caltechcaos/Lunar-Dust-Challenge/Current/README.txt

Electrical - Ask Kemal lmfao

Export_Files - Drawings, STEP files, animations, etc.

Mechanical - v1 (parts, assemblies, etc.), v2, etc.

Simulations - Simulation data

Feel free to add other folders, but please update README.txt!
