caltechcaos/Lunar-Dust-Challenge/Current/Mechanical/README.txt

All parts and assemblies should be put into "Parts" and "Other_Assemblies" respectively EXCEPT the final assembly and constants.

Current panel assembly: GME

Current endcaps: N/A

-Hey nathan love the organization
