caltechcaos/Lunar-Dust-Challenge/E100/Week 2 Progress Report/E100 Progress Report (Luis and Nathan).pptx

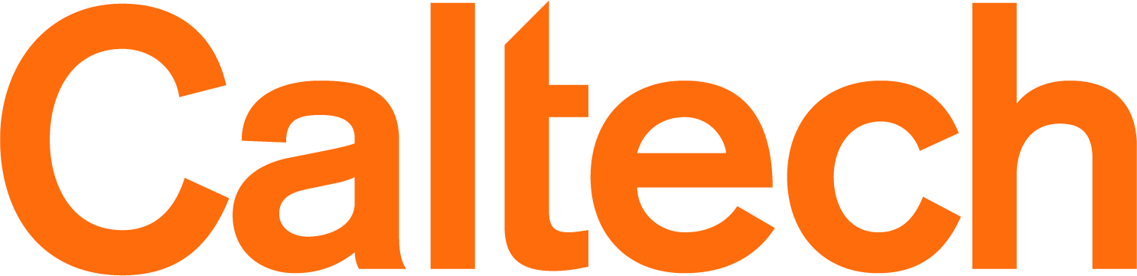
[picture p4: figure]
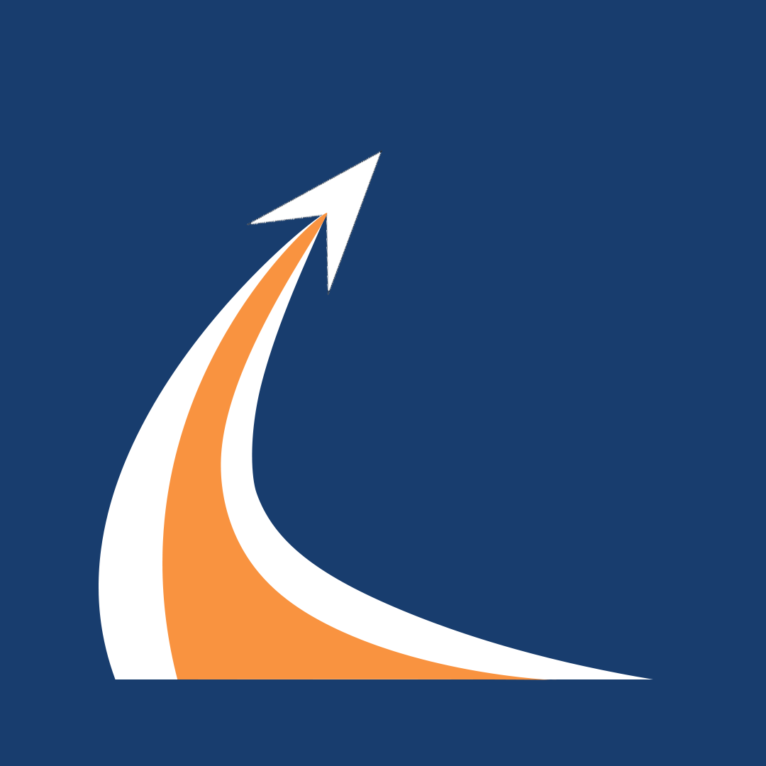
[picture p5: figure]
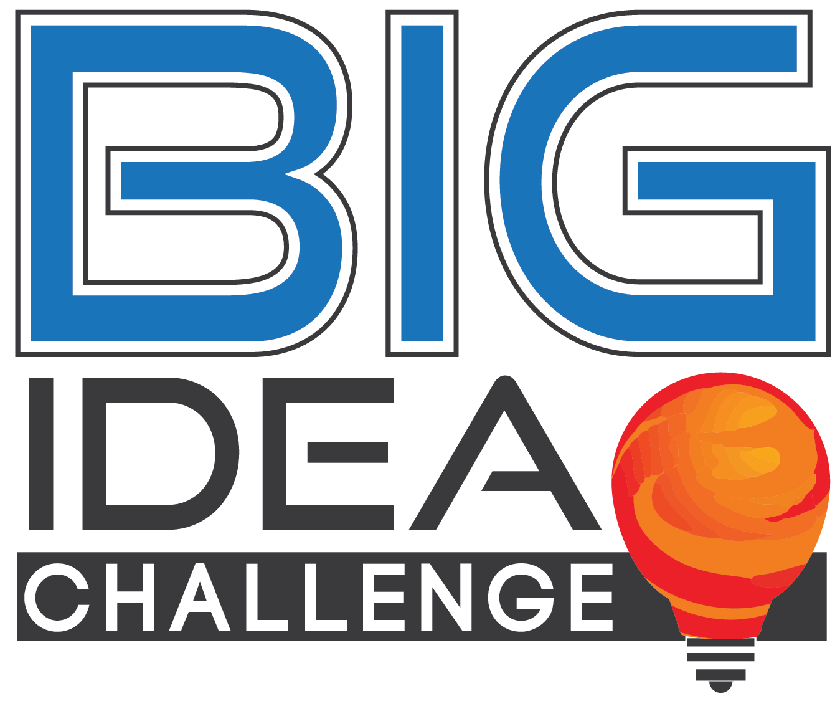
[picture p6: figure]
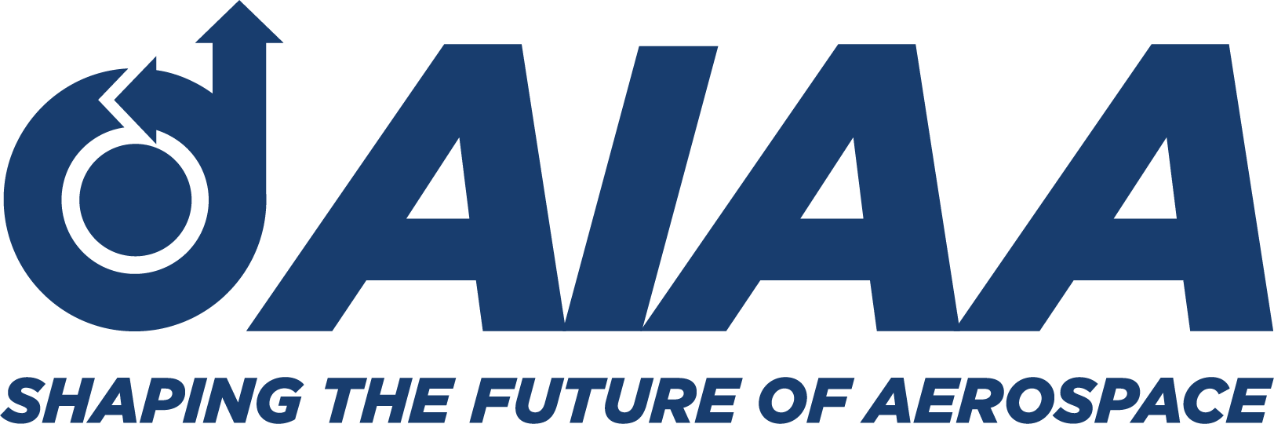
[picture p7: figure]

Validation
Schedule (Structural)

4/9/21
Nathan, Luis

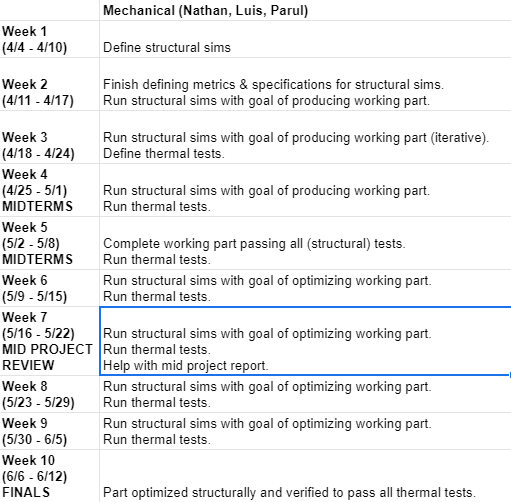
[picture p8: figure]

Budget = $0
Need – confirmation of which materials (and thicknesses) will be possible to manufacture (Mechanical Team)
Need – maximum thicknesses for the top plate, possibility of adding metal plate under bottom panel (Electrical Team)

## Slide 2

Validation
Structural Tests/Sims

4/9/21
Luis, Nathan

Planned structural tests
- Whole Panel Tests
  - Three-point bend
  - Cantilever
- Multiple Panel Tests
  - Dual Panel Three-point bend
  - Dual Panel Cantilever
- Finger Joint Tests (sanity check)
Link (https://docs.google.com/spreadsheets/d/1EzRzmbQOUqOviGvNJL2uNWe0L3cBfECJI9uSIhsKcGc/edit)
Loads (shown in red) are 486 N total
Fixed points shown in green

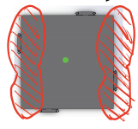
[picture p9: figure]
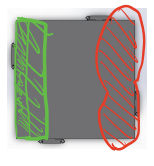
[picture p10: figure]
