caltechcaos/Lunar-Dust-Challenge/E100/Week 2 Progress Report/E100 Progress Report_Leah.pptx

MECHANICAL
Bottom Plate Manufacturing and Drawings

4/9/21
Leah Soldner

Technical Progress:
  - Reached out and got quotes for the bottom plate design
  - Scheduled meetings with several Macor manufacturers
  - Main issue with design is the 1mm thickness of the bottom lip on the plate
    - Have to increase the thickness to at least 3mm
    - The weight of the panel will increase by ~350 grams
    - Will not affect the price of manufacturing
  - Top sheet issue:
    - 1mm too thin, will warp or crack during shipping
    - Tape casting as possible solution
      - Mateus makes 4.5x4.5 in plates of desired thickness
  - Action Items:
    - Set up meeting with Ceramic Products
    - Communicate with Mateus to see if we can increase the tape casting size
    - Update drawings with correct bottom plate thickness
    - Choose manufacturer and start ordering!!!

## Slide 2

MECHANICAL
Bottom Plate Manufacturing and Drawings

4/9/21
Leah Soldner

Budget/Timeline:
  - Precision Ceramics: Mateus Truon, meeting Thursday (4/8)
    - 1 plate: $1756.20
    - 8 plates: $ 1080.50
    - Delivery time: 5-7 weeks
  - Morgan Advanced Materials: Nikhil Jani, meeting Wednesday (4/7)
    - 1 plate: $2220.22
    - 8 plates: $1843.03
    - Delivery time: 8 weeks
  - Ceramic Products: Mark Vidaic, meeting next week TBD
    - 1 plate: $1450
    - 8 plates: $1100
    - Delivery Time: 4-5 weeks
  - If we go with cheapest, estimated budget/timeline: $9,500/5 weeks
  - If we go with most expensive, estimated budget/timeline: $15,000/8 weeks
