caltechcaos/Lunar-Dust-Challenge/E100/Week 3 Progress Report/Calle Week 3 E100 Slides.pptx

Verification
Glove Box

Calle
4/16/21

Progress
- Finalized design and parts list
  - Primarily making use of extrusion and panel gaskets
- CAD model of design
- Ordered parts

Next Steps:
- Get in contact with person to order nitrogen
- Begin assembly once parts arrive

Big Idea | NASA's Breakthrough, Innovative, and Game-changing (BIG) Idea Challenge
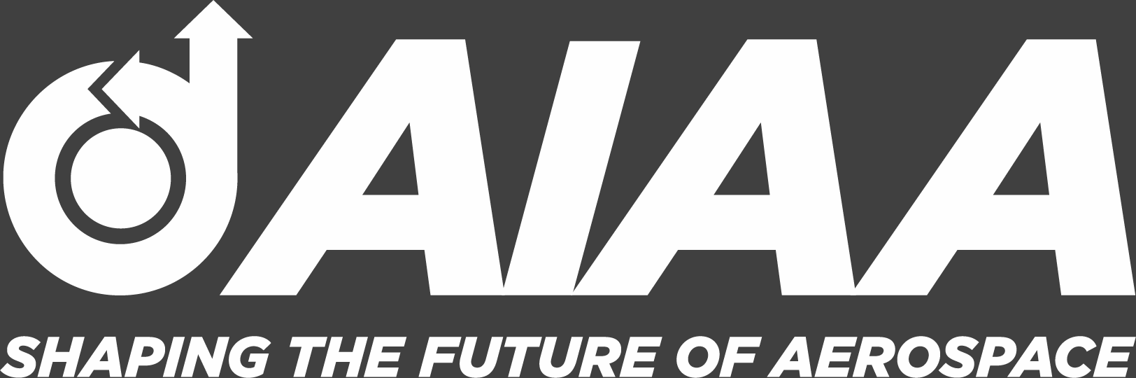
[picture p23: figure]
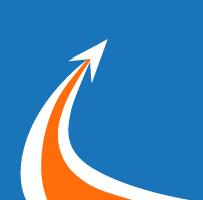
[picture p24: figure]
