caltechcaos/Lunar-Dust-Challenge/E100/Week 3 Progress Report/chelakkat_4-16-21.pptx

MECHANICAL
Electronic Box Cable Design

Kristine Chelakkat
04/16/21

- Meeting with Rich:
  - Parasitic capacitance from cable, ~10 pF/ft
  - Kapton great for high voltage
  - Cable needs to be shielded
  - Reccommends Accuglass
    - R6 Cabling with SHV connector
- Meeting with Keith Novak:
  - Flex cabling
    - Can look back at Cicoil and Gore options
- To Do: Meeting up with Electrical Team to discuss further steps
  - Should get started on testing as soon as possible

Big Idea | NASA's Breakthrough, Innovative, and Game-changing (BIG) Idea Challenge
