caltechcaos/Lunar-Dust-Challenge/E100/Week 3 Progress Report/Kemal E100 Week 3.pptx

Technical Updates
- Relays for the first prototype, due to difficulty in designing solid-state switching circuit
- Ordered components


Electrical
Power Supply and Switching

04/09/21
Kemal Pulungan

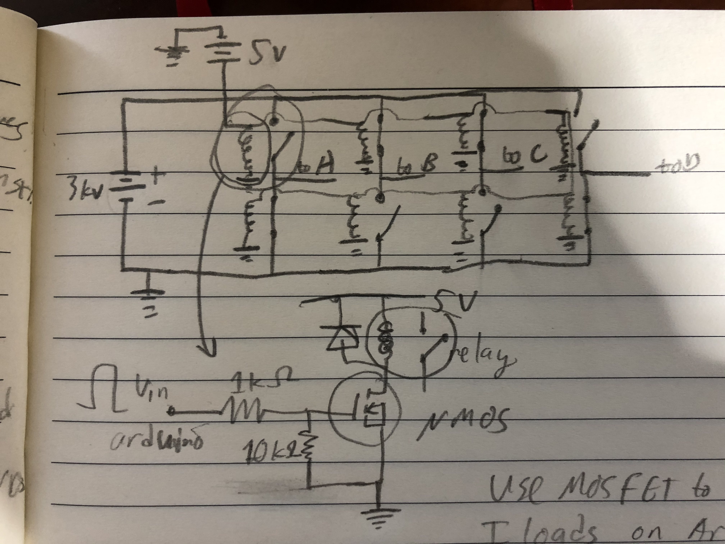
[picture p25: figure]

## Slide 2

Next Steps
- 4-16 to 4-23: Design PCB and protections against the risks of high voltage
- 4-23 to 4-30: Overseeing construction of the first board (will not be in-person)
- Afterwards up to mid-May: Testing of electronics

Electrical
Power Supply and Switching

04/09/21
Kemal Pulungan
