caltechcaos/Lunar-Dust-Challenge/E100/Week 3 Progress Report/Luis_Nathan_Simulation.pptx

Validation
Structural Simulation

Ran Full Assembly Compression Simulation
Fixed bottom (flat surface)
486 N Centered Circular Load
Dimensions: 15 x 15 cm
Top Plate: Zirconia
Bottom Plate: Macor
Elements ~ 13655
Nodes ~ 26673
Missing Constants on Data Sheets

Luis, Nathan
4/16/21

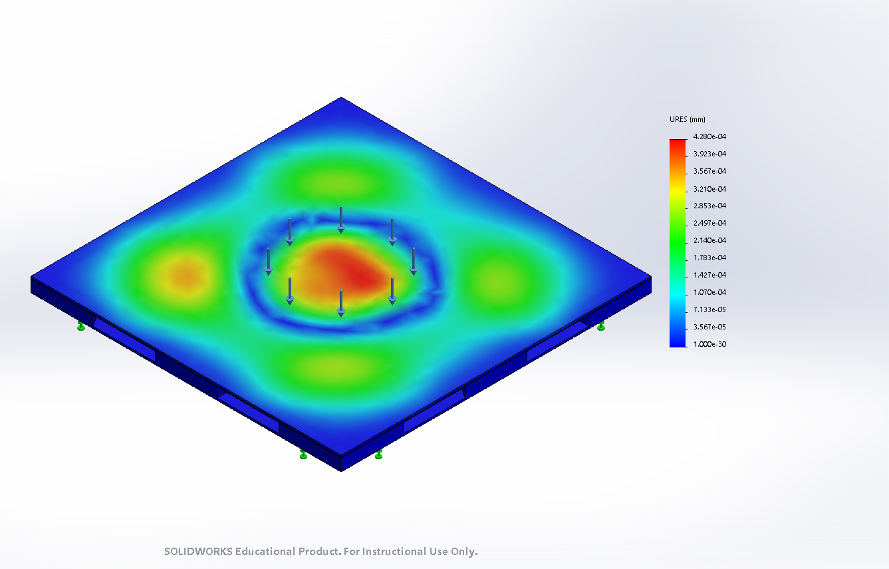
[picture p26: figure]

Displacement
Max – 4e-4 mm

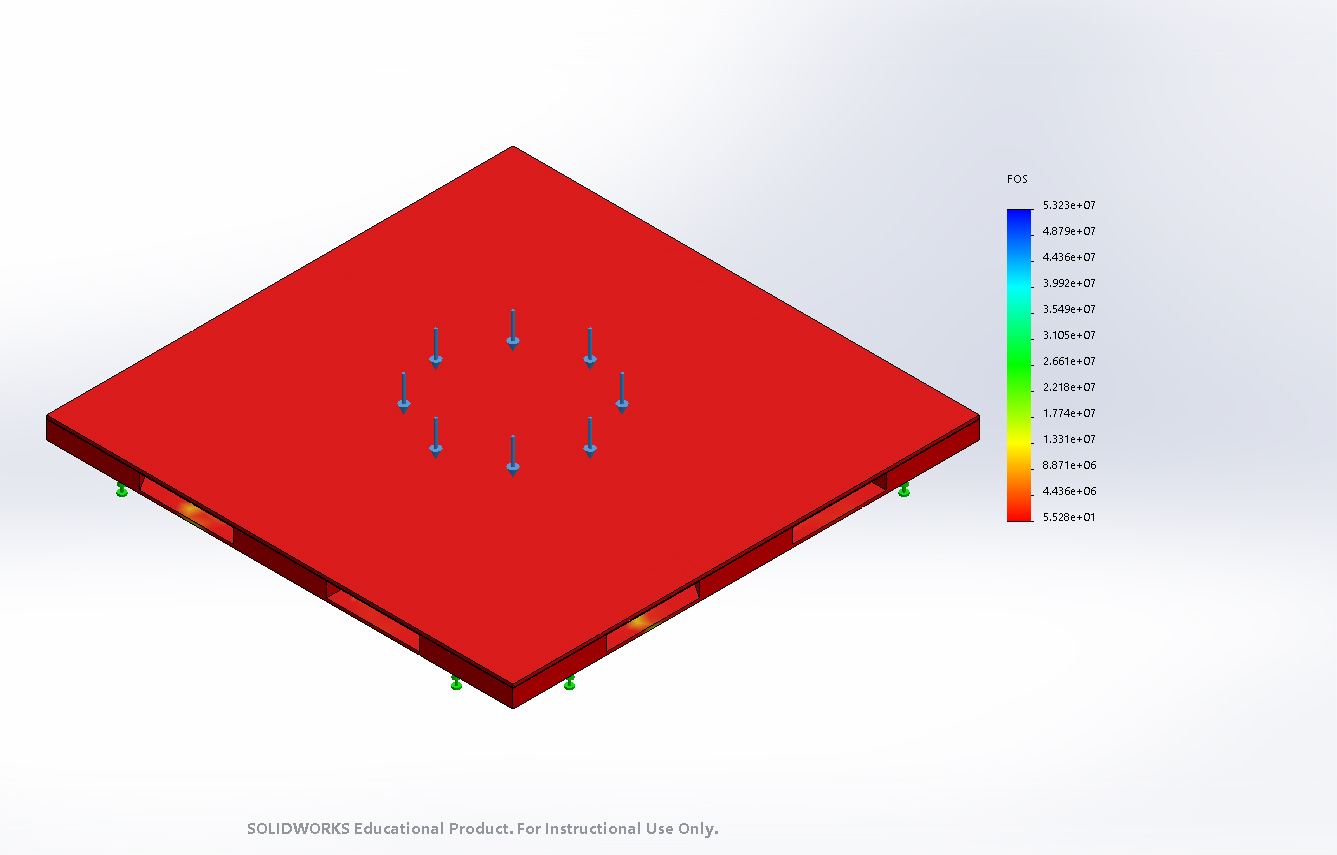
[picture p27: figure]

Factor of Safety
Min - 55

Big Idea | NASA's Breakthrough, Innovative, and Game-changing (BIG) Idea Challenge

## Slide 2

Validation
Structural Simulation

Ran Full Assembly “3-point bend” Simulation
Fixed 10% of panel on opposite sides (flat surface)
486 N Centered Circular Load
Dimensions: 15 x 15 cm
Top Plate: Zirconia
Bottom Plate: Macor
Elements ~ 43100
Nodes ~ 83089
Missing Constants on Data Sheets

Luis, Nathan
4/16/21

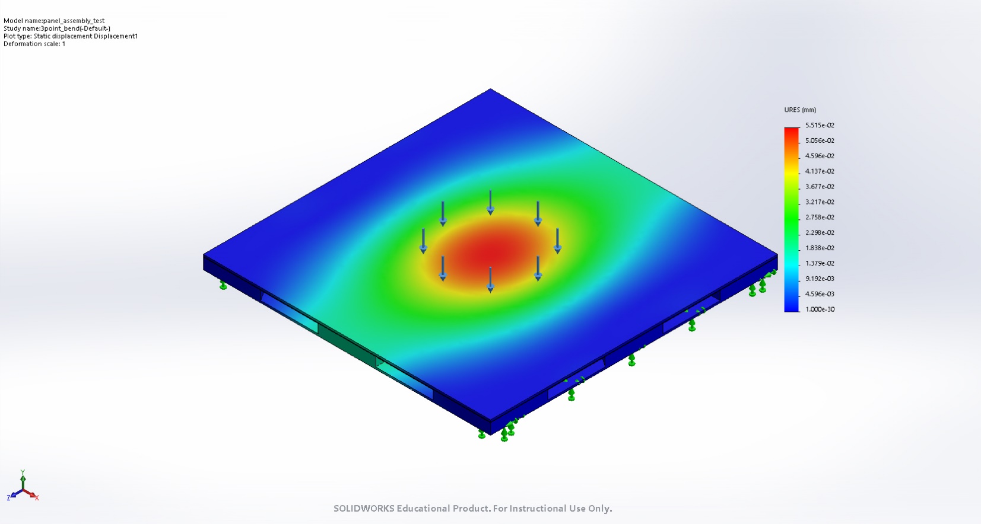
[picture p28: figure]

Displacement
Max – 5.52e-2 mm

Factor of Safety
Min – 2.79
