caltechcaos/Lunar-Dust-Challenge/E100/Week 3 Progress Report/Rithvik E 100 Week 3 Progress.pptx

VERIFICATION
EFFECTIVENESS TESTING

Rithvik
04/16/21

This Week
- Decided not to use an extrusion frame to mount camera and lights
- Finalized which camera and lighting to use
- Emailed an extrusion manufacturer about discounts for student teams

Next Week
- Will start writing code to analyze data and test it with basic videos of monochrome gradients

Big Idea | NASA's Breakthrough, Innovative, and Game-changing (BIG) Idea Challenge
