caltechcaos/Lunar-Dust-Challenge/E100/Week 3 Progress Report/Tanmay wk3.pptx

[Design/Manufacturing]
[Panel Segmentation Designs]

[Tanmay Gupta]
04/16/21

Alternative to Smaller Panels: Segmentation
- Best of both worlds from Leah’s slides
- make use of available materials while increasing integrity and minimizing changes
- Solution: split current panels into segments with their own PCB and top plate
- shared bottom plate and power supply architecture (extra depth helps)
- Panels remain rotationally symmetric and of similar size
- inter-segment gap smaller than inter-panel gap
Potential Designs
Total side dimensions can be approx. 25 x 25 cm to 30 x 30 cm

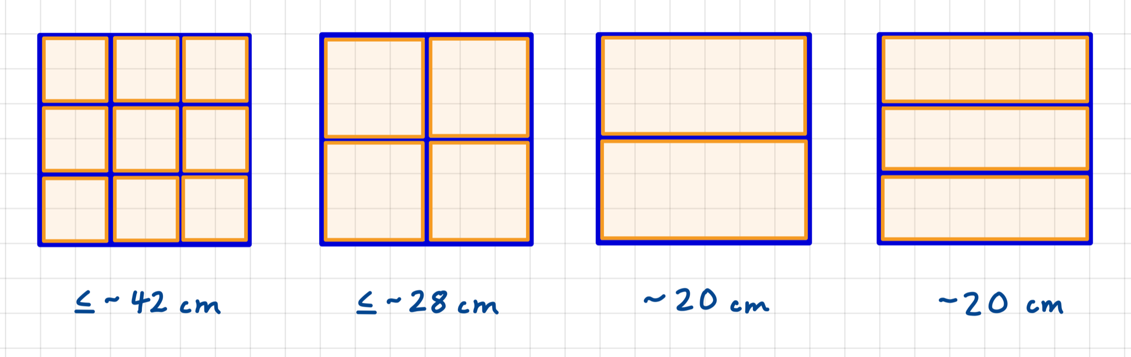
[picture p38: figure]

Big Idea | NASA's Breakthrough, Innovative, and Game-changing (BIG) Idea Challenge
