caltechcaos/Lunar-Dust-Challenge/PDR/PDR Presentation/PDR-ME-OVERVIEW-UPDATE.pptx

## Slide 2


PANEL COMPOSITION
MECHANICAL

AIAA Caltech Student Branch – 18/11/20
Preliminary Design Review – E.A.S.E

Alumina Ceramic Sheet

0.3175 cm

Kapton film

Electrodes

0.005 cm

0.65 cm

Alumina Ceramic Sheet

Kapton film

0.005 cm

0.3175 cm

0.77 cm

iPhone X

0.65 cm

EDS Panel

Mass estimate: 1.4 kg

## Slide 3

MATERIAL SELECTION
MECHANICAL

AIAA Caltech Student Branch – 18/11/20
Preliminary Design Review – E.A.S.E

Alumina | Kapton
Electrical insulator | Stability across wide temperature range
Low dielectric constant | Durability
Low thermal conductivity | Good dielectric qualities
Hardness | Used in spacecraft applications (Apollo launcher, Curiosity rover)
Strength
Sufficient temperature range
Abrasion resistant
Used in many spacecraft applications

## Slide 4

Top Plate:
- 3-axis CNC milling
Bottom Plate:
- 3-axis CNC milling
Electronics Box:
- Tungsten inert gas welding
- 3-axis CNC milling
- Design considerations: 0.5 mm tolerance, large external and internal fillets

MANUFACTURING
MECHANICAL

AIAA Caltech Student Branch – 18/11/20
Preliminary Design Review – H.O.M.E.S.

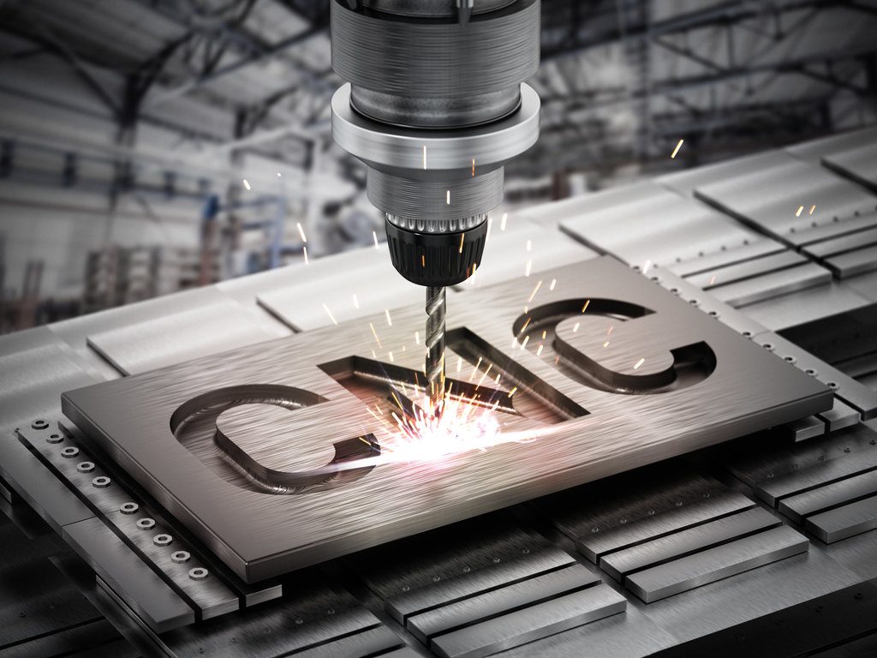
[picture p46: figure]
What Is CNC Machining? And Is It Right for You?
