caltechcaos/Lunar-Dust-Challenge/Current/Mechanical/v3_tiz/FEA/FEA_finger_joint_v3.2-Static 1-1.docx

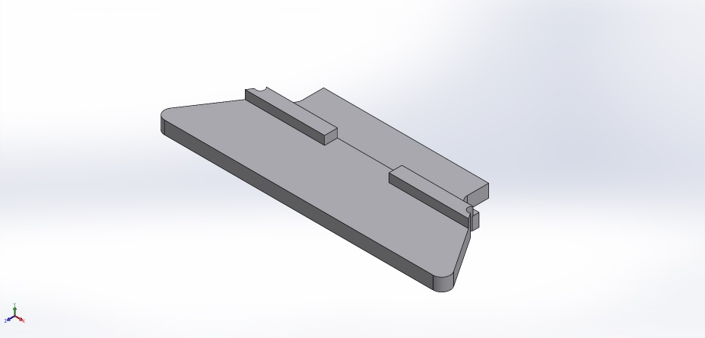
[picture p47: figure]

Simulation of FEA_finger_joint_v3.2

Date: Thursday, April 1, 2021
Designer: Solidworks

Study name: Static 1

Analysis type: Static
Description No Data

# Assumptions

# Model Information

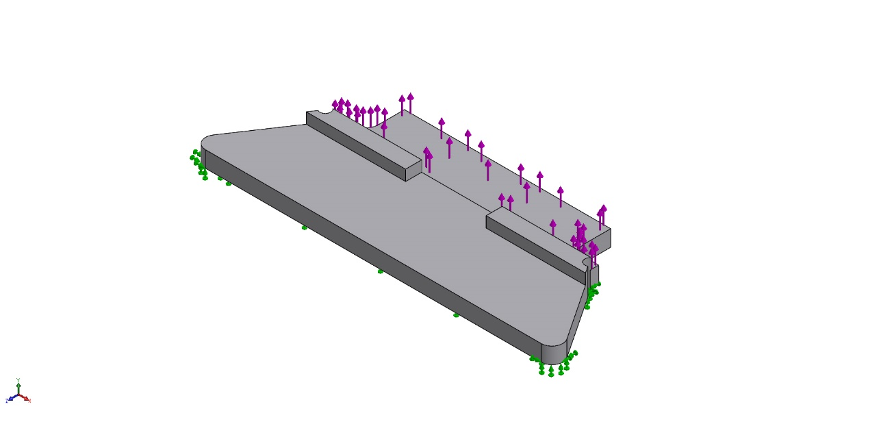
[picture p48: figure]

Model name: FEA_finger_joint_v3.2

Current Configuration: Default

Solid Bodies
Document Name and Reference | Treated As | Volumetric Properties | Document Path/Date Modified

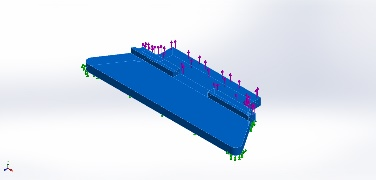
[picture p49: figure]

Split Line2 | Solid Body | Mass:0.0085645 kg Volume:4.12549e-06 m^3 Density:2,075.99 kg/m^3 Weight:0.0839321 N | C:\Users\luisa\Documents\GrabCAD\Lunar Dust Challenge\Current\Mechanical\v3_tiz\FEA\FEA_finger_joint_v3.2.SLDPRT Apr 1 22:46:40 2021

# Study Properties

Study name | Static 1
Analysis type | Static
Mesh type | Solid Mesh
Thermal Effect: | On
Thermal option | Include temperature loads
Zero strain temperature | 298 Kelvin
Include fluid pressure effects from SOLIDWORKS Flow Simulation | Off
Solver type | FFEPlus
Inplane Effect: | Off
Soft Spring: | Off
Inertial Relief: | Off
Incompatible bonding options | Automatic
Large displacement | Off
Compute free body forces | On
Friction | Off
Use Adaptive Method: | Off
Result folder | SOLIDWORKS document (C:\Users\luisa\Documents\GrabCAD\Lunar Dust Challenge\Current\Mechanical\v3_tiz\FEA)

# Units

Unit system: | SI (MKS)
Length/Displacement | mm
Temperature | Kelvin
Angular velocity | Rad/sec
Pressure/Stress | N/m^2

# Material Properties

Model Reference | Properties | Components

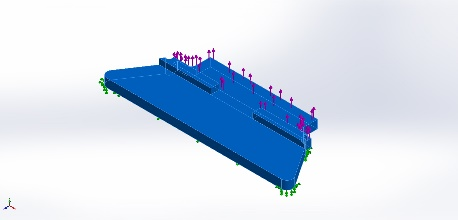
[picture p50: figure]

| Name: 99.5% Aluminum Oxide Model type: Linear Elastic Isotropic Default failure criterion: Mohr-Coulomb Stress Yield strength: 2.17185e+07 N/m^2 Tensile strength: 2.17185e+07 N/m^2 Compressive strength: 2.99922e+07 N/m^2 Elastic modulus: 3e+11 N/m^2 Poisson's ratio: 0.22 Mass density: 2,075.99 kg/m^3 Thermal expansion coefficient: 8e-06 /Kelvin | SolidBody 1(Split Line2)(FEA_finger_joint_v3.2)

Curve Data:N/A

# Loads and Fixtures

Fixture name | Fixture Image | Fixture Details

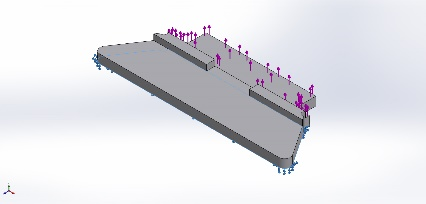
[picture p51: figure]

Fixed-1 | | Entities: 1 face(s) Type: Fixed Geometry

Resultant Forces

Components | X | Y | Z | Resultant
Reaction force(N) | -0.000433497 | -119.998 | -0.0014181 | 119.998
Reaction Moment(N.m) | 0 | 0 | 0 | 0

Load name | Load Image | Load Details

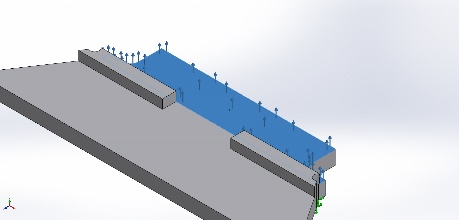
[picture p52: figure]

Force-1 | | Entities: 1 face(s) Type: Apply normal force Value: -120 N

# Connector Definitions

No Data

# Contact Information

No Data

# Mesh information

Mesh type | Solid Mesh
Mesher Used: | Standard mesh
Automatic Transition: | Off
Include Mesh Auto Loops: | Off
Jacobian points | 4 Points
Element Size | 0.802247 mm
Tolerance | 0.0401124 mm
Mesh Quality Plot | High

## Mesh information - Details

Total Nodes | 83132
Total Elements | 54412
Maximum Aspect Ratio | 13.498
% of elements with Aspect Ratio < 3 | 99.8
% of elements with Aspect Ratio > 10 | 0.00919
% of distorted elements(Jacobian) | 0
Time to complete mesh(hh;mm;ss): | 00:00:03
Computer name:

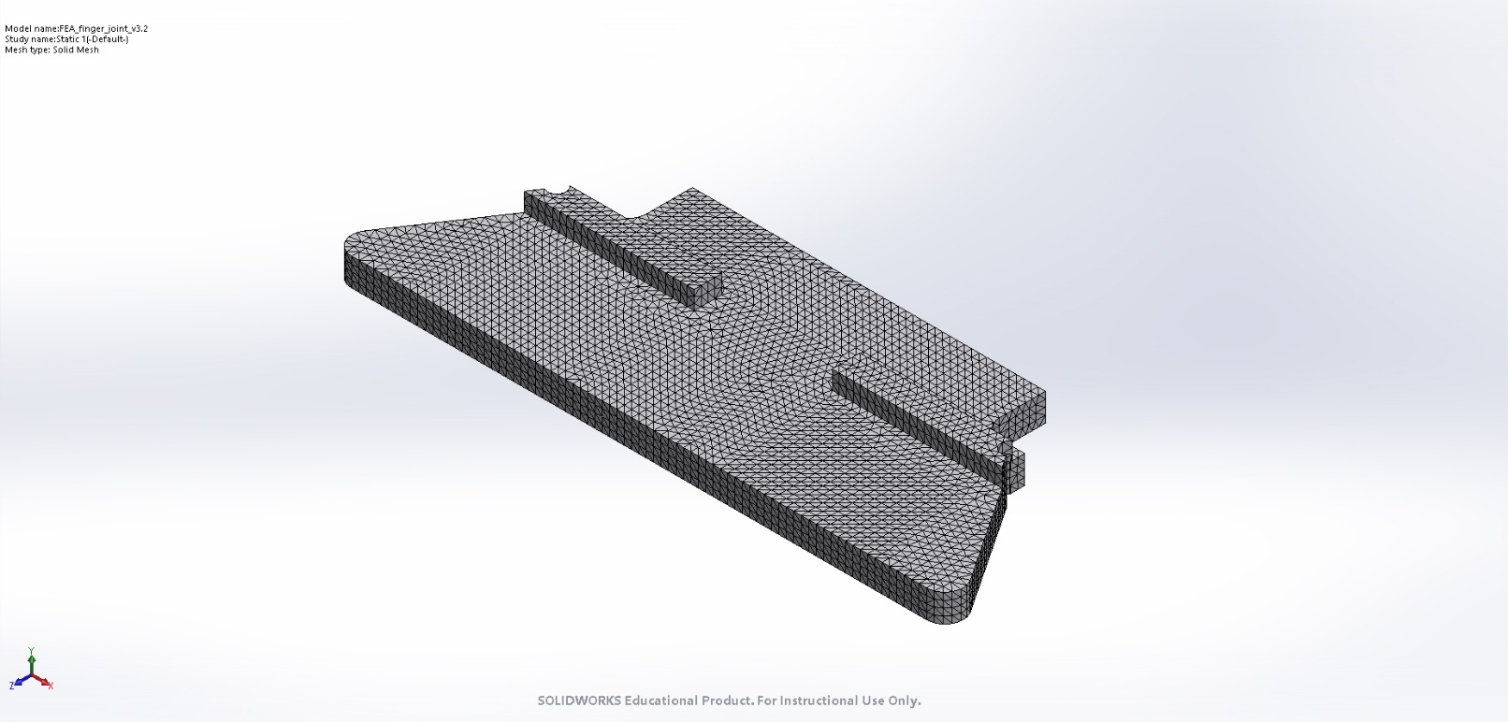
[picture p53: figure]

# Sensor Details

No Data

# Resultant Forces

## Reaction forces

Selection set | Units | Sum X | Sum Y | Sum Z | Resultant
Entire Model | N | -0.000433497 | -119.998 | -0.0014181 | 119.998

## Reaction Moments

Selection set | Units | Sum X | Sum Y | Sum Z | Resultant
Entire Model | N.m | 0 | 0 | 0 | 0

# Beams

No Data

# Study Results

Name | Type | Min | Max
Stress1 | VON: von Mises Stress | 8.040e+01 N/m^2 Node: 70215 | 1.301e+07 N/m^2 Node: 81540

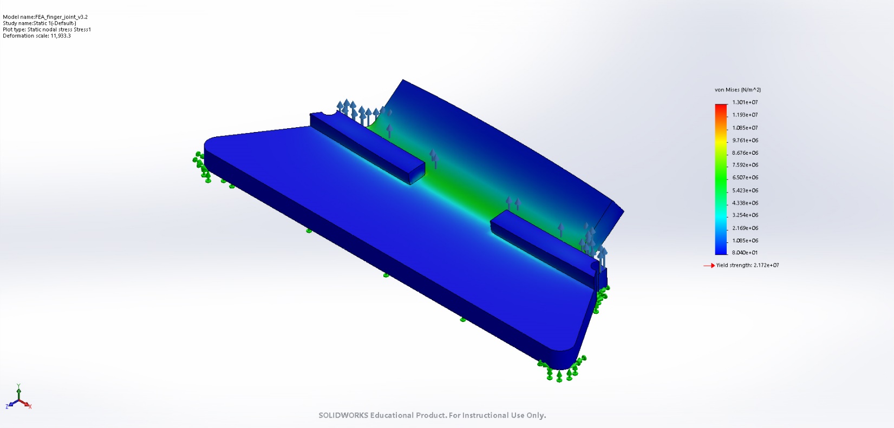
[picture p54: figure]

FEA_finger_joint_v3.2-Static 1-Stress-Stress1

Name | Type | Min | Max
Displacement1 | URES: Resultant Displacement | 0.000e+00 mm Node: 1 | 5.728e-04 mm Node: 3165

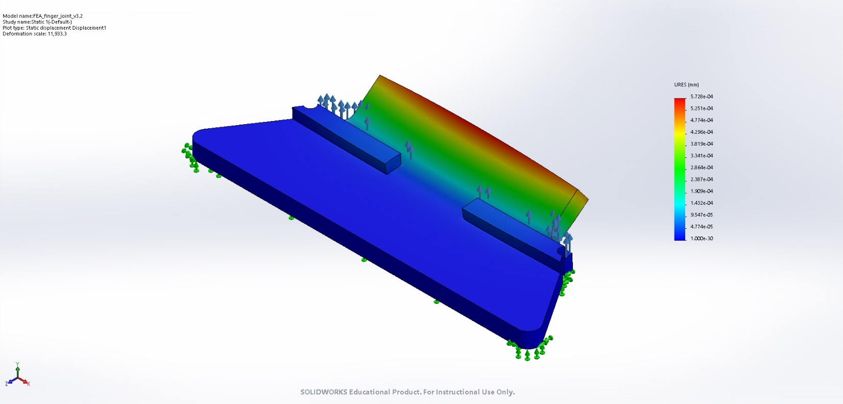
[picture p55: figure]

FEA_finger_joint_v3.2-Static 1-Displacement-Displacement1

Name | Type | Min | Max
Strain1 | ESTRN: Equivalent Strain | 8.533e-11 Element: 7062 | 3.040e-05 Element: 32892

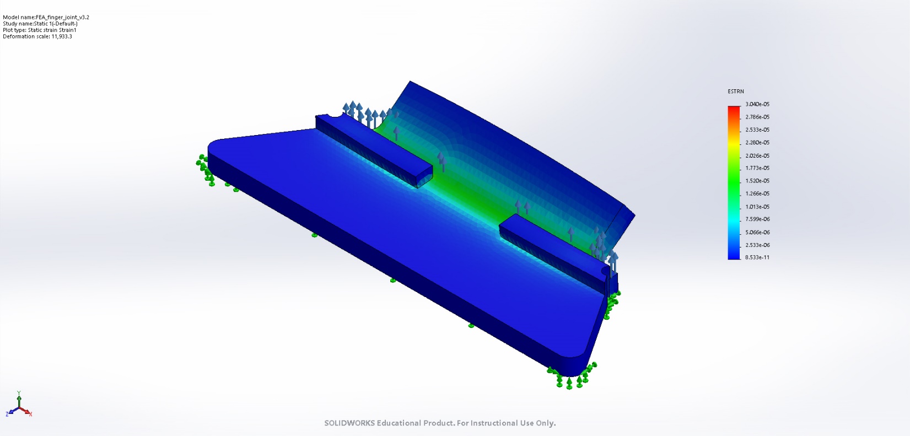
[picture p56: figure]

FEA_finger_joint_v3.2-Static 1-Strain-Strain1

Name | Type
Displacement1{1} | Deformed shape

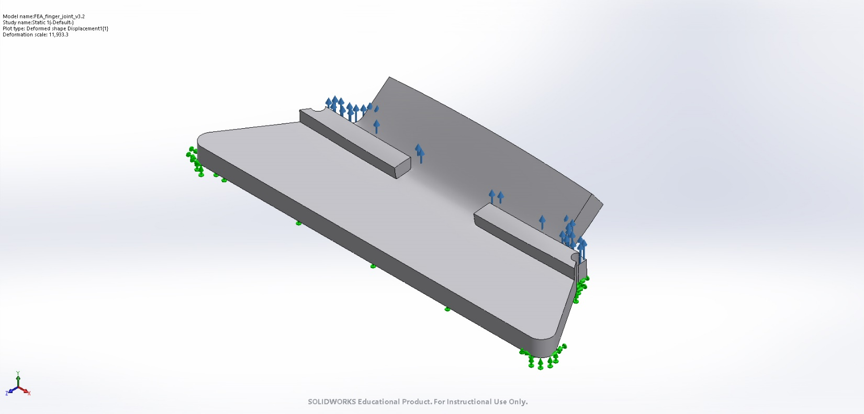
[picture p57: figure]

FEA_finger_joint_v3.2-Static 1-Displacement-Displacement1{1}

Name | Type | Min | Max
Factor of Safety1 | Mohr-Coulomb Stress | 1.259e+00 Node: 81540 | 2.330e+05 Node: 70206

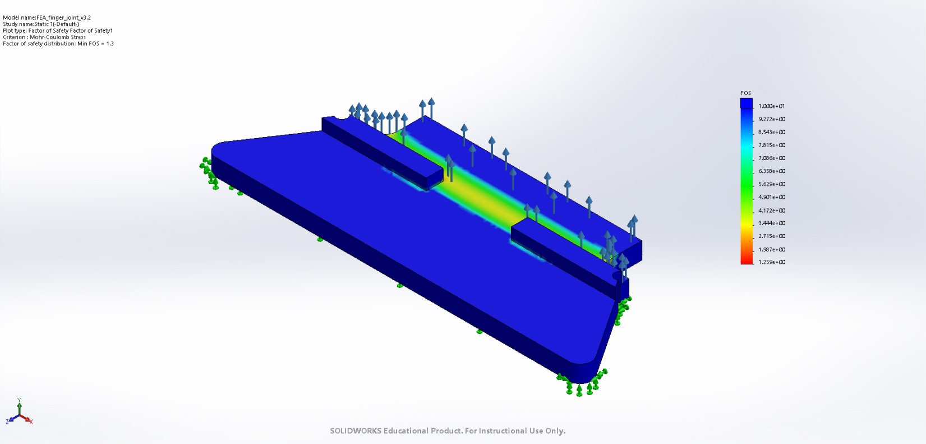
[picture p58: figure]

FEA_finger_joint_v3.2-Static 1-Factor of Safety-Factor of Safety1

Name | Type
Design Insight1 | Design Insight

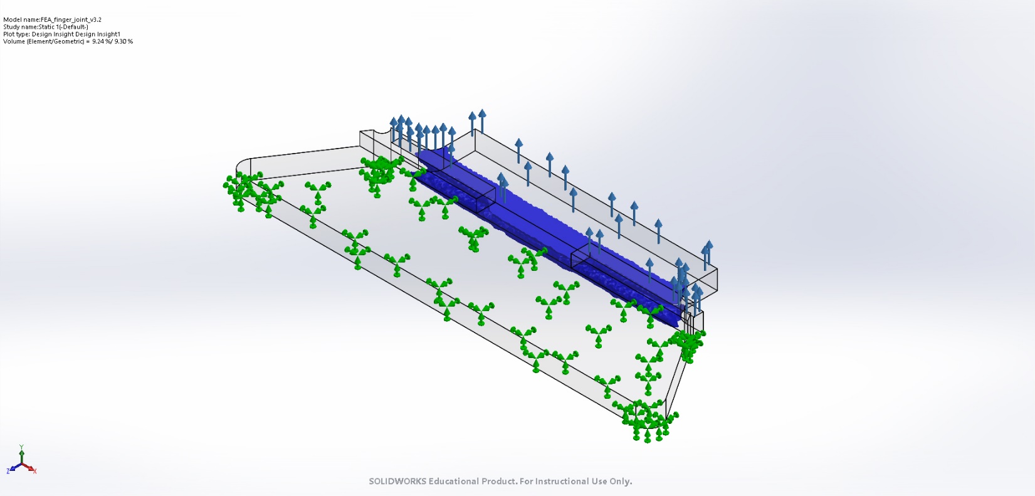
[picture p59: figure]

FEA_finger_joint_v3.2-Static 1-Design Insight-Design Insight1

# Conclusion

Analyzed with SOLIDWORKS Simulation Simulation of FEA_finger_joint_v3.2 7

Analyzed with SOLIDWORKS Simulation Simulation of FEA_finger_joint_v3.2 1
