caltechcaos/Lunar-Dust-Challenge/PDR/PDR Presentation/controlsmodesnew.pptx

MECHATRONICS
CONTROLS & MODES

AIAA Caltech Student Branch – 11/18/20
Preliminary Design Review – E.A.S.E.

Standby Mode

Strain Gauge

Feasible by prior implementations

Strain Gauge

Large decrease in pressure

Timer
(120 secs)

Maintenance Mode

Astronaut Mode

Operational Modes
Standby Mode: awaiting use, sensors are active
Astronaut Mode: capacitors are charged, suit is cleaned
Maintenance Mode: dust is removed from mat itself

If large increase in pressure
