caltechcaos/Lunar-Dust-Challenge/PDR/PDR Presentation/controlsopmodes.pptx

MECHATRONICS
Controls and Operational Modes

AIAA Caltech Student Branch – 18/11/20
Preliminary Design Review – H.O.M.E.S.

Dormant Mode

Piezoelectric Sensor

Piezoelectric Sensor

If large + ΔP

Timer
(120 secs)

Cleaning Mode

Large -ΔP

Operational Modes
Dormant Mode: awaiting use, sensors are active
Cleaning Mode: capacitors are charged, suit is cleaned, dust removed from mat
