caltechcaos/Lunar-Dust-Challenge/PDR/PDR Presentation/EASE PDR FINAL V3.pdf

# EASE

# Electrodynamic Dust Shielding Activated Surface Emitter

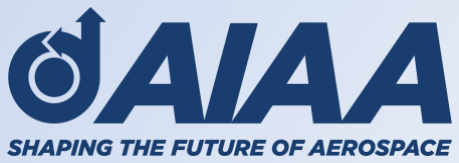
[picture p69: figure]

AIAA Caltech Student Branch – 11/18/20 Advisor: Dr. Soon-Jo Chung

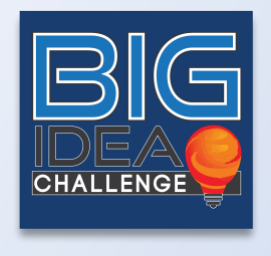
[picture p70: figure]

# Preliminary Design Review

# INTRODUCTION

# ROADMAP

EASE Preliminary Design Review

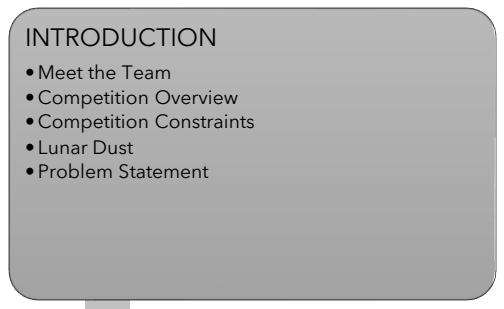
[picture p71: figure]
INTRODUCTION; • Meet the Team • Competition Overview • Competition Constraints • Lunar Dust • Problem Statement
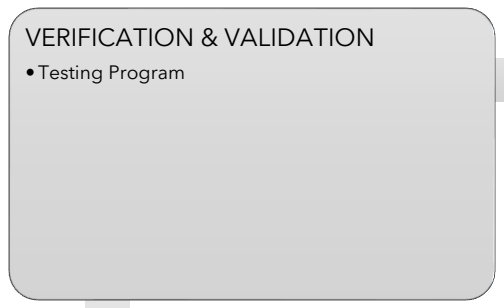
[picture p72: figure]
VERIFICATION & VALIDATION; • Testing Program
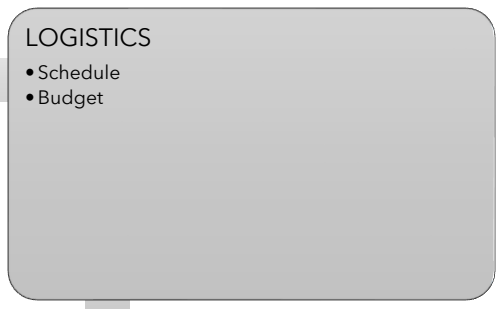
[picture p73: figure]
LOGISTICS; • Schedule •Budget
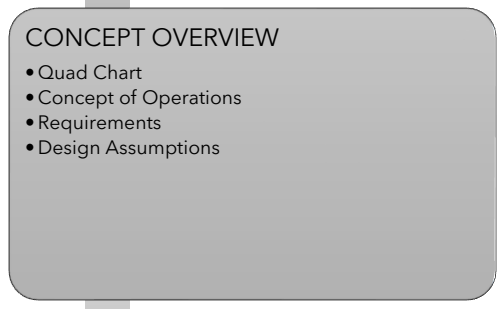
[picture p74: figure]
CONCEPT OVERVIEW; • Quad Chart • Concept of Operations • Requirements • Design Assumptions
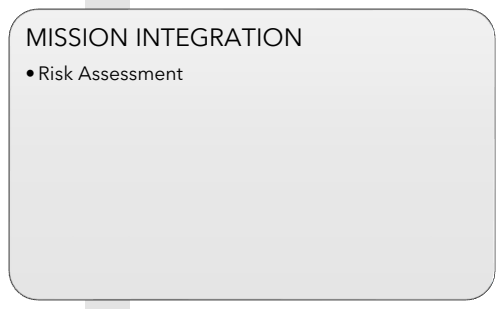
[picture p75: figure]
MISSION INTEGRATION; • Risk Assessment
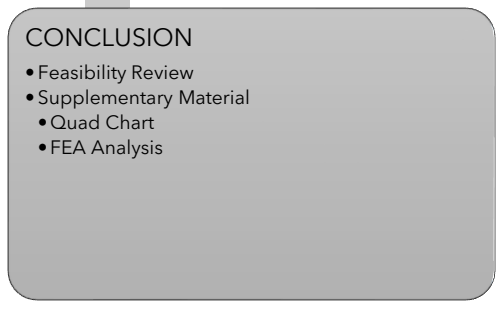
[picture p76: figure]
CONCLUSION; • Feasibility Review • Supplementary Material •Quad Chart •FEA Analysis
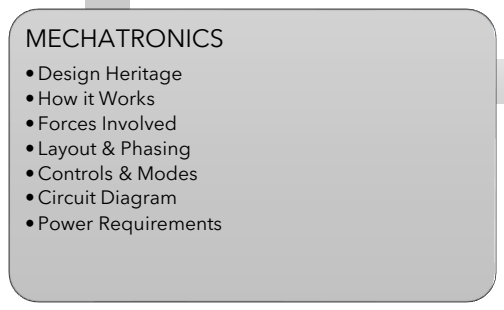
[picture p77: figure]
MECHATRONICS; • Design Heritage • How it Works • Forces Involved • Layout & Phasing • Controls & Modes • Circuit Diagram • Power Requirements
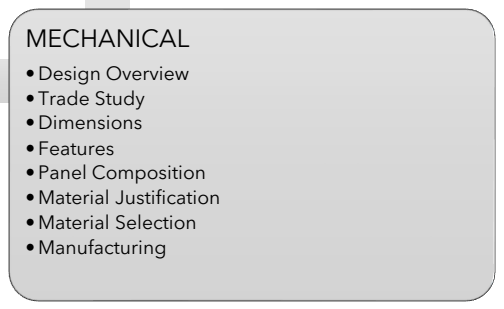
[picture p78: figure]
MECHANICAL; • Design Overview • Trade Study • Dimensions • Features • Panel Composition • Material Justification • Material Selection • Manufacturing

# INTRODUCTION

# MEET THE TEAM

# Leadership

# Branch Lead

### Luis Pabon

MCE & Aero, ’22
Houston, TX

# Project Lead

### Malcolm Tisdale

MCE & CDS, ‘22
Los Angeles, CA

# Ops. Lead

### Isabella Dula

MCE, ‘22
Los Angeles, CA

# Mechanical

# Mechatronics

# Mission Integration

Lead
Polina
Verkhovodova
MCE & Pl, ’22
Pasadena, CA

Lead
Leah Soldner
MCE & Aero ,
’24
S Pasadena, CA

Tanmay
Gupta
MCE , ’24
Ph / Astro
Kuala Lumpur,
Malaysia

Nathan Ng
MCE , ’24
Santa Clara,
CA

Lead
Calle Junker
MCE, ’23
Aztec, NM

Athena Kolli
MCE & Aero,
’24
Buffalo Grove,
IL

Kaila
Coimbra
MCE & Aero ,
’23
San Diego,
CA

Rithvik
Musuku
MCE , ’24
Gilbert, AZ

Parul Singh
MCE , ’24
Tallahasee, FL

Kemal
Pulungan
MCE , ’24
Troy, NY

Jules Penot
MCE & Aero , ’24
Valbonne, France

# Advisor

### Dr. Soon-Jo Chung

Lead
Isabella
Dula

EASE Preliminary Design Review

# INTRODUCTION

# COMPETITION OVERVIEW

# Artemis Missions – Feet on the moon by 2024 &

# sustainable missions by 2028. NASA BIG Idea Challenge Finalists implemented 2026

- University teams of 5 – 25 students
- Teams submit proposals (Dec 13th 2020) for funding to develop concepts for technical paper and BIG Idea Forum (Nov 15th 2021)
- Awards from $50,000 - $180,00

## Landing Dust Prevention &

Mitigation - to preclude

or protect from plume/surface interactions which may result in damaged landers and
nearby surface assets

## Spacesuit Dust Tolerance & Mitigation – to limit

dust adherence to spacesuits and other damaging effects to its subsystems

## Exterior Dust

Prevention,

## Tolerance, & Mitigation – to protect

lunar surface systems or
preclude dust from entering habitats and landers

## Cabin Dust Tolerance & Mitigation - to clean

habitable volumes and their interior surfaces, which helps prevent dust from making it back to Gateway and Orion
when the lander returns to lunar orbit from the surface

EASE Preliminary Design Review

# INTRODUCTION

# COMPETITION CONSTRAINTS

# Constraints

- Able to manage or mitigate lunar dust (~0.5-100 μm)
- Minimal barrier to NASA adoption
- Cost, power, mass, size …
- Minimum Technological Readiness Level 4 (->5)
- Lifespan of 15 - 30 years
- Removes dust “in minutes”
- Lunar environmental conditions
- South pole temperatures between -232C and -49C
- Permanently shadowed craters as low as -243C

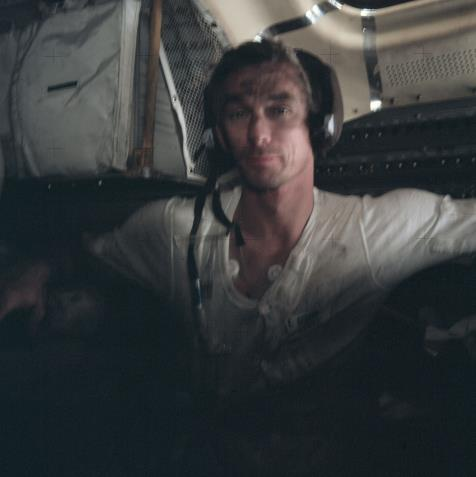
[picture p79: figure]

# Considerations

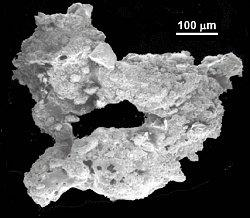
[picture p80: figure]

- Aiming for 2026 deployment in lunar missions
- Simplicity of operation and maintenance
- Deployment method from NASA or commercial surface lander
- Effective packaging for launch and Moon landing
- Credible fabrication and material selection

Lunar Dust
Particle

Gene Cernan
covered in lunar
dust

EASE Preliminary Design Review

# INTRODUCTION

# LUNAR DUST

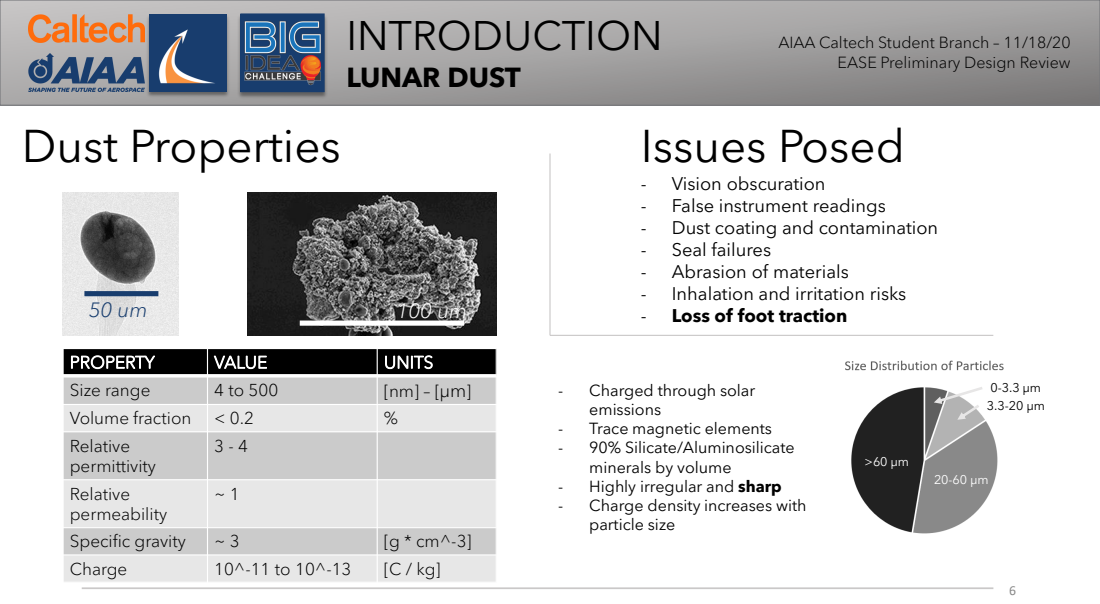
[picture p81: page 6]
Issues Posed; Dust Properties

EASE Preliminary Design Review

- Vision obscuration
- False instrument readings
- Dust coating and contamination
- Seal failures
- Abrasion of materials
- Inhalation and irritation risks
- Loss of foot traction

PROPERTY | VALUE | UNITS
Size range | 4 to 500 | [nm] – [μm]
Volume fraction | < 0.2 | %
Relative permittivity | 3 - 4

- Charged through solar
emissions
- Trace magnetic elements
- 90% Silicate/Aluminosilicate
minerals by volume
- Highly irregular and sharp
- Charge density increases with
particle size

Relative permeability | ~ 1

Specific gravity | ~ 3 | [g * cm^-3]
Charge | 10^-11 to 10^-13 | [C / kg]

# INTRODUCTION

# PROBLEM STATEMENT

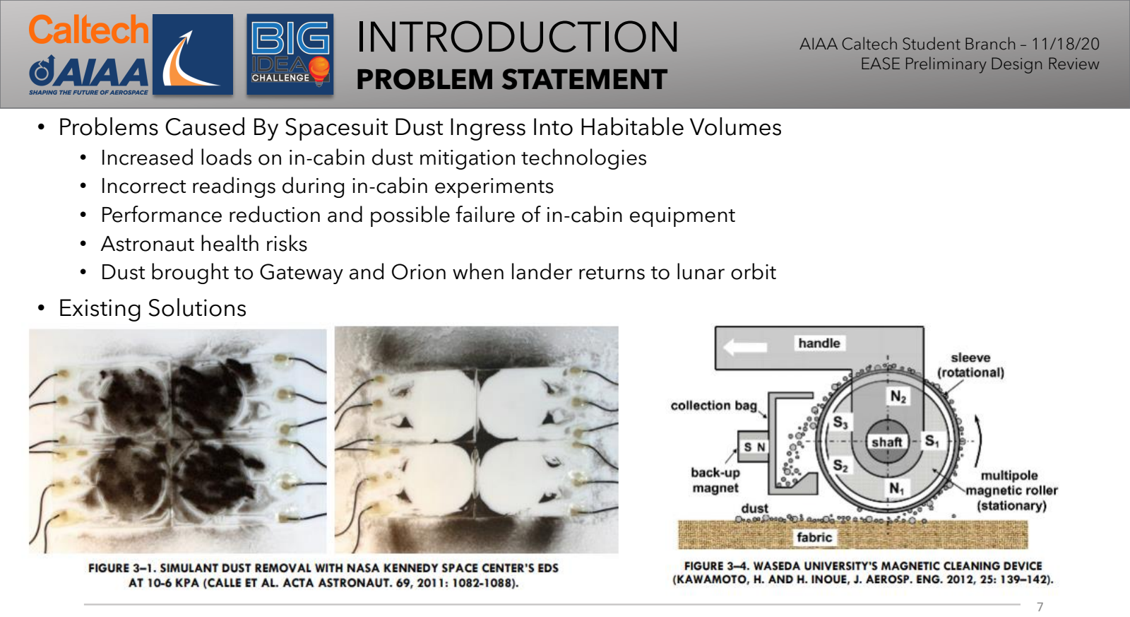
[picture p82: page 7]

EASE Preliminary Design Review

## - Problems Caused By Spacesuit Dust Ingress Into Habitable Volumes

### - Increased loads on in-cabin dust mitigation technologies - Incorrect readings during in-cabin experiments - Performance reduction and possible failure of in-cabin equipment - Astronaut health risks - Dust brought to Gateway and Orion when lander returns to lunar orbit

## - Existing Solutions

# CONCEPT OVERVIEW

# QUAD CHART

Leverages 50-year-old dust mitigation technology currently being tested on ISS
- 3-Phase traveling square wave pushes dust particles off astronaut boots and EASE
- Touch-free operation using strain gauges in the mat
- Extensive validation and verification program though

# Objective:

Approach: | Key Milestones:
- Minimize dust ingress into lunar habitat module on astronaut boots
- Increases traction of astronaut boots
- EASE is portable, durable, low SWaPs device
- Clears lunar dust from astronaut boots in < 30 sec and self cleaning
- Increases the state-of-the-art:
- Largest, most compact, and durable implementation of electrodynamic shielding technology
- Develop and validate to TRL 5

### Render of EASE

Mass Estimate: < 4 kg | Power Estimate: 50 W max
Description | TRL | Deadline
Preliminary Design Review | 2 | 11/18/20
Proposal | 2 | 12/13/20
Functional Prototype | 3 | 4/1/21
Midpoint Report | 4 | 5/20/21
Technical Paper & Verification Demonstration | 5 | 10/27/21

EASE Preliminary Design Review

### Astronaut boot placement

# CONCEPT OVERVIEW

# CONCEPT OF OPERATIONS

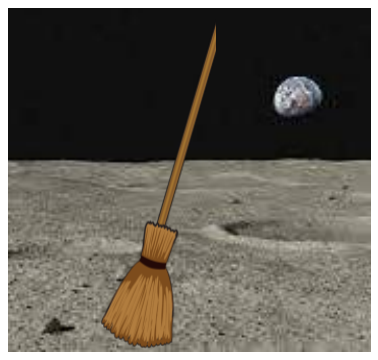
[picture p83: figure]

### Astronaut should ensure the surface is relatively flat and cleared

### Astronaut lays out E.A.S.E in front of the lunar habitat and connects it to power source

### Astronaut leaves. E.A.S.E waits for another astronaut for two minutes, after which it self-cleans for several minutes, removing the dust from its surface by pushing it off its right edge, before entering standby mode until the

pressure sensor is activated again.

1

2

3

4

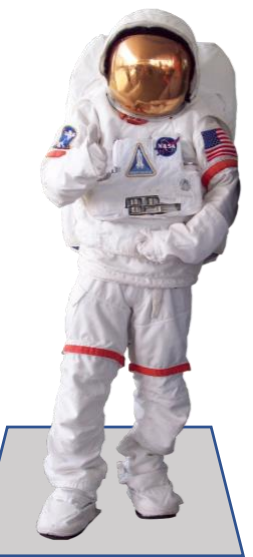
[picture p84: figure]

After moonwalk and sample collection, astronaut returns to stand on E.A.S.E, which senses the weight and begins attracting dust off the astronauts’ boots and moving it to the center and the left and right edges

EASE Preliminary Design Review

DA 1.0

### DA 5.0, FR 1.0

DA 2.0

FR 2.0, 4.0, 5.0

# CONCEPT OVERVIEW

# REQUIREMENTS

EASE Preliminary Design Review

Functional Requirements | Description
FR 1.0 | Remove at least 50% of dust from astronaut boots within 30 seconds
FR 2.0 | Self-cleaning after astronaut departure
FR 3.0 | Minimum 15-year lifetime on lunar surface
FR 4.0 | Capable of enduring forces involved in launch and landing
FR 5.0 | Capable of withstanding 400N load applied to surface
FR 6.0 | Capable of enduring repeated impacts without loss in performance

# CONCEPT OVERVIEW

# DESIGN ASSUMPTIONS

Design Assumption | Description
DA 1.0 | EASE placed on 1 m x 1 m cleared and leveled area
DA 2.0 | 28 V DC power supplied by lunar habitats and landers
DA 3.0 | Lunar regolith compresses under load of mat and astronaut
DA 4.0 | Disregard off nominal solar activity
DA 5.0 | No more than one astronaut at a time maximum load

EASE Preliminary Design Review

# EDS OVERVIEW

# DESIGN HERITAGE

- Parent technology developed in 1970s - Lifts and transports charged and uncharged particles using electrostatic and dielectrophoretic forces - Works best for particle size regimes of 5-300 µm (encompasses size regime for lunar dust particles) - Technology currently being used in: - Solar panel maintenance (dust removal efficiency

of 90%)

## - Tested in mock lunar environments - In-Situ Experiments on ISS on thermal radiators and solar panels - Ongoing; showed that EDS works in vacuum - Solar panel effectiveness 22.5%→98.4% after EDS implementation with lunar simulant

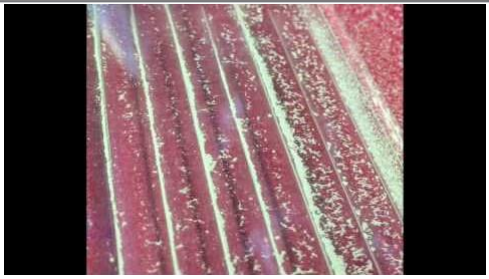
[picture p85: figure]

Demonstration of EDS on a glass plate; particle size < 20 µm; time to clear ~30s (Guo, 2018)

# Electrodynamic Dust Shielding

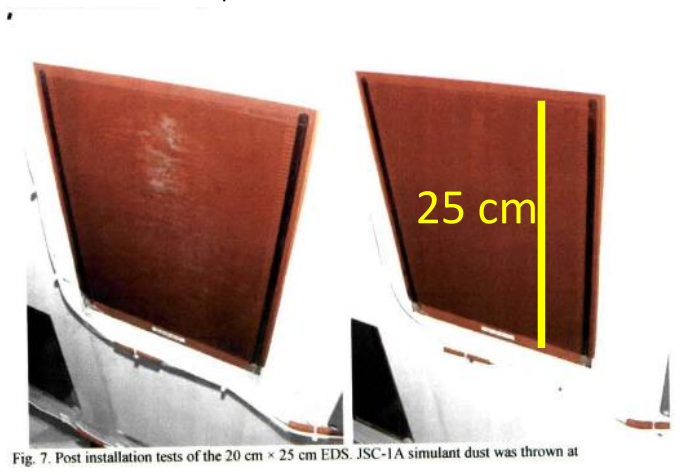
[picture p86: figure]

EDS
System
mounted
on sim.
Lunar
habitat
FR 1.0

EASE Preliminary Design Review

# EDS OVERVIEW

# HOW IT WORKS

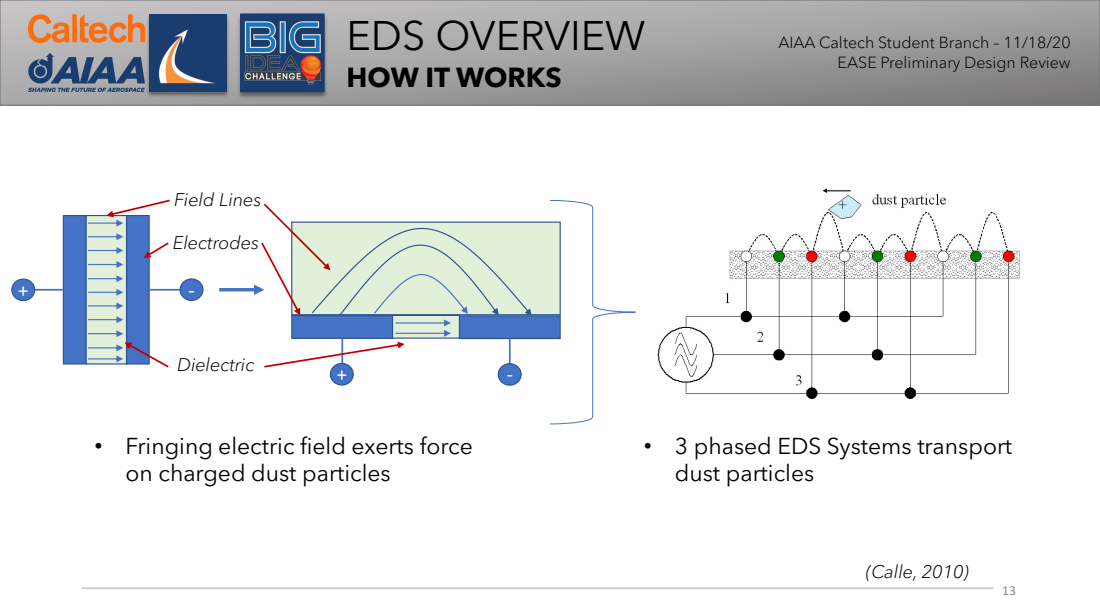
[picture p87: page 13]
Electrodes; Dielectric; Field Lines; (Calle, 2010)

EASE Preliminary Design Review

• Fringing electric field exerts force
on charged dust particles

• 3 phased EDS Systems transport
dust particles

# MECHATRONICS

# FORCES INVOLVED

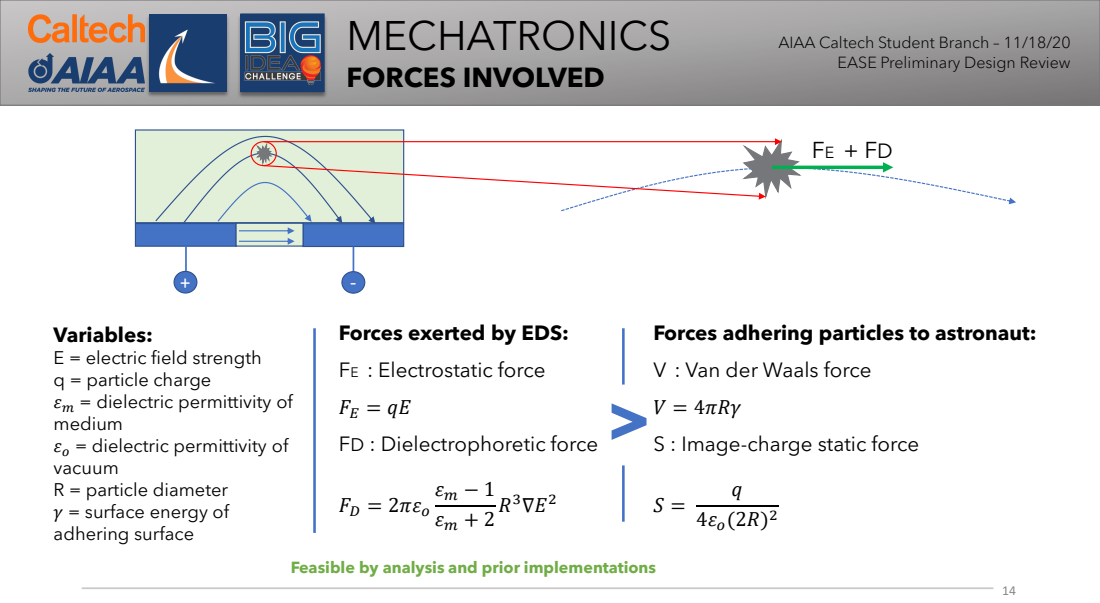
[picture p88: page 14]
FD = 2πεo

EASE Preliminary Design Review

Forces exerted by EDS:
FE : Electrostatic force
FD : Dielectrophoretic force

Forces adhering particles to astronaut:
V : Van der Waals force
V = 4πRγ
S : Image-charge static force

Variables:
E = electric field strength
q = particle charge
εm = dielectric permittivity of
medium
εo = dielectric permittivity of
vacuum
R = particle diameter
γ = surface energy of
adhering surface

Feasible by analysis and prior implementations

# MECHATRONICS

# LAYOUT & PHASING

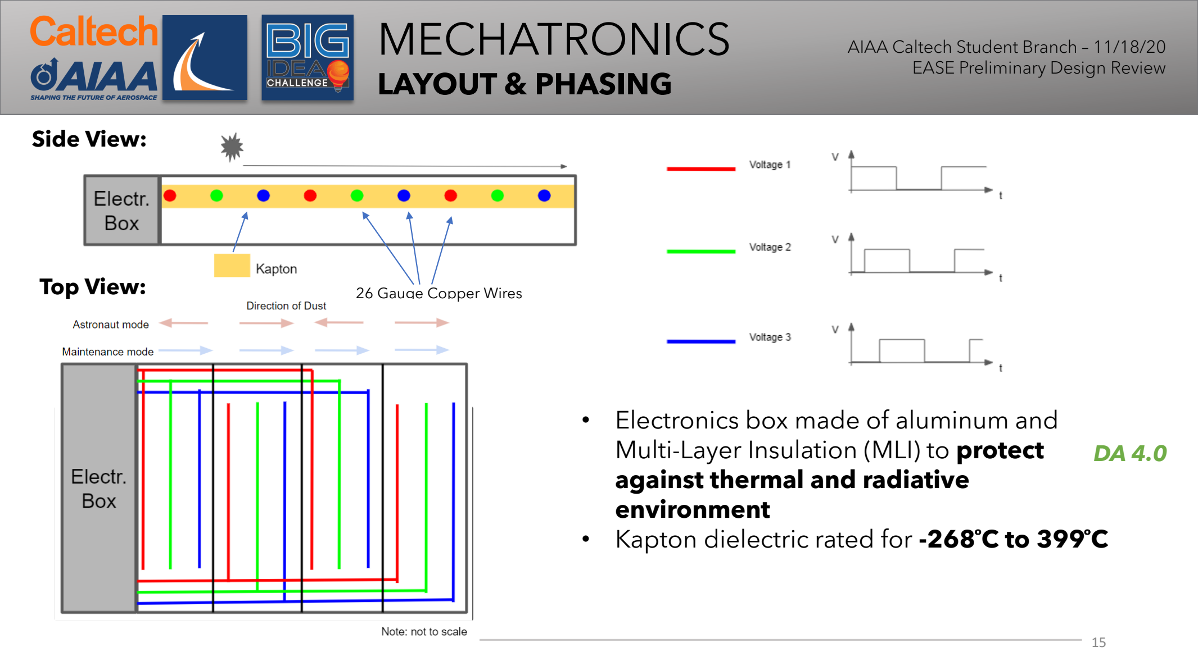
[picture p89: page 15]

### Side View:

Top View: | 26 Gauge Copper Wires

## - Electronics box made of aluminum and Multi-Layer Insulation (MLI) to protect against thermal and radiative environment - Kapton dielectric rated for -268 ̊C to 399 ̊C

DA 4.0

EASE Preliminary Design Review

# MECHATRONICS

# CONTROLS & MODES

EASE Preliminary Design Review

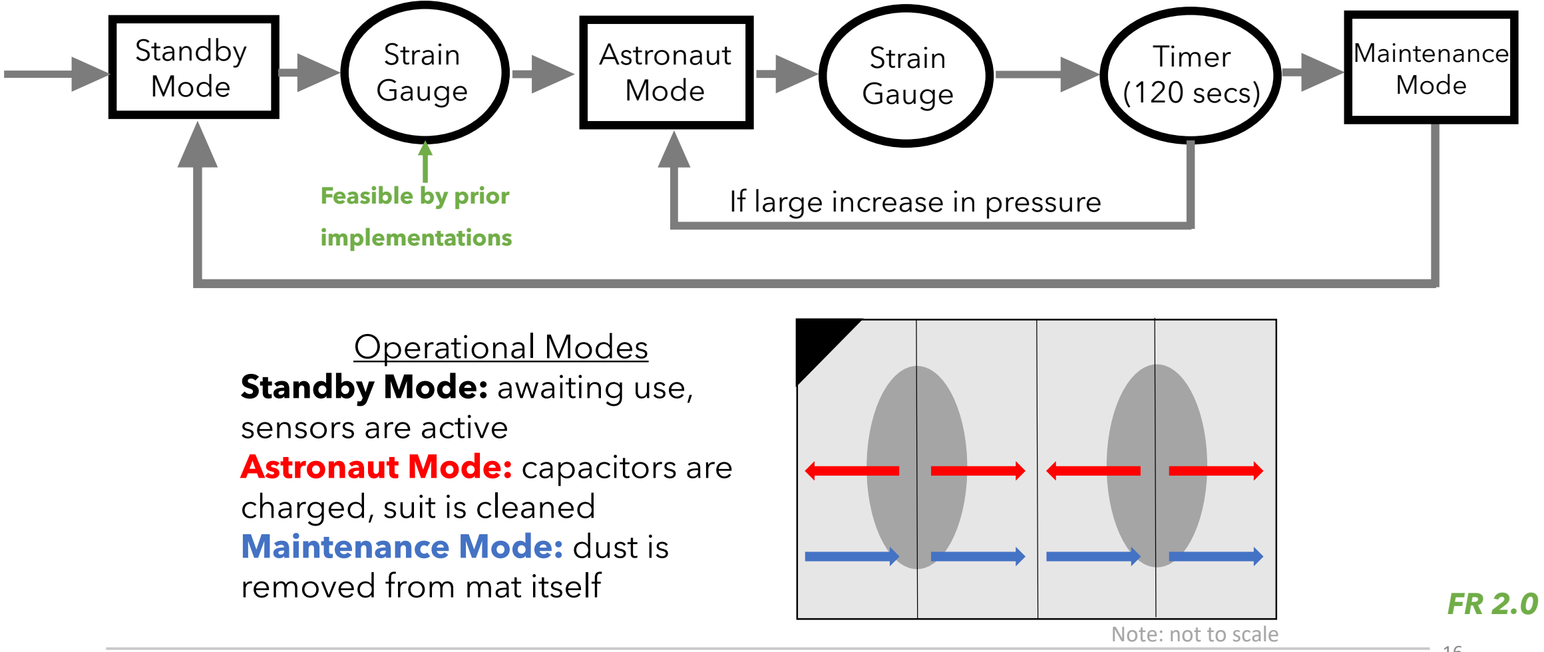
[picture p90: figure]
Operational Modes Standby Mode: awaiting use, sensors are active Astronaut Mode: capacitors are charged, suit is cleaned Maintenance Mode: dust is removed from mat itself; Standby Mode; Strain Gauge; Astronaut Mode; Timer (120 secs); If large increase in pressure; Feasible by prior; implementations; Maintenance Mode; Note: not to scale

# MECHATRONICS

# CIRCUIT DIAGRAM

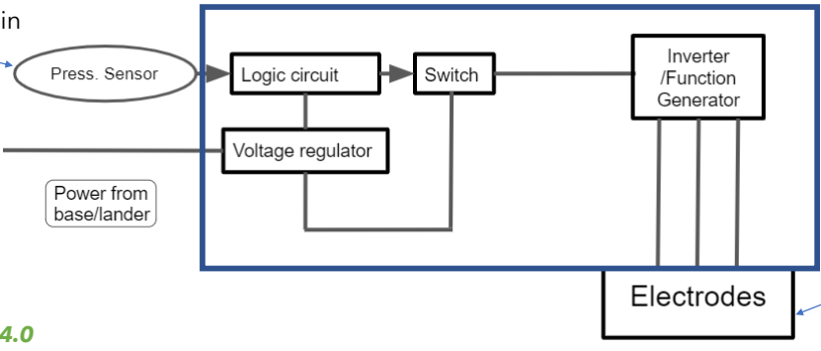
[picture p91: figure]

Sensors and components to be selected/designed from existing NASA satellite and spacecraft payloads.

## Components contained in electronics box

## Embedded in mat

## Embedded in mat

DA 2.0, 4.0

EASE Preliminary Design Review

# Estimates based on finite difference electrostatic simulation

- Obtained mesh grid of electric field strength given electrode lay-out and voltage supply

### - Determined electromagnetic field strength necessary to overcome adhesive and coulombic forces for particle sized 50 μm

# MECHATRONICS

# POWER & PERFORMANCE

Operational Mode | Time Estimate | Input Voltage (DC) | Power Requirements (W)
ASTRONAUT | <30 s / astronaut* | 28 V | 50 W
MAINTENANCE | 120 s | 28 V | 25 W
STANDBY | VARIABLE | 28 V | <100 mW

Feasible by analysis

and prior

implementations

FR 1.0, 2.0

EASE Preliminary Design Review

- Current estimates predict EASE will have low power requirements

* Time estimate based on time efficacy of current EDS systems, will be verified during prototyping.

Electric Field Performance | Height
Maximum Effective range | 0.5 m
“Deep Clean” Coverage | < 3 cm

# MECHANICAL

# DESIGN OVERVIEW

EASE Preliminary Design Review

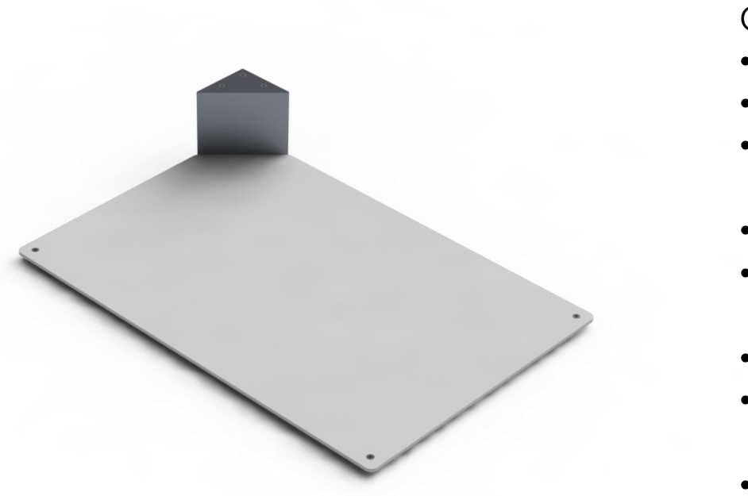
[picture p92: figure]

FR 3.0 - 5.0

## Objectives: - Strong enough to sustain weight - Easy to transport and use - Large enough size to comfortably use - Optimized for weight and volume - Electronics are secured and protected - Cost-effective solution - Protected from the harsh lunar environment

- Use for 15-30 years.

# MECHANICAL

# TRADE STUDY

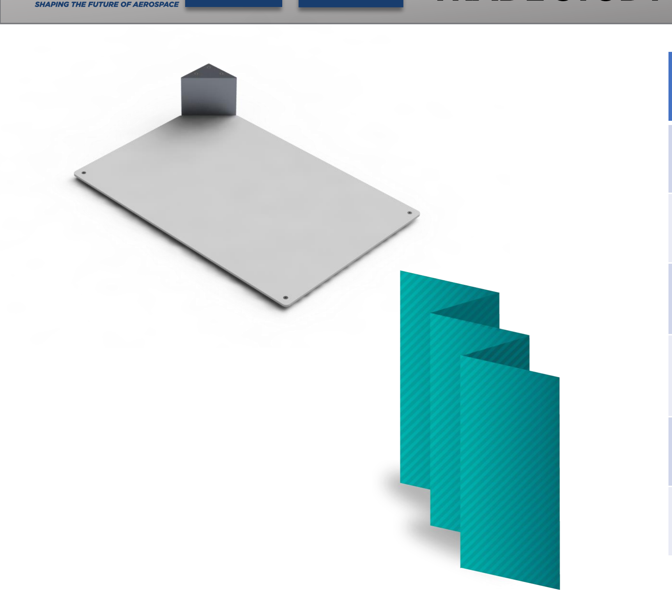
[picture p93: figure]

Metric | Weight | Single Panel | Single Fold Accordion
Use with EDS | 10 | 9 | 5
Robustness | 30 | 25 | 20
Weight and Volume | 20 | 20 | 12
Storage, transportation, deployment | 20 | 20 | 12
Life Cycle | 20 | 20 | 16
Total | 100 | 94 | 65

EASE Preliminary Design Review

# MECHANICAL

# DIMENSIONS

EASE Preliminary Design Review

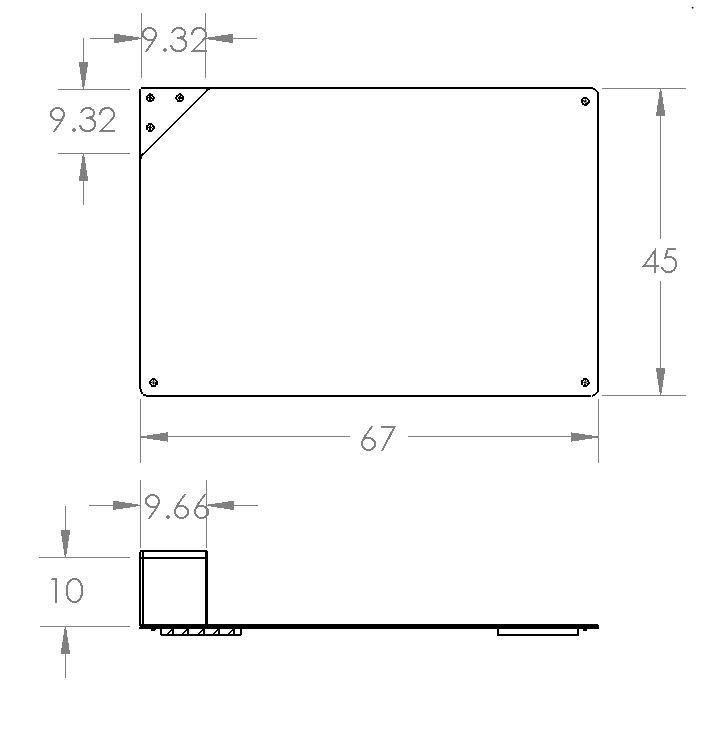
[picture p94: figure]

### Note: Dimensions in centimeters

# MECHANICAL

# DIMENSIONS

EASE Preliminary Design Review

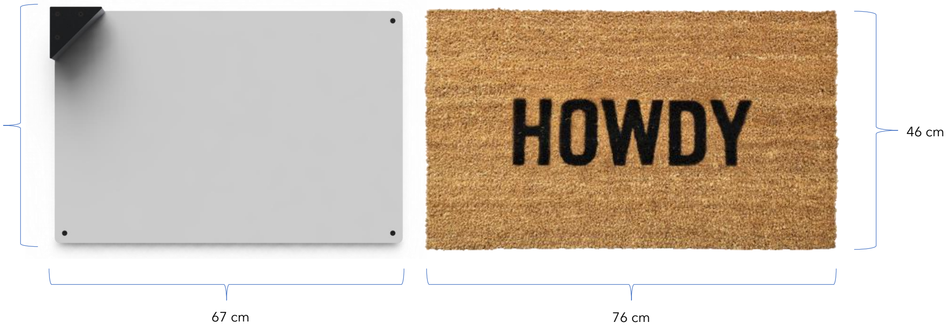
[picture p95: figure]

45 cm

# MECHANICAL

# FEATURES

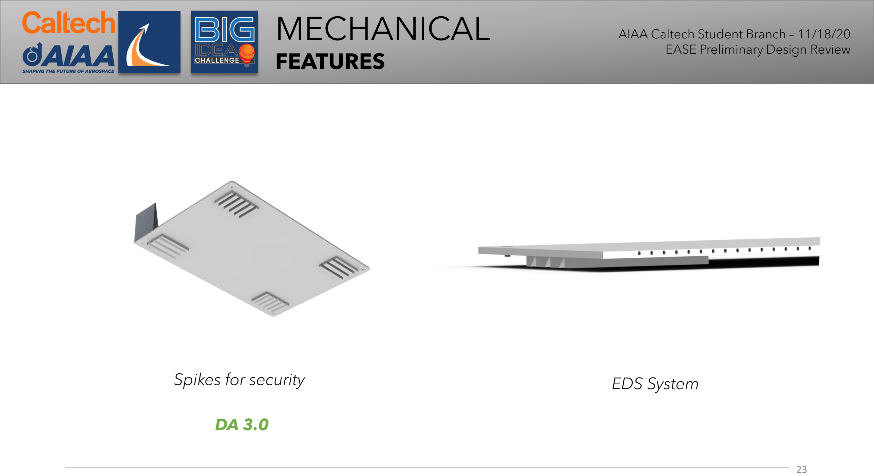
[picture p96: page 23]

EASE Preliminary Design Review

DA 3.0

Spikes for security | EDS System

# MECHANICAL

# ELECTRONICS BOX

EASE Preliminary Design Review

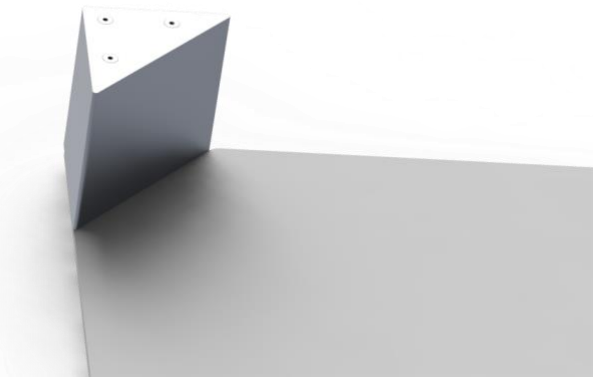
[picture p97: figure]

## Electronics Box: - Aluminum 2219 for housing - Multilayered insulation

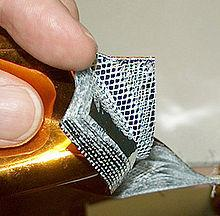
[picture p98: figure]

## These materials are commonly used

in space applications.

Properties | Aluminum 2219
Density | 2.84 g/cm^3
Tensile Strength | 290 MPa
Temperature Range | -250 to 315 (ºC)
Coefficient of Thermal Expansion | 22.3 to 24.1 (10⁻⁶ /ºC)

# MECHANICAL

# PANEL COMPOSITION

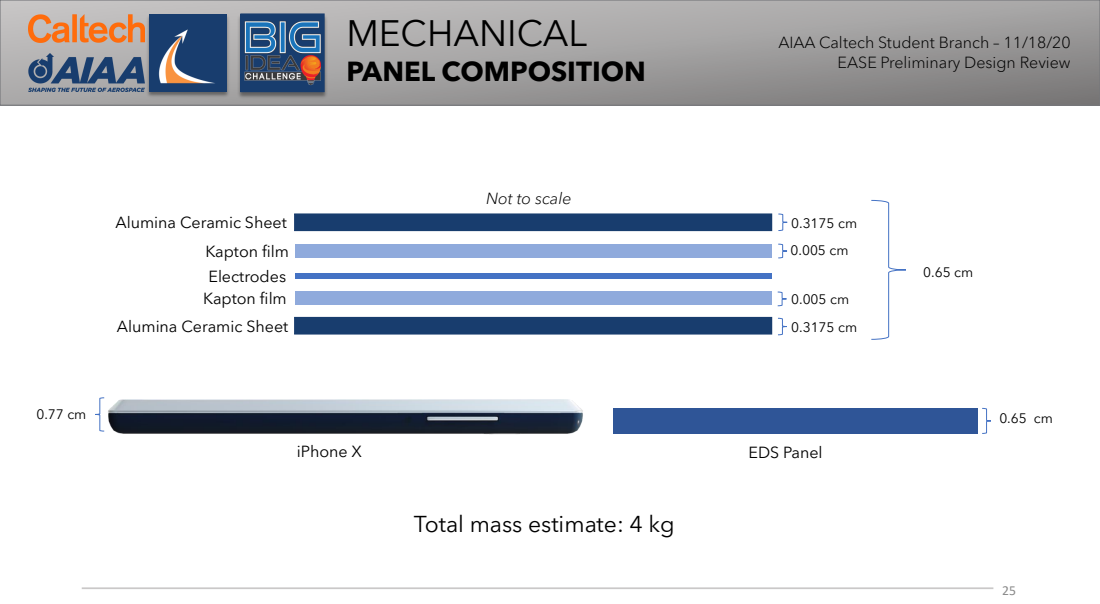
[picture p99: page 25]
Kapton film; Electrodes; iPhone X; EDS Panel

EASE Preliminary Design Review

Not to scale

Alumina Ceramic Sheet

Total mass estimate: 4 kg

# MECHANICAL

# MATERIAL SELECTION

Note: we will use Cicoil wires

| Alumina Ceramic (structure) | 316 Stainless Steel (Bolt) | Kapton (dielectric)
Density | 3.9 (g/cm³ ) | 8.0 (g/cm³ ) | 1.41 (g/cm³ )
Tensile Strength | 260 (MPa) | 482 (MPa) | 230 (MPa)
Flexural Strength | 379 (MPa) | 290 (MPa) | 120 (MPa)
Compressive Strength | 2,600 (MPa) | 170 (MPa) | 172 (MPa)
Coefficient of Thermal Expansion | 8.6 (10⁻⁶ /ºC) | 10.3 (10⁻⁶ /ºC) | 8.1 (10⁻⁵ /ºC)
Dielectric Constant | 9.1 (at 1 MHz) | - | 5.42 (at MHz)
Dielectric Strength | 16.7 (kV/mm) | - | 217 (kV/mm)
Temperature Range | -273.15ºC to 1,750ºC | -252ºC to 871ºC | -267ºC to 398ºC

EASE Preliminary Design Review

# MECHANICAL

# MATERIAL SELECTION

Note: we will use Cicoil wires

| Alumina Ceramic (structure) | 316 Stainless Steel (Bolt) | Kapton (dielectric)
Density | 3.9 (g/cm³ ) | 8.0 (g/cm³ ) | 1.41 (g/cm³ )
Tensile Strength | 260 (MPa) | 482 (MPa) | 230 (MPa)
Flexural Strength | 379 (MPa) | 290 (MPa) | 120 (MPa)
Compressive Strength | 2,600 (MPa) | 170 (MPa) | 172 (MPa)
Coefficient of Thermal Expansion | 8.6 (10⁻⁶ /ºC) | 10.3 (10⁻⁶ /ºC) | 8.1 (10⁻⁵ /ºC)
Dielectric Constant | 9.1 (at 1 MHz) | - | 5.42 (at MHz)
Dielectric Strength | 16.7 (kV/mm) | - | 217 (kV/mm)
Temperature Range | -273.15ºC to 1,750ºC | -252ºC to 871ºC | -267ºC to 398ºC

EASE Preliminary Design Review

# MECHANICAL

# MATERIAL SELECTION

Note: we will use Cicoil wires

| Alumina Ceramic (structure) | 316 Stainless Steel (Bolt) | Kapton (dielectric)
Density | 3.9 (g/cm³ ) | 8.0 (g/cm³ ) | 1.41 (g/cm³ )
Tensile Strength | 260 (MPa) | 482 (MPa) | 230 (MPa)
Flexural Strength | 379 (MPa) | 290 (MPa) | 120 (MPa)
Compressive Strength | 2,600 (MPa) | 170 (MPa) | 172 (MPa)
Coefficient of Thermal Expansion | 8.6 (10⁻⁶ /ºC) | 10.3 (10⁻⁶ /ºC) | 8.1 (10⁻⁵ /ºC)
Dielectric Constant | 9.1 (at 1 MHz) | - | 5.42 (at MHz)
Dielectric Strength | 16.7 (kV/mm) | - | 217 (kV/mm)
Temperature Range | -273.15ºC to 1,750ºC | -252ºC to 871ºC | -267ºC to 398ºC

EASE Preliminary Design Review

# MECHANICAL

# MATERIAL SELECTION

Note: we will use Cicoil wires

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

EASE Preliminary Design Review

DA 5.0
FR 3.0 - 5.0

# MECHANICAL

# MATERIAL JUSTIFICATION

EASE Preliminary Design Review

Alumina | Kapton
Electrical insulator | Stability across wide temperature range
Low dielectric constant | Durability
Low thermal conductivity | Good dielectric qualities
Hardness | Used in spacecraft applications (Apollo launcher, Curiosity rover)

### Strength

### Sufficient temperature range

### Abrasion resistant

### Used in many spacecraft applications

FR 3.0 - 5.0

# MECHANICAL

# MANUFACTURING

EASE Preliminary Design Review

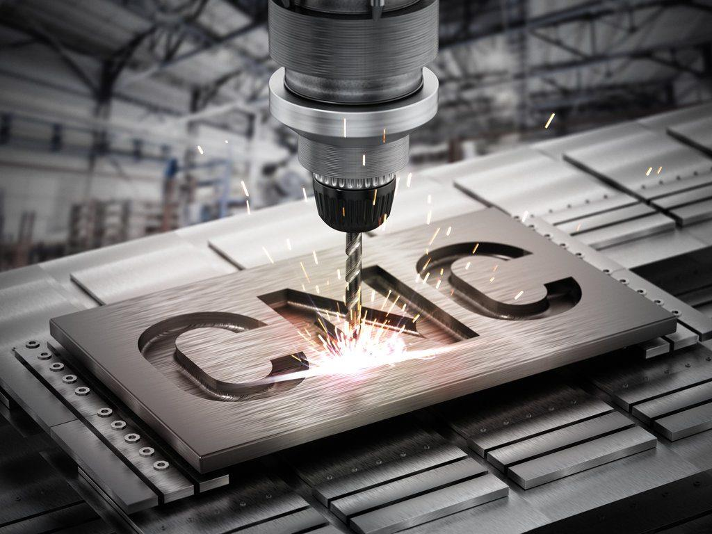
[picture p100: figure]

### Top Plate: - 3-axis CNC milling Bottom Plate: - 3-axis CNC milling Electronics Box: - 3-axis CNC milling

### - Design considerations: 0.5 mm tolerance, large external and internal fillets

# MISSION INTEGRATION

# RISK ASSESSMENT

EASE Preliminary Design Review

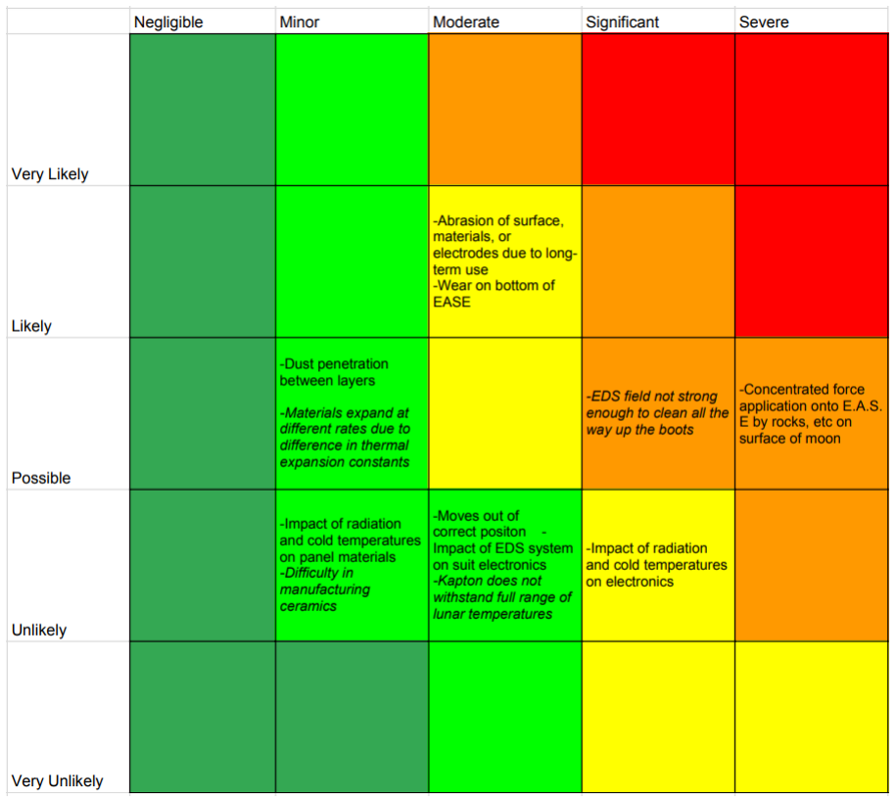
[picture p101: figure]

- Impact of radiation and cold temp on electronics:
- The likelihood of single particle upsets is very low
- MLI (multi-layered insulation) should protect the electronics from cold temperatures
- EDS field not strong enough to clean all the way up the boots
- EDS geometry and electronics are easily altered to increase the field strength
- Abrasion of surface, materials or electrodes due to long-term use
- Ceramic has high abrasion resistance

### RISK MITIGATION STRATEGIES:

# MISSION INTEGRATION

# RISK ASSESSMENT

EASE Preliminary Design Review


- Dust penetration between layers
- Kapton is being compressed between two ceramic panels and acts as a gasket
- Concentrated force application onto EASE by rocks on the surface of the moon
- Not a problem if astronauts clear the area
- Wear on bottom of EASE, as well as moving out of position:
- The spikes on the bottom of EASE secure it to the surface, limiting slipping and abrasion by loose particles underneath it

### RISK MITIGATION STRATEGIES CONT’D:

# VERIFICATION

# TEST PROGRAM

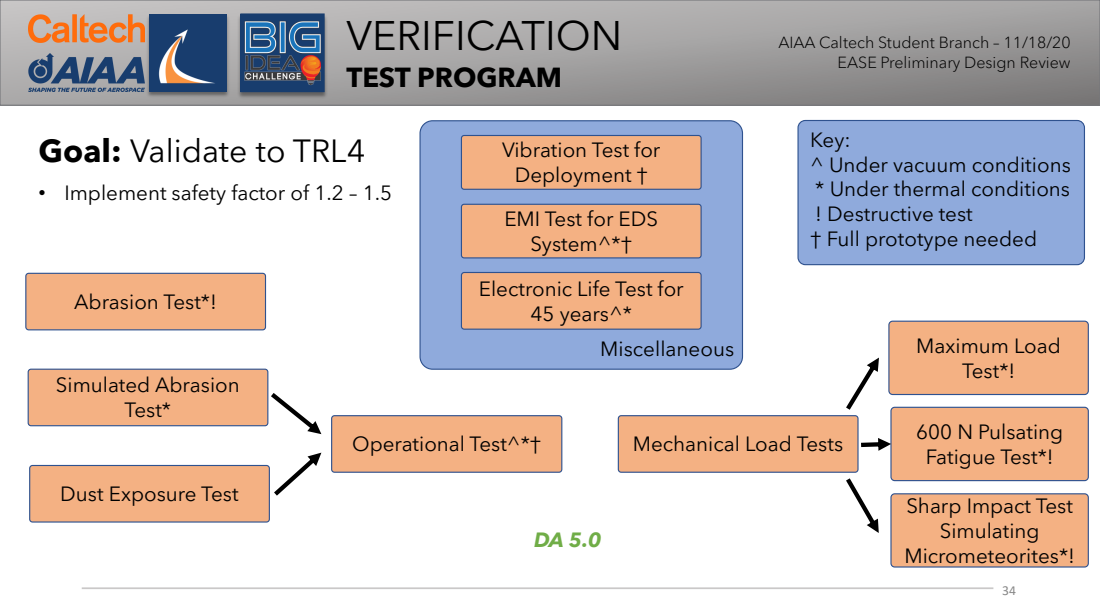
[picture p102: page 34]
Operational Test^*†; Mechanical Load Tests; 600 N Pulsating; Fatigue Test*!; Maximum Load Test*!; Simulated Abrasion Test*; Miscellaneous; Abrasion Test*!; Electronic Life Test for; 45 years^*

EASE Preliminary Design Review

Key:
^ Under vacuum conditions
* Under thermal conditions
! Destructive test
† Full prototype needed

Goal: Validate to TRL4

Vibration Test for
Deployment †

• Implement safety factor of 1.2 – 1.5

EMI Test for EDS
System^*†

Dust Exposure Test

Sharp Impact Test
Simulating
Micrometeorites*!

# VERIFICATION

# TEST PROGRAM

EASE Preliminary Design Review

# Equipment and Testing Conditions

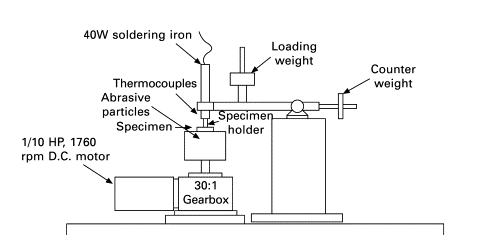
[picture p103: figure]

### (Roy, 2008)

### Three-Body Abrasive Wear Test Rig

## - We will use NTS for thermal vacuum chamber testing - Lunar Simulant JSC-1A will be used for EDS-related testing - Lunar Simulants OB-1 and Chenobi are the most recommended simulants for abrasion and dust exposure testing - We will test from -260˚C to 140˚C to simulate lunar thermal conditions

# LOGISTICS

# SCHEDULE

EASE Preliminary Design Review

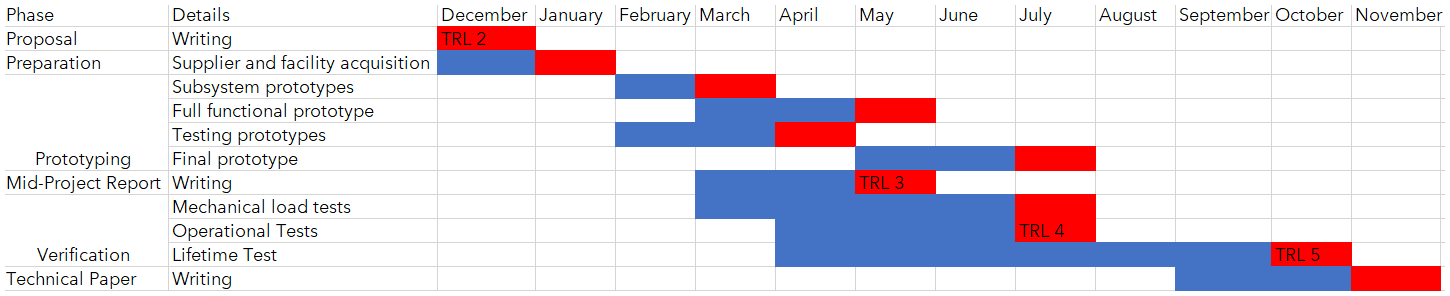
[picture p104: figure]

# LOGISTICS

# BUDGETING

Raw Material Costs Est.

## - 4 prototypes without EDS System - 1 complete prototype - Costs will increase if a need for iteration arises

EASE Preliminary Design Review

Category | Constituents | Subtotal
Prototyping | Materials (for multiple prototypes) | $5,000.00
| Electronics ("") | $5,000.00
| Final device | $5,000.00
Manufacturing Services | | $4,000.00
Testing | Dust simulant | $1,000.00
| Vacuum & cryo chamber rental | $10,000.00
| Abrasion Testing | $1,500.00
Labour | Graduate Students | $20,000.00
Total | | $51,500.00

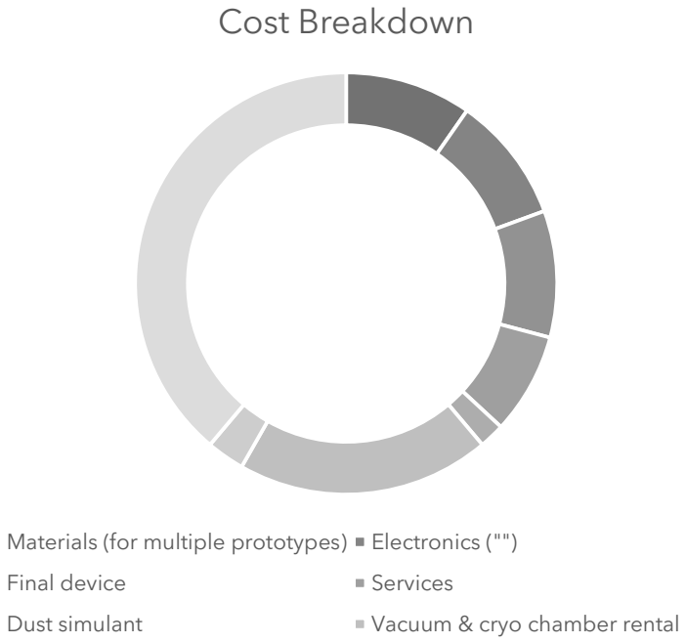
[picture p105: figure]
Cost Breakdown; Materials (for multiple prototypes); Electronics (""); Final device; Services; Dust simulant; Vacuum & cryo chamber rental

Abrasion Testing | Graduate Students

# CONCLUSION

# FEASIBILITY REVIEW

EASE Preliminary Design Review

Function / Characteristic | Solution | Feasible?
Transport dust | EDS | YES
Touch-free operation | Strain Gauge | YES
Rugged housing | Ceramic | YES

# CONCLUSION

# THANK YOU

EASE Preliminary Design Review

# Branch Lead

### Luis Pabon

lpabonma@caltech.edu

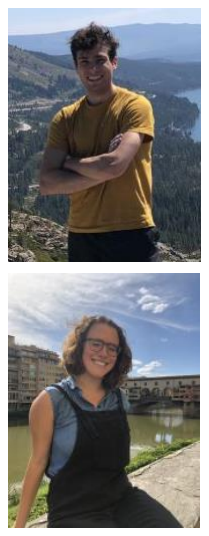
[picture p106: figure]

# Project Lead

### Malcolm Tisdale

mtisdale@caltech.edu

# Ops. Lead

### Isabella Dula

imdula@caltech.edu

# Advisor

### Dr. Soon-Jo Chung

sjchung@caltech.edu

# Points of Contact:

# Thank you for listening!

# We appreciate any feedback through: - Email - Feedback form

- Q & A

# CONCEPT OVERVIEW

# QUAD CHART

Leverages 50-year-old dust mitigation technology currently being tested on ISS
- 3-Phase traveling square wave pushes dust particles off astronaut boots and EASE
- Touch-free operation using strain gauges in mat
- Extensive validation and verification program though

# Objective:

Approach: | Key Milestones:
- Minimize dust ingress into lunar habitat module on astronaut boots
- Increases traction of astronaut boots
- EASE is portable, durable, low SWaPs device
- Clears lunar dust from astronaut boots in < 30 sec and self cleaning
- Increases the state-of-the-art:
- Largest, most compact, and durable implementation of electrodynamic shielding technology
- Develop and validate to TRL 5

### Render of EASE

Mass Estimate: < 4 kg | Power Estimate: 50 W max
Description | TRL | Deadline
Preliminary Design Review | 2 | 11/18/20
Proposal | 3 | 12/13/20
Functional Prototype | 3 | 4/1/21
Midpoint Report | 4 | 5/20/21
Technical Paper & Verification Demonstration | 5 | 10/27/21

EASE Preliminary Design Review

### Astronaut boot placement

# LOAD VALIDATION

# FEA ANALYSIS

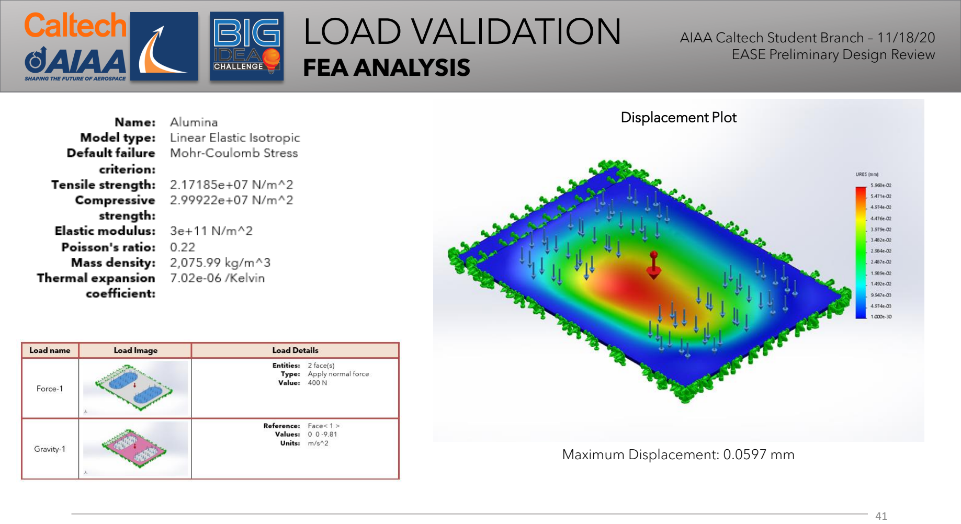
[picture p107: page 41]

Displacement Plot

Maximum Displacement: 0.0597 mm

EASE Preliminary Design Review

# LOAD VALIDATION

# FEA ANALYSIS

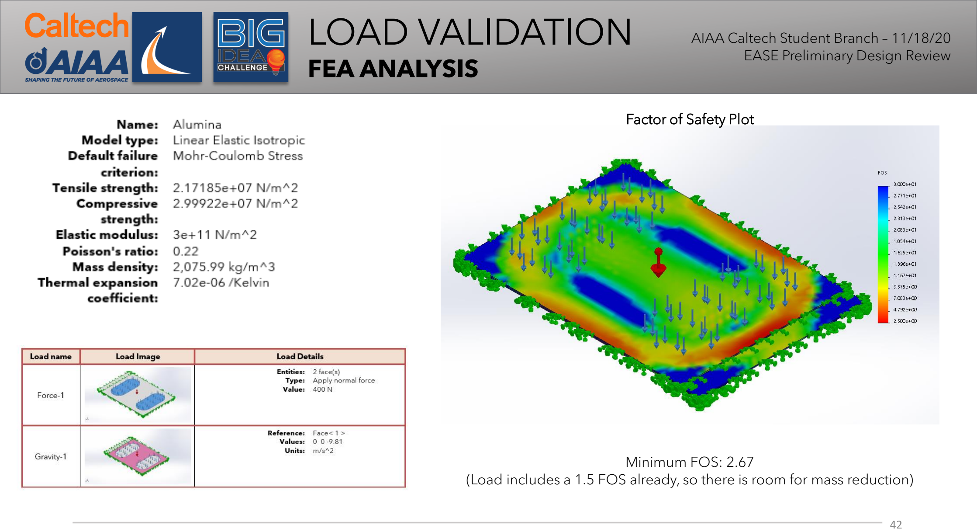
[picture p108: page 42]

Factor of Safety Plot

Minimum FOS: 2.67
(Load includes a 1.5 FOS already, so there is room for mass reduction)

EASE Preliminary Design Review
