caltechcaos/Lunar-Dust-Challenge/PDR/PDR Presentation/EASE PDR FINAL.pdf

# EASE

# Electrodynamic Dust Shielding Activated Surface Emitter


AIAA Caltech Student Branch – 18/11/20 Advisor: Dr. Soon-Jo Chung


# Preliminary Design Review

# INTRODUCTION

# ROADMAP

AIAA Caltech Student Branch – 11/18/20 Preliminary Design Review – E.A.S.E.

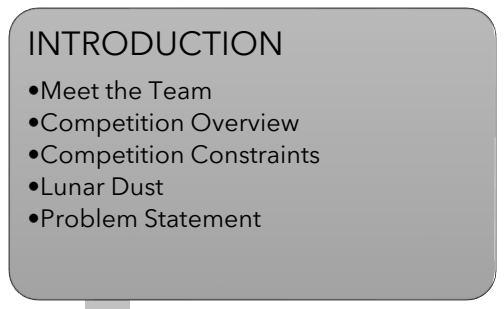
[picture p109: figure]
INTRODUCTION; •Meet the Team •Competition Overview •Competition Constraints •Lunar Dust •Problem Statement
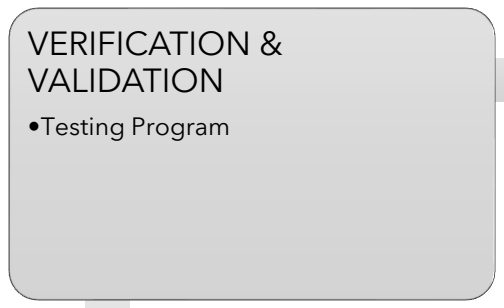
[picture p110: figure]
VERIFICATION & VALIDATION; •Testing Program
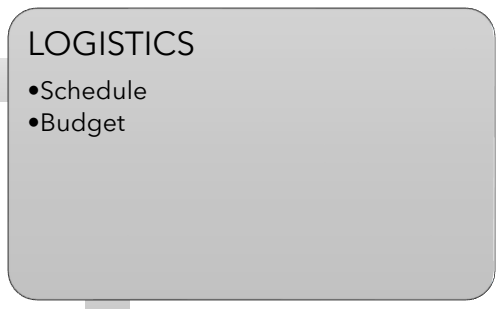
[picture p111: figure]
LOGISTICS; •Schedule •Budget
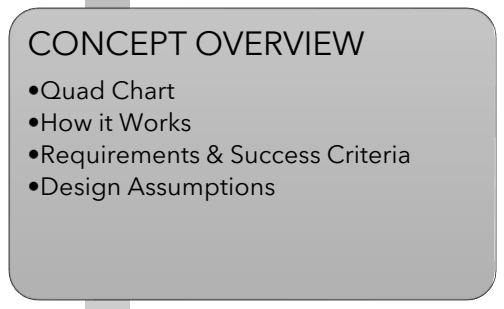
[picture p112: figure]
CONCEPT OVERVIEW; •Quad Chart •How it Works •Requirements & Success Criteria •Design Assumptions
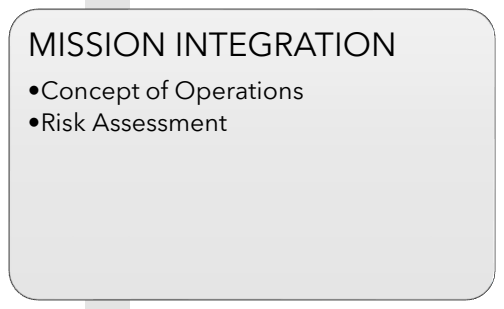
[picture p113: figure]
MISSION INTEGRATION; •Concept of Operations •Risk Assessment
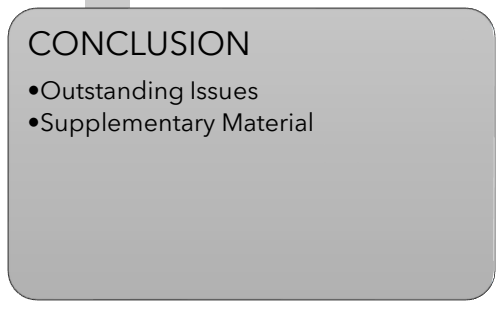
[picture p114: figure]
CONCLUSION; •Outstanding Issues •Supplementary Material
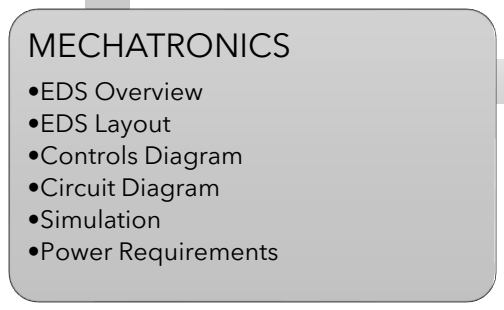
[picture p115: figure]
MECHATRONICS; •EDS Overview •EDS Layout •Controls Diagram •Circuit Diagram •Simulation •Power Requirements
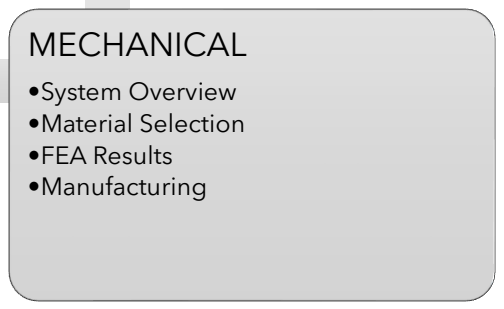
[picture p116: figure]
MECHANICAL; •System Overview •Material Selection •FEA Results •Manufacturing

# INTRODUCTION

# MEET THE TEAM

Preliminary Design Review – E.A.S.E.

# Leadership

# CEO

### Luis Pabon

MCE & Aero, ’22
Houston, TX

# CTO

### Malcolm Tisdale

MCE & CDS, ‘22

# COO

### Isabella Dula

MCE & , ‘22

# Mechanical

# Mechatronics

# Mission Integration

Lead
Polina
Verkhovodova
MCE & Pl, ’22
Pasadena, CA

Lead
Leah Soldner
MCE , ’24
S Pasadena,
CA

Tanmay
Gupta
MCE , ’24
Ph / Astro
Kuala Lumpur,
Malaysia

Nathan Ng
MCE , ’24
Santa Clara,
CA

Lead
Calle Junker
MCE, ’23
Aztec, NM

Athena Kolli
MCE , ’24
Buffalo Grove,
IL

Kaila
Coimbra
MCE , ’23
San Diego,
CA

Rithvik
Musuku
MCE , ’24
Gilbert, AZ

Parul Singh
MCE , ’24
Tallahasee, FL

Kemal
Pulungan
MCE , ’24
Troy, NY

Jules Penot
MCE & Aero , ’24
Valbonne, France

# Advisor

### Dr. Soon-Jo Chung

Lead
Isabella
Dula

# INTRODUCTION

# COMPETITION OVERVIEW

# Artemis Missions – Feet on the moon by 2024 &

# sustainable missions by 2028. NASA BIG Idea Challenge Finalists implemented 2026

Preliminary Design Review – E.A.S.E.

- University teams of 5 – 25 students
- Teams submit proposals (Dec 13th 2020) for funding to develop concepts for technical paper and BIG Idea Forum (Nov 15th 2021)
- Awards from $50,000 - $180,00

## Landing Dust Prevention &

Mitigation - to preclude

or protect from plume/surface interactions which may result in damaged landers and
nearby surface assets

## Spacesuit Dust Tolerance & Mitigation – to limit

dust adherence to spacesuits and other damaging effects to its subsystems

## Exterior Dust

Prevention,

## Tolerance, & Mitigation – to protect

lunar surface systems or
preclude dust from entering habitats and landers

## Cabin Dust Tolerance & Mitigation - to clean

habitable volumes and their interior surfaces, which helps prevent dust from making it back to Gateway and Orion
when the lander returns to lunar orbit from the surface

# INTRODUCTION

# COMPETITION CONSTRAINTS

# Constraints

- Able to manage or mitigate lunar dust (~0.5-100 um)
- Minimal barrier to NASA adoption
- Cost, power, mass, size …
- Minimum Technological Readiness Level 4 (->5)
- Lifespan of 15 - 30 years
- Removes dust “in minutes”
- Lunar environmental conditions
- South pole temperatures between -232C and -49C
- Permanently shadowed craters as low as -243C

Preliminary Design Review – E.A.S.E.


# Considerations

- Aiming for 2026 deployment in lunar missions
- Simplicity of operation and maintenance
- Deployment method from NASA or commercial surface lander
- Effective packaging for launch and Moon landing
- Credible fabrication and material selection

Lunar Dust
Particle

Gene Cernan
covered in lunar
dust

# INTRODUCTION

# LUNAR DUST

# Issues Posed

- Vision obscuration
- False instrument readings
- Dust coating and contamination
- Seal failures
- Abrasion of materials
- Inhalation and irritation risks
- Loss of foot traction

Preliminary Design Review – E.A.S.E.

# Dust Properties

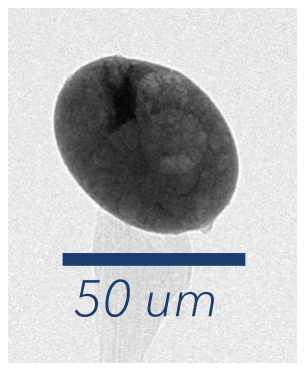
[picture p117: figure]
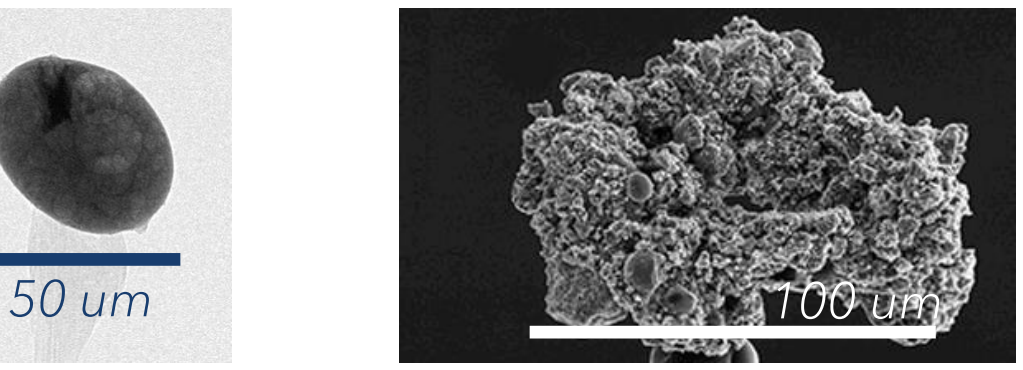
[picture p118: figure]

PROPERTY | VALUE | UNITS
Size range | 4 – 500 | [nm] – [um]
Volume fraction | < 0.2 | %
Relative permittivity | 3 - 4
Relative permeability | ~ 1
Specific gravity | ~ 3 | [g * cm^-3]
Charge | 10^11 – 10^13 | [C / kg]
- Charged through solar
emissions
- Trace magnetic elements
- 90% Silicate/Aluminosilicate minerals by volume
- Highly irregular and sharp
- Charge density increases with particle size

# INTRODUCTION

# PROBLEM STATEMENT

# Problems Caused By Spacesuit

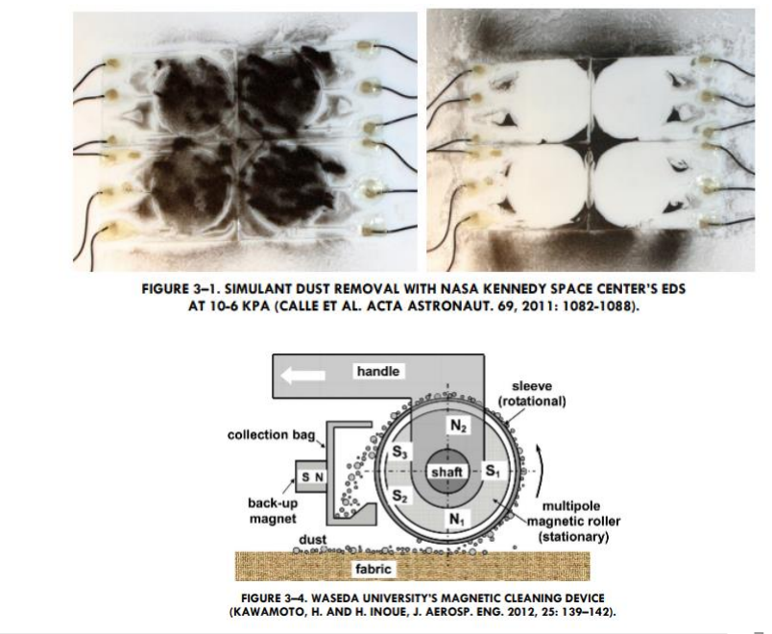
[picture p119: figure]

# Dust Ingress Into Habitable Volumes

## - Increased loads on in-cabin dust mitigation technologies - Incorrect readings during in-cabin experiments - Performance reduction and possible failure of in-cabin equipment - Astronaut health risks - Dust brought to Gateway and Orion when lander returns to lunar orbit

# Existing Solutions

AIAA Caltech Student Branch – 18/11/20 Preliminary Design Review – H.O.M.E.S.

# CONCEPT OVERVIEW

# QUAD CHART

Leverages 50-year-old dust mitigation technology currently being tested on ISS
- 3-Phase traveling square wave pushes dust particles off astronaut boots and EASE
- Touch-free operation using piezoelectric pressure sensors in mat
- Extensive validation and verification program though

Preliminary Design Review – E.A.S.E.

# Objective:

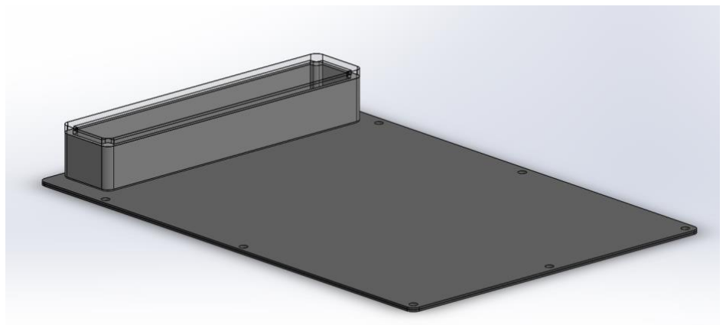
[picture p120: figure]

Approach: | Key Milestones:
- Minimize dust ingress into lunar habitat module on astronaut boots
- Increases traction of astronaut boots
- EASE is portable, durable, low SWaPs device
- Clears lunar dust from astronaut boots in < 2 mins and self cleaning
- Increases the state-of-the-art:
- Largest, most compact, and durable implementation of electrodynamic shielding technology
- Develop and validate to TRL 5

### Render of EASE

Mass Estimate: 1.2 kg | Power Estimate: 10 W max
Description | TRL | Deadline
Preliminary Design Review | 2 | 11/18/20
Proposal | 3 | 12/13/20
Functional Prototype | 3 | 4/1/21
Midpoint Report | 4 | 5/20/21
Technical Paper & Verification Demonstration | 5 | 10/27/21

# CONCEPT OVERVIEW

# REQUIREMENTS

AIAA Caltech Student Branch – 18/11/20 Preliminary Design Review – H.O.M.E.S.

Functional Requirements | Description
FR 1.0 | Remove 50% of dust from astronaut boots during cleaning period
FR 2.0 | Self-cleaning after astronaut departure
FR 3.0 | Minimum 15-year lifetime on lunar surface
FR 4.0 | Capable of enduring forces involved in launch and landing
FR 5.0 | Capable of enduring repeated impacts without loss in performance

# CONCEPT OVERVIEW

# DESIGN ASSUMPTIONS

Preliminary Design Review – E.A.S.E.

Design Assumption | Description
DA 1.0 | EASE placed on 1 m x 1 m cleared and leveled area of regolith
DA 2.0 | 28 V DC power supplied by lunar habitats and landers
DA 3.0 | Lunar regolith compresses under load of mat and astronaut
DA 4.0 | Disregard off nominal solar activity
DA 5.0 | No more than one astronaut at a time maximum load

# EDS OVERVIEW

# DESIGN HERITAGE

- Parent technology developed in 1970s - Lifts and transports charged and uncharged particles using electrostatic and dielectrophoretic forces - Works best for particle size regimes of 5-300 µm (encompasses size regime for lunar dust particles) - Technology currently being used in: - Solar panel maintenance (dust removal efficiency

of 90%)

## - Tested in mock lunar environments - In-Situ Experiments on ISS on thermal radiators and solar panels - Ongoing; showed that EDS works in vacuum - Solar panel effectiveness 22.5%→98.4% after EDS implementation with lunar simulant

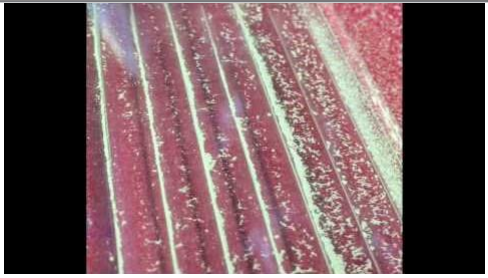
[picture p121: figure]

Demonstration of EDS on a glass plate; particle size < 20 µm (Guo, 2018)

# Electrodynamic Dust Shielding


EDS
System
mounted
on sim.
Lunar
habitat

Preliminary Design Review – E.A.S.E.

# EDS OVERVIEW

# INTERDIGATED CAPACITOR

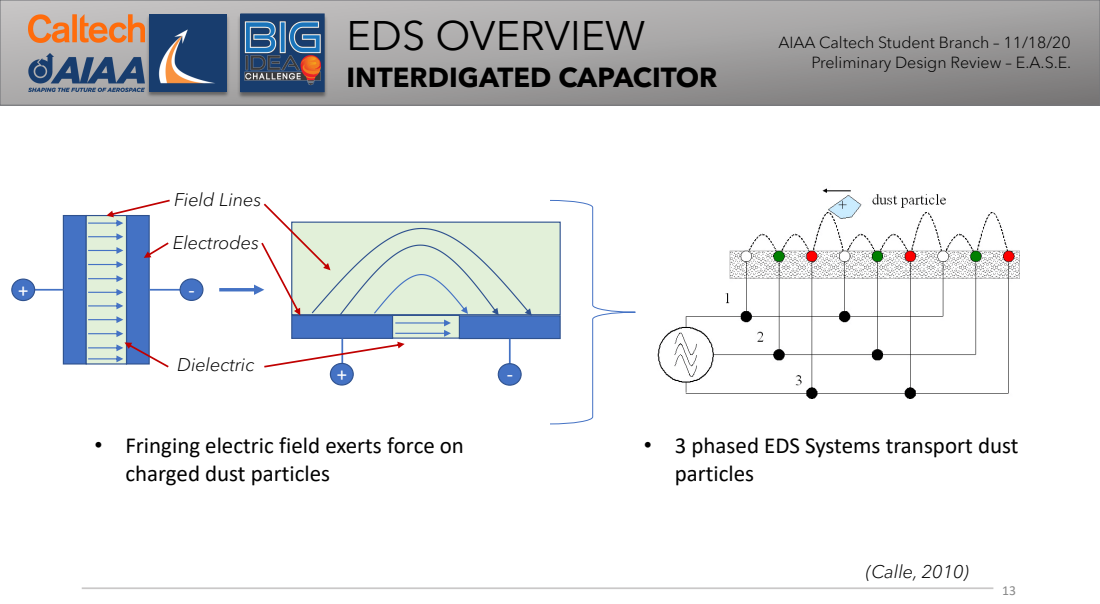
[picture p122: page 12]
Electrodes; Dielectric; Field Lines; (Calle, 2010)

Preliminary Design Review – E.A.S.E.

• Fringing electric field exerts force on
charged dust particles

• 3 phased EDS Systems transport dust
particles

# EDS OVERVIEW

# FORCES INVOLVED

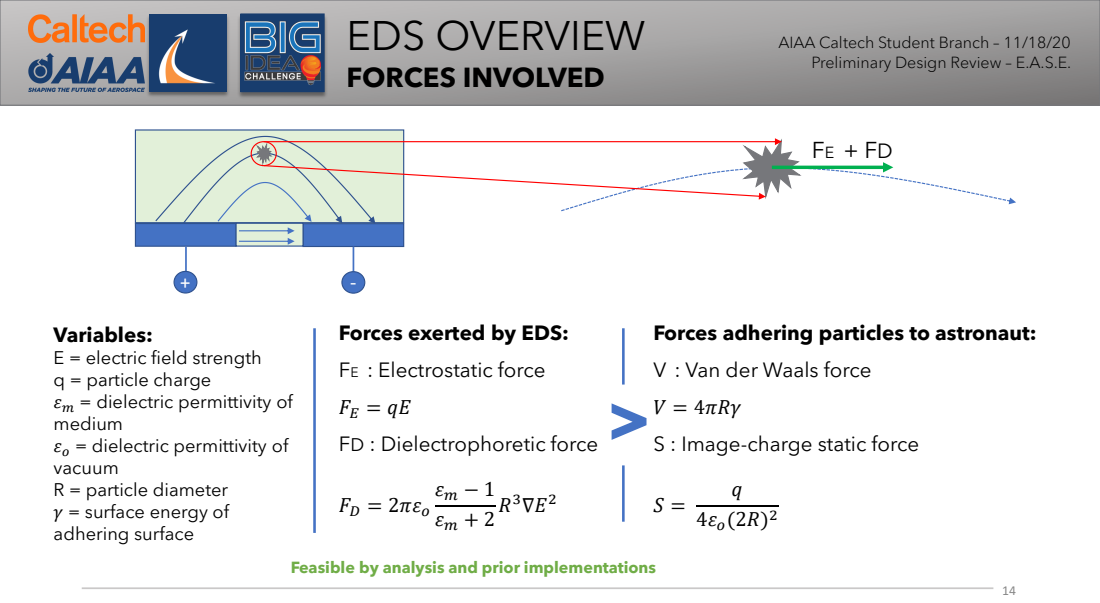
[picture p123: page 13]
FD = 2πεo

Preliminary Design Review – E.A.S.E.

Forces exerted by EDS:
FE : Electrostatic force
FD : Dielectrophoretic force

Forces adhering particles to astronaut:
V : Van der Waals force
V = 4πRγ
S : Image-charge static force

Variables:
E = electric field strength
q = particle charge
εm = dielectric permittivity of
medium
εo = dielectric permittivity of
vacuum
R = particle diameter
γ = surface energy of
adhering surface

Feasible by analysis and prior implementations

# MECHATRONICS

# LAYOUT AND PHASING

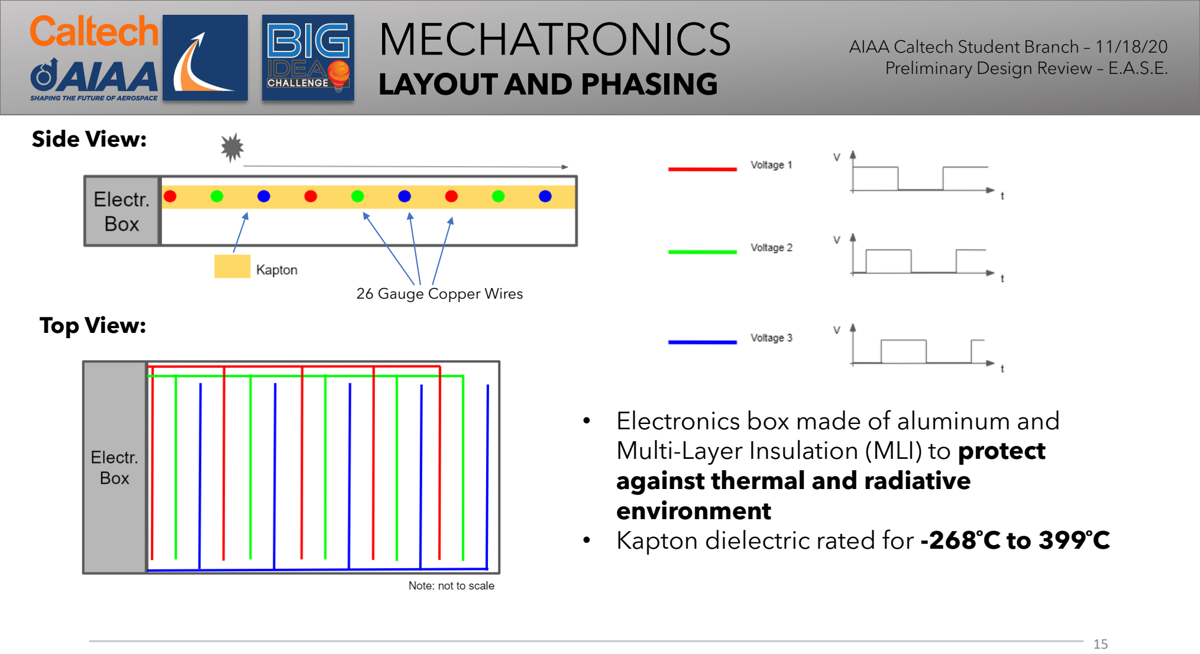
[picture p124: page 14]

### Side View:

### Top View:

26 Gauge Copper Wires

## - Electronics box made of aluminum and Multi-Layer Insulation (MLI) to protect against thermal and radiative environment - Kapton dielectric rated for -268 ̊C to 399 ̊C

Preliminary Design Review – E.A.S.E.

# MECHATRONICS

# CONTROLS & MODES

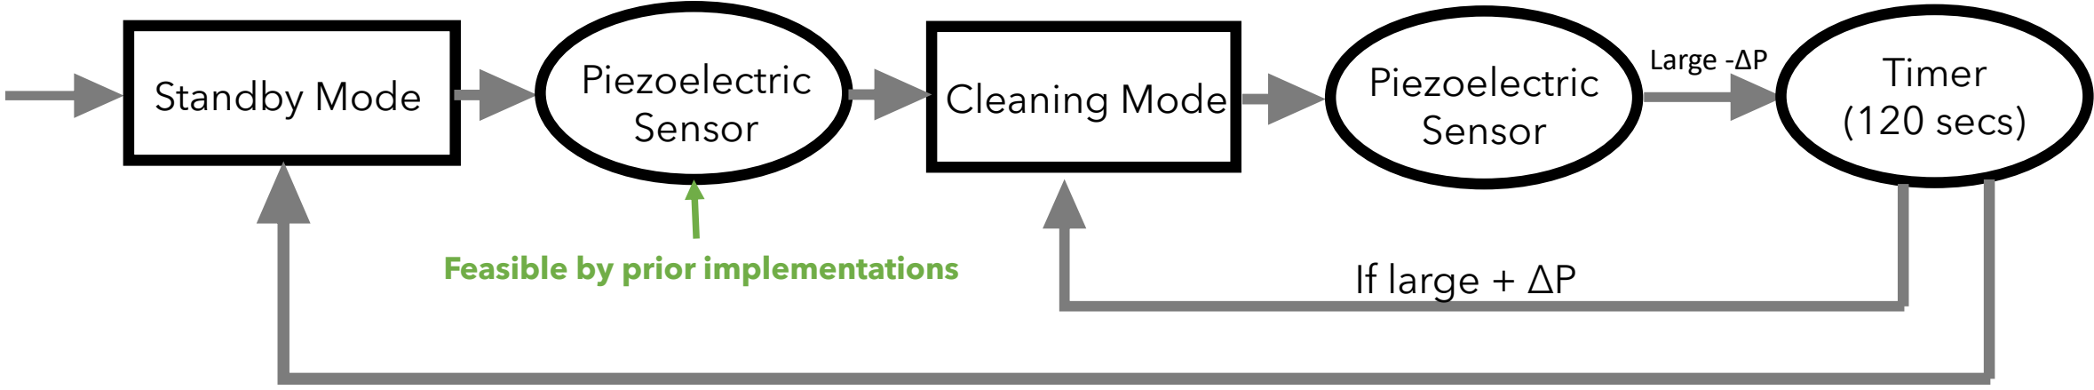
[picture p125: figure]
Standby Mode; Piezoelectric; Sensor; Cleaning Mode; Timer; (120 secs); Large -ΔP; If large + ΔP; Piezoelectric Sensor; Feasible by prior implementations

# Operational Modes Standby Mode: awaiting use, sensors are active

Cleaning Mode: capacitors are charged, suit is cleaned,

# dust removed from mat

Preliminary Design Review – E.A.S.E.

# MECHATRONICS

# CIRCUIT DIAGRAM

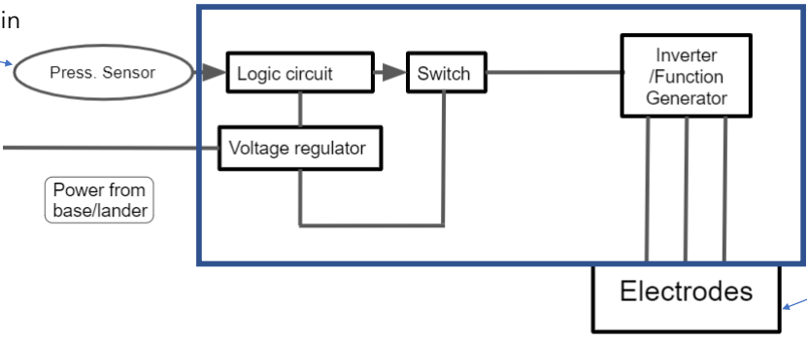
[picture p126: figure]

Sensors and components to be selected/designed from existing NASA satellite and spacecraft payloads.

## Components contained in electronics box

## Embedded in mat

## Embedded in mat

Preliminary Design Review – E.A.S.E.

# - Estimates based on finite difference time domain electrostatic simulation

- Obtained mesh grid of electric field strength given electrode lay-out and voltage supply

### - Determined electromagnetic field strength necessary to overcome adhesive forces

### - Current estimates predict EASE will have low power requirements

# MECHATRONICS

# POWER REQUIREMENTS

Operational Mode | Time Estimate | Voltage (DC) | Power Requirements (W)
ASTRONAUT | 3 min/astronaut | 28 V | 10 W
STANDBY | VARIABLE | 28 V | <100 mW

Preliminary Design Review – E.A.S.E.

Feasible by analysis and prior implementations

# DESIGN OVERVIEW

# MECHANICAL

## Objectives: - Strong enough to sustain weight - Easy to transport and use - Large enough size to comfortably use - Optimized for weight and volume - Electronics are secured and protected - Cost-effective solution - Protected from the harsh lunar environment

- Use for 15-30 years.

AIAA Caltech Student Branch – 18/11/20 Preliminary Design Review – E.A.S.E

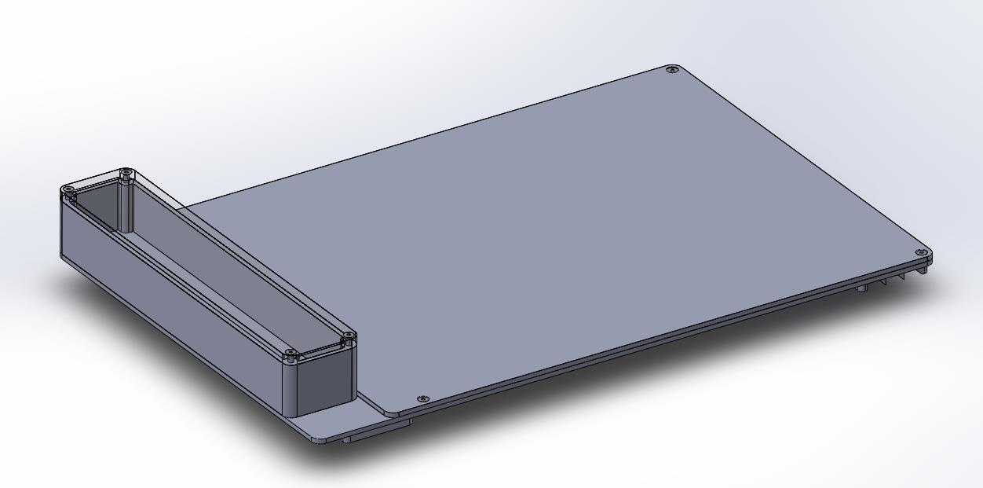
[picture p127: figure]

# DESIGN OVERVIEW

# MECHANICAL

AIAA Caltech Student Branch – 18/11/20 Preliminary Design Review – H.O.M.E.S.

Metric | Weight | Single Panel | Single Fold Accordion
Use with EDS | 10 | 9 | 5
Robustness | 30 | 25 | 20
Weight and Volume | 20 | 20 | 12
Storage, transportation, deployment | 20 | 20 | 12
Life Cycle | 20 | 20 | 16
Total | 100 | 94 | 65

# DESIGN OVERVIEW

# MECHANICAL

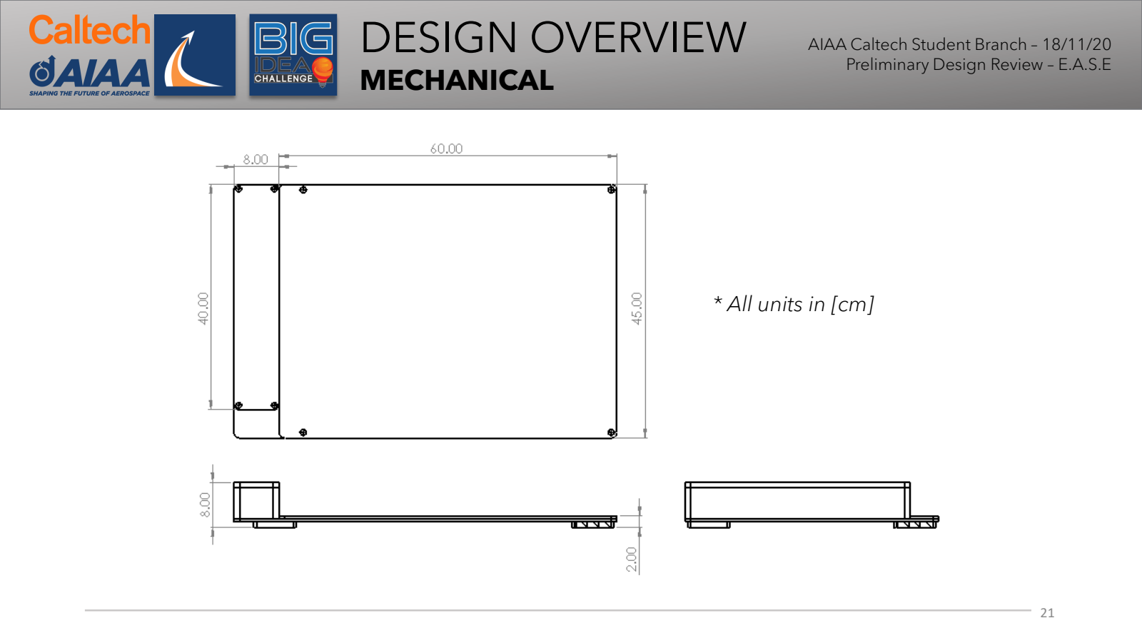
[picture p128: page 20]

AIAA Caltech Student Branch – 18/11/20 Preliminary Design Review – E.A.S.E

### * All units in [cm]

# DESIGN OVERVIEW

# MECHANICAL

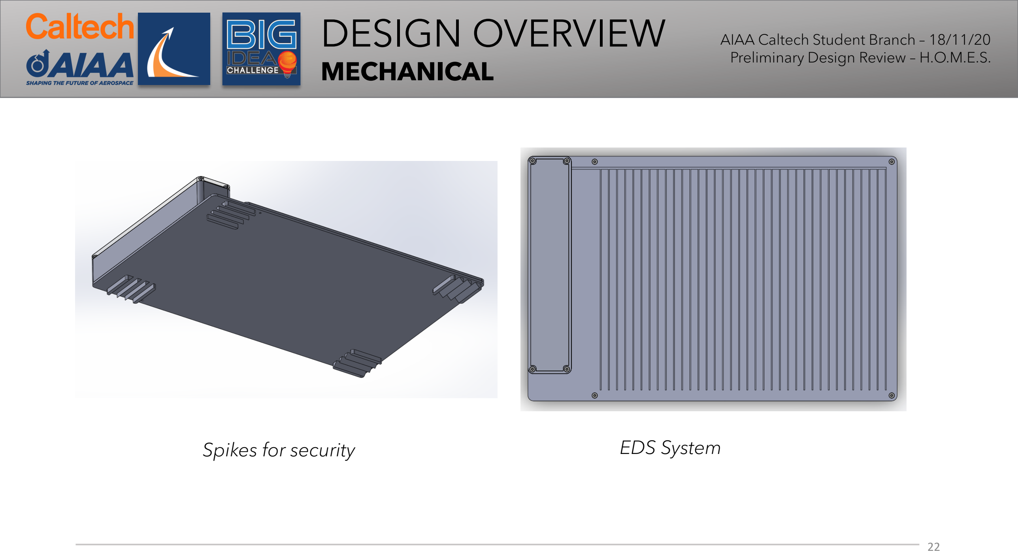
[picture p129: page 21]

AIAA Caltech Student Branch – 18/11/20 Preliminary Design Review – H.O.M.E.S.

Spikes for security | EDS System

# PANEL COMPOSITION

# MECHANICAL

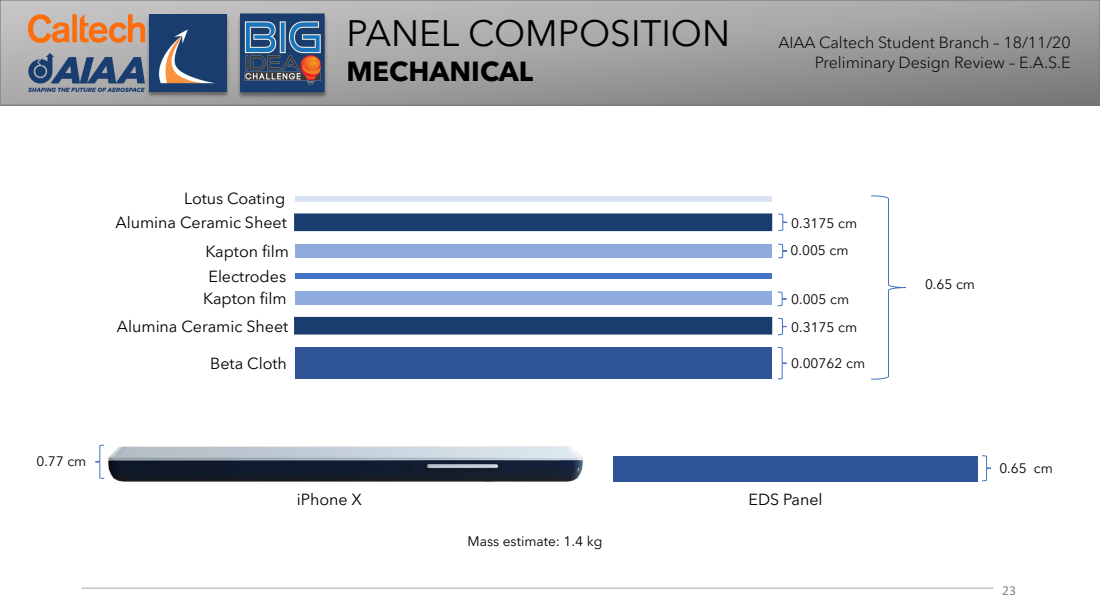
[picture p130: page 22]
Beta Cloth; Kapton film; Lotus Coating; Electrodes; iPhone X; EDS Panel

AIAA Caltech Student Branch – 18/11/20
Preliminary Design Review – E.A.S.E

Alumina Ceramic Sheet

Mass estimate: 1.4 kg

# MECHANICAL

# MATERIAL SELECTION

Preliminary Design Review – E.A.S.E.

| Alumina Ceramic | Bolt | Beta-cloth | Kapton
Density | 3.9 (g/cm³ ) | 8.0 (g/cm³ ) | 2.71 (10⁻³ g/cm² ) | 1.41 (g/cm³ )
Tensile Strength | 260 (MPa) | 482 (MPa) | 3,450 (MPa) | 230 (MPa)
Flexural Strength | 379 (MPa) | 290 (MPa) | 13.4 (MPa) | 120 (MPa)
Compressive Strength | 2,600 (MPa) | 170 (MPa) | 758 (MPa) | 172 (MPa)
Coefficient of Thermal Expansion | 8.6 (10⁻⁶ /ºC) | 10.3 (10⁻⁶ /ºC) | 9.3 (10⁻⁵ /ºC) | 8.1 (10⁻⁵ /ºC)
Dielectric Constant | 9.1 (at 1 MHz) | - | - | 5.42 (at MHz)
Dielectric Strength | 16.7 (kV/mm) | - | - | 217 (kV/mm)
Temperature Range | -273.15 – 1,750 (ºC) | -252 – 871 (ºC) | -73 – 260 (ºC) | -267 – 398 (ºC)

Note: we will also put LOTUS coating on the top layer of the alumina sheet and use Cicoil wires

Feasible by

analysis

and prior

implement

ations

# MECHANICAL

# MATERIAL SELECTION

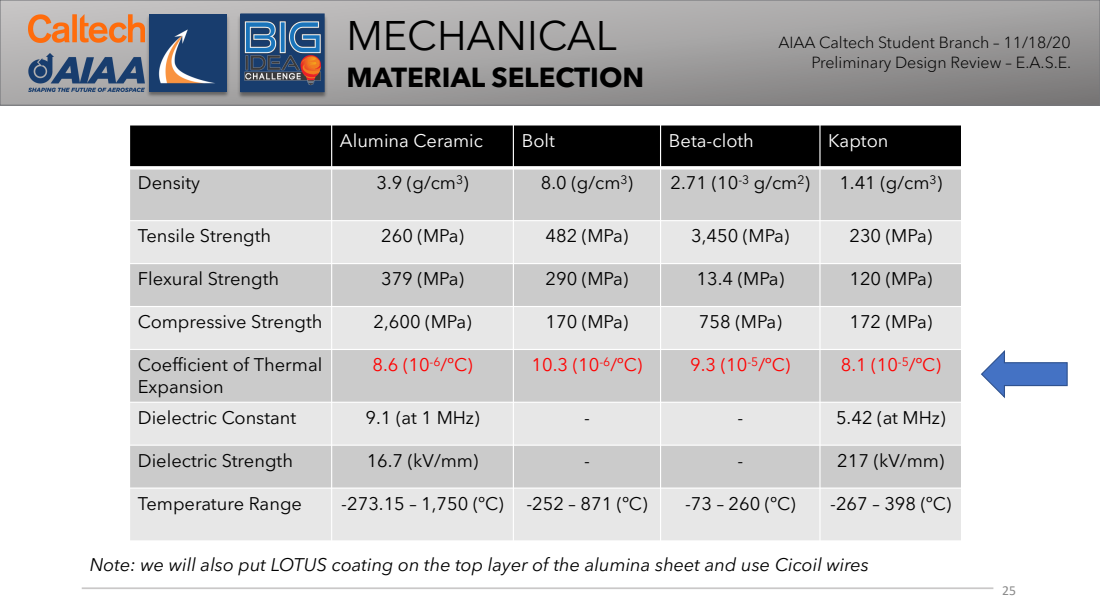
[picture p131: page 24]

Preliminary Design Review – E.A.S.E.

Alumina Ceramic | Bolt | Beta-cloth | Kapton

Density | 3.9 (g/cm³ ) | 8.0 (g/cm³ ) | 2.71 (10⁻³ g/cm² ) | 1.41 (g/cm³ )

Tensile Strength | 260 (MPa) | 482 (MPa) | 3,450 (MPa) | 230 (MPa)

Flexural Strength | 379 (MPa) | 290 (MPa) | 13.4 (MPa) | 120 (MPa)

Compressive Strength | 2,600 (MPa) | 170 (MPa) | 758 (MPa) | 172 (MPa)

Coefficient of Thermal Expansion | 8.6 (10⁻⁶ /ºC) | 10.3 (10⁻⁶ /ºC) | 9.3 (10⁻⁵ /ºC) | 8.1 (10⁻⁵ /ºC)

Dielectric Constant | 9.1 (at 1 MHz) | - | - | 5.42 (at MHz)

Dielectric Strength | 16.7 (kV/mm) | - | - | 217 (kV/mm)

Temperature Range | -273.15 – 1,750 (ºC) | -252 – 871 (ºC) | -73 – 260 (ºC) | -267 – 398 (ºC)

Note: we will also put LOTUS coating on the top layer of the alumina sheet and use Cicoil wires

# MECHANICAL

# MATERIAL SELECTION

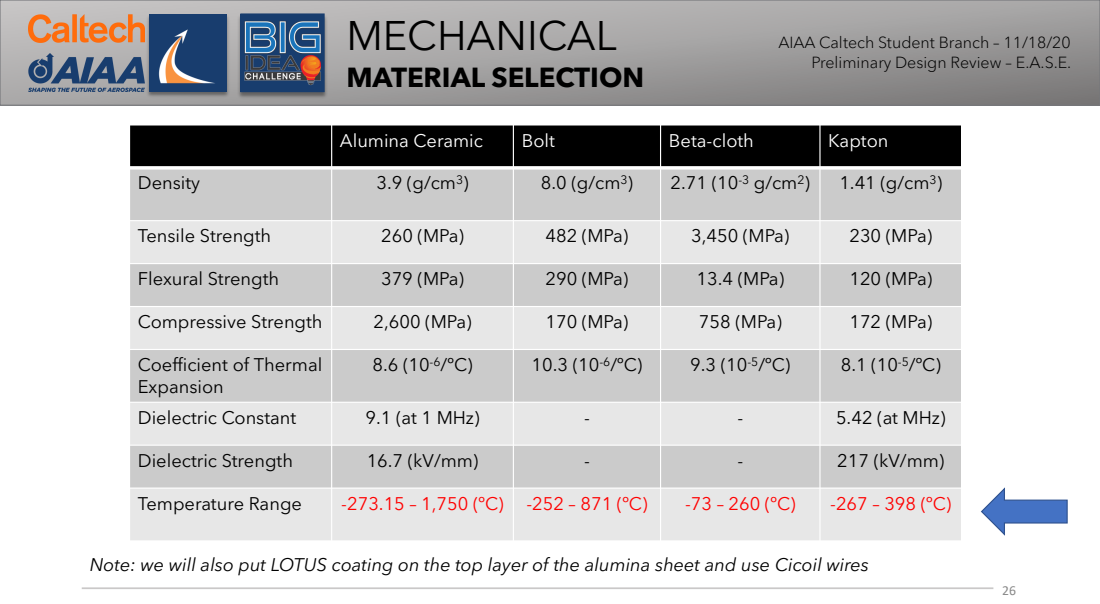
[picture p132: page 25]

Preliminary Design Review – E.A.S.E.

Alumina Ceramic | Bolt | Beta-cloth | Kapton

Density | 3.9 (g/cm³ ) | 8.0 (g/cm³ ) | 2.71 (10⁻³ g/cm² ) | 1.41 (g/cm³ )

Tensile Strength | 260 (MPa) | 482 (MPa) | 3,450 (MPa) | 230 (MPa)

Flexural Strength | 379 (MPa) | 290 (MPa) | 13.4 (MPa) | 120 (MPa)

Compressive Strength | 2,600 (MPa) | 170 (MPa) | 758 (MPa) | 172 (MPa)

Coefficient of Thermal Expansion | 8.6 (10⁻⁶ /ºC) | 10.3 (10⁻⁶ /ºC) | 9.3 (10⁻⁵ /ºC) | 8.1 (10⁻⁵ /ºC)

Dielectric Constant | 9.1 (at 1 MHz) | - | - | 5.42 (at MHz)

Dielectric Strength | 16.7 (kV/mm) | - | - | 217 (kV/mm)

Temperature Range | -273.15 – 1,750 (ºC) | -252 – 871 (ºC) | -73 – 260 (ºC) | -267 – 398 (ºC)

Note: we will also put LOTUS coating on the top layer of the alumina sheet and use Cicoil wires

# MECHANICAL

# MATERIAL SELECTION

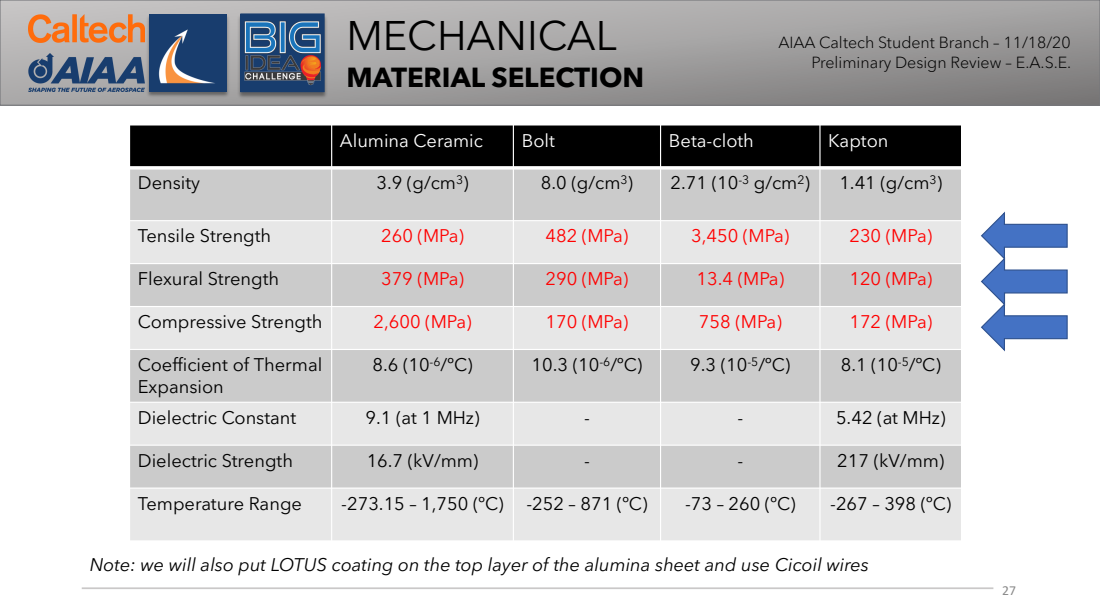
[picture p133: page 26]

Preliminary Design Review – E.A.S.E.

Alumina Ceramic | Bolt | Beta-cloth | Kapton

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

Tensile Strength | 260 (MPa) | 482 (MPa) | 3,450 (MPa) | 230 (MPa)

Flexural Strength | 379 (MPa) | 290 (MPa) | 13.4 (MPa) | 120 (MPa)

Compressive Strength | 2,600 (MPa) | 170 (MPa) | 758 (MPa) | 172 (MPa)

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

Dielectric Constant | 9.1 (at 1 MHz) | - | - | 5.42 (at MHz)

Dielectric Strength | 16.7 (kV/mm) | - | - | 217 (kV/mm)

Temperature Range | -273.15 – 1,750 (ºC) | -252 – 871 (ºC) | -73 – 260 (ºC) | -267 – 398 (ºC)

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

# MECHANICAL

# MANUFACTURING

AIAA Caltech Student Branch – 18/11/20 Preliminary Design Review – H.O.M.E.S.

### Top Plate: - 3-axis CNC milling - Outsource

- Order: grooves for EDS, screw holes, outer edge,

### countersink screw holes - Design considerations: 0.5 mm tolerance, space for Kapton, large external fillets Bottom Plate: - 3-axis CNC milling - Order: grooves for EDS, screw holes, tapping screw holes, outer edge - Design considerations: 0.5 mm tolerance, space for Kapton, large external fillets

AIAA Caltech Student Branch – 18/11/20 Preliminary Design Review – H.O.M.E.S.

### Electronics Box: - Tungsten inert gas welding: - Weld the sidewalls of the electronics box together - 3-axis CNC milling:

- Order: drill holes for mounting electronics on box,

### drill holes for mounting lid to box - Manually tap holds - Design considerations: 0.5 mm tolerance, large external and internal fillets

# MECHANICAL

# MANUFACTURING

# MISSION INTEGRATION

# CONCEPT OF OPERATIONS

Preliminary Design Review – E.A.S.E.


### Astronaut should ensure the surface is relatively flat and cleared

### Astronaut lays out E.A.S.E in front of the lunar habitat and connects it to power source

### Astronaut leaves and E.A.S.E enters rest mode until the pressure sensor is activated by the

weight of the astronaut again.

1

2

3

4


After moonwalk and sample collection,

### astronaut returns to stand on E.A.S.E, which senses the weight and begins attracting dust off the astronauts’ boots and repelling it off itself, cleaning the astronaut and itself

# MISSION INTEGRATION

# RISK ASSESEMENT

Preliminary Design Review – E.A.S.E.


# VERIFICATION

# TEST PROGRAM

# Goal: Validate to TLR4

### -All tests under thermal and vacuum conditions

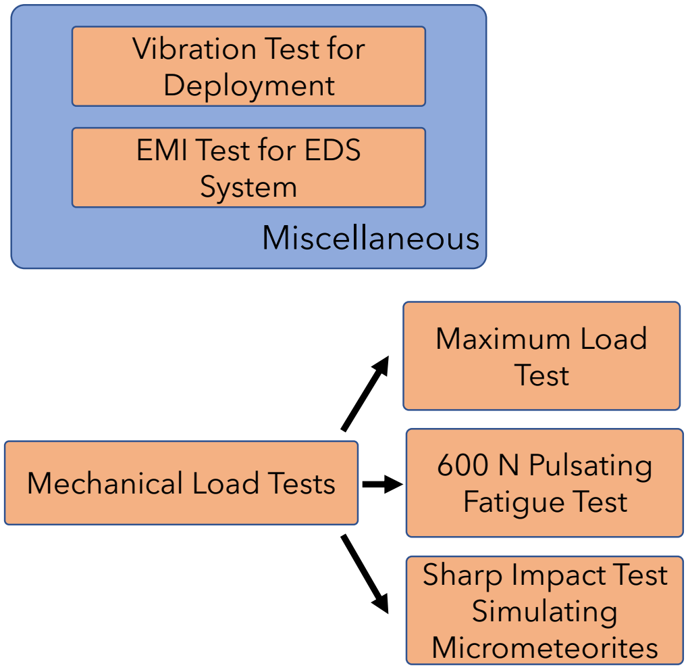
[picture p134: figure]
Vibration Test for Deployment; Mechanical Load Tests; 600 N Pulsating; Fatigue Test; Maximum Load Test; Sharp Impact Test Simulating Micrometeorites; EMI Test for EDS System

-Implement safety factor of 1.2 – 1.5 | Miscellaneous

Preliminary Design Review – E.A.S.E.

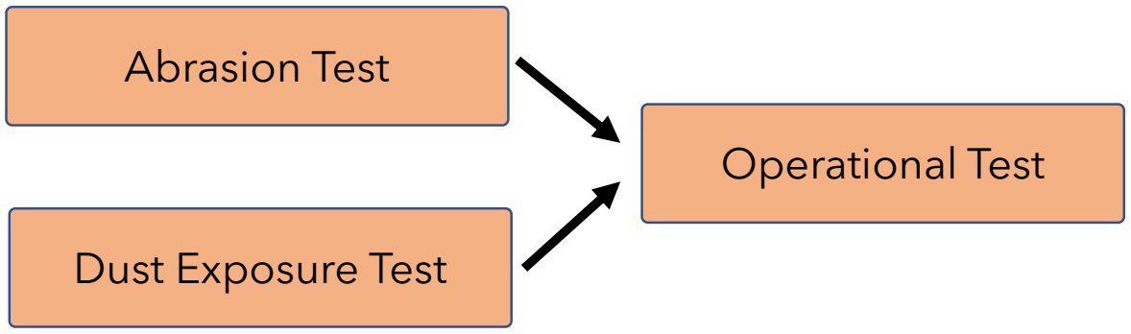
[picture p135: figure]
Operational Test; Abrasion Test; Dust Exposure Test

# VERIFICATION

# EQUIPMENT


### (Roy, 2008)

### Three-Body Abrasive Wear Test Rig

## - We will construct a vacuum chamber for our verification tests - Looking for resources for cryochamber - Lunar Simulant JSC-1A will be used for all verification tests - Similar compositional and mineralogical features to actual lunar regolith

Preliminary Design Review – E.A.S.E.

# [Logistics]

# [Budgeting and Limitations]

AIAA Caltech Student Branch – 18/11/20 Preliminary Design Review – H.O.M.E.S.

Raw Material Costs Est.

## - 4 prototypes without EDS System - 1 complete prototype - Costs will increase if a need for iteration arises

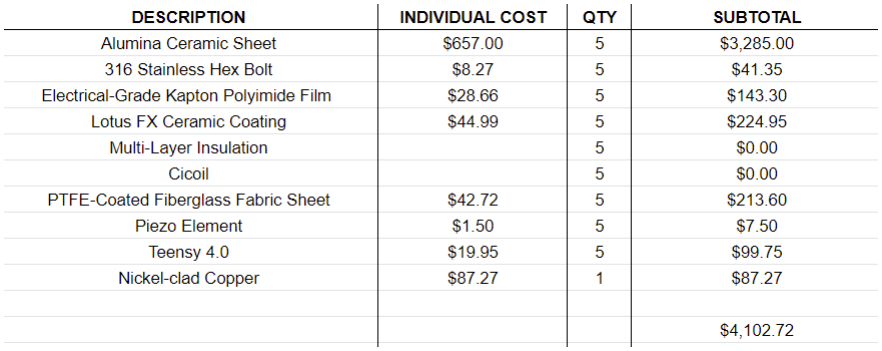
[picture p136: figure]

Note: Does not include machining or circuit component costs

# CONCLUSION

# FEASABILITY REVIEW

Preliminary Design Review – E.A.S.E.

Function / Characteristic | Solution | Feasible?
Transport dust | EDS | YES
Touch-free operation | Piezoelectric transducer | YES
Rugged housing | Ceramic & Beta-cloth | YES
