caltechcaos/Lunar-Dust-Challenge/E100/Week 3 Progress Report/Kaila_Week3.pptx

VERIFICATION
Long Term Effectiveness Rig

- UPDATE: Realized last week that there needs to be some extreme modifications to original LTE design
- PROGRESS: Came up with design for bringing dust up
- ISSUES: Still need to finalize entire design (with sieving machine) and determine parts - sets completion of rig back a few weeks

Kaila
4/16/21

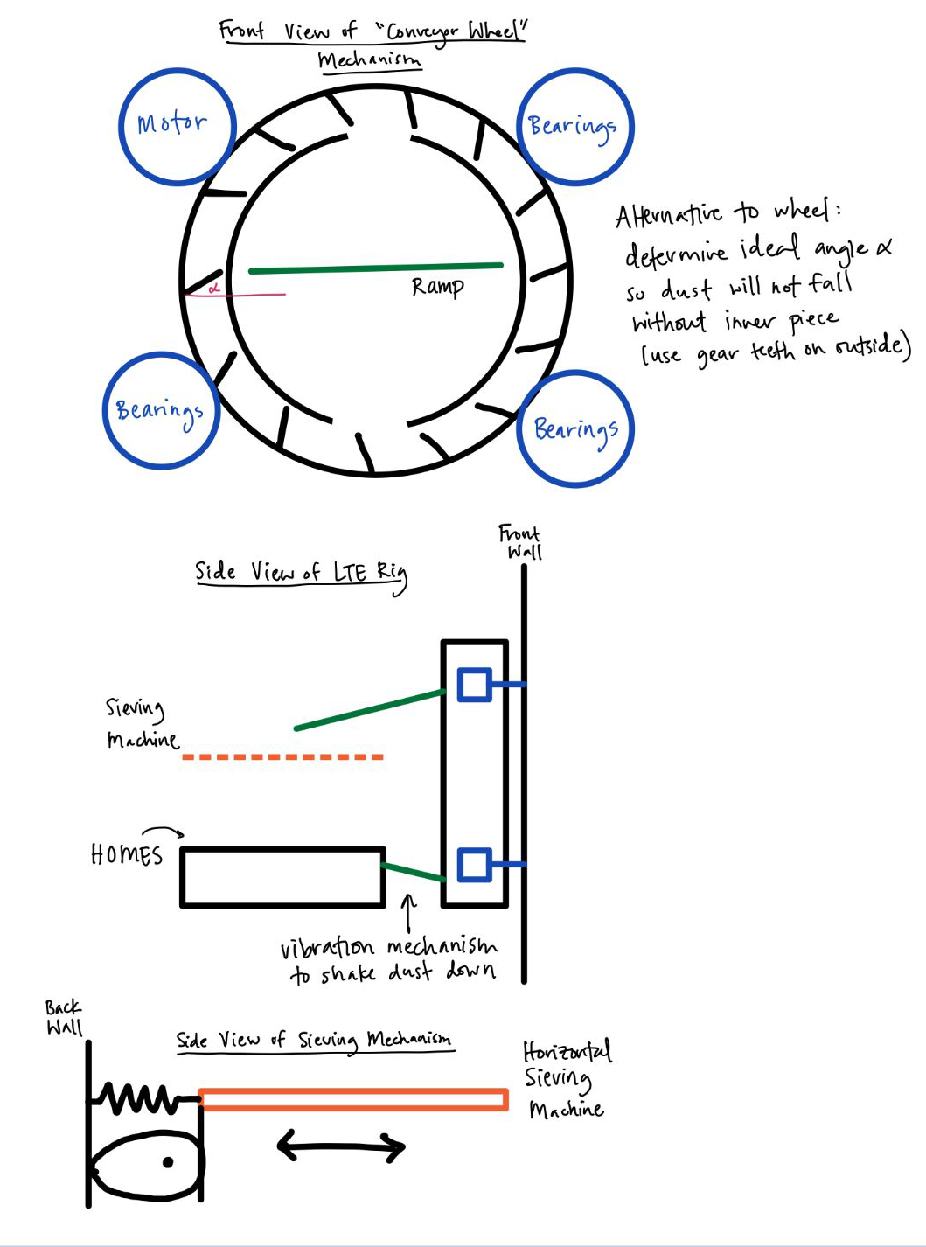
[picture p137: figure]
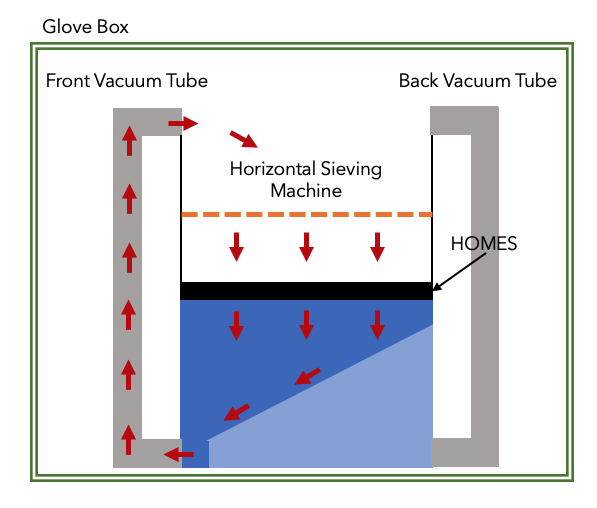
[picture p138: figure]

Original Plan:


New Plan:

Big Idea | NASA's Breakthrough, Innovative, and Game-changing (BIG) Idea Challenge

## Color palette RGB values

Main color palette:
Blue: R=26 G=116 B=186
Dark grey: R=58 G=58 B=60
Orange: R=255 G=108 B=12
Secondary color palette:
Light grey: R=153 G=153 B=153
Yellow: R=255 G=198 B=11
