caltechcaos/Lunar-Dust-Challenge/E100/Week 3 Progress Report/Kolli_4-16-21.pptx

Catalyst:
- Looked into four different potential catalysts for our adhesive (STYCAST 2850FT) and compared specs of each
- Chose STYCAST 23LV based off of electrical and thermal properties
- Found a website to order catalyst through

MECHANICAL
Panel Materials

04/16/21
Athena Kolli

Silicone:
- Found a set of Silicones that are NASA low outgassing approved
- Looked through TDSs for all of the silicones and chose two front runners based off of electrical and physical properties
  - MS 921-LO
  - MS 922-LO
Next Steps:
- Decide if/where we will use Silicone in our design (in panel or e-box)
- If yes, decide between the two front runners and order
