caltechcaos/Lunar-Dust-Challenge/E100/Week 3 Progress Report/New design - slide template.pptx

[SUB TEAM]
[TASK]

[Team members on task]
##/##/21

Header 1
Header 2
Header 3
Body
Note

Big Idea | NASA's Breakthrough, Innovative, and Game-changing (BIG) Idea Challenge

## Color palette RGB values

Main color palette:
Blue: R=26 G=116 B=186
Dark grey: R=58 G=58 B=60
Orange: R=255 G=108 B=12
Secondary color palette:
Light grey: R=153 G=153 B=153
Yellow: R=255 G=198 B=11
