caltechcaos/Lunar-Dust-Challenge/E100/Week 3 Progress Report/Richardson_4-16-21.pptx

Verification
2.23- Long Life Thermal Test

Sydney
04/16/21

Quotes
- NTS- $40500
- Oneida- bumped
- Grays- bumped

Test Outline
Testing one panel, -170℃ to +130℃, air-to-air or liquid-to-liquid, 30 exposures then start-up and shut-down electronics 15 times, 5-10 minute dwell time, 189 cycles total

Big Idea | NASA's Breakthrough, Innovative, and Game-changing (BIG) Idea Challenge
