caltechcaos/Lunar-Dust-Challenge/E100/Week 3 Progress Report/soldner_4-16-21.pptx

MECHANICAL
Overview and General Action Items

Leah Soldner
04/16/21

- This week:
  - Meeting with Keith Novak on Tuesday for electronics box
  - “Meeting” with Mark Vidaic from Ceramic Products on Thursday
  - Discussion and decision to consider shrinking panel size
- Action Items:
  - Safety procedures sheet
  - Complete design for electronics box and start prototyping
  - Make decision about panel size
  - Order top and bottom plate!!!

Big Idea | NASA's Breakthrough, Innovative, and Game-changing (BIG) Idea Challenge

## Slide 2

MECHANICAL
Design Revision: Shrinking Panel Size

Leah Soldner
04/16/21

- Pros:
  - Less likely to crack or bend under load
  - Easier to machine
  - Makes EDS system easier
  - Makes modularity more accessible
  - For proof-of-concept, we don’t need panels this big
  - Overall: simplifies our job on all fronts (electrical and manufacturing)
- Cons:
  - Wrote in our proposal that we would make panels 25 cm^2
  - Our astronaut boot use case won’t be “one foot per panel” anymore
  - Maybe there is a solution that is feasible, and we could keep original panel size? (see Tanmay’s slides)
  - Increases stress points and connections where things can go wrong
  - Putting more together is finicky
