caltechcaos/Lunar-Dust-Challenge/Current/Mechanical/v4_Eggdee/5.15_3pt_Bend/sim_report.docx

DISPLACEMENT:

Min: 4.989e-01

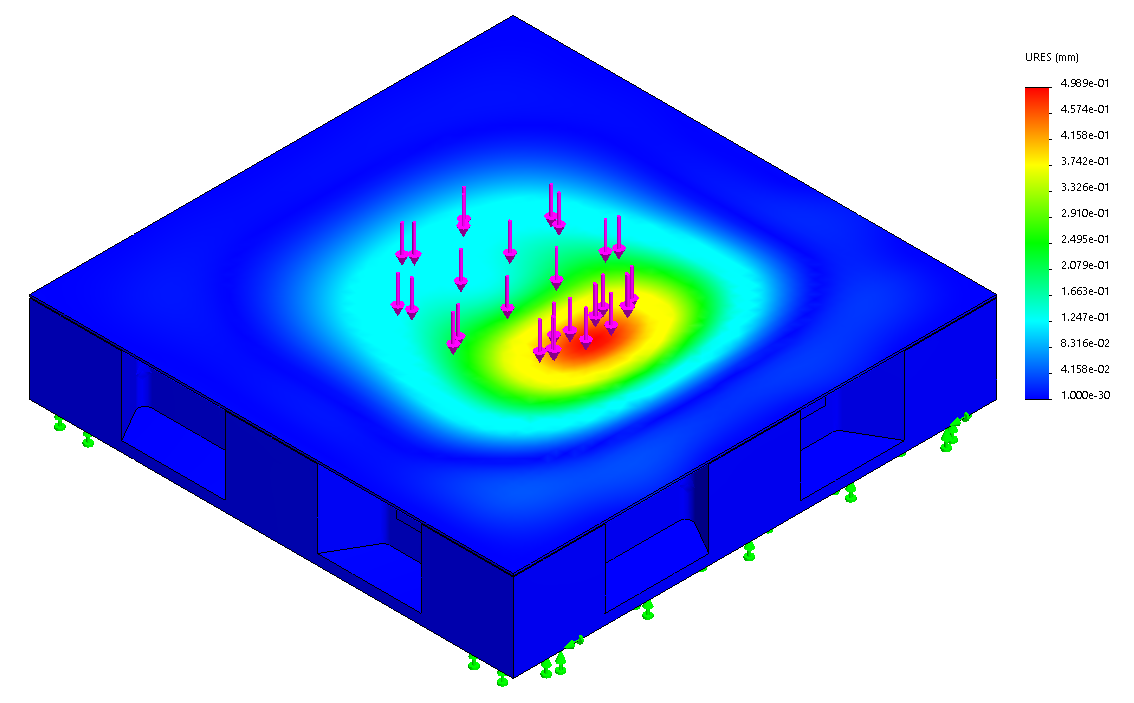
[picture p139: figure]
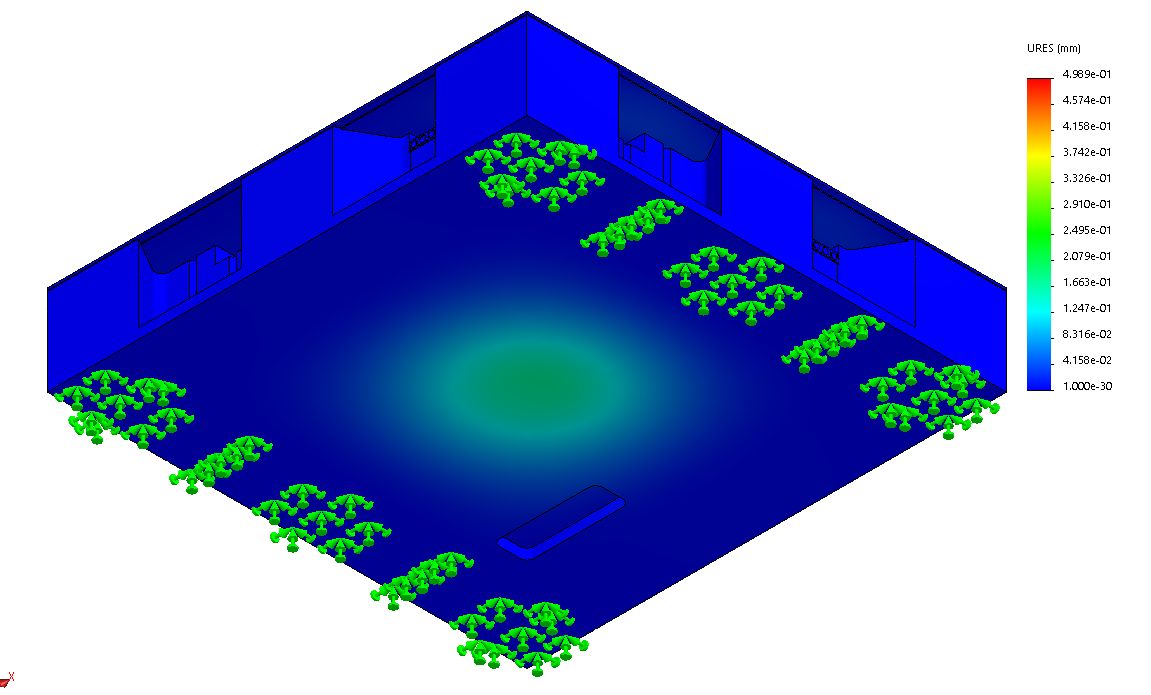
[picture p140: figure]
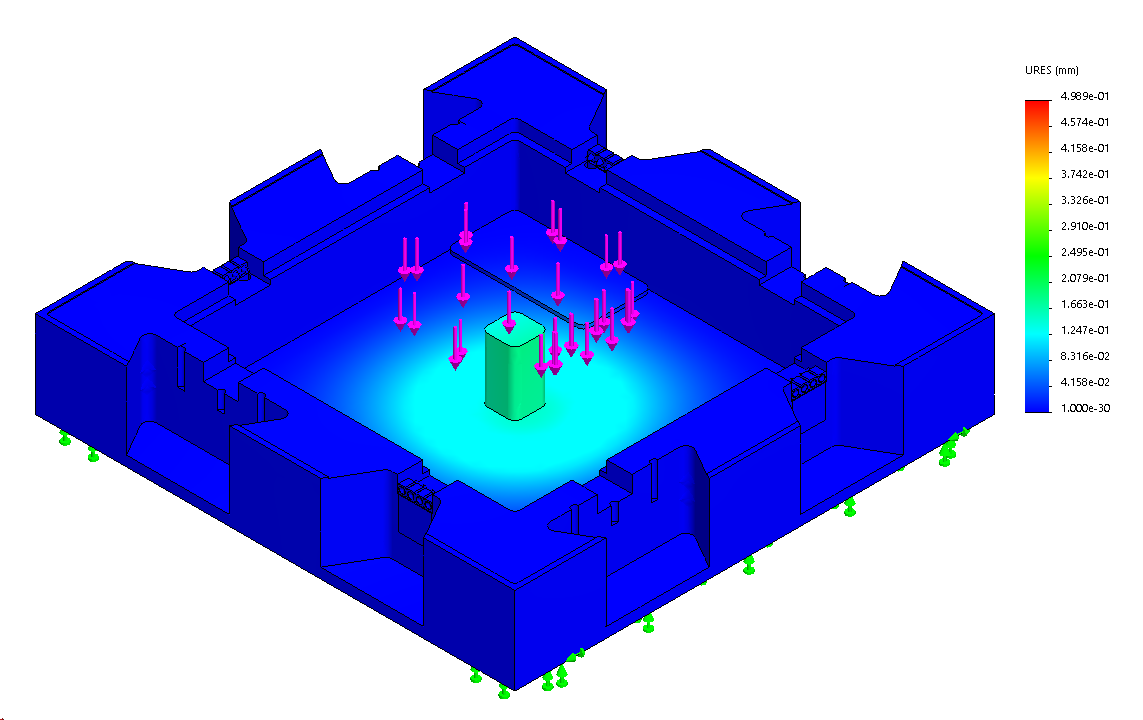
[picture p141: figure]

FACTOR OF SAFETY:

Min: 3.918e-01

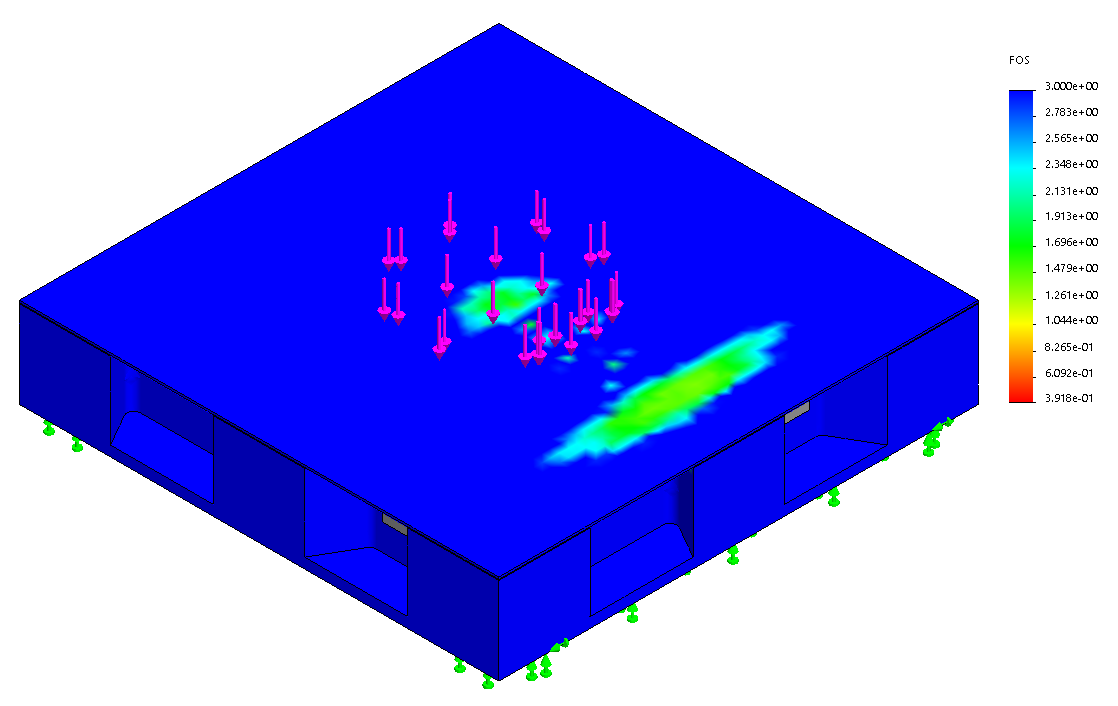
[picture p142: figure]
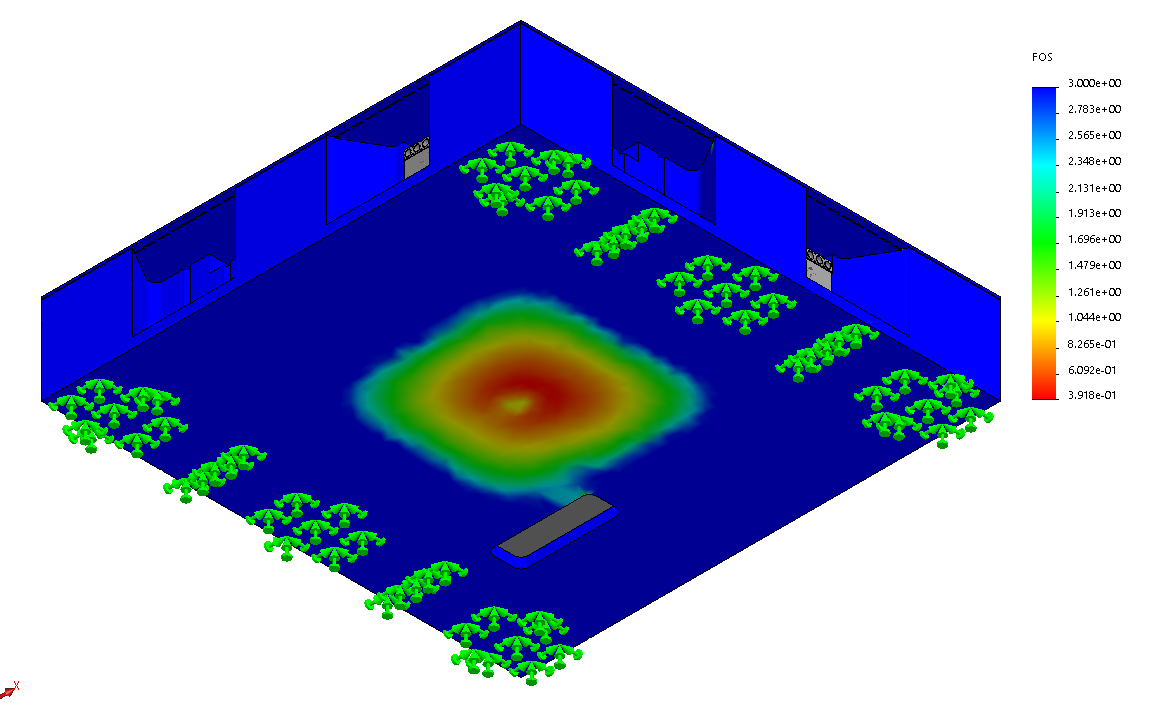
[picture p143: figure]
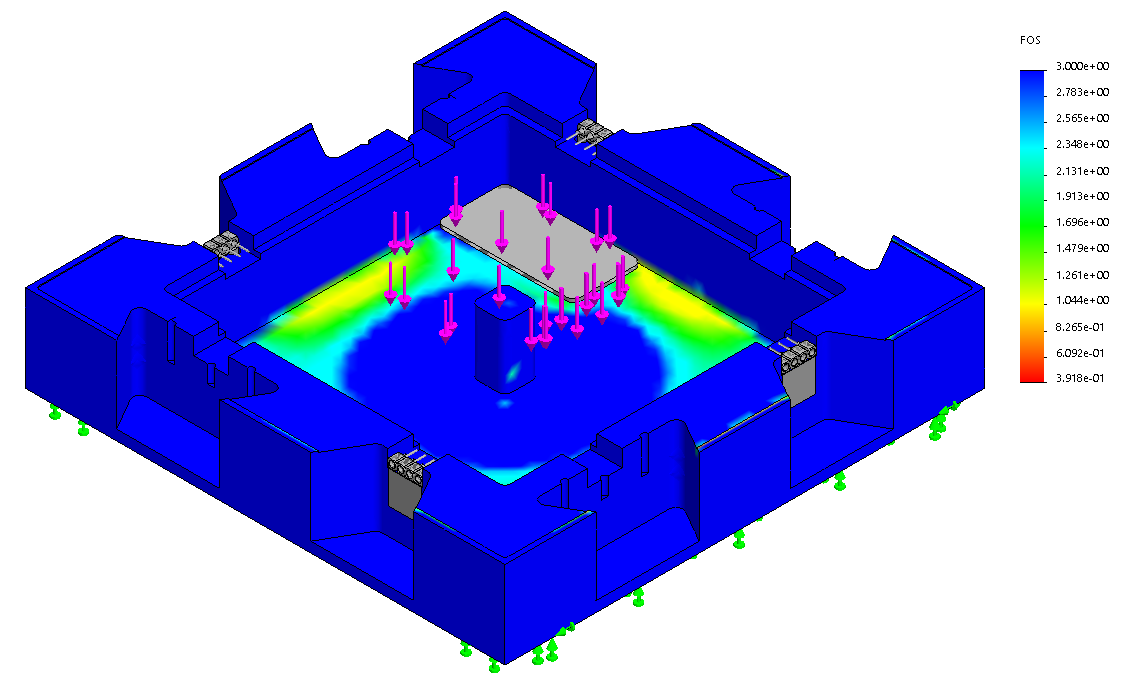
[picture p144: figure]
