caltechcaos/Lunar-Dust-Challenge/PDR/PDR Presentation/FEA_slides.pptx

LOAD VALIDATION
FEA ANALYSIS

AIAA Caltech Student Branch – 11/181/20
Preliminary Design Review – EASE

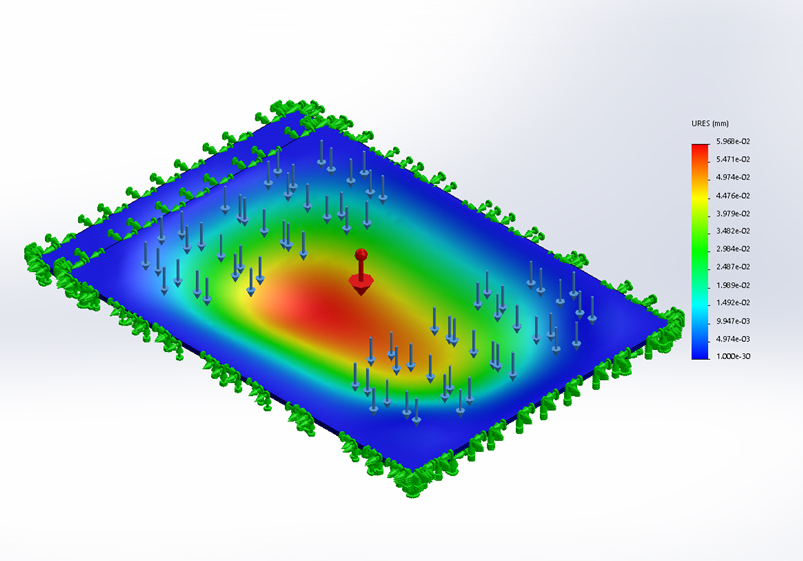
[picture p145: figure]

Displacement Plot

Maximum Displacement: 0.0597 mm

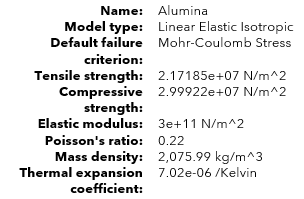
[picture p146: figure]

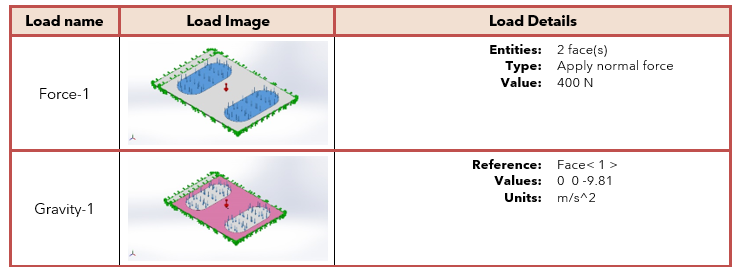
[picture p147: figure]

## Slide 2

LOAD VALIDATION
FEA ANALYSIS

AIAA Caltech Student Branch – 11/181/20
Preliminary Design Review – EASE

Factor of Safety Plot

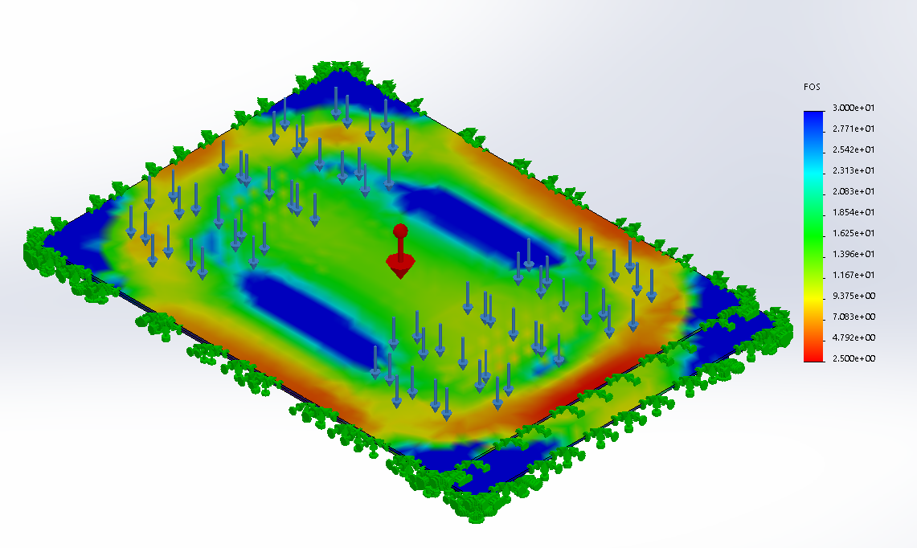
[picture p148: figure]

Minimum FOS: 2.67
(Load includes a 1.5 FOS already, so there is room for mass reduction)
