caltechcaos/Lunar-Dust-Challenge/PDR/PDR Presentation/PDR Info Slide Template.pptx

[SUB TEAM]
[TASK]

##/##/21

[Team members on task]

Header 1
Header 2
Header 3
Body
Note
