caltechcaos/Lunar-Dust-Challenge/Archived/PDR/PDR Presentation/EASE PDR FINAL V2.pdf

# EASE

# Electrodynamic Dust Shielding Activated Surface Emitter


AIAA Caltech Student Branch – 18/11/20 Advisor: Dr. Soon-Jo Chung


# Preliminary Design Review

# INTRODUCTION

# ROADMAP

AIAA Caltech Student Branch – 11/18/20 EASE Preliminary Design Review

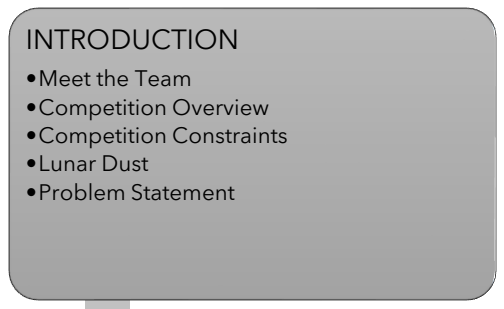
[picture p149: figure]
INTRODUCTION; •Meet the Team •Competition Overview •Competition Constraints •Lunar Dust •Problem Statement
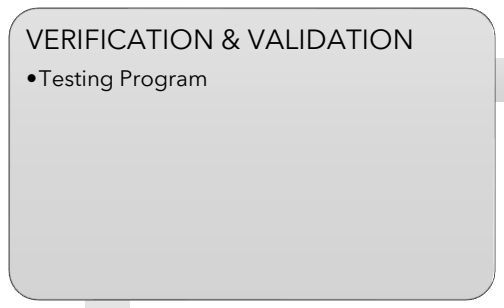
[picture p150: figure]
VERIFICATION & VALIDATION; •Testing Program
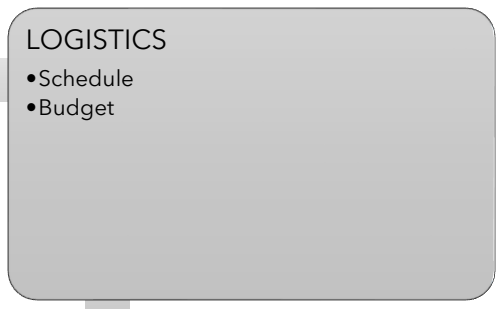
[picture p151: figure]
LOGISTICS; •Schedule •Budget
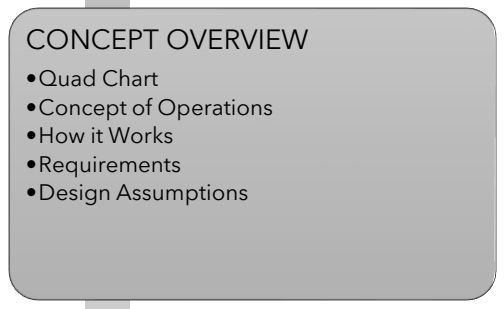
[picture p152: figure]
CONCEPT OVERVIEW; •Quad Chart •Concept of Operations •How it Works •Requirements •Design Assumptions
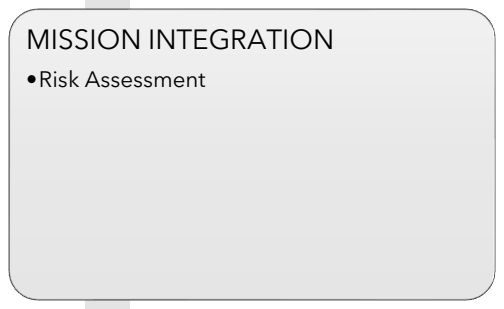
[picture p153: figure]
MISSION INTEGRATION; •Risk Assessment
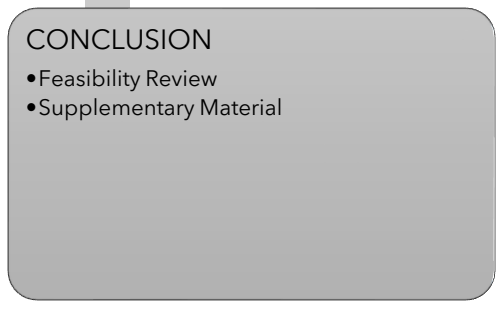
[picture p154: figure]
CONCLUSION; •Feasibility Review •Supplementary Material
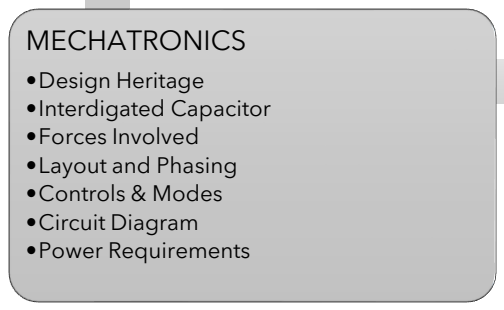
[picture p155: figure]
MECHATRONICS; •Design Heritage •Interdigated Capacitor •Forces Involved •Layout and Phasing •Controls & Modes •Circuit Diagram •Power Requirements
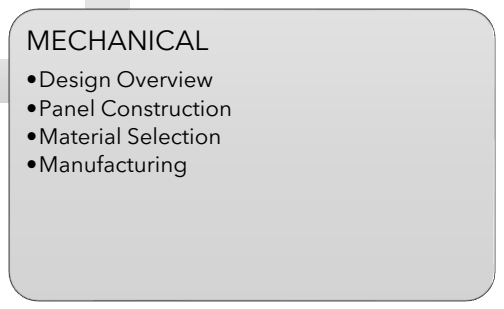
[picture p156: figure]
MECHANICAL; •Design Overview •Panel Construction •Material Selection •Manufacturing

# INTRODUCTION

# MEET THE TEAM

# Leadership

# Branch Lead

### Luis Pabon

MCE & Aero, ’22
Houston, TX

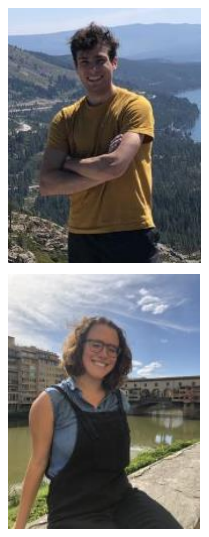
[picture p157: figure]

# Project Lead

### Malcolm Tisdale

MCE & CDS, ‘22

# Ops. Lead

### Isabella Dula

MCE & , ‘22

# Mechanical

# Mechatronics

# Mission Integration

Lead
Polina
Verkhovodova
MCE & Pl, ’22
Pasadena, CA

Lead
Leah Soldner
MCE , ’24
S Pasadena,
CA

Tanmay
Gupta
MCE , ’24
Ph / Astro
Kuala Lumpur,
Malaysia

Nathan Ng
MCE , ’24
Santa Clara,
CA

Lead
Calle Junker
MCE, ’23
Aztec, NM

Athena Kolli
MCE , ’24
Buffalo Grove,
IL

Kaila
Coimbra
MCE , ’23
San Diego,
CA

Rithvik
Musuku
MCE , ’24
Gilbert, AZ

Parul Singh
MCE , ’24
Tallahasee, FL

Kemal
Pulungan
MCE , ’24
Troy, NY

Jules Penot
MCE & Aero , ’24
Valbonne, France

# Advisor

### Dr. Soon-Jo Chung

Lead
Isabella
Dula

EASE Preliminary Design Review

# INTRODUCTION

# COMPETITION OVERVIEW

# Artemis Missions – Feet on the moon by 2024 &

# sustainable missions by 2028. NASA BIG Idea Challenge Finalists implemented 2026

- University teams of 5 – 25 students
- Teams submit proposals (Dec 13th 2020) for funding to develop concepts for technical paper and BIG Idea Forum (Nov 15th 2021)
- Awards from $50,000 - $180,00

## Landing Dust Prevention &

Mitigation - to preclude

or protect from plume/surface interactions which may result in damaged landers and
nearby surface assets

## Spacesuit Dust Tolerance & Mitigation – to limit

dust adherence to spacesuits and other damaging effects to its subsystems

## Exterior Dust

Prevention,

## Tolerance, & Mitigation – to protect

lunar surface systems or
preclude dust from entering habitats and landers

## Cabin Dust Tolerance & Mitigation - to clean

habitable volumes and their interior surfaces, which helps prevent dust from making it back to Gateway and Orion
when the lander returns to lunar orbit from the surface

EASE Preliminary Design Review

# INTRODUCTION

# COMPETITION CONSTRAINTS

# Constraints

- Able to manage or mitigate lunar dust (~0.5-100 um)
- Minimal barrier to NASA adoption
- Cost, power, mass, size …
- Minimum Technological Readiness Level 4 (->5)
- Lifespan of 15 - 30 years
- Removes dust “in minutes”
- Lunar environmental conditions
- South pole temperatures between -232C and -49C
- Permanently shadowed craters as low as -243C


# Considerations


- Aiming for 2026 deployment in lunar missions
- Simplicity of operation and maintenance
- Deployment method from NASA or commercial surface lander
- Effective packaging for launch and Moon landing
- Credible fabrication and material selection

Lunar Dust
Particle

Gene Cernan
covered in lunar
dust

EASE Preliminary Design Review

# INTRODUCTION

# LUNAR DUST

# Issues Posed

- Vision obscuration
- False instrument readings
- Dust coating and contamination
- Seal failures
- Abrasion of materials
- Inhalation and irritation risks
- Loss of foot traction

# Dust Properties


PROPERTY | VALUE | UNITS
Size range | 4 to 500 | [nm] – [um]
Volume fraction | < 0.2 | %
Relative permittivity | 3 - 4
Relative permeability | ~ 1
Specific gravity | ~ 3 | [g * cm^-3]
Charge | 10^-11 to 10^-13 | [C / kg]
- Charged through solar
emissions
- Trace magnetic elements
- 90% Silicate/Aluminosilicate minerals by volume
- Highly irregular and sharp
- Charge density increases with particle size

EASE Preliminary Design Review

# INTRODUCTION

# PROBLEM STATEMENT

# Problems Caused By Spacesuit

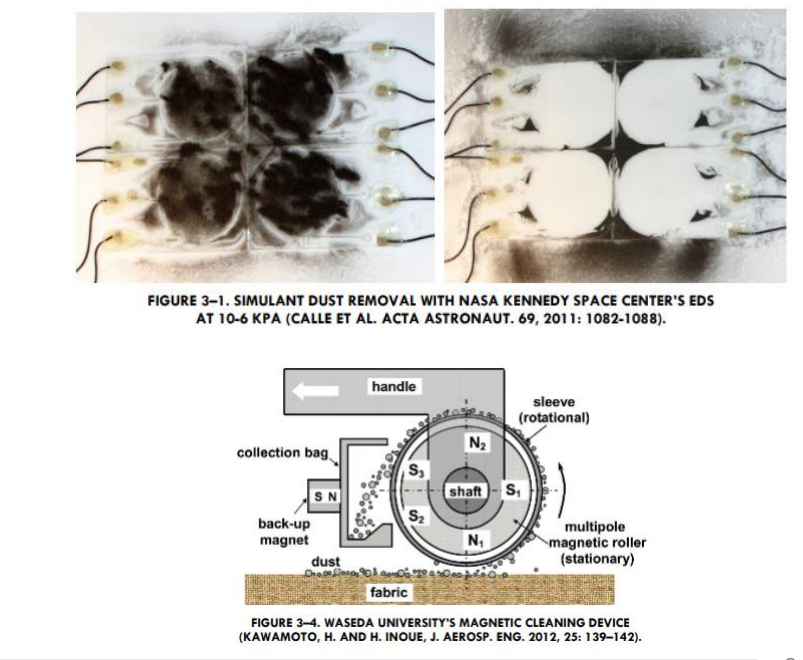
[picture p158: figure]

# Dust Ingress Into Habitable Volumes

## - Increased loads on in-cabin dust mitigation technologies - Incorrect readings during in-cabin experiments - Performance reduction and possible failure of in-cabin equipment - Astronaut health risks - Dust brought to Gateway and Orion when lander returns to lunar orbit

# Existing Solutions

EASE Preliminary Design Review

# CONCEPT OVERVIEW

# QUAD CHART

Leverages 50-year-old dust mitigation technology currently being tested on ISS
- 3-Phase traveling square wave pushes dust particles off astronaut boots and EASE
- Touch-free operation using piezoelectric pressure sensors in mat
- Extensive validation and verification program though

# Objective:


Approach: | Key Milestones:
- Minimize dust ingress into lunar habitat module on astronaut boots
- Increases traction of astronaut boots
- EASE is portable, durable, low SWaPs device
- Clears lunar dust from astronaut boots in < 2 mins and self cleaning
- Increases the state-of-the-art:
- Largest, most compact, and durable implementation of electrodynamic shielding technology
- Develop and validate to TRL 5

### Render of EASE

Mass Estimate: 1.4 kg | Power Estimate: 10 W max
Description | TRL | Deadline
Preliminary Design Review | 2 | 11/18/20
Proposal | 3 | 12/13/20
Functional Prototype | 3 | 4/1/21
Midpoint Report | 4 | 5/20/21
Technical Paper & Verification Demonstration | 5 | 10/27/21

EASE Preliminary Design Review

# CONCEPT OVERVIEW

# CONCEPT OF OPERATIONS


### Astronaut should ensure the surface is relatively flat and cleared

### Astronaut lays out E.A.S.E in front of the lunar habitat and connects it to power source

### Astronaut leaves and E.A.S.E enters standby mode until the pressure sensor is activated by

the weight of the astronaut again.

1

2

3

4


After moonwalk and sample collection,

### astronaut returns to stand on E.A.S.E, which senses the weight and begins attracting dust off the astronauts’ boots and repelling it off itself, cleaning the astronaut and itself

EASE Preliminary Design Review

# CONCEPT OVERVIEW

# REQUIREMENTS

Functional Requirements | Description
FR 1.0 | Remove 90% of dust from astronaut boots during cleaning period
FR 2.0 | Self-cleaning after astronaut departure
FR 3.0 | Minimum 15-year lifetime on lunar surface
FR 4.0 | Capable of enduring forces involved in launch and landing
FR 5.0 | Capable of enduring repeated impacts without loss in performance

EASE Preliminary Design Review

# CONCEPT OVERVIEW

# DESIGN ASSUMPTIONS

Design Assumption | Description
DA 1.0 | EASE placed on 1 m x 1 m cleared and leveled area of regolith
DA 2.0 | 28 V DC power supplied by lunar habitats and landers
DA 3.0 | Lunar regolith compresses under load of mat and astronaut
DA 4.0 | Disregard off nominal solar activity
DA 5.0 | No more than one astronaut at a time maximum load

EASE Preliminary Design Review

# EDS OVERVIEW

# DESIGN HERITAGE

- Parent technology developed in 1970s - Lifts and transports charged and uncharged particles using electrostatic and dielectrophoretic forces - Works best for particle size regimes of 5-300 µm (encompasses size regime for lunar dust particles) - Technology currently being used in: - Solar panel maintenance (dust removal efficiency

of 90%)

## - Tested in mock lunar environments - In-Situ Experiments on ISS on thermal radiators and solar panels - Ongoing; showed that EDS works in vacuum - Solar panel effectiveness 22.5%→98.4% after EDS implementation with lunar simulant


Demonstration of EDS on a glass plate; particle size < 20 µm (Guo, 2018)

# Electrodynamic Dust Shielding


EDS
System
mounted
on sim.
Lunar
habitat

EASE Preliminary Design Review

# EDS OVERVIEW

# INTERDIGATED CAPACITOR

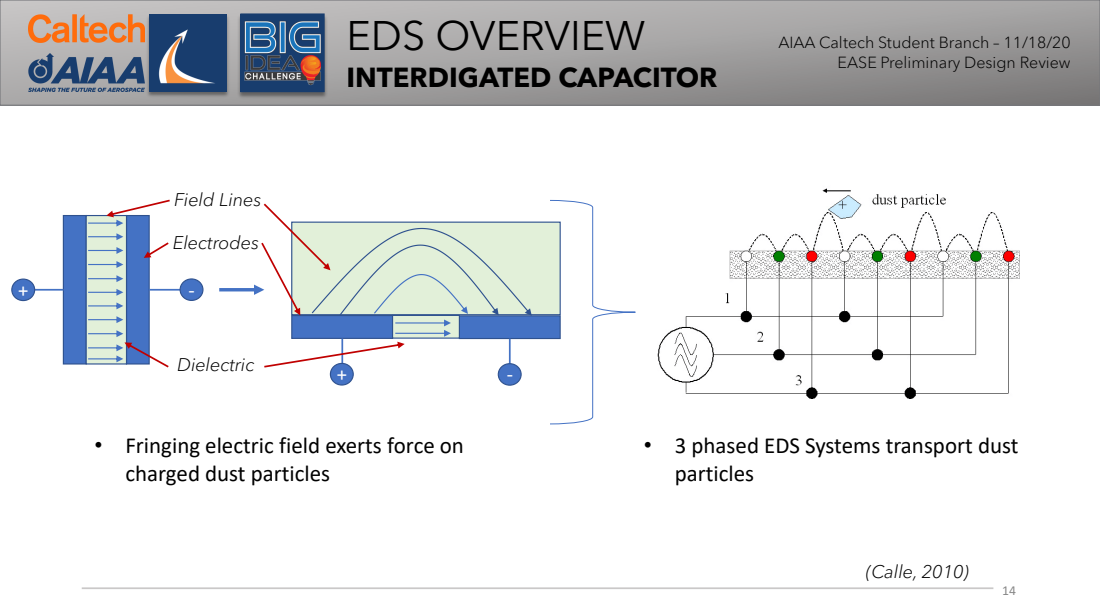
[picture p159: page 13]
Electrodes; Dielectric; Field Lines; (Calle, 2010)

EASE Preliminary Design Review

• Fringing electric field exerts force on
charged dust particles

• 3 phased EDS Systems transport dust
particles

# EDS OVERVIEW

# FORCES INVOLVED

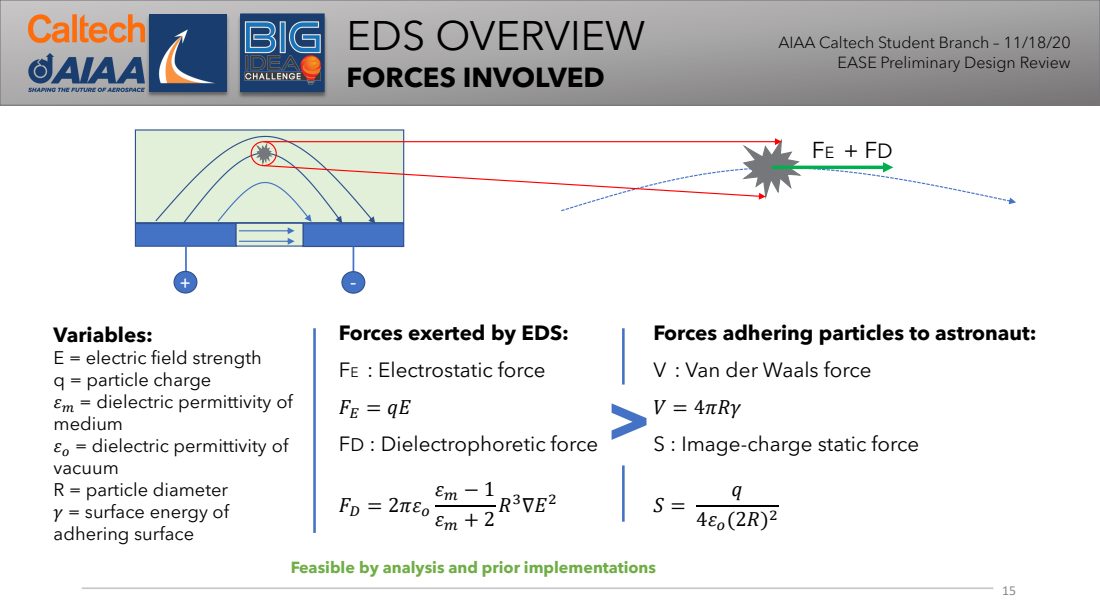
[picture p160: page 14]
FD = 2πεo

EASE Preliminary Design Review

Forces exerted by EDS:
FE : Electrostatic force
FD : Dielectrophoretic force

Forces adhering particles to astronaut:
V : Van der Waals force
V = 4πRγ
S : Image-charge static force

Variables:
E = electric field strength
q = particle charge
εm = dielectric permittivity of
medium
εo = dielectric permittivity of
vacuum
R = particle diameter
γ = surface energy of
adhering surface

Feasible by analysis and prior implementations

# MECHATRONICS

# LAYOUT AND PHASING

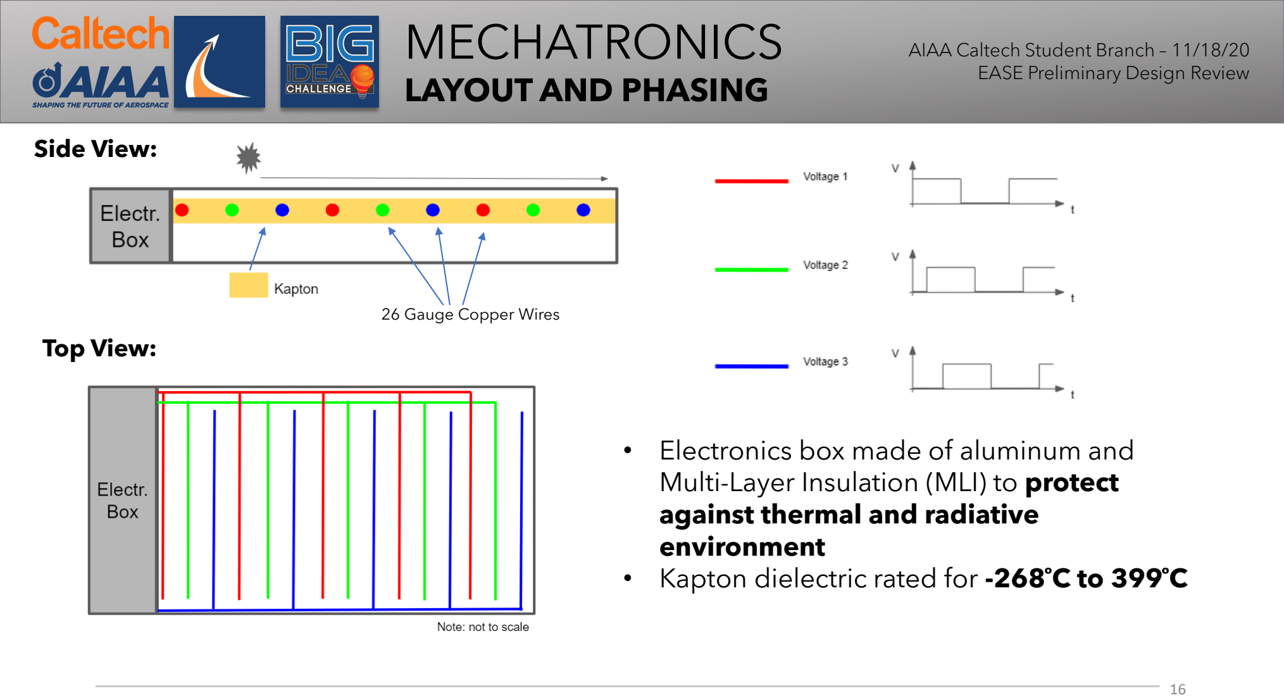
[picture p161: page 15]

### Side View:

### Top View:

26 Gauge Copper Wires

## - Electronics box made of aluminum and Multi-Layer Insulation (MLI) to protect against thermal and radiative environment - Kapton dielectric rated for -268 ̊C to 399 ̊C

EASE Preliminary Design Review

# MECHATRONICS

# CONTROLS & MODES

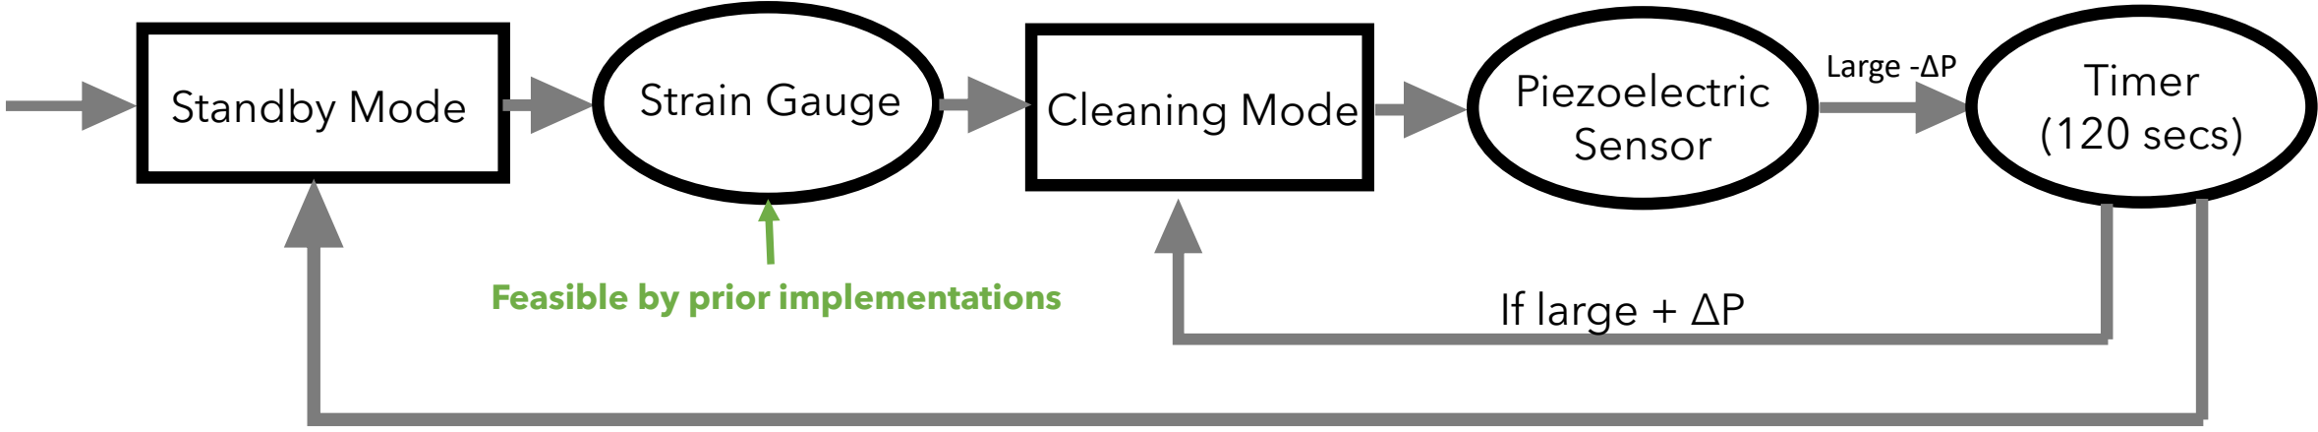
[picture p162: figure]
(120 secs); Large -ΔP; If large + ΔP; Piezoelectric Sensor; Feasible by prior implementations

# Operational Modes Standby Mode: awaiting use, sensors are active

Cleaning Mode: capacitors are charged, suit is cleaned,

# dust removed from mat

Standby Mode | Strain Gauge | Cleaning Mode | Timer EASE Preliminary Design Review

# MECHATRONICS

# CIRCUIT DIAGRAM

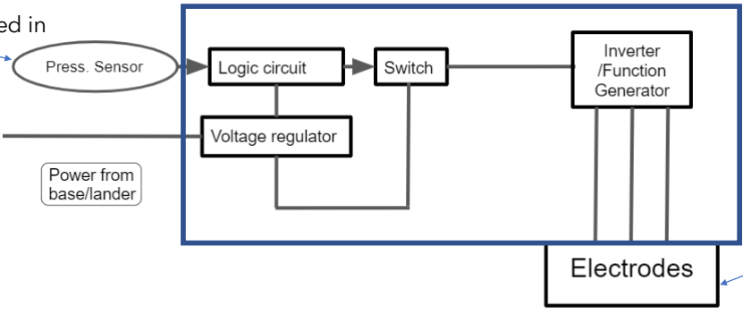
[picture p163: figure]

Sensors and components to be selected/designed from existing NASA satellite and spacecraft payloads.

## Components contained in electronics box

## Embedded in mat

## Embedded in mat

EASE Preliminary Design Review

# - Estimates based on finite difference time domain electrostatic simulation

- Obtained mesh grid of electric field strength given electrode lay-out and voltage supply

### - Determined electromagnetic field strength necessary to overcome adhesive forces

### - Current estimates predict EASE will have low power requirements

# MECHATRONICS

# POWER REQUIREMENTS

Operational Mode | Time Estimate | Voltage (DC) | Power Requirements (W)
CLEANING | 3 min/astronaut | 28 V | 10 W
STANDBY | VARIABLE | 28 V | <100 mW

Feasible by analysis and prior implementations

EASE Preliminary Design Review

# DESIGN OVERVIEW

# MECHANICAL

## Objectives: - Strong enough to sustain weight - Easy to transport and use - Large enough size to comfortably use - Optimized for weight and volume - Electronics are secured and protected - Cost-effective solution - Protected from the harsh lunar environment

- Use for 15-30 years.

EASE Preliminary Design Review


# DESIGN OVERVIEW

# MECHANICAL

Metric | Weight | Single Panel | Single Fold Accordion
Use with EDS | 10 | 9 | 5
Robustness | 30 | 25 | 20
Weight and Volume | 20 | 20 | 12
Storage, transportation, deployment | 20 | 20 | 12
Life Cycle | 20 | 20 | 16
Total | 100 | 94 | 65

EASE Preliminary Design Review

# Trade Study:

# DESIGN OVERVIEW

# MECHANICAL

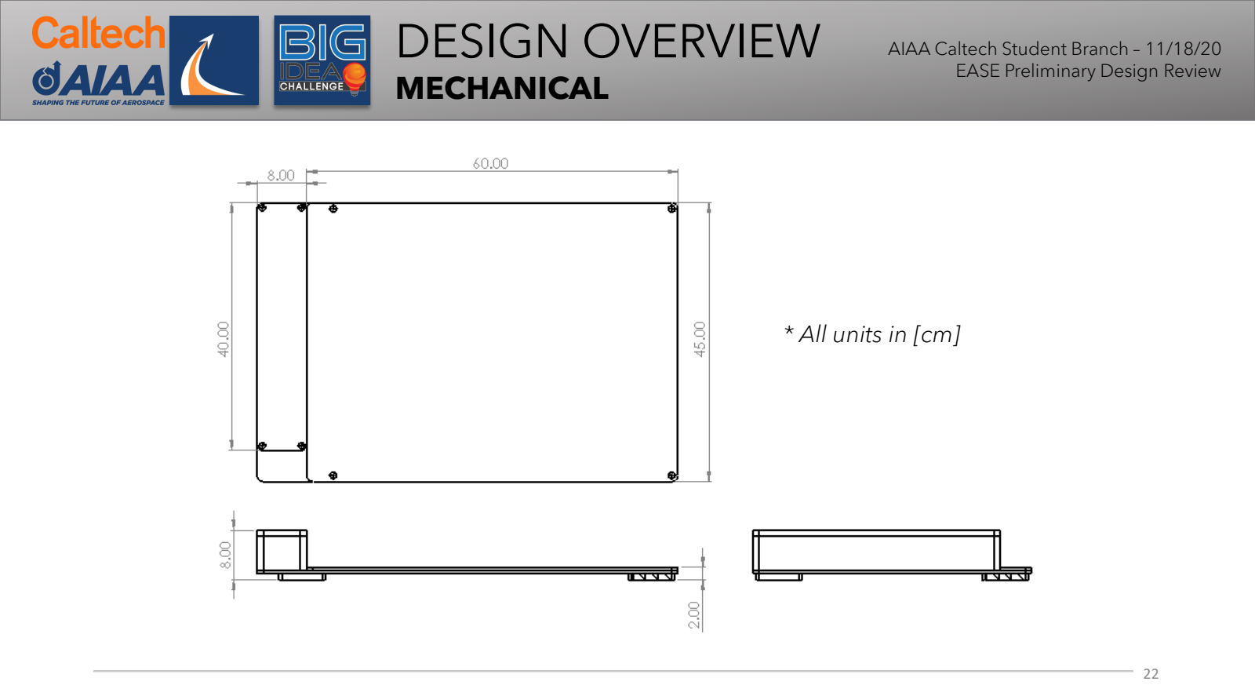
[picture p164: page 21]

### * All units in [cm]

EASE Preliminary Design Review

# DESIGN OVERVIEW

# MECHANICAL

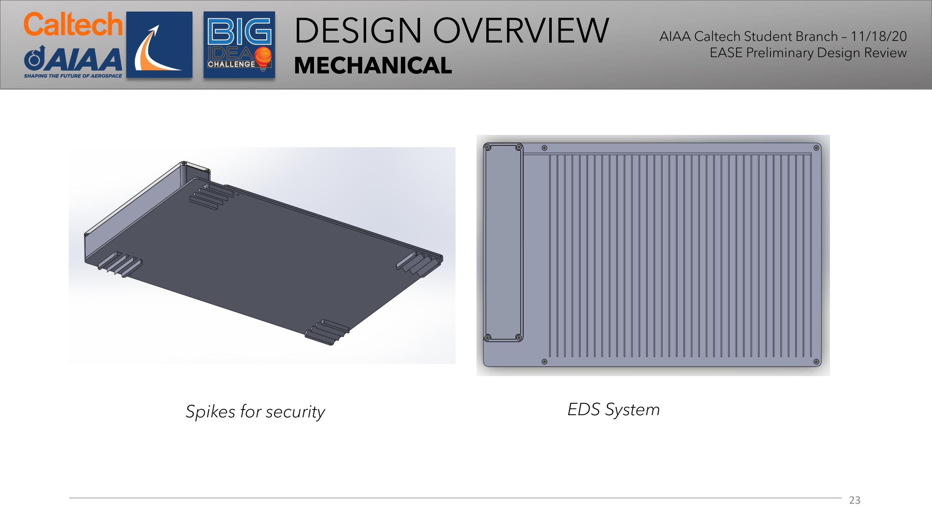
[picture p165: page 22]

Spikes for security | EDS System

EASE Preliminary Design Review

# PANEL COMPOSITION

# MECHANICAL

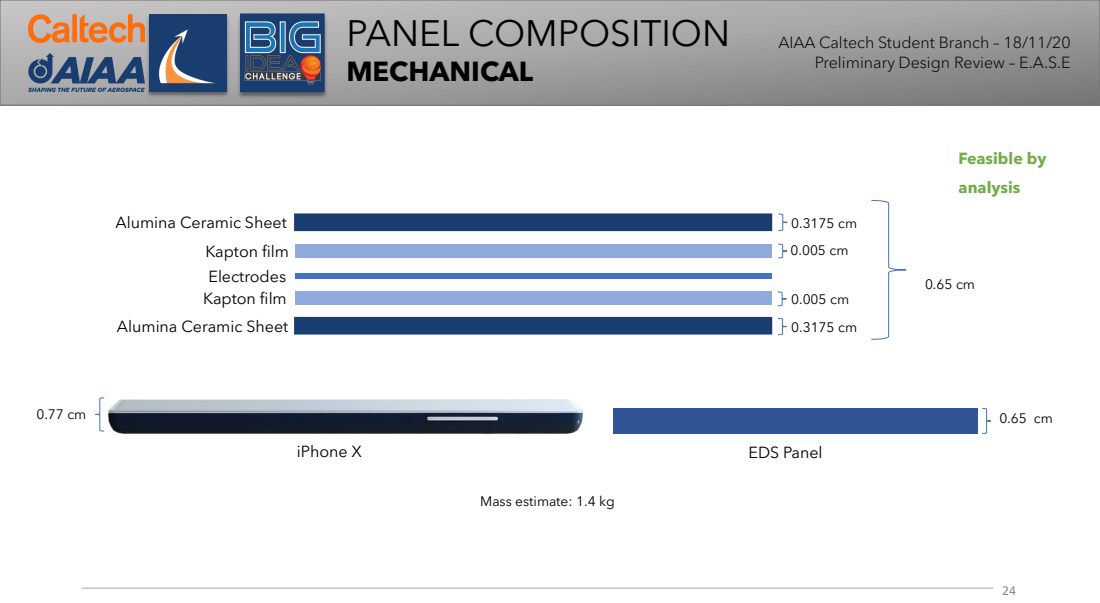
[picture p166: page 23]
Kapton film; Electrodes; iPhone X; EDS Panel; Feasible by; analysis

AIAA Caltech Student Branch – 18/11/20
Preliminary Design Review – E.A.S.E

Alumina Ceramic Sheet

Mass estimate: 1.4 kg

# MECHANICAL

# MATERIAL SELECTION

Note: we will use Cicoil wires

| Alumina Ceramic (structure) | 316 Stainless Steel (Bolt) | Kapton (dielectric)
Density | 3.9 (g/cm³ ) | 8.0 (g/cm³ ) | 1.41 (g/cm³ )
Tensile Strength | 260 (MPa) | 482 (MPa) | 230 (MPa)
Flexural Strength | 379 (MPa) | 290 (MPa) | 120 (MPa)
Compressive Strength | 2,600 (MPa) | 170 (MPa) | 172 (MPa)
Coefficient of Thermal Expansion | 8.6 (10⁻⁶ /ºC) | 10.3 (10⁻⁶ /ºC) | 8.1 (10⁻⁵ /ºC)
Dielectric Constant | 9.1 (at 1 MHz) | - | 5.42 (at MHz)
Dielectric Strength | 16.7 (kV/mm) | - | 217 (kV/mm)
Temperature Range | -273.15ºC to 1,750ºC | -252ºC to 871ºC | -267ºC to 398ºC

EASE Preliminary Design Review

# MECHANICAL

# MATERIAL SELECTION

Note: we will use Cicoil wires

| Alumina Ceramic (structure) | 316 Stainless Steel (Bolt) | Kapton (dielectric)
Density | 3.9 (g/cm³ ) | 8.0 (g/cm³ ) | 1.41 (g/cm³ )
Tensile Strength | 260 (MPa) | 482 (MPa) | 230 (MPa)
Flexural Strength | 379 (MPa) | 290 (MPa) | 120 (MPa)
Compressive Strength | 2,600 (MPa) | 170 (MPa) | 172 (MPa)
Coefficient of Thermal Expansion | 8.6 (10⁻⁶ /ºC) | 10.3 (10⁻⁶ /ºC) | 8.1 (10⁻⁵ /ºC)
Dielectric Constant | 9.1 (at 1 MHz) | - | 5.42 (at MHz)
Dielectric Strength | 16.7 (kV/mm) | - | 217 (kV/mm)
Temperature Range | -273.15ºC to 1,750ºC | -252ºC to 871ºC | -267ºC to 398ºC

EASE Preliminary Design Review

# MECHANICAL

# MATERIAL SELECTION

Note: we will use Cicoil wires

| Alumina Ceramic (structure) | 316 Stainless Steel (Bolt) | Kapton (dielectric)
Density | 3.9 (g/cm³ ) | 8.0 (g/cm³ ) | 1.41 (g/cm³ )
Tensile Strength | 260 (MPa) | 482 (MPa) | 230 (MPa)
Flexural Strength | 379 (MPa) | 290 (MPa) | 120 (MPa)
Compressive Strength | 2,600 (MPa) | 170 (MPa) | 172 (MPa)
Coefficient of Thermal Expansion | 8.6 (10⁻⁶ /ºC) | 10.3 (10⁻⁶ /ºC) | 8.1 (10⁻⁵ /ºC)
Dielectric Constant | 9.1 (at 1 MHz) | - | 5.42 (at MHz)
Dielectric Strength | 16.7 (kV/mm) | - | 217 (kV/mm)
Temperature Range | -273.15ºC to 1,750ºC | -252ºC to 871ºC | -267ºC to 398ºC

EASE Preliminary Design Review

# MECHANICAL

# MATERIAL SELECTION

Note: we will use Cicoil wires

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

EASE Preliminary Design Review

# MATERIAL SELECTION

# MECHANICAL

AIAA Caltech Student Branch – 18/11/20 Preliminary Design Review – E.A.S.E

Alumina | Kapton
Electrical insulator | Stability across wide temperature range
Low dielectric constant | Durability
Low thermal conductivity | Good dielectric qualities
Hardness | Used in spacecraft applications (Apollo launcher, Curiosity rover)

### Strength

### Sufficient temperature range

### Abrasion resistant

### Used in many spacecraft applications

# MANUFACTURING

# MECHANICAL

AIAA Caltech Student Branch – 18/11/20 Preliminary Design Review – H.O.M.E.S.


### Top Plate: - 3-axis CNC milling Bottom Plate: - 3-axis CNC milling Electronics Box: - Tungsten inert gas welding - 3-axis CNC milling

### - Design considerations: 0.5 mm tolerance, large external and internal fillets

# MISSION INTEGRATION

# RISK ASSESEMENT

EASE Preliminary Design Review


# VERIFICATION

# TEST PROGRAM

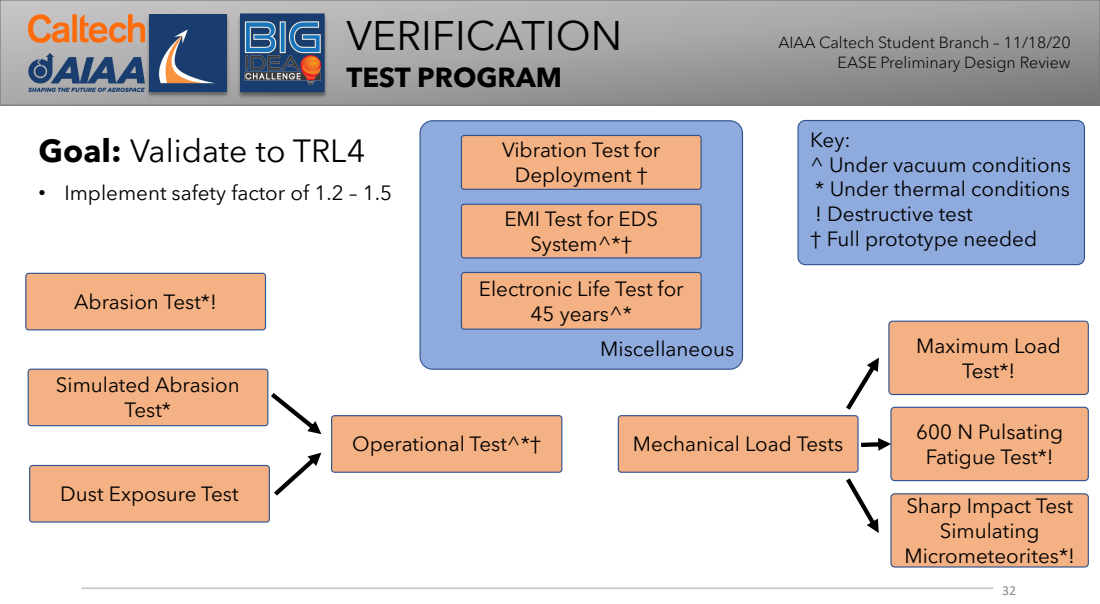
[picture p167: page 31]
Operational Test^*†; Mechanical Load Tests; 600 N Pulsating; Fatigue Test*!; Maximum Load Test*!; Simulated Abrasion Test*; Miscellaneous; Abrasion Test*!; Electronic Life Test for; 45 years^*

EASE Preliminary Design Review

Key:
^ Under vacuum conditions
* Under thermal conditions
! Destructive test
† Full prototype needed

Goal: Validate to TRL4

Vibration Test for
Deployment †

• Implement safety factor of 1.2 – 1.5

EMI Test for EDS
System^*†

Dust Exposure Test

Sharp Impact Test
Simulating
Micrometeorites*!

# VERIFICATION

# TEST PROGRAM

# Equipment and Testing Conditions


### (Roy, 2008)

### Three-Body Abrasive Wear Test Rig

- Currently looking for resources for vacuum and cryochamber - Lunar Simulant JSC-1A will be used for EDS-related testing - Lunar Simulants OB-1 and Chenobi are the most recommended simulants for abrasion and dust exposure testing - We will test from -260˚C to 140˚C to simulate lunar thermal conditions

EASE Preliminary Design Review

# LOGISTICS

# BUDGETING

Raw Material Costs Est.

## - 4 prototypes without EDS System - 1 complete prototype - Costs will increase if a need for iteration arises


Note: Does not include machining or circuit component costs

EASE Preliminary Design Review

# CONCLUSION

# FEASIBILITY REVIEW

EASE Preliminary Design Review

Function / Characteristic | Solution | Feasible?
Transport dust | EDS | YES
Touch-free operation | Piezoelectric transducer | YES
Rugged housing | Ceramic & Beta-cloth | YES
