caltechcaos/Lunar-Dust-Challenge/Current/Mechanical/Finger Thickness Analysis/Version 2/untitled.png

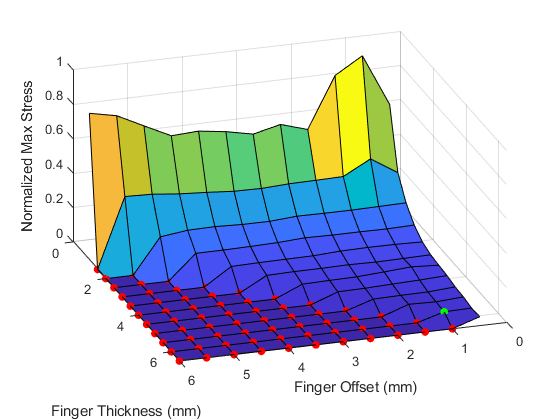
Current/Mechanical/Finger Thickness Analysis/Version 2/untitled.png
