caltechcaos/Lunar-Dust-Challenge/Current/Mechanical/v3_tiz/Drawings/end_cap_v3.2.PNG

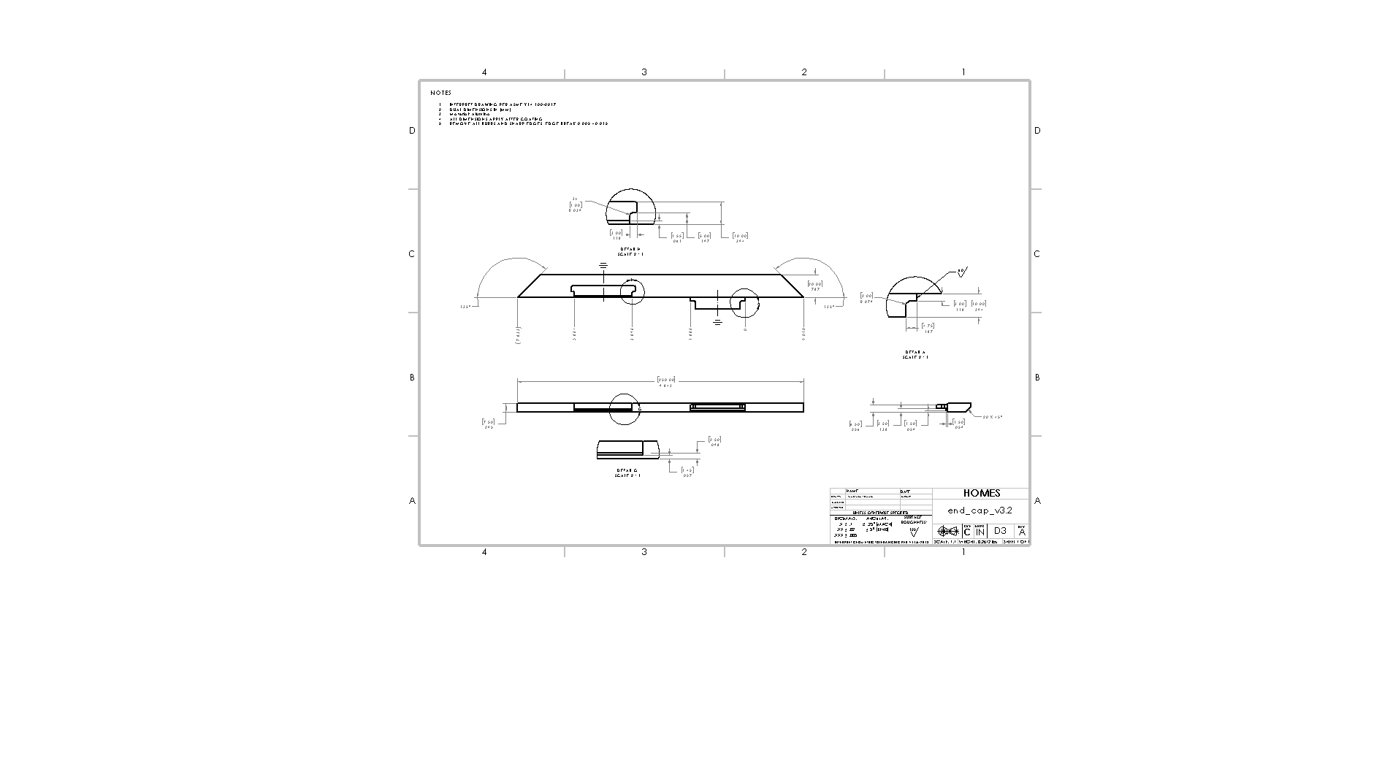
Current/Mechanical/v3_tiz/Drawings/end_cap_v3.2.PNG
