caltechcaos/Lunar-Dust-Challenge/Current/Mechanical/v3_tiz/Renders/bottompanel.png

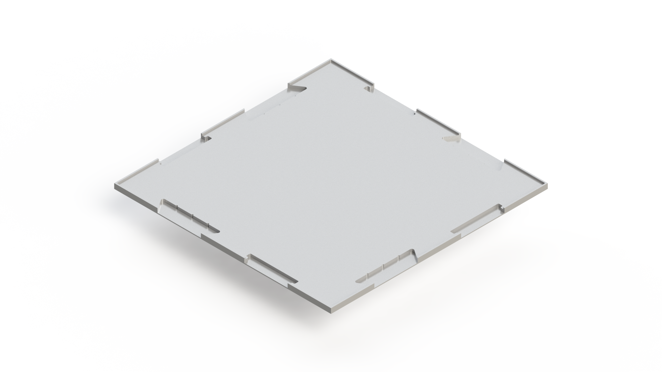
Current/Mechanical/v3_tiz/Renders/bottompanel.png
