caltechcaos/Lunar-Dust-Challenge/Current/Mechanical/v3_tiz/Renders/endcap bottom.png

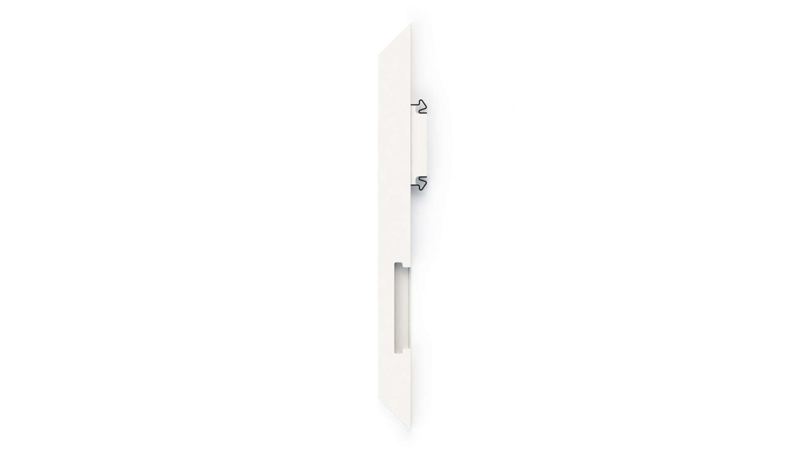
Current/Mechanical/v3_tiz/Renders/endcap bottom.png
