caltechcaos/Lunar-Dust-Challenge/Current/Mechanical/v3_tiz/Renders/endcap iso back.png

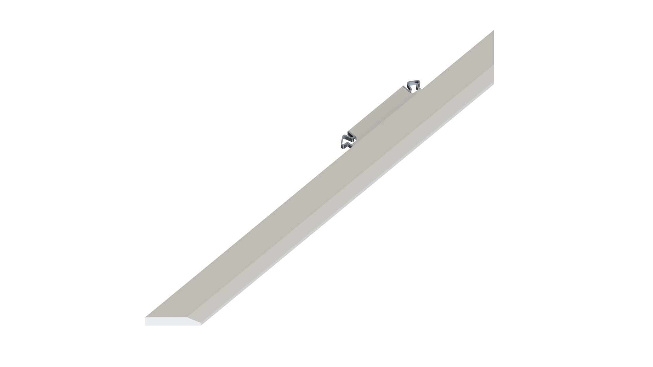
Current/Mechanical/v3_tiz/Renders/endcap iso back.png
