caltechcaos/Lunar-Dust-Challenge/Current/Mechanical/v3_tiz/Renders/endcap iso front.png

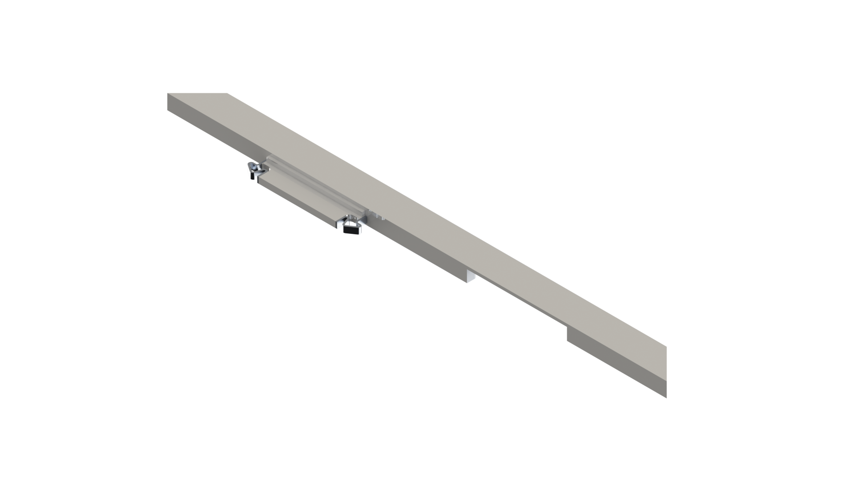
Current/Mechanical/v3_tiz/Renders/endcap iso front.png
