caltechcaos/Lunar-Dust-Challenge/Current/Mechanical/v3_tiz/Renders/endcap_v3.1.png

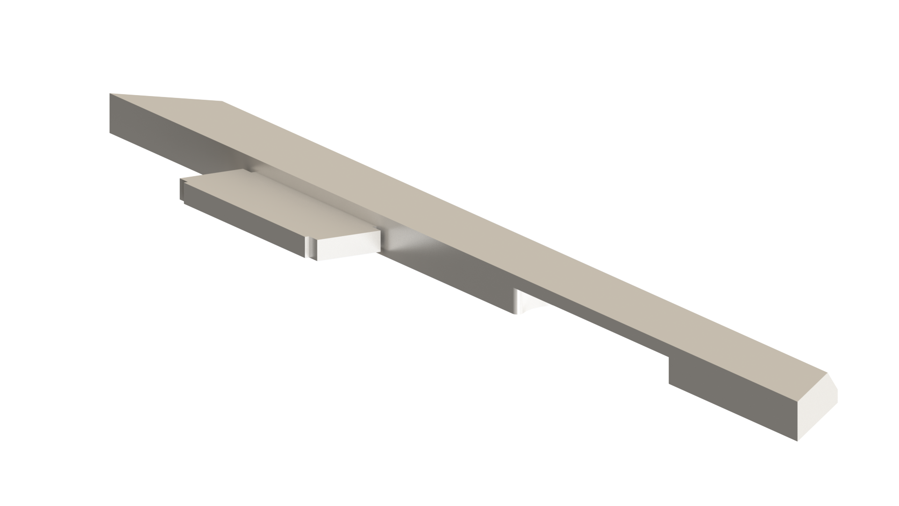
Current/Mechanical/v3_tiz/Renders/endcap_v3.1.png
