caltechcaos/Lunar-Dust-Challenge/Current/Mechanical/v3_tiz/Renders/exploded view.png

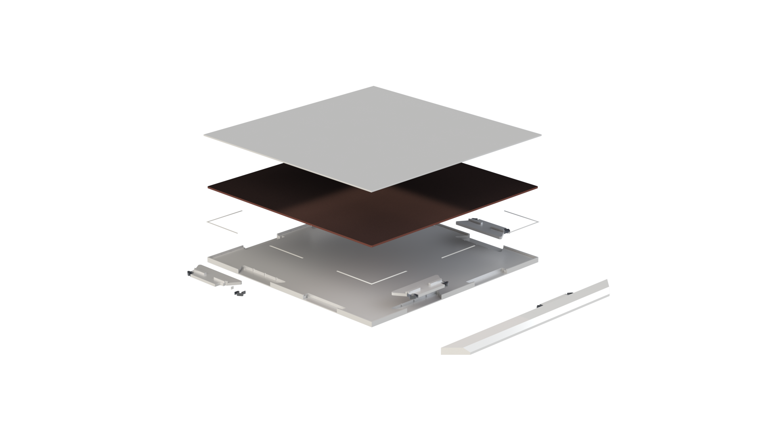
Current/Mechanical/v3_tiz/Renders/exploded view.png
