caltechcaos/Lunar-Dust-Challenge/Current/Mechanical/v3_tiz/Renders/single panel.png

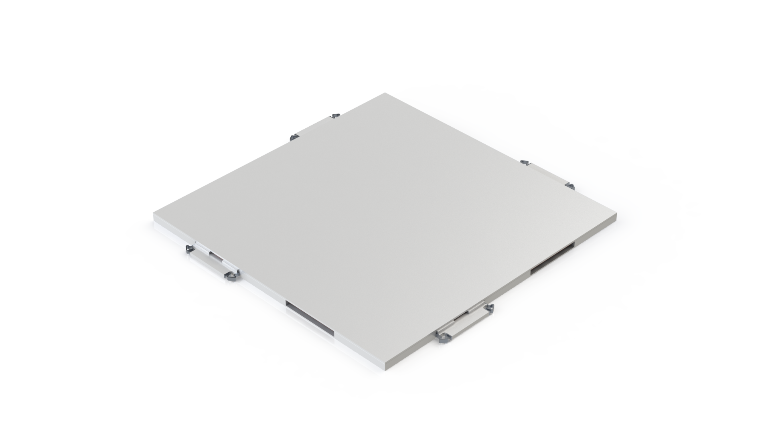
Current/Mechanical/v3_tiz/Renders/single panel.png
