caltechcaos/Lunar-Dust-Challenge/Current/Mechanical/v4_Eggdee/RENDERS/5-19 Renders/4panel2.png

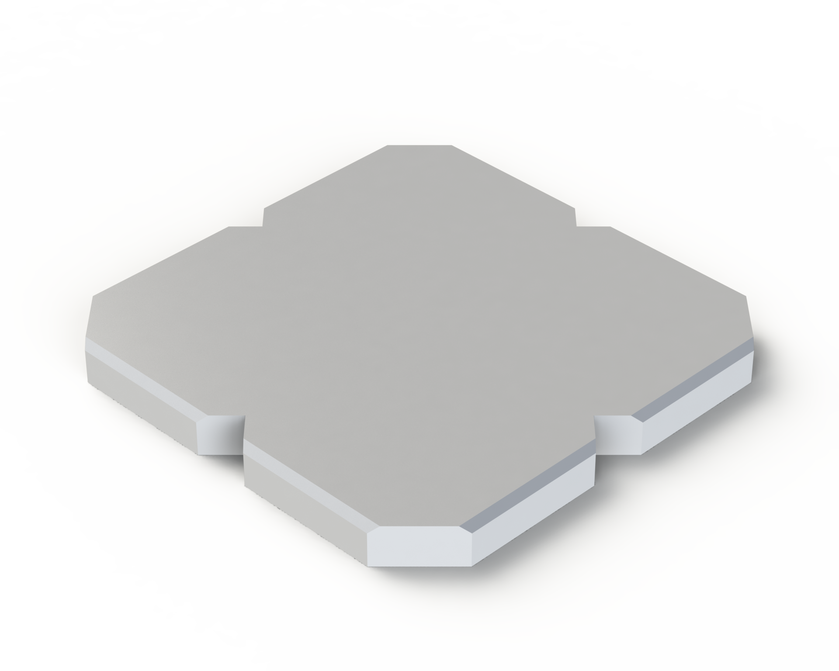
Current/Mechanical/v4_Eggdee/RENDERS/5-19 Renders/4panel2.png
