caltechcaos/Lunar-Dust-Challenge/Current/Mechanical/v4_Eggdee/RENDERS/5-19 Renders/4panel_noice.png

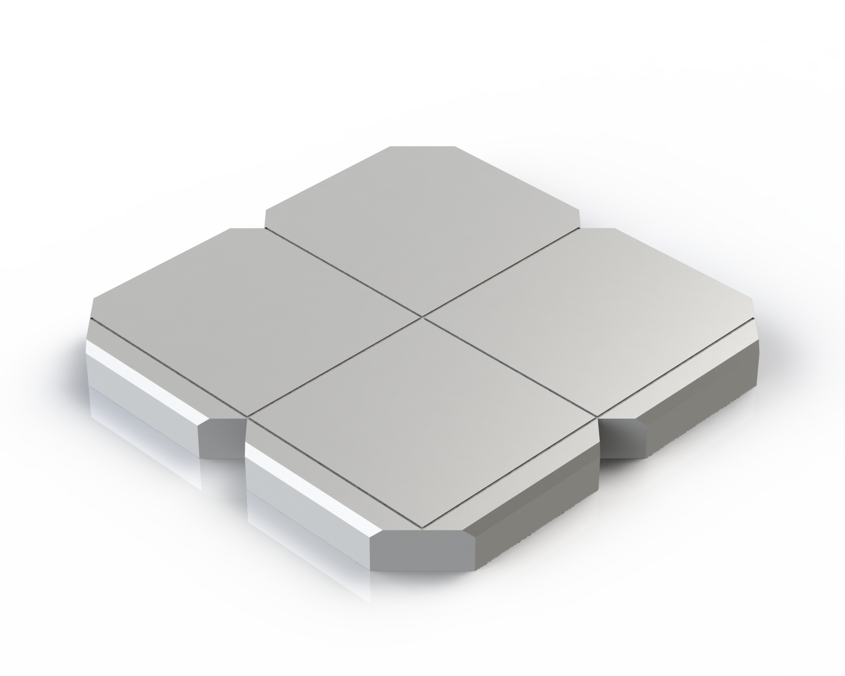
Current/Mechanical/v4_Eggdee/RENDERS/5-19 Renders/4panel_noice.png
