caltechcaos/Lunar-Dust-Challenge/Current/Mechanical/v4_Eggdee/RENDERS/5-19 Renders/exploded.png

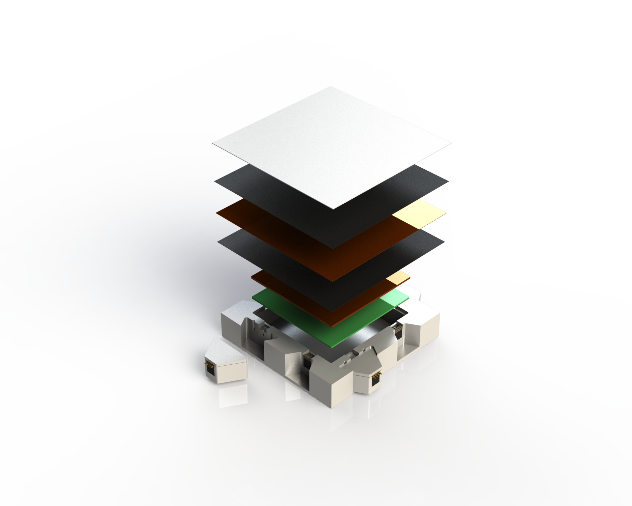
Current/Mechanical/v4_Eggdee/RENDERS/5-19 Renders/exploded.png
