caltechcaos/Lunar-Dust-Challenge/Current/Mechanical/v4_Eggdee/RENDERS/Exploded_View.png

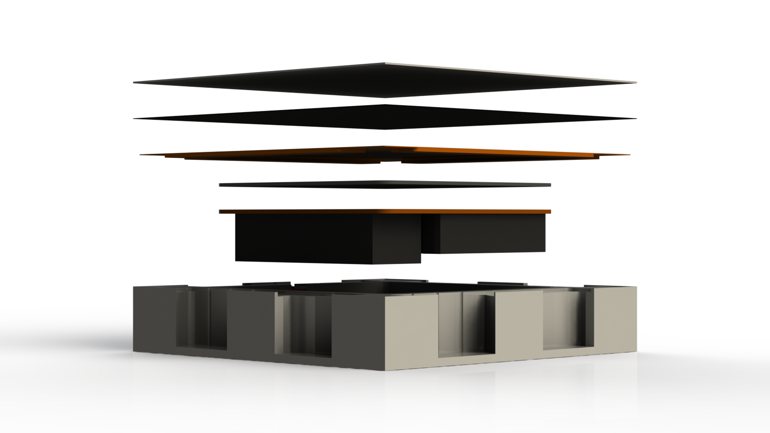
Current/Mechanical/v4_Eggdee/RENDERS/Exploded_View.png
