caltechcaos/Lunar-Dust-Challenge/Current/Mechanical/v4_Eggdee/RENDERS/ISO_BPLATE.png

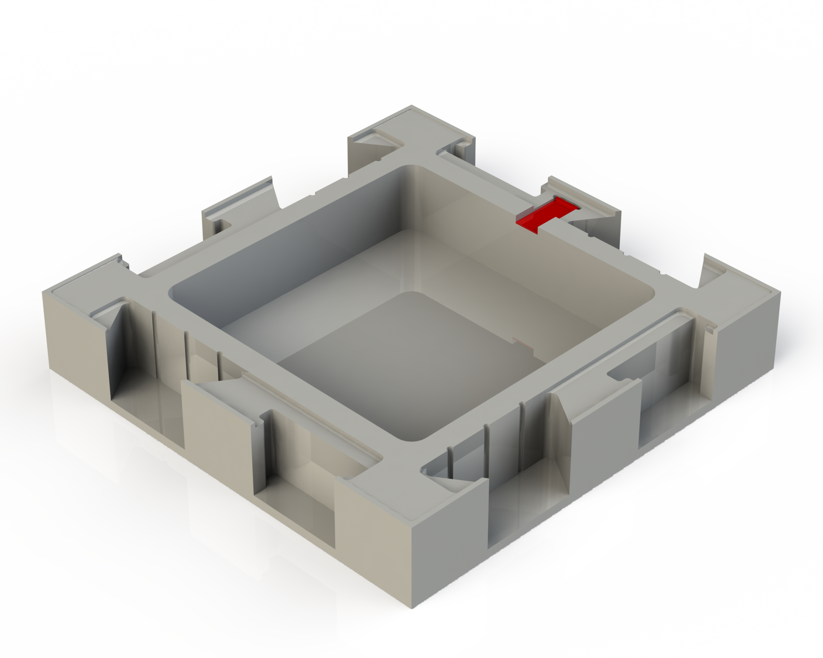
Current/Mechanical/v4_Eggdee/RENDERS/ISO_BPLATE.png
