caltechcaos/Lunar-Dust-Challenge/Current/Mechanical/v4_Eggdee/RENDERS/ISO_PANEL.png

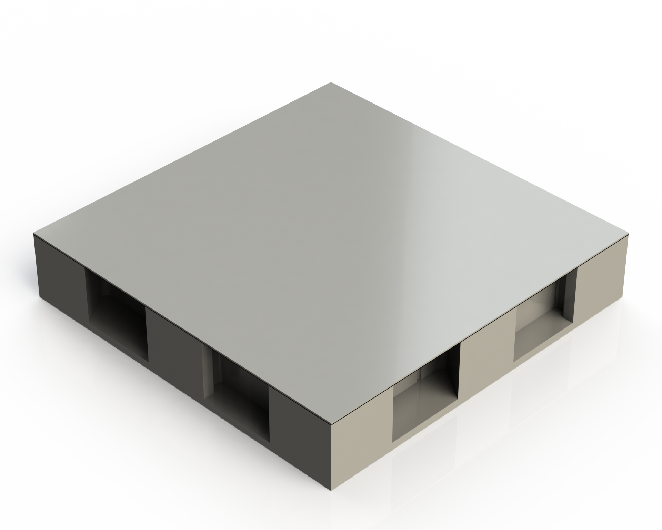
Current/Mechanical/v4_Eggdee/RENDERS/ISO_PANEL.png
