caltechcaos/Lunar-Dust-Challenge/Current/Mechanical/v4_Eggdee/RENDERS/PCB_View.png

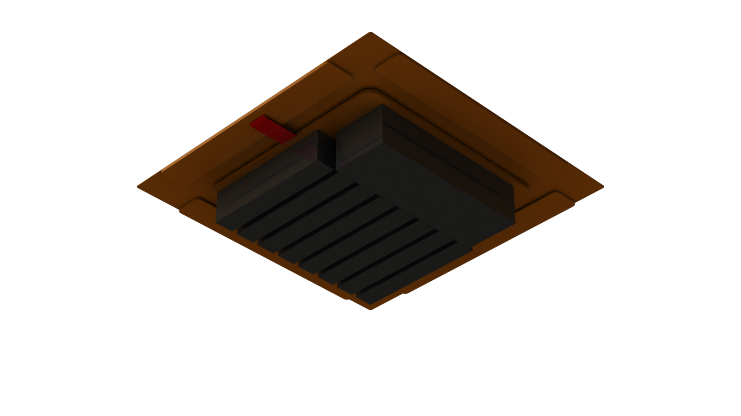
Current/Mechanical/v4_Eggdee/RENDERS/PCB_View.png
