caltechcaos/Lunar-Dust-Challenge/Current/Mechanical/v4_Eggdee/Simplified_Parts/5.16_3pt_Bend_Simplified_Borderless/borderless_simplified_panel-3pt_Bend_Borderless-3.docx

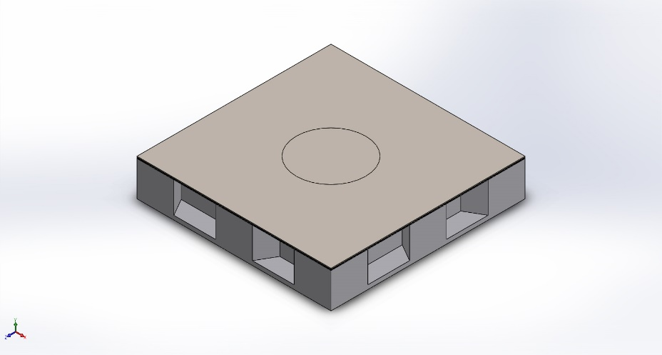
[picture p240: figure]

Simulation of borderless_simplified_panel

Date: Monday, May 17, 2021
Designer: Solidworks

Study name: 3pt_Bend_Borderless

Analysis type: Static
Description No Data

# Assumptions

# Model Information

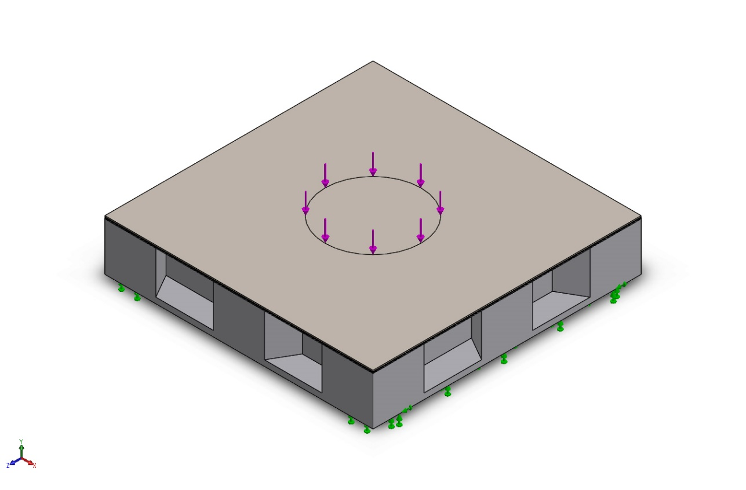
[picture p241: figure]

Model name: borderless_simplified_panel

Current Configuration: Default

Solid Bodies
Document Name and Reference | Treated As | Volumetric Properties | Document Path/Date Modified

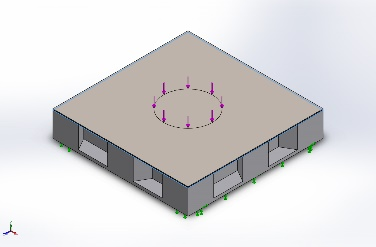
[picture p242: figure]

Boss-Extrude1 | Solid Body | Mass:0.0106851 kg Volume:4.87902e-06 m^3 Density:2,190 kg/m^3 Weight:0.104714 N | C:\Users\Natha\Desktop\Caltech 2020-2024\NASA_Big_Idea_Challenge\GrabCAD\Current\Mechanical\v4_Eggdee\Parts\adhesive_v4.1.SLDPRT May 16 13:19:20 2021

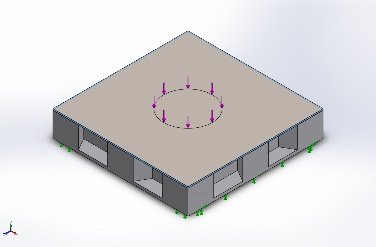
[picture p243: figure]

Boss-Extrude1 | Solid Body | Mass:0.0106851 kg Volume:4.87902e-06 m^3 Density:2,190 kg/m^3 Weight:0.104714 N | C:\Users\Natha\Desktop\Caltech 2020-2024\NASA_Big_Idea_Challenge\GrabCAD\Current\Mechanical\v4_Eggdee\Parts\adhesive_v4.1.SLDPRT May 16 13:19:20 2021

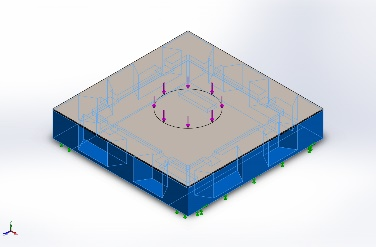
[picture p244: figure]

CirPattern2 | Solid Body | Mass:0.534853 kg Volume:0.000212243 m^3 Density:2,520 kg/m^3 Weight:5.24155 N | C:\Users\Natha\Desktop\Caltech 2020-2024\NASA_Big_Idea_Challenge\GrabCAD\Current\Mechanical\v4_Eggdee\Simplified_Parts\bplate_simplified_borderless.SLDPRT May 16 16:23:03 2021

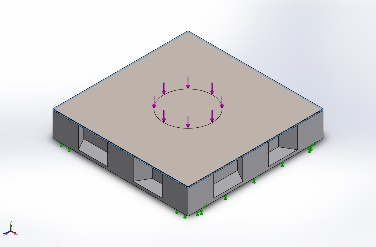
[picture p245: figure]

Boss-Extrude1 | Solid Body | Mass:0.00831385 kg Volume:5.85483e-06 m^3 Density:1,420 kg/m^3 Weight:0.0814758 N | C:\Users\Natha\Desktop\Caltech 2020-2024\NASA_Big_Idea_Challenge\GrabCAD\Current\Mechanical\v4_Eggdee\Simplified_Parts\pcb_simplified_nofillet.SLDPRT May 16 16:25:29 2021

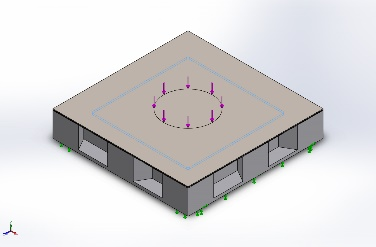
[picture p246: figure]

Fillet1 | Solid Body | Mass:0.0319938 kg Volume:1.59969e-05 m^3 Density:2,000 kg/m^3 Weight:0.313539 N | C:\Users\Natha\Desktop\Caltech 2020-2024\NASA_Big_Idea_Challenge\GrabCAD\Current\Mechanical\v4_Eggdee\Parts\power_supply_pcb_mockup_v4.2.SLDPRT May 15 11:00:41 2021

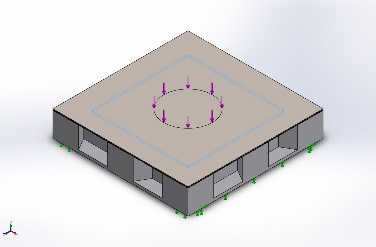
[picture p247: figure]

Fillet1 | Solid Body | Mass:0.0269748 kg Volume:1.89963e-05 m^3 Density:1,420 kg/m^3 Weight:0.264353 N | C:\Users\Natha\Desktop\Caltech 2020-2024\NASA_Big_Idea_Challenge\GrabCAD\Current\Mechanical\v4_Eggdee\Simplified_Parts\separation_layer_simplified.SLDPRT May 16 13:10:37 2021

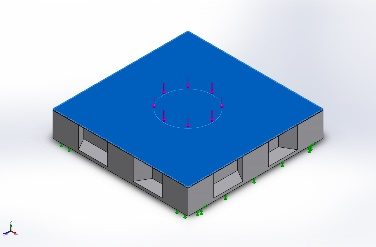
[picture p248: figure]

Split Line1 | Solid Body | Mass:0.0494616 kg Volume:1.24903e-05 m^3 Density:3,960 kg/m^3 Weight:0.484723 N | C:\Users\Natha\Desktop\Caltech 2020-2024\NASA_Big_Idea_Challenge\GrabCAD\Current\Mechanical\v4_Eggdee\Simplified_Parts\tplate_simplified.SLDPRT May 16 22:41:33 2021

# Study Properties

Study name | 3pt_Bend_Borderless
Analysis type | Static
Mesh type | Solid Mesh
Thermal Effect: | On
Thermal option | Include temperature loads
Zero strain temperature | 298 Kelvin
Include fluid pressure effects from SOLIDWORKS Flow Simulation | Off
Solver type | FFEPlus
Inplane Effect: | Off
Soft Spring: | Off
Inertial Relief: | Off
Incompatible bonding options | Automatic
Large displacement | Off
Compute free body forces | On
Friction | Off
Use Adaptive Method: | Off
Result folder | SOLIDWORKS document (C:\Users\Natha\Desktop\Caltech 2020-2024\NASA_Big_Idea_Challenge\GrabCAD\Current\Mechanical\v4_Eggdee\Simplified_Parts\5.16_3pt_Bend_Simplified_Borderless)

# Units

Unit system: | SI (MKS)
Length/Displacement | mm
Temperature | Kelvin
Angular velocity | Rad/sec
Pressure/Stress | N/m^2

# Material Properties

Model Reference | Properties | Components

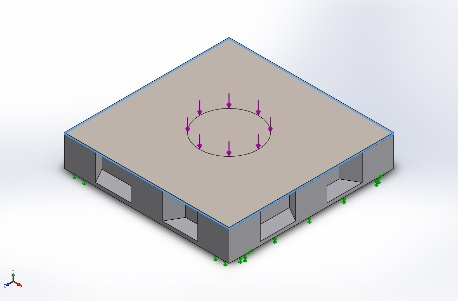
[picture p249: figure]

| Name: STYCAST 2850FT/Catalyst 23LV Model type: Linear Elastic Isotropic Default failure criterion: Unknown Tensile strength: 1.0549e+08 N/m^2 Compressive strength: 1.19969e+08 N/m^2 Elastic modulus: 6.413e+09 N/m^2 Mass density: 2,190 kg/m^3 | SolidBody 1(Boss-Extrude1)(adhesive_v4.1-1), SolidBody 1(Boss-Extrude1)(adhesive_v4.1-2)

Curve Data:N/A

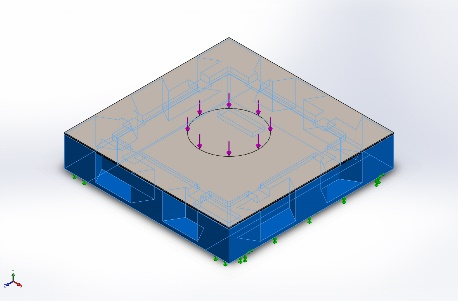
[picture p250: figure]

| Name: Macor Model type: Linear Elastic Isotropic Default failure criterion: Unknown Yield strength: 3.3e+07 N/m^2 Tensile strength: 3.3e+07 N/m^2 Compressive strength: 3.45e+08 N/m^2 Elastic modulus: 6.69e+10 N/m^2 Poisson's ratio: 0.29 Mass density: 2,520 kg/m^3 Shear modulus: 2.55e+10 N/m^2 Thermal expansion coefficient: 8e-06 /Kelvin | SolidBody 1(CirPattern2)(bplate_simplified_borderless-1)

Curve Data:N/A

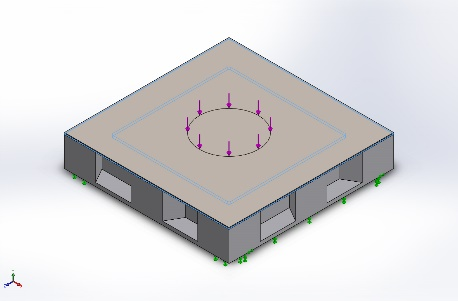
[picture p251: figure]

| Name: Kapton HN Model type: Linear Elastic Isotropic Default failure criterion: Unknown Yield strength: 6.9e+07 N/m^2 Tensile strength: 2.31e+08 N/m^2 Compressive strength: 2.31e+08 N/m^2 Elastic modulus: 2.76e+09 N/m^2 Poisson's ratio: 0.34 Mass density: 1,420 kg/m^3 Thermal expansion coefficient: 20 /Kelvin | SolidBody 1(Boss-Extrude1)(pcb_simplified_nofillet-1), SolidBody 1(Fillet1)(separation_layer_simplified-1)

Curve Data:N/A

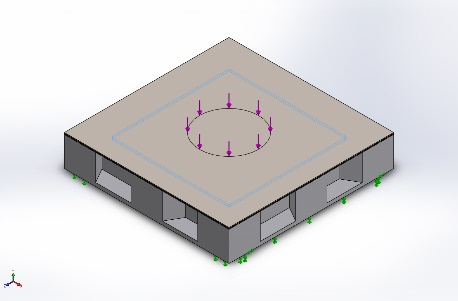
[picture p252: figure]

| Name: FR4 Model type: Linear Elastic Isotropic Default failure criterion: Unknown Yield strength: 3.45e+08 N/m^2 Tensile strength: 3.45e+08 N/m^2 Compressive strength: 3.5e+08 N/m^2 Elastic modulus: 2.156e+10 N/m^2 Poisson's ratio: 0.136 Mass density: 2,000 kg/m^3 | SolidBody 1(Fillet1)(power_supply_pcb_mockup_v4.2-1)

Curve Data:N/A

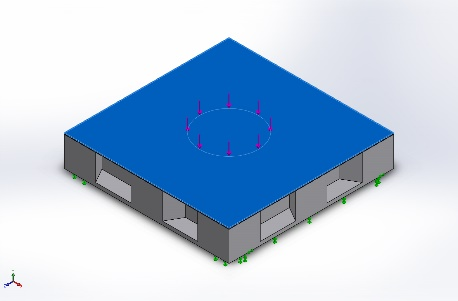
[picture p253: figure]

| Name: Alumina Model type: Linear Elastic Isotropic Default failure criterion: Unknown Tensile strength: 3e+08 N/m^2 Compressive strength: 3e+09 N/m^2 Elastic modulus: 3.7e+11 N/m^2 Poisson's ratio: 0.22 Mass density: 3,960 kg/m^3 Shear modulus: 1.5e+11 N/m^2 Thermal expansion coefficient: 7e-06 /Kelvin | SolidBody 1(Split Line1)(tplate_simplified-1)

Curve Data:N/A

# Loads and Fixtures

Fixture name | Fixture Image | Fixture Details

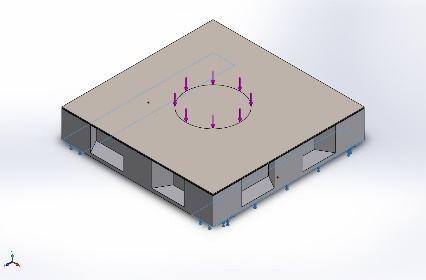
[picture p254: figure]

Fixed-1 | | Entities: 2 face(s) Type: Fixed Geometry

Resultant Forces

Components | X | Y | Z | Resultant
Reaction force(N) | -7.39098e-05 | 486 | -2.6226e-06 | 486
Reaction Moment(N.m) | 0 | 0 | 0 | 0

Load name | Load Image | Load Details

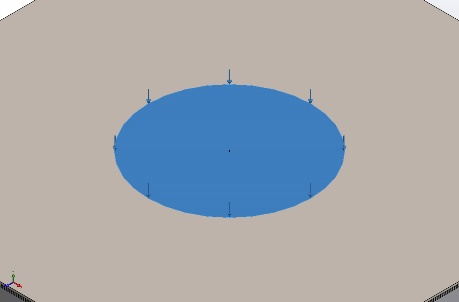
[picture p255: figure]

Force-1 | | Entities: 1 face(s) Type: Apply normal force Value: 486 N

# Connector Definitions

No Data

# Contact Information

Contact | Contact Image | Contact Properties

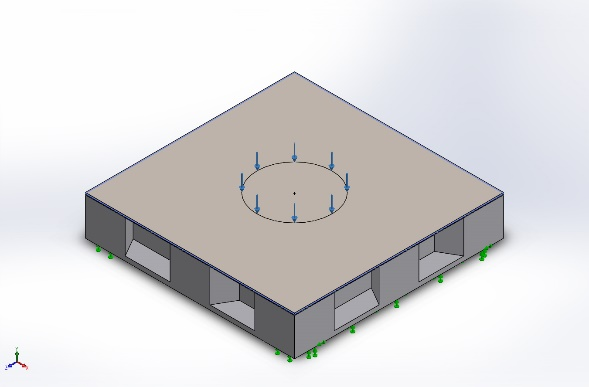
[picture p256: figure]

Contact Set-1 | | Type: Bonded contact pair Entities: 2 face(s)

Contact/Friction force

Components | X | Y | Z | Resultant
Contact Force(N) | 0 | 16.19 | 0 | 16.19

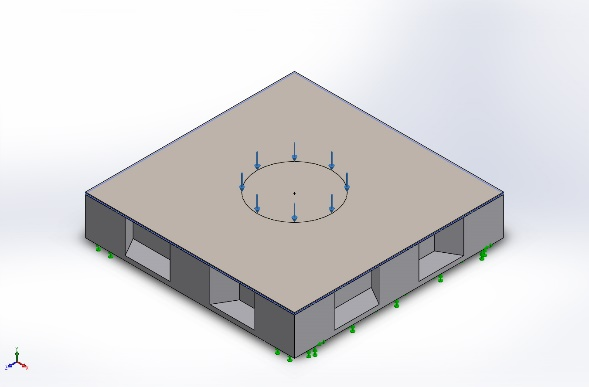
[picture p257: figure]

Contact Set-2 | | Type: Bonded contact pair Entities: 2 face(s)

Contact/Friction force

Components | X | Y | Z | Resultant
Contact Force(N) | 0 | 66.023 | 0 | 66.023

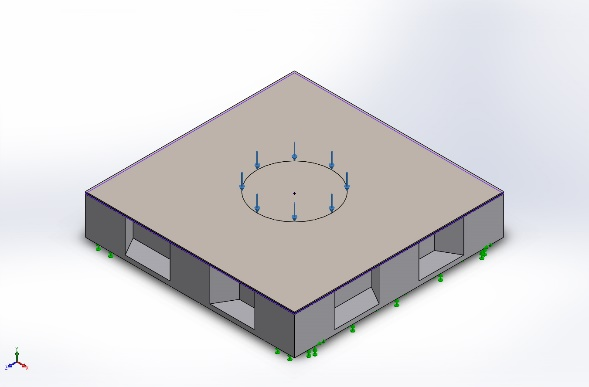
[picture p258: figure]

Contact Set-3 | | Type: Bonded contact pair Entities: 2 face(s)

Contact/Friction force

Components | X | Y | Z | Resultant
Contact Force(N) | -5.3517E-15 | -17.971 | -4.6557E-07 | 17.971

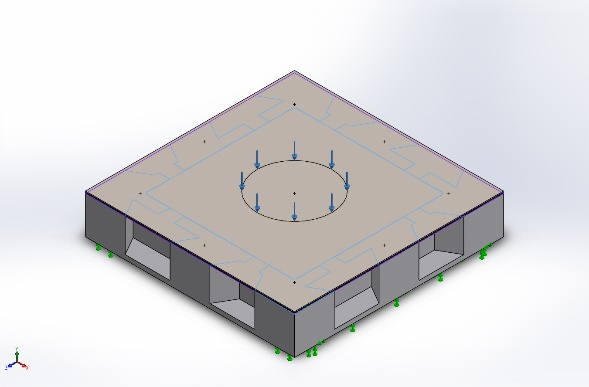
[picture p259: figure]

Contact Set-4 | | Type: Bonded contact pair Entities: 10 face(s)

Contact/Friction force

Components | X | Y | Z | Resultant
Contact Force(N) | -1.5648 | 56.888 | -2.2944 | 56.956

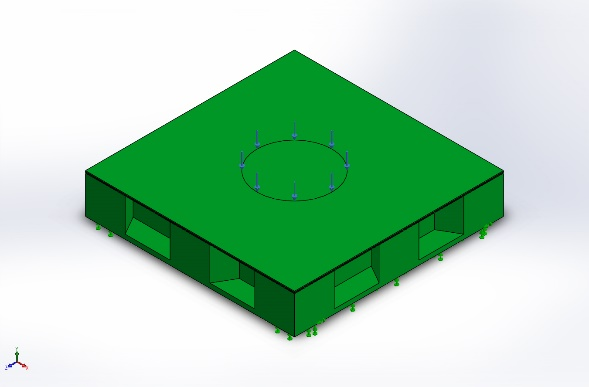
[picture p260: figure]

Component Contact-1 | | Type: No penetration (Surface to surface) Components: 7 component(s)

# Mesh information

Mesh type | Solid Mesh
Mesher Used: | Standard mesh
Automatic Transition: | Off
Include Mesh Auto Loops: | Off
Jacobian points | 4 Points
Element Size | 0.2 in
Tolerance | 0.01 in
Mesh Quality Plot | High
Remesh failed parts with incompatible mesh | Off

## Mesh information - Details

Total Nodes | 85972
Total Elements | 47124
Maximum Aspect Ratio | 182.12
% of elements with Aspect Ratio < 3 | 31.5
% of elements with Aspect Ratio > 10 | 49.5
% of distorted elements(Jacobian) | 0
Time to complete mesh(hh;mm;ss): | 00:00:13
Computer name: | THICCO


## Mesh Control Information:

Mesh Control Name | Mesh Control Image | Mesh Control Details

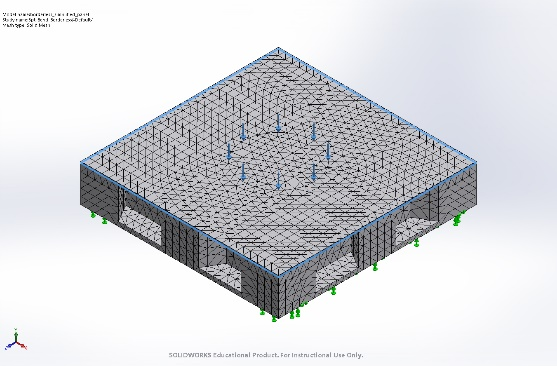
[picture p261: figure]

Control-1 | | Entities: 2 Solid Body (s) Units: in Size: 0.195 Ratio: 0.195

# Sensor Details

No Data

# Resultant Forces

## Reaction forces

Selection set | Units | Sum X | Sum Y | Sum Z | Resultant
Entire Model | N | -7.39098e-05 | 486 | -2.6226e-06 | 486

## Reaction Moments

Selection set | Units | Sum X | Sum Y | Sum Z | Resultant
Entire Model | N.m | 0 | 0 | 0 | 0

# Beams

No Data

# Study Results

Name | Type | Min | Max
Stress1 | VON: von Mises Stress | 2.166e+03 N/m^2 Node: 62655 | 1.082e+08 N/m^2 Node: 73408


borderless_simplified_panel-3pt_Bend_Borderless-Stress-Stress1

Name | Type | Min | Max
Displacement1 | URES: Resultant Displacement | 0.000e+00 mm Node: 27749 | 2.715e-01 mm Node: 862


borderless_simplified_panel-3pt_Bend_Borderless-Displacement-Displacement1

Name | Type | Min | Max
Strain1 | ESTRN: Equivalent Strain | 5.959e-09 Element: 43541 | 1.442e-03 Element: 37878


borderless_simplified_panel-3pt_Bend_Borderless-Strain-Strain1

Name | Type | Min | Max
Factor of Safety1 | Mohr-Coulomb Stress | 2.986e+00 Node: 78510 | 3.000e+00 Node: 1


borderless_simplified_panel-3pt_Bend_Borderless-Factor of Safety-Factor of Safety1

# Conclusion

Analyzed with SOLIDWORKS Simulation Simulation of borderless_simplified_panel 7

Analyzed with SOLIDWORKS Simulation Simulation of borderless_simplified_panel 1
