caltechcaos/Lunar-Dust-Challenge/Current/Mechanical/v4_Eggdee/Simplified_Parts/5.16_Cantilever_Simplified_Borderless/borderless_simplified_panel_cantilever-cantilever-1.docx

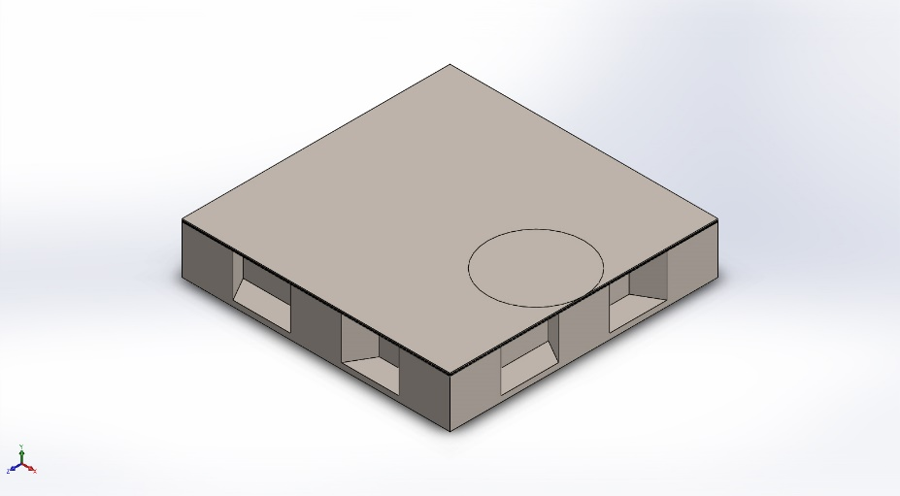
[picture p262: figure]

Simulation of borderless_simplified_panel_cantilever

Date: Monday, May 17, 2021
Designer: Solidworks

Study name: cantilever

Analysis type: Static
Description No Data

# Assumptions

# Model Information

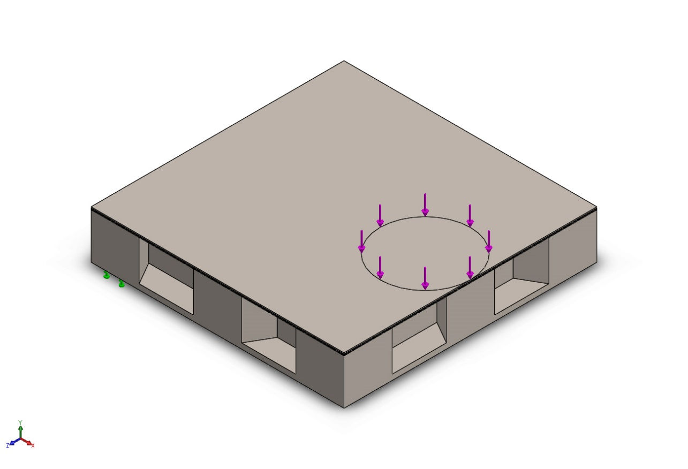
[picture p263: figure]

Model name: borderless_simplified_panel_cantilever

Current Configuration: Default

Solid Bodies
Document Name and Reference | Treated As | Volumetric Properties | Document Path/Date Modified

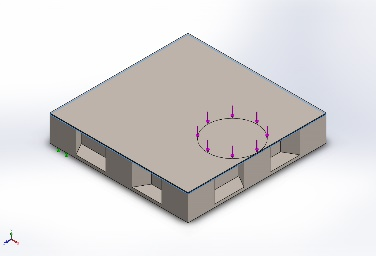
[picture p264: figure]

Boss-Extrude1 | Solid Body | Mass:0.0106851 kg Volume:4.87902e-06 m^3 Density:2,190 kg/m^3 Weight:0.104714 N | C:\Users\Natha\Desktop\Caltech 2020-2024\NASA_Big_Idea_Challenge\GrabCAD\Current\Mechanical\v4_Eggdee\Parts\adhesive_v4.1.SLDPRT May 16 13:19:20 2021

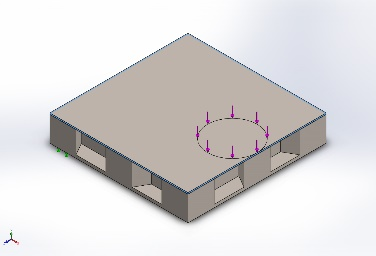
[picture p265: figure]

Boss-Extrude1 | Solid Body | Mass:0.0106851 kg Volume:4.87902e-06 m^3 Density:2,190 kg/m^3 Weight:0.104714 N | C:\Users\Natha\Desktop\Caltech 2020-2024\NASA_Big_Idea_Challenge\GrabCAD\Current\Mechanical\v4_Eggdee\Parts\adhesive_v4.1.SLDPRT May 16 13:19:20 2021

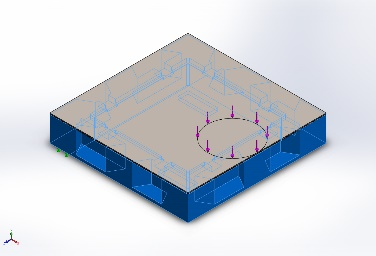
[picture p266: figure]

CirPattern2 | Solid Body | Mass:0.534853 kg Volume:0.000212243 m^3 Density:2,520 kg/m^3 Weight:5.24155 N | C:\Users\Natha\Desktop\Caltech 2020-2024\NASA_Big_Idea_Challenge\GrabCAD\Current\Mechanical\v4_Eggdee\Simplified_Parts\bplate_simplified_borderless_cantilever.SLDPRT May 16 22:55:42 2021

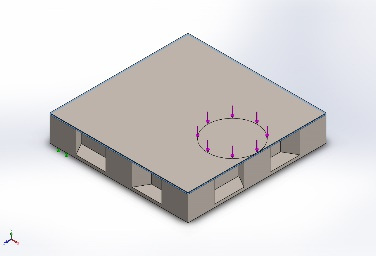
[picture p267: figure]

Boss-Extrude1 | Solid Body | Mass:0.00831385 kg Volume:5.85483e-06 m^3 Density:1,420 kg/m^3 Weight:0.0814758 N | C:\Users\Natha\Desktop\Caltech 2020-2024\NASA_Big_Idea_Challenge\GrabCAD\Current\Mechanical\v4_Eggdee\Simplified_Parts\pcb_simplified_nofillet.SLDPRT May 16 16:25:29 2021

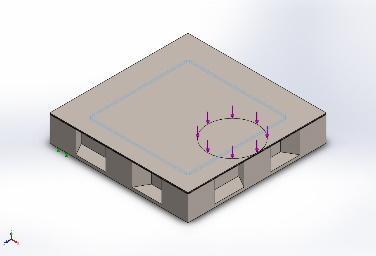
[picture p268: figure]

Fillet1 | Solid Body | Mass:0.0319938 kg Volume:1.59969e-05 m^3 Density:2,000 kg/m^3 Weight:0.313539 N | C:\Users\Natha\Desktop\Caltech 2020-2024\NASA_Big_Idea_Challenge\GrabCAD\Current\Mechanical\v4_Eggdee\Parts\power_supply_pcb_mockup_v4.2.SLDPRT May 15 11:00:41 2021

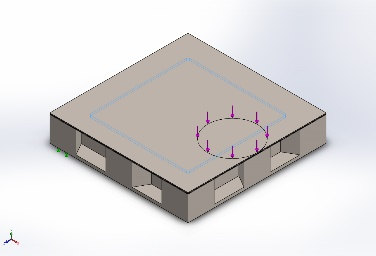
[picture p269: figure]

Fillet1 | Solid Body | Mass:0.0269748 kg Volume:1.89963e-05 m^3 Density:1,420 kg/m^3 Weight:0.264353 N | C:\Users\Natha\Desktop\Caltech 2020-2024\NASA_Big_Idea_Challenge\GrabCAD\Current\Mechanical\v4_Eggdee\Simplified_Parts\separation_layer_simplified.SLDPRT May 16 13:10:37 2021

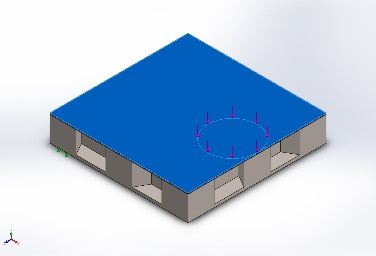
[picture p270: figure]

Split Line1 | Solid Body | Mass:0.0494616 kg Volume:1.24903e-05 m^3 Density:3,960 kg/m^3 Weight:0.484723 N | C:\Users\Natha\Desktop\Caltech 2020-2024\NASA_Big_Idea_Challenge\GrabCAD\Current\Mechanical\v4_Eggdee\Simplified_Parts\tplate_simplified_cantilever.SLDPRT May 16 22:53:55 2021

# Study Properties

Study name | cantilever
Analysis type | Static
Mesh type | Solid Mesh
Thermal Effect: | On
Thermal option | Include temperature loads
Zero strain temperature | 298 Kelvin
Include fluid pressure effects from SOLIDWORKS Flow Simulation | Off
Solver type | FFEPlus
Inplane Effect: | Off
Soft Spring: | Off
Inertial Relief: | Off
Incompatible bonding options | Automatic
Large displacement | Off
Compute free body forces | On
Friction | Off
Use Adaptive Method: | Off
Result folder | SOLIDWORKS document (C:\Users\Natha\Desktop\Caltech 2020-2024\NASA_Big_Idea_Challenge\GrabCAD\Current\Mechanical\v4_Eggdee\Simplified_Parts\5.16_Cantilever_Simplified_Borderless)

# Units

Unit system: | SI (MKS)
Length/Displacement | mm
Temperature | Kelvin
Angular velocity | Rad/sec
Pressure/Stress | N/m^2

# Material Properties

Model Reference | Properties | Components

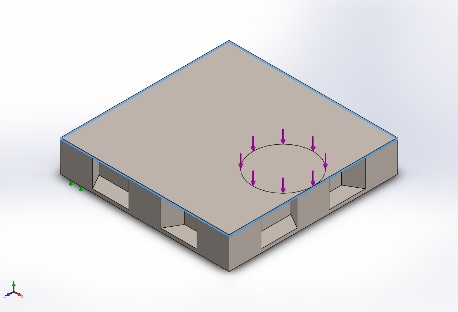
[picture p271: figure]

| Name: STYCAST 2850FT/Catalyst 23LV Model type: Linear Elastic Isotropic Default failure criterion: Unknown Tensile strength: 1.0549e+08 N/m^2 Compressive strength: 1.19969e+08 N/m^2 Elastic modulus: 6.413e+09 N/m^2 Mass density: 2,190 kg/m^3 | SolidBody 1(Boss-Extrude1)(adhesive_v4.1-1), SolidBody 1(Boss-Extrude1)(adhesive_v4.1-2)

Curve Data:N/A

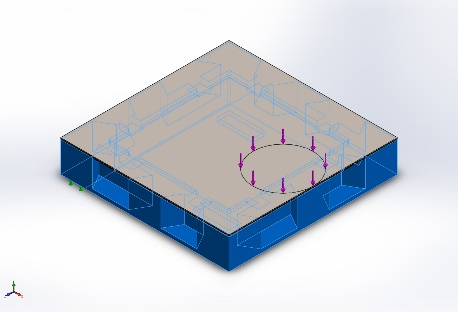
[picture p272: figure]

| Name: Macor Model type: Linear Elastic Isotropic Default failure criterion: Mohr-Coulomb Stress Yield strength: 3.3e+07 N/m^2 Tensile strength: 3.3e+07 N/m^2 Compressive strength: 3.45e+08 N/m^2 Elastic modulus: 6.69e+10 N/m^2 Poisson's ratio: 0.29 Mass density: 2,520 kg/m^3 Shear modulus: 2.55e+10 N/m^2 Thermal expansion coefficient: 8.1e-06 /Kelvin | SolidBody 1(CirPattern2)(bplate_simplified_borderless_cantilever-1)

Curve Data:N/A

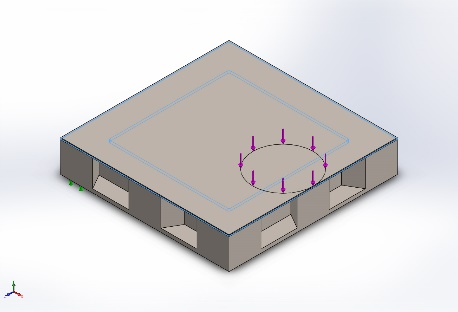
[picture p273: figure]

| Name: Kapton HN Model type: Linear Elastic Isotropic Default failure criterion: Unknown Yield strength: 6.9e+07 N/m^2 Tensile strength: 2.31e+08 N/m^2 Compressive strength: 2.31e+08 N/m^2 Elastic modulus: 2.76e+09 N/m^2 Poisson's ratio: 0.34 Mass density: 1,420 kg/m^3 Thermal expansion coefficient: 20 /Kelvin | SolidBody 1(Boss-Extrude1)(pcb_simplified_nofillet-1), SolidBody 1(Fillet1)(separation_layer_simplified-1)

Curve Data:N/A

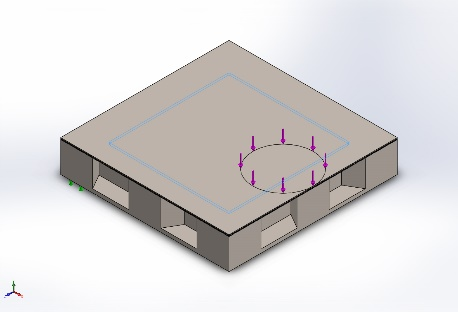
[picture p274: figure]

| Name: FR4 Model type: Linear Elastic Isotropic Default failure criterion: Unknown Yield strength: 3.45e+08 N/m^2 Tensile strength: 3.45e+08 N/m^2 Compressive strength: 3.5e+08 N/m^2 Elastic modulus: 2.156e+10 N/m^2 Poisson's ratio: 0.136 Mass density: 2,000 kg/m^3 | SolidBody 1(Fillet1)(power_supply_pcb_mockup_v4.2-1)

Curve Data:N/A

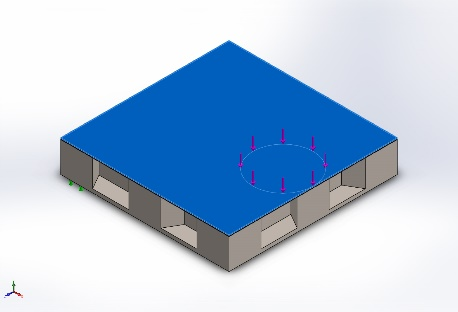
[picture p275: figure]

| Name: Alumina Model type: Linear Elastic Isotropic Default failure criterion: Unknown Tensile strength: 3e+08 N/m^2 Compressive strength: 3e+09 N/m^2 Elastic modulus: 3.7e+11 N/m^2 Poisson's ratio: 0.22 Mass density: 3,960 kg/m^3 Shear modulus: 1.5e+11 N/m^2 Thermal expansion coefficient: 7e-06 /Kelvin | SolidBody 1(Split Line1)(tplate_simplified_cantilever-1)

Curve Data:N/A

# Loads and Fixtures

Fixture name | Fixture Image | Fixture Details

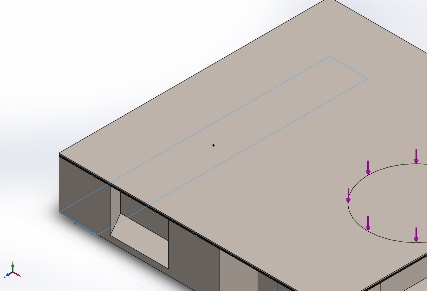
[picture p276: figure]

Fixed-1 | | Entities: 1 face(s) Type: Fixed Geometry

Resultant Forces

Components | X | Y | Z | Resultant
Reaction force(N) | -6.10352e-05 | 486 | 1.90735e-06 | 486
Reaction Moment(N.m) | 0 | 0 | 0 | 0

Load name | Load Image | Load Details

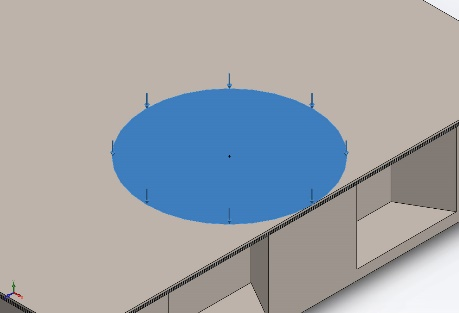
[picture p277: figure]

Force-1 | | Entities: 1 face(s) Type: Apply normal force Value: 486 N

# Connector Definitions

No Data

# Contact Information

Contact | Contact Image | Contact Properties

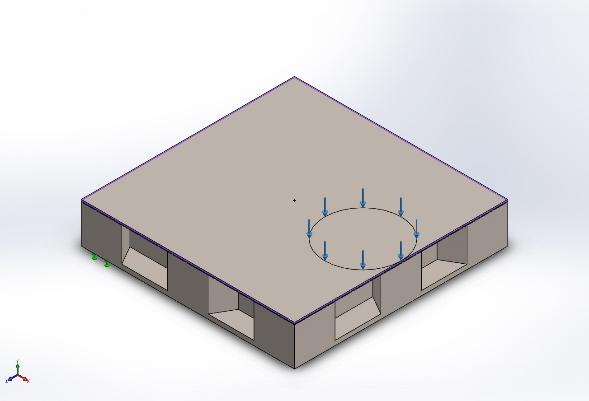
[picture p278: figure]

Contact Set-1 | | Type: Bonded contact pair Entities: 2 face(s)

Contact/Friction force

Components | X | Y | Z | Resultant
Contact Force(N) | 0 | 1.7099 | 0 | 1.7099

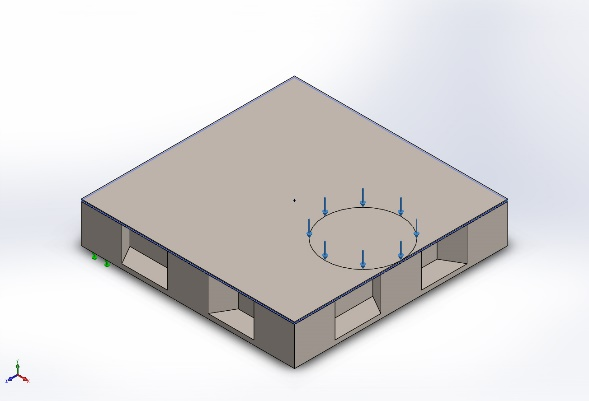
[picture p279: figure]

Contact Set-2 | | Type: Bonded contact pair Entities: 2 face(s)

Contact/Friction force

Components | X | Y | Z | Resultant
Contact Force(N) | 0 | 56.174 | 0 | 56.174

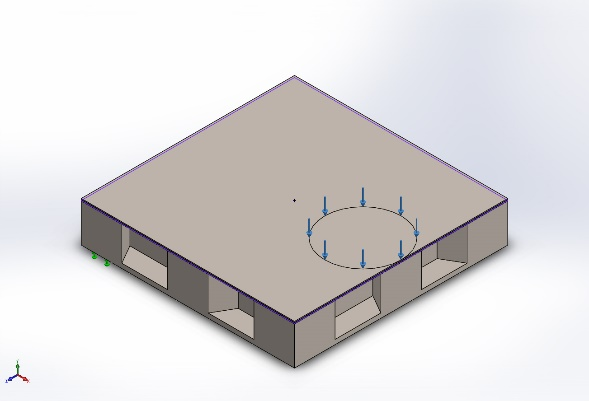
[picture p280: figure]

Contact Set-3 | | Type: Bonded contact pair Entities: 2 face(s)

Contact/Friction force

Components | X | Y | Z | Resultant
Contact Force(N) | 1.5168E-15 | -21.632 | 4.3209E-07 | 21.632

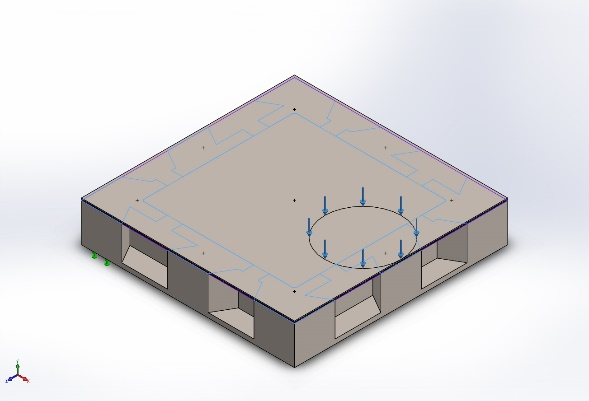
[picture p281: figure]

Contact Set-4 | | Type: Bonded contact pair Entities: 10 face(s)

Contact/Friction force

Components | X | Y | Z | Resultant
Contact Force(N) | 23.592 | 63.931 | 0.90062 | 68.151

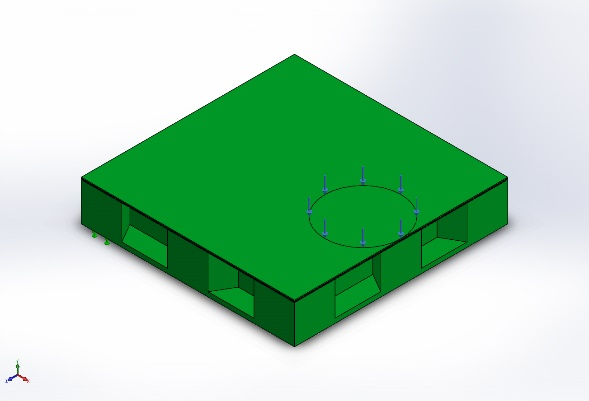
[picture p282: figure]

Component Contact-1 | | Type: No penetration (Surface to surface) Components: 7 component(s)

# Mesh information

Mesh type | Solid Mesh
Mesher Used: | Standard mesh
Automatic Transition: | Off
Include Mesh Auto Loops: | Off
Jacobian points | 4 Points
Element Size | 0.2 in
Tolerance | 0.01 in
Mesh Quality Plot | High
Remesh failed parts with incompatible mesh | Off

## Mesh information - Details

Total Nodes | 82557
Total Elements | 44648
Maximum Aspect Ratio | 182.12
% of elements with Aspect Ratio < 3 | 33.3
% of elements with Aspect Ratio > 10 | 46.2
% of distorted elements(Jacobian) | 0
Time to complete mesh(hh;mm;ss): | 00:00:13
Computer name: | THICCO

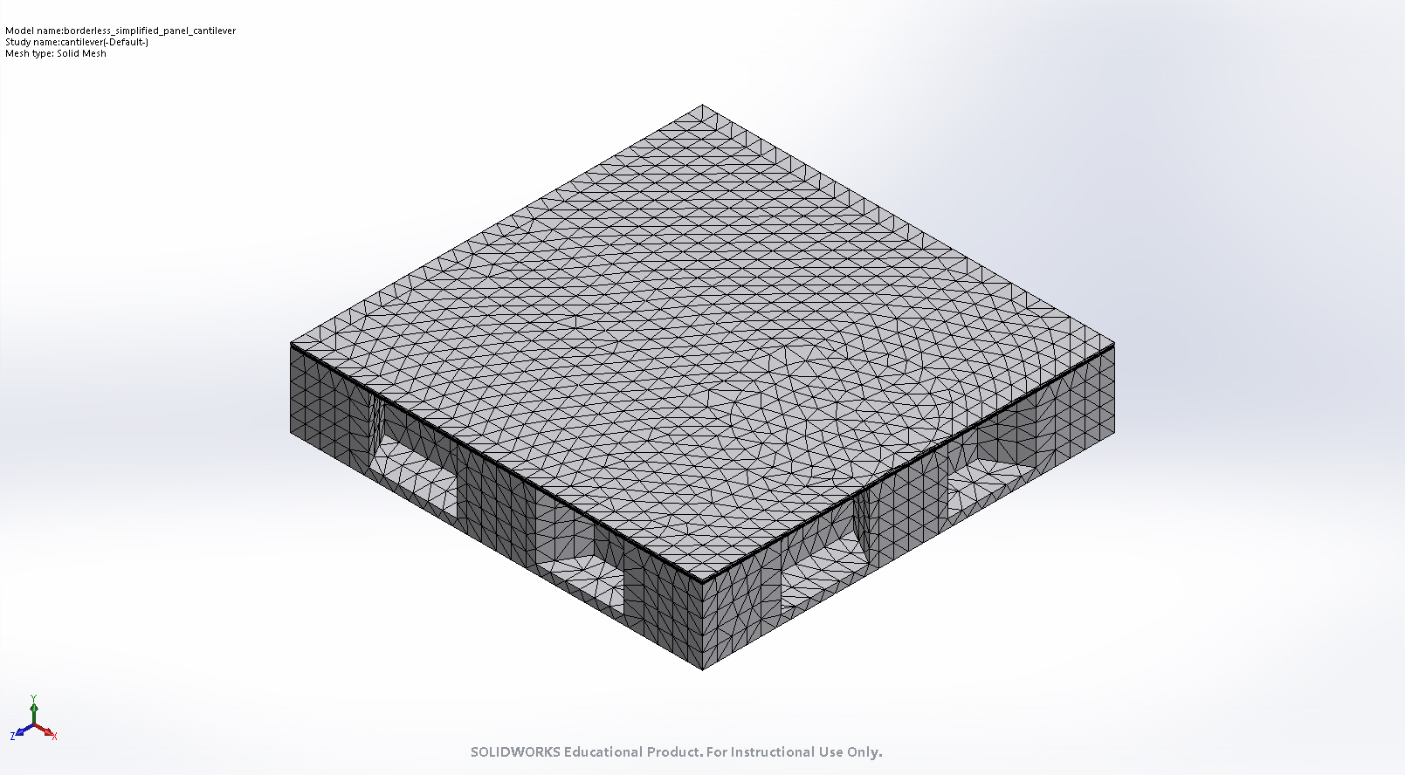
[picture p283: figure]

## Mesh Control Information:

Mesh Control Name | Mesh Control Image | Mesh Control Details

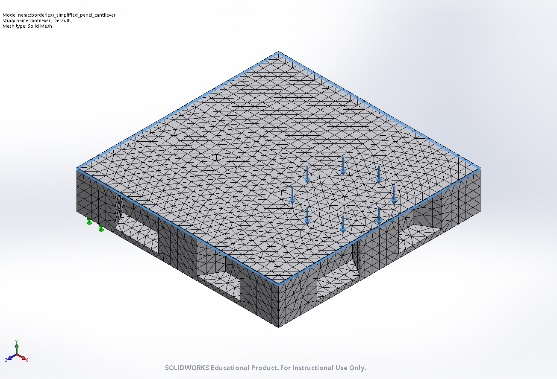
[picture p284: figure]

Control-1 | | Entities: 2 Solid Body (s) Units: in Size: 0.195 Ratio: 0.195

# Sensor Details

No Data

# Resultant Forces

## Reaction forces

Selection set | Units | Sum X | Sum Y | Sum Z | Resultant
Entire Model | N | -6.10352e-05 | 486 | 1.90735e-06 | 486

## Reaction Moments

Selection set | Units | Sum X | Sum Y | Sum Z | Resultant
Entire Model | N.m | 0 | 0 | 0 | 0

# Beams

No Data

# Study Results

Name | Type | Min | Max
Stress1 | VON: von Mises Stress | 7.849e+03 N/m^2 Node: 64701 | 3.600e+07 N/m^2 Node: 76946

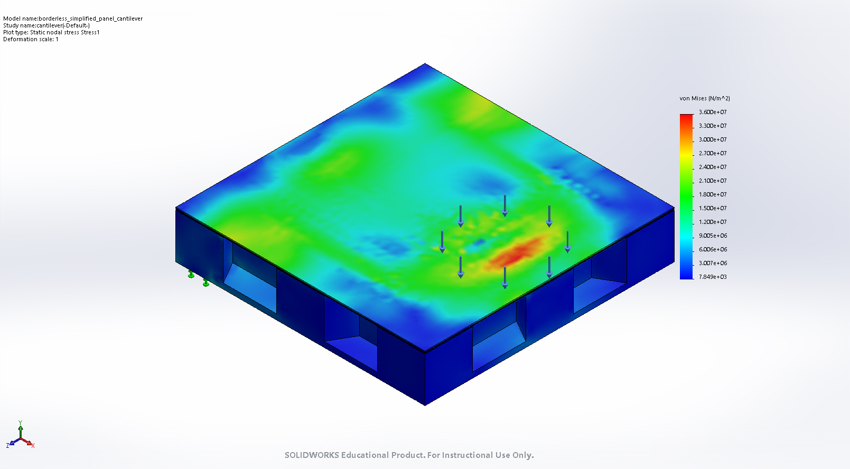
[picture p285: figure]

borderless_simplified_panel_cantilever-cantilever-Stress-Stress1

Name | Type | Min | Max
Displacement1 | URES: Resultant Displacement | 0.000e+00 mm Node: 27773 | 8.200e-02 mm Node: 82334

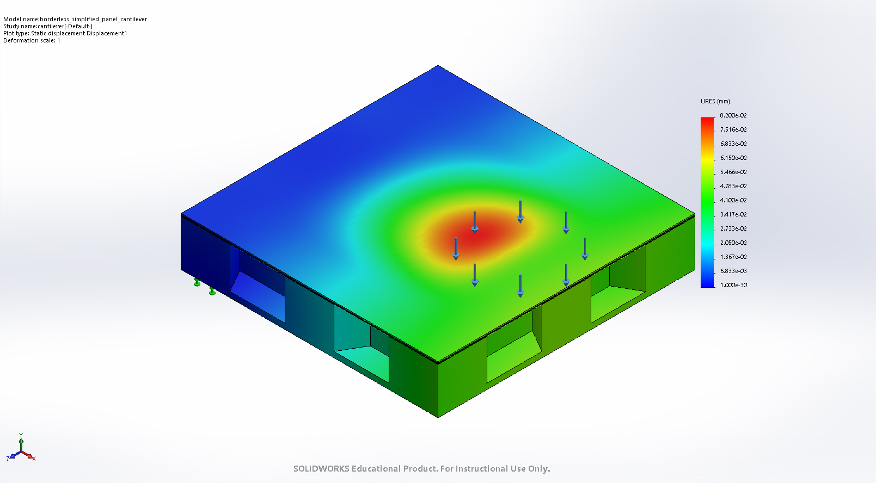
[picture p286: figure]

borderless_simplified_panel_cantilever-cantilever-Displacement-Displacement1

Name | Type | Min | Max
Strain1 | ESTRN: Equivalent Strain | 2.056e-07 Element: 37467 | 5.904e-04 Element: 33782

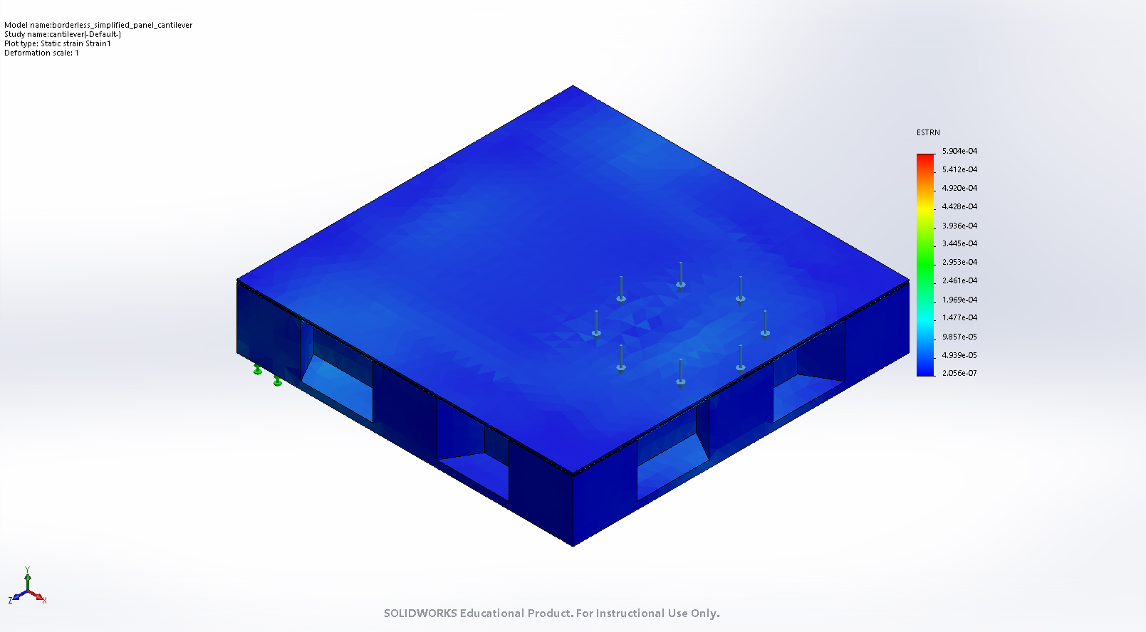
[picture p287: figure]

borderless_simplified_panel_cantilever-cantilever-Strain-Strain1

Name | Type | Min | Max
Factor of Safety1 | Mohr-Coulomb Stress | 2.642e+00 Node: 28681 | 3.000e+00 Node: 1

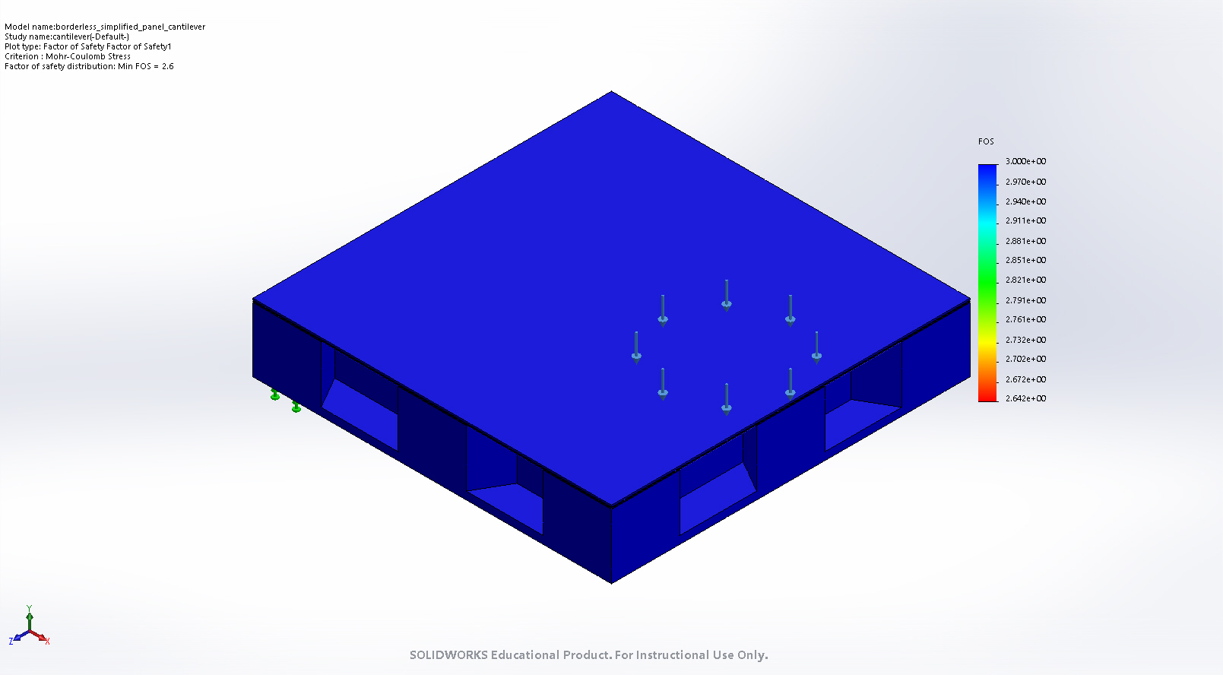
[picture p288: figure]

borderless_simplified_panel_cantilever-cantilever-Factor of Safety-Factor of Safety1

# Conclusion

Analyzed with SOLIDWORKS Simulation Simulation of borderless_simplified_panel_cantilever 7

Analyzed with SOLIDWORKS Simulation Simulation of borderless_simplified_panel_cantilever 1
