caltechcaos/Lunar-Dust-Challenge/Current/Mechanical/v4_Eggdee/Parts/PS_PCB/pspcbsurface.png

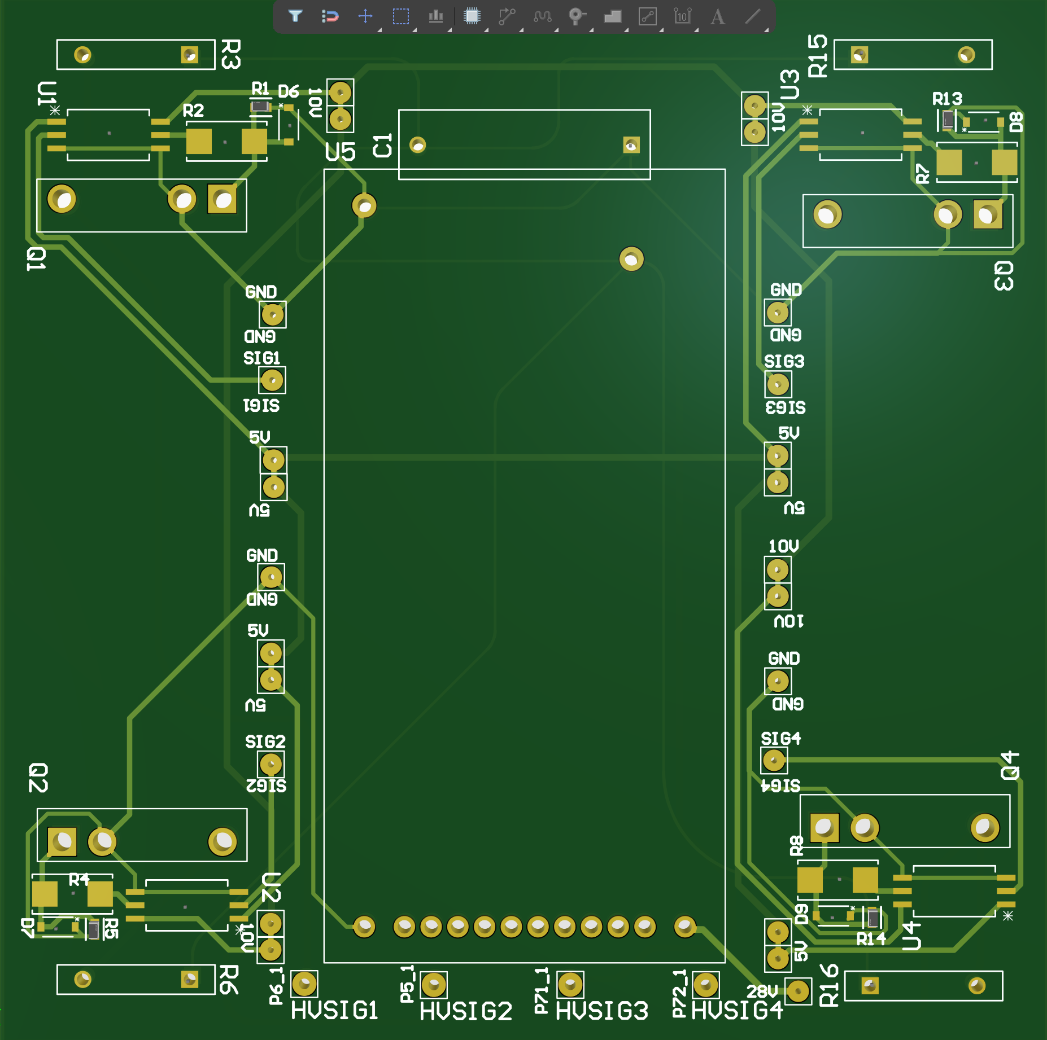
Current/Mechanical/v4_Eggdee/Parts/PS_PCB/pspcbsurface.png
