caltechcaos/Lunar-Dust-Challenge/Current/Mechanical/v5_Sussy_Baka/Render Parts/Redner 2.JPG

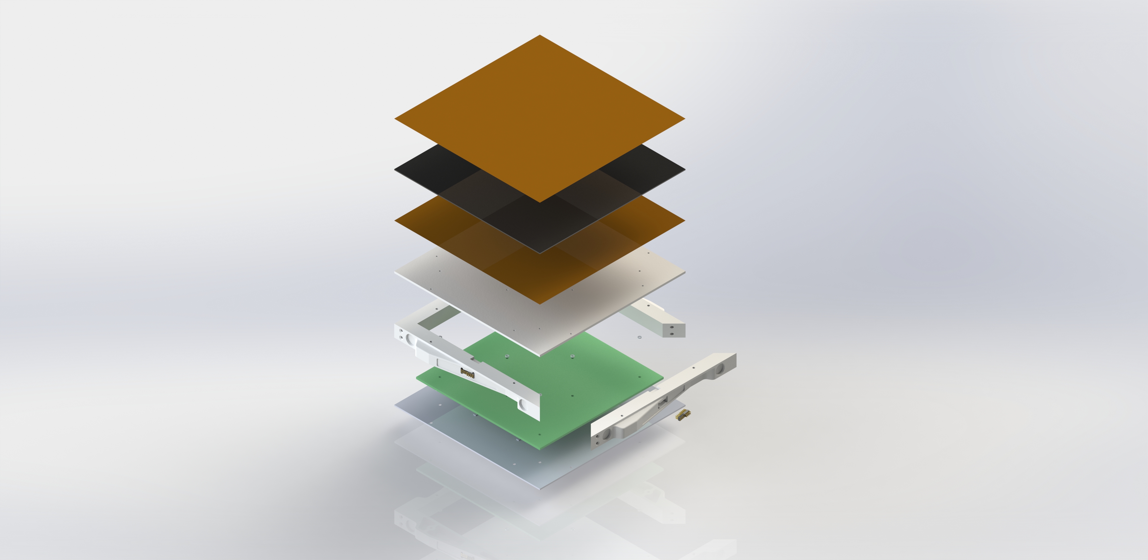
Current/Mechanical/v5_Sussy_Baka/Render Parts/Redner 2.JPG
