caltechcaos/Lunar-Dust-Challenge/Current/Mechanical/v5_Sussy_Baka/Render Parts/Render.JPG

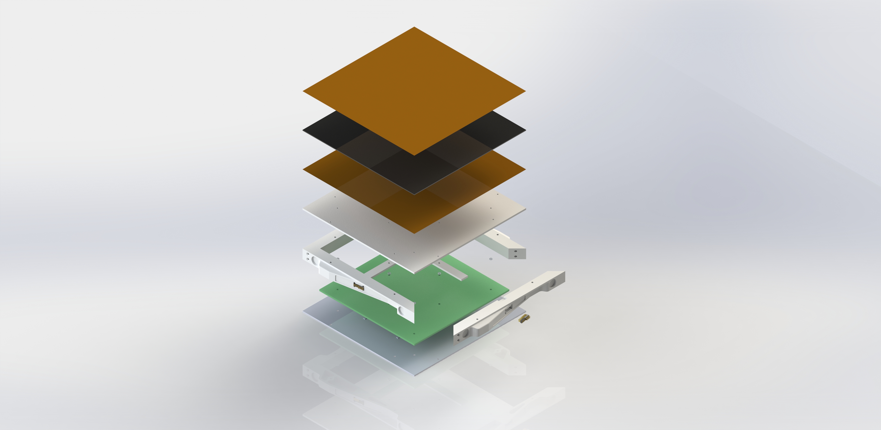
Current/Mechanical/v5_Sussy_Baka/Render Parts/Render.JPG
