caltechcaos/Lunar-Dust-Challenge/Current/Mechanical/v2_Yeet/Other_Assemblies/finger_joint_assembly_v2.1.SLDASM

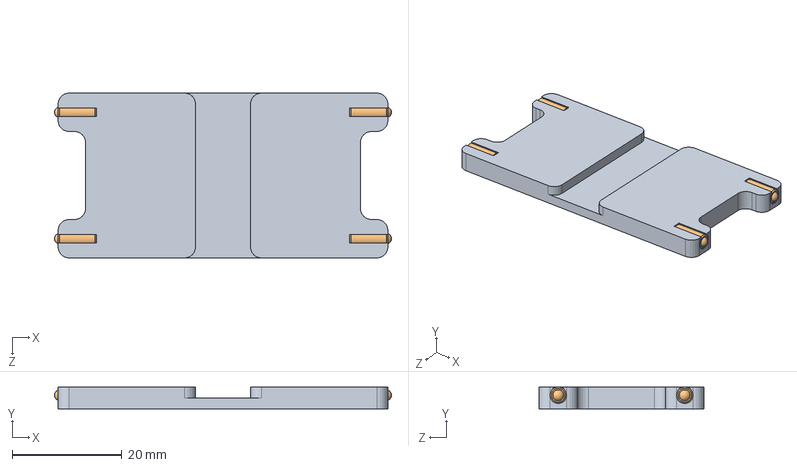
[picture p339: CAD file, 2023-12-22]
Current/Mechanical/v2_Yeet/Other_Assemblies/finger_joint_assembly_v2.1.SLDASM
61.3 x 4.00 x 30.0 mm
finger_joint_v2.1
8262A210_FLUSH-MOUNT_BALL_NOSE_SPRING_PLUNGER x 4
