caltechcaos/Lunar-Dust-Challenge/Current/Mechanical/v2_Yeet/panel_v2.1.SLDASM

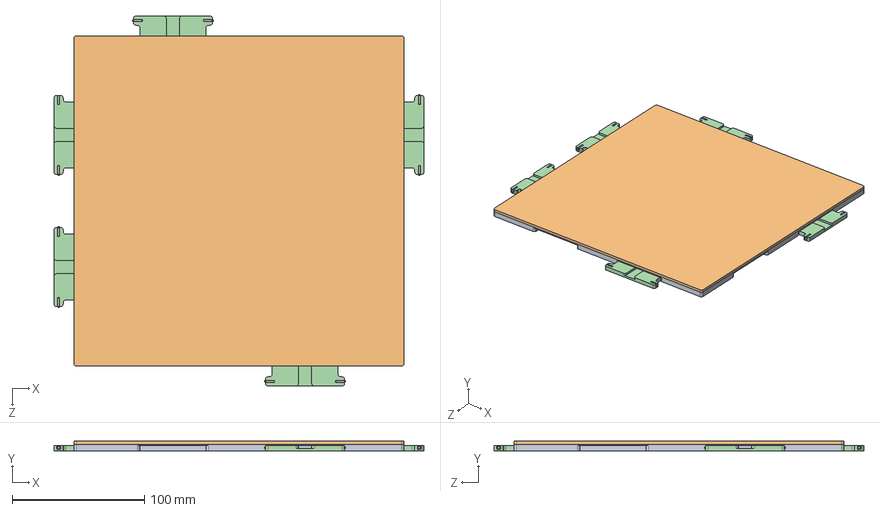
[picture p340: CAD file, 2023-12-22]
Current/Mechanical/v2_Yeet/panel_v2.1.SLDASM
280.0 x 7.50 x 280.0 mm
bplate_v2.1
tpanel_v2.1
90358A001_METRIC_STL_ULTRA-LOW-PROFILE_SCKT_HEAD_SCREW x 32
finger_joint_v2.1 x 4
8262A210_FLUSH-MOUNT_BALL_NOSE_SPRING_PLUNGER x 16
