caltechcaos/Lunar-Dust-Challenge/Current/Mechanical/v3_tiz/Other_Assemblies/finger_joint_assembly_v3.3.SLDASM

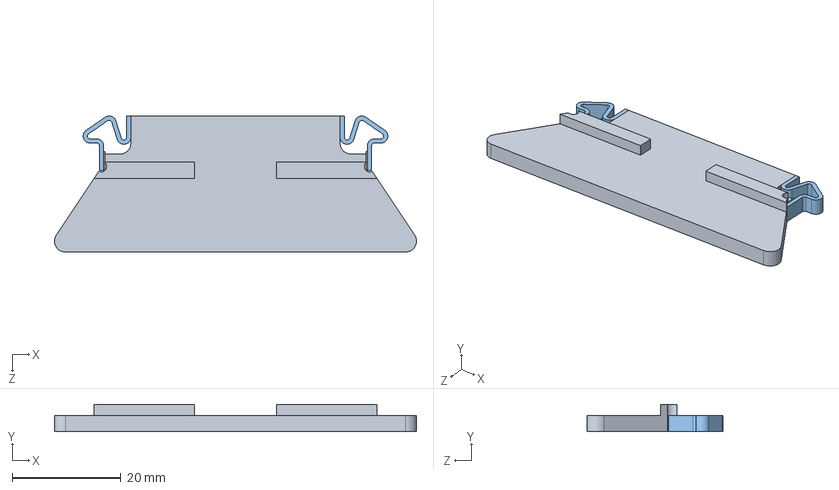
[picture p341: CAD file, 2023-12-22]
Current/Mechanical/v3_tiz/Other_Assemblies/finger_joint_assembly_v3.3.SLDASM
66.5 x 5.00 x 25.0 mm
finger_joint_v3.2
strip_1 x 2
metal_detent_v3.4 x 2
