caltechcaos/Lunar-Dust-Challenge/Current/Mechanical/v3_tiz/panel_v3.2.SLDASM

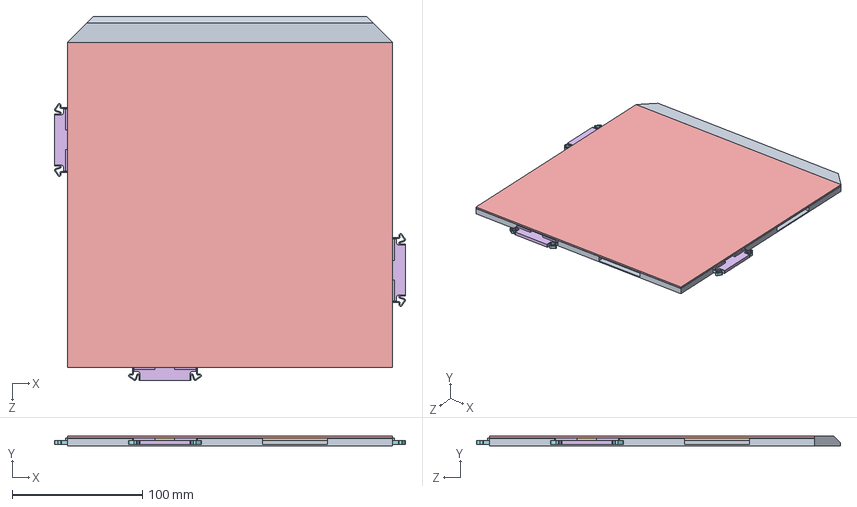
[picture p342: CAD file, 2023-12-22]
Current/Mechanical/v3_tiz/panel_v3.2.SLDASM
270.0 x 7.50 x 280.0 mm
bplate_v3.2
strip_2 x 4
strip_3 x 4
finger_joint_v3.2 x 4
strip_1 x 10
metal_detent_v3.4 x 10
