caltechcaos/Lunar-Dust-Challenge/Current/Mechanical/v4_Eggdee/Parts/Connectors/mill-max-826-22-008-00-005000_MALE.sldasm

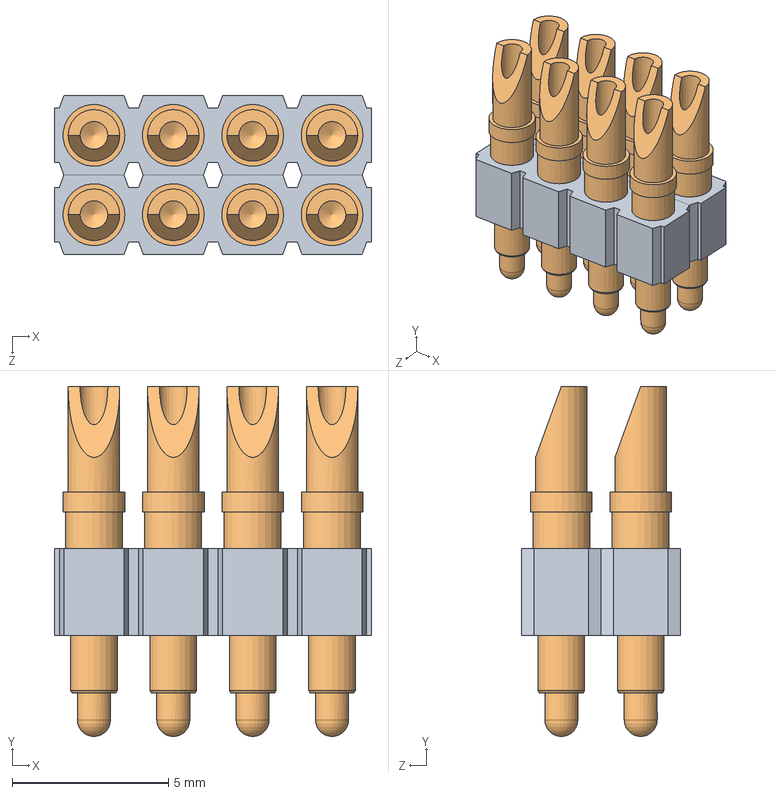
[picture p343: CAD file, 2023-12-22]
Current/Mechanical/v4_Eggdee/Parts/Connectors/mill-max-826-22-008-00-005000_MALE.sldasm
10.2 x 11.2 x 5.08 mm
mill-max-824-22-005-00-001000_P3XX-18-010-00-090000 x 2
mill-max-824-22-005-00-001000_0933 x 8
