caltechcaos/Lunar-Dust-Challenge/Current/Mechanical/v4_Eggdee/RENDERS/parul_renders/twopanels.SLDASM

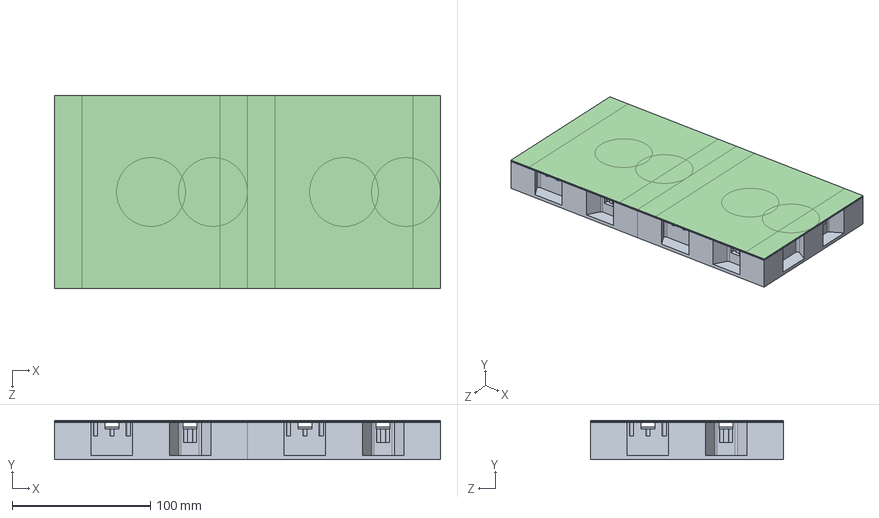
[picture p344: CAD file, 2023-12-22]
Current/Mechanical/v4_Eggdee/RENDERS/parul_renders/twopanels.SLDASM
279.4 x 28.3 x 139.7 mm
bplate_v4.4 x 2
adhesive_v4.1 x 4
pcb_mockup_v4.3 x 2
tplate_v4.1 x 2
