caltechcaos/Lunar-Dust-Challenge/Current/Mechanical/v5_Sussy_Baka/full_panel_asm.SLDASM

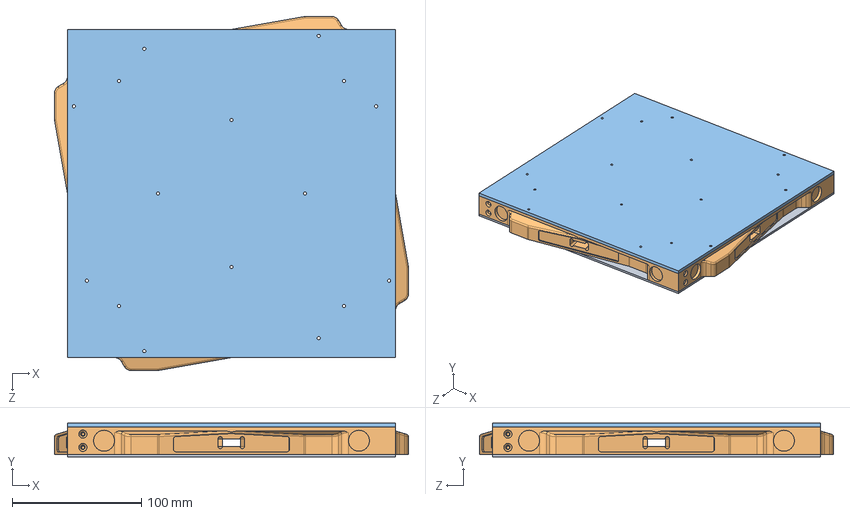
[picture p345: CAD file, 2023-12-22]
Current/Mechanical/v5_Sussy_Baka/full_panel_asm.SLDASM
274.0 x 26.3 x 274.0 mm
metal_backplate_v5.2
bplate_quarter_wall_v5.1 x 4
support_beam_v5.1 x 2
