caltechcaos/Lunar-Dust-Challenge/Current/Mechanical/v5_Sussy_Baka/Render Parts/full_panel_render.SLDASM

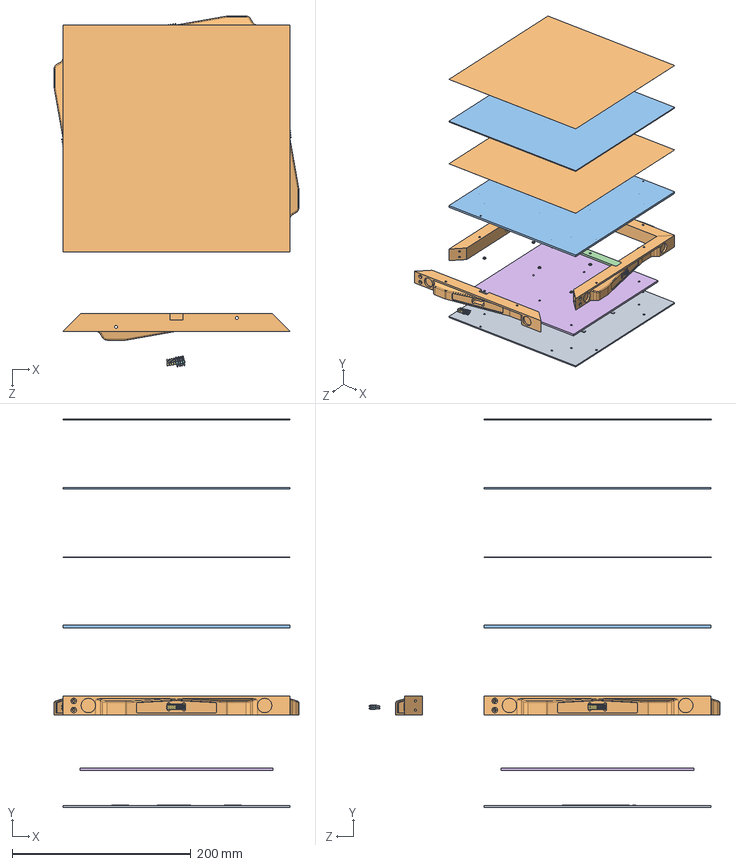
[picture p346: CAD file, 2023-12-22]
Current/Mechanical/v5_Sussy_Baka/Render Parts/full_panel_render.SLDASM
274.0 x 434.3 x 392.8 mm
metal_backplate_v5.2
bplate_quarter_wall_v5.1 x 4
peek_support_plate_v5.1
1mm_spacer x 8
ps_pcb_mockup_v5.1
mill-max-430-10-208-00-240000 x 4
mill-max-824-22-005-00-001000_P3XX-18-010-00-090000 x 8
mill-max-824-22-005-00-001000_0933 x 32
Kapton x 2
EDS_PCB
