caltechcaos/Lunar-Dust-Challenge/EASE/Cosmetic_Components/EASE_Cosmetic_Assembly - Panel_Wiring_Assy-1 mill-max-319-10-105-00-006000_FEMALE-1 mill-max-319-10-105-00-006000_1948-4.STL

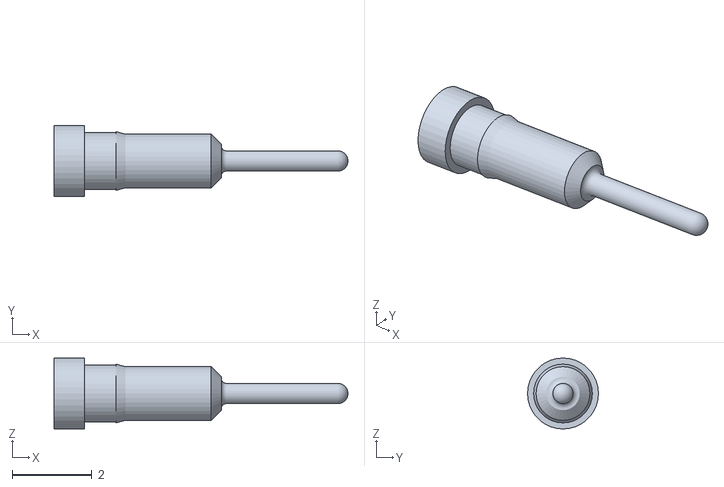
[picture p347: CAD file, 2023-12-22]
EASE/Cosmetic_Components/EASE_Cosmetic_Assembly - Panel_Wiring_Assy-1 mill-max-319-10-105-00-006000_FEMALE-1 mill-max-319-10-105-00-006000_1948-4.STL
7.37 x 1.78 x 1.78
