caltechcaos/Lunar-Dust-Challenge/EASE/Example_Configurations/Combinations/2x2.SLDASM

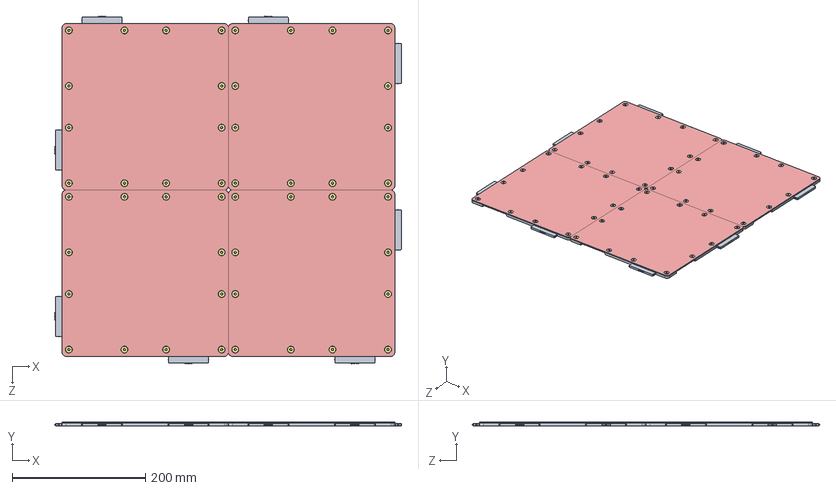
[picture p348: CAD file, 2023-12-22]
EASE/Example_Configurations/Combinations/2x2.SLDASM
521.4 x 6.60 x 522.8 mm
EASE_Bottom_Plate x 4
mill-max-319-10-105-00-006000_P3XX-11-010-00-000000 x 16
mill-max-319-10-105-00-006000_1948 x 80
mill-max-824-22-005-00-001000_P3XX-18-010-00-090000 x 12
mill-max-824-22-005-00-001000_0933 x 60
HIGH_Wire^Panel_Wiring_Assy x 28
MID_Wire^Panel_Wiring_Assy x 28
LOW_Wire^Panel_Wiring_Assy x 28
Twisted_3_Wires^Panel_Wiring_Assy x 4
MID_Electrode^Panel_Wiring_Assy x 4
LOW_Electrode^Panel_Wiring_Assy x 4
HIGH_Electrode^Panel_Wiring_Assy x 4
EASE_Top_Plate x 4
8262A210_FLUSH-MOUNT BALL NOSE SPRING PLUNGER x 32
93395A296_TYPE 316 SS FLAT-HEAD SOCKET CAP SCREW x 48
