caltechcaos/Lunar-Dust-Challenge/EASE/STEP_Assemblies/Electronics_Box_Assembly.STEP

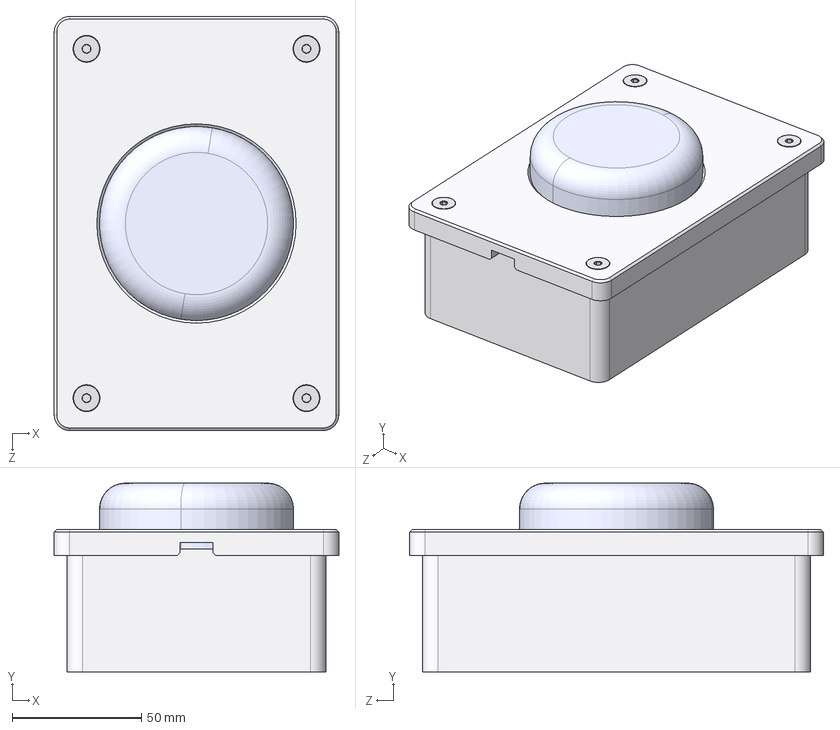
[picture p349: CAD file, 2023-12-22]
EASE/STEP_Assemblies/Electronics_Box_Assembly.STEP
110.0 x 72.9 x 160.0 mm
Electronics_Box_Bottom
Electronics_Box_Top
Electronics_Box_Button
93395A296_TYPE 316 SS FLAT-HEAD SOCKET CAP SCREW_93395A296 x 4
