caltechcaos/Lunar-Dust-Challenge/Current/Mechanical/Finger Thickness Analysis/Version 2/Joint Assembly.SLDASM

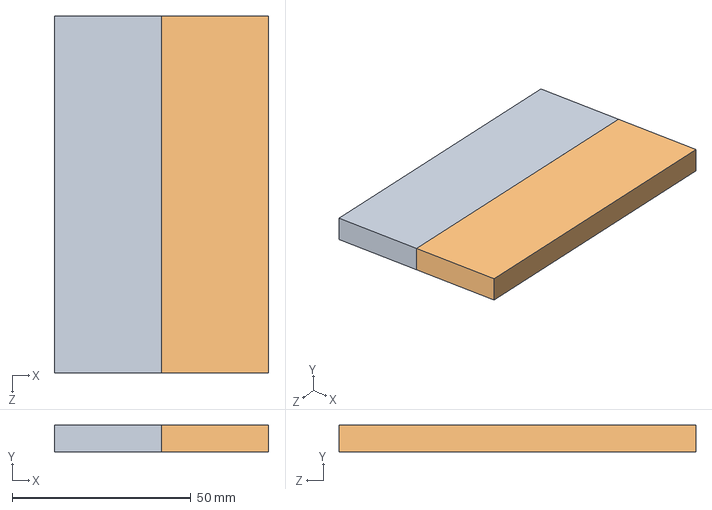
[picture p350: CAD file, 2023-12-22]
Current/Mechanical/Finger Thickness Analysis/Version 2/Joint Assembly.SLDASM
60.0 x 7.50 x 100.0 mm
Finger Analogue
Socket Analogue
