caltechcaos/Lunar-Dust-Challenge/Current/Mechanical/Prototype_Enclosures/eds_assembly.SLDASM

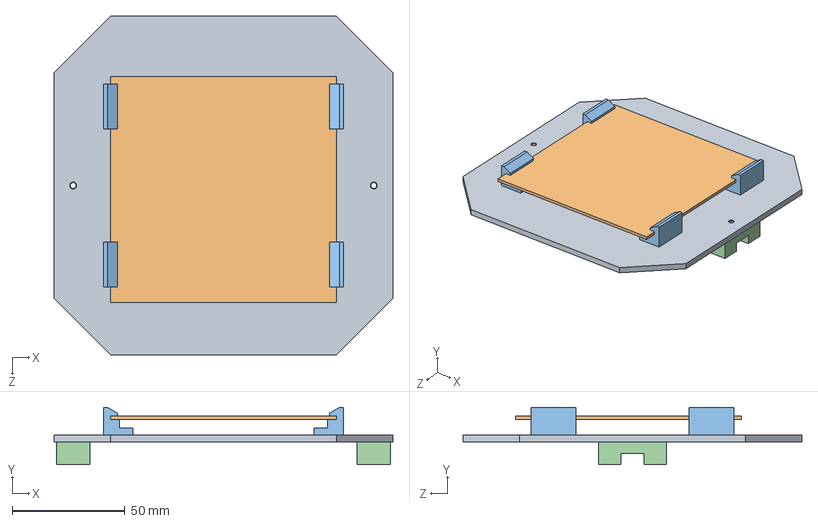
[picture p351: CAD file, 2023-12-22]
Current/Mechanical/Prototype_Enclosures/eds_assembly.SLDASM
150.0 x 25.3 x 150.0 mm
EDS_baseplate
EDS_model
pcb_standoff x 4
base_standoff x 2
