caltechcaos/Lunar-Dust-Challenge/Current/Mechanical/v4_Eggdee/Parts/PS_PCB_Sims/Rev 2 Integrated Assm^panel_assembly_vSIM.sldasm

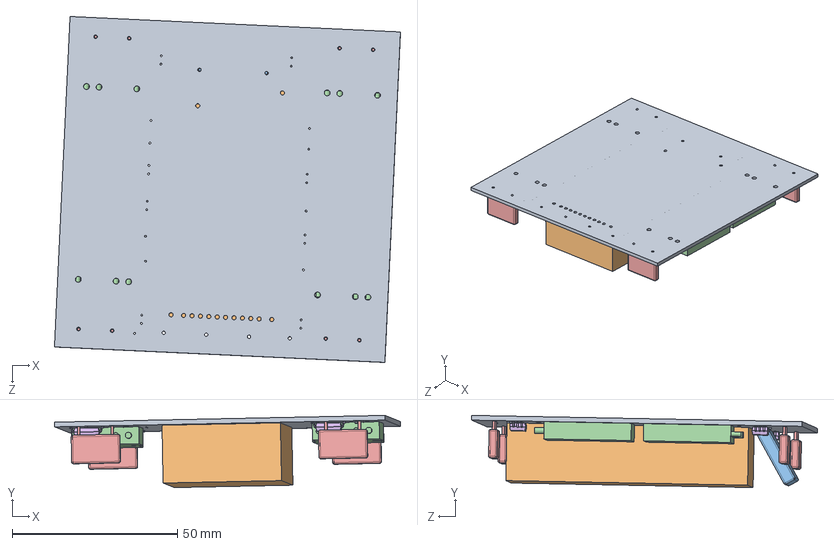
[picture p352: CAD file, 2023-12-22]
Current/Mechanical/v4_Eggdee/Parts/PS_PCB_Sims/Rev 2 Integrated Assm^panel_assembly_vSIM.sldasm
104.6 x 21.8 x 104.6 mm
compactPCB
HRL30_mockup
SV17KC273KAR
MOSFET_mockup x 4
SLIM-MOX10203 x 4
gatedriver_mockup x 4
