caltechcaos/Lunar-Dust-Challenge/Current/Mechanical/v4_Eggdee/RENDERS/parul_renders/onepanel_v2.SLDASM

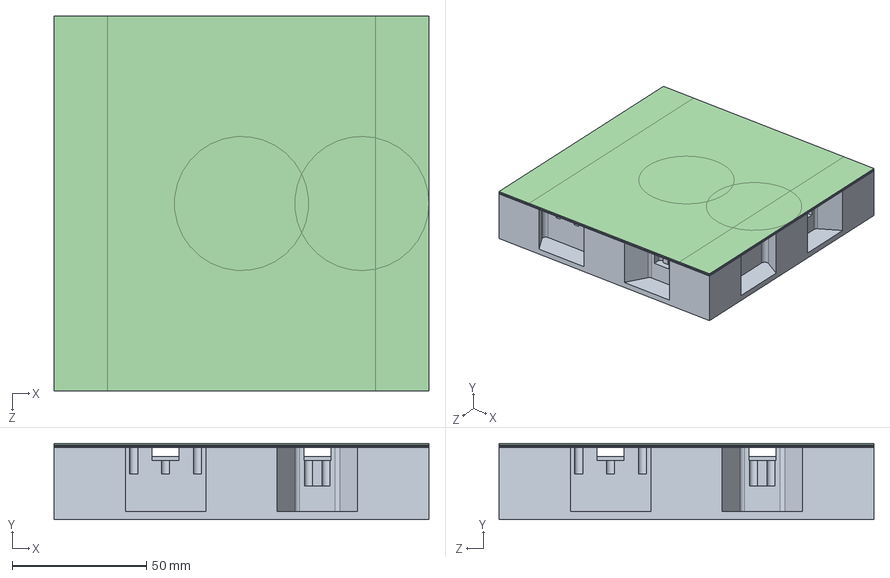
[picture p353: CAD file, 2023-12-22]
Current/Mechanical/v4_Eggdee/RENDERS/parul_renders/onepanel_v2.SLDASM
139.7 x 28.3 x 139.7 mm
bplate_v4.4
adhesive_v4.1 x 2
pcb_mockup_v4.3
tplate_v4.1
