caltechcaos/Lunar-Dust-Challenge/EASE/Cosmetic_Components/EASE_Cosmetic_Assembly - Panel_Wiring_Assy-1 mill-max-824-22-005-00-001000_MALE-1 mill-max-824-22-005-00-001000_0933-5.STL

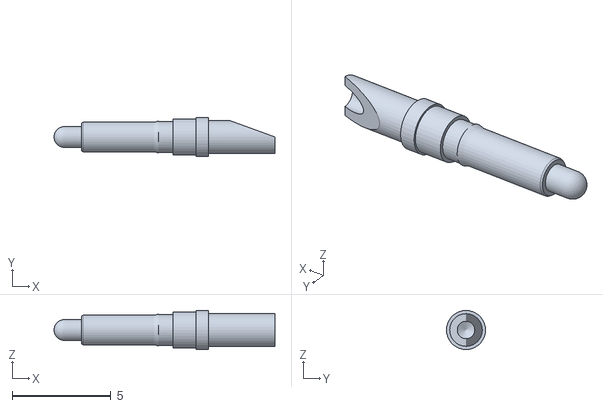
[picture p354: CAD file, 2023-12-22]
EASE/Cosmetic_Components/EASE_Cosmetic_Assembly - Panel_Wiring_Assy-1 mill-max-824-22-005-00-001000_MALE-1 mill-max-824-22-005-00-001000_0933-5.STL
11.2 x 1.98 x 1.98
