caltechcaos/Lunar-Dust-Challenge/PDR/Mat/V4/full_panels-assy.SLDASM

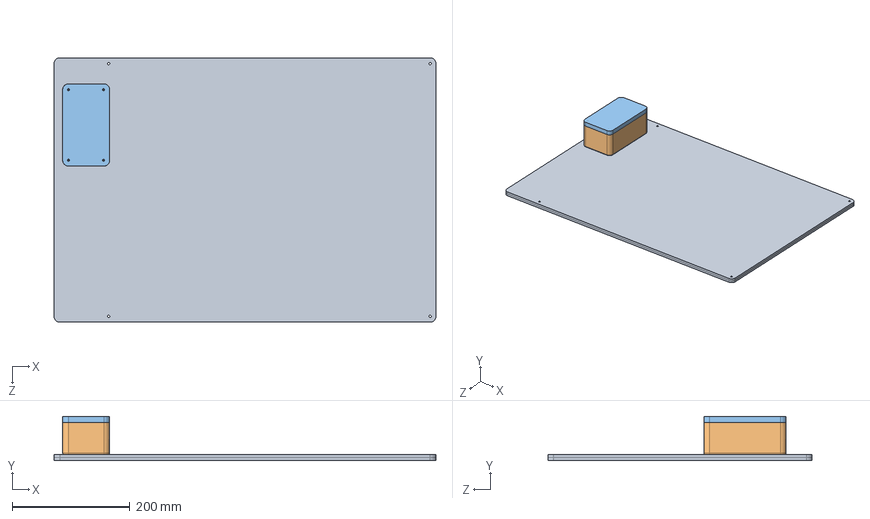
[picture p357: CAD file, 2023-12-22]
PDR/Mat/V4/full_panels-assy.SLDASM
650.0 x 75.0 x 450.0 mm
plate_bottom_v3 (1) x 2
elec_box
elec_box_lid
