caltechcaos/Lunar-Dust-Challenge/Current/Mechanical/Prototype_Enclosures/assy_HRL30.SLDASM

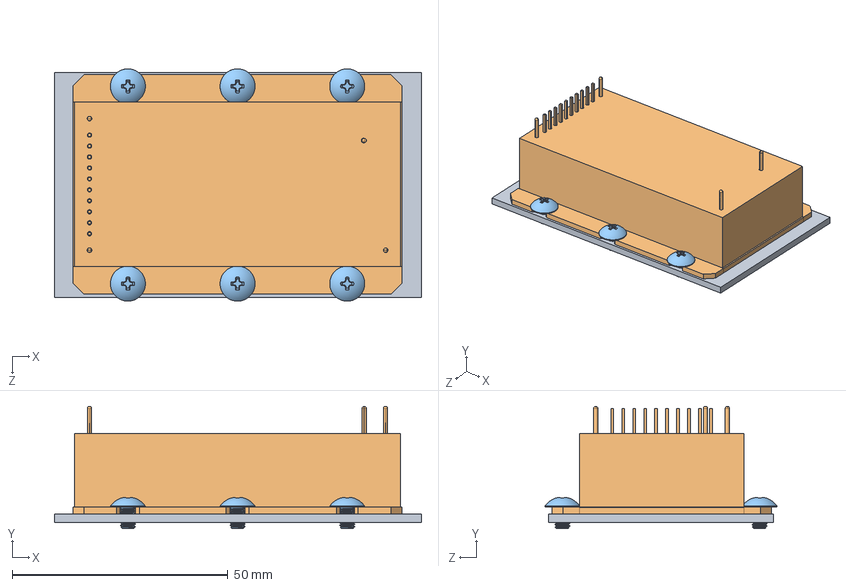
[picture p358: CAD file, 2023-12-22]
Current/Mechanical/Prototype_Enclosures/assy_HRL30.SLDASM
85.0 x 28.4 x 53.8 mm
baseplate_HRL30
HRL30
92467A489_18-8 SS EXTRA-WIDE TRUSS HEAD PHILLIPS SCREWS x 6
