caltechcaos/Lunar-Dust-Challenge/Current/Mechanical/v3_tiz/FEA/FEA_Assembly.SLDASM

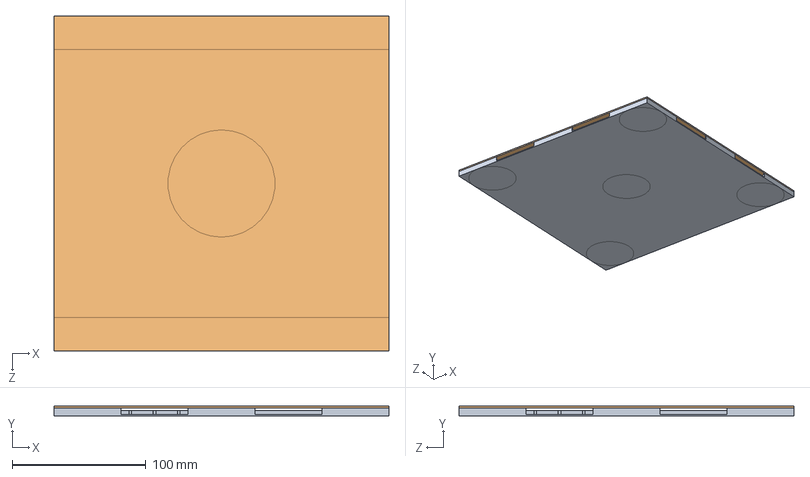
[picture p359: CAD file, 2023-12-22]
Current/Mechanical/v3_tiz/FEA/FEA_Assembly.SLDASM
250.0 x 7.25 x 250.0 mm
FEAbplate_v3.2
FEAtplate_v3.2
