caltechcaos/Lunar-Dust-Challenge/Current/Mechanical/v3_tiz/Other_Assemblies/end_cap_assembly_v3.1.SLDASM

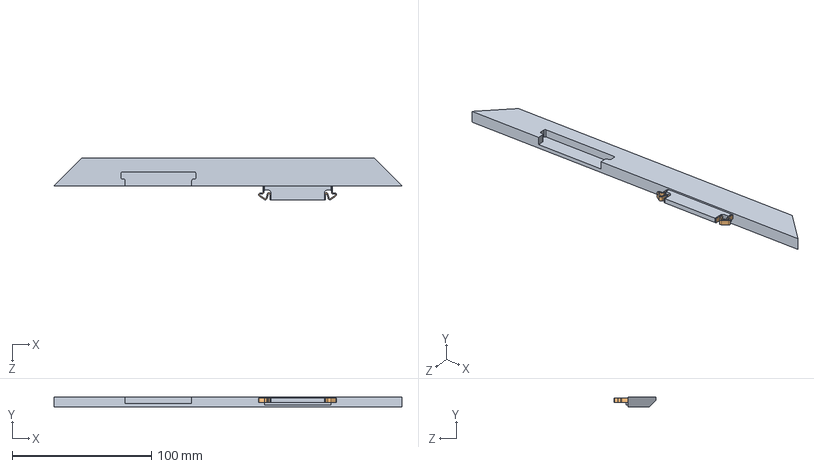
[picture p360: CAD file, 2023-12-22]
Current/Mechanical/v3_tiz/Other_Assemblies/end_cap_assembly_v3.1.SLDASM
250.0 x 7.50 x 30.0 mm
end_cap_v3.2
metal_detent_v3.4 x 2
strip_1 x 2
