caltechcaos/Lunar-Dust-Challenge/Current/Mechanical/v4_Eggdee/3D_Prints/connector_assembly_jig.SLDPRT

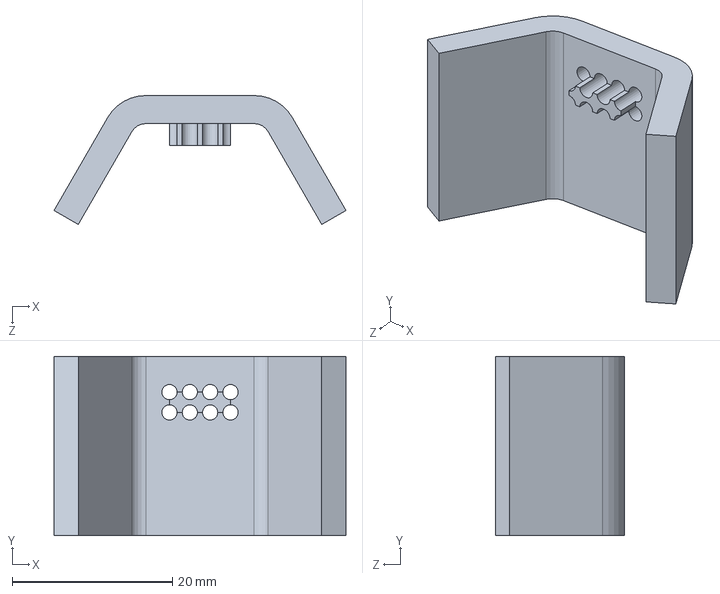
[picture p361: CAD file, 2023-12-22]
Current/Mechanical/v4_Eggdee/3D_Prints/connector_assembly_jig.SLDPRT
36.5 x 22.4 x 16.1 mm
