caltechcaos/Lunar-Dust-Challenge/Current/Mechanical/v4_Eggdee/multipanels_assembly_v1.SLDASM

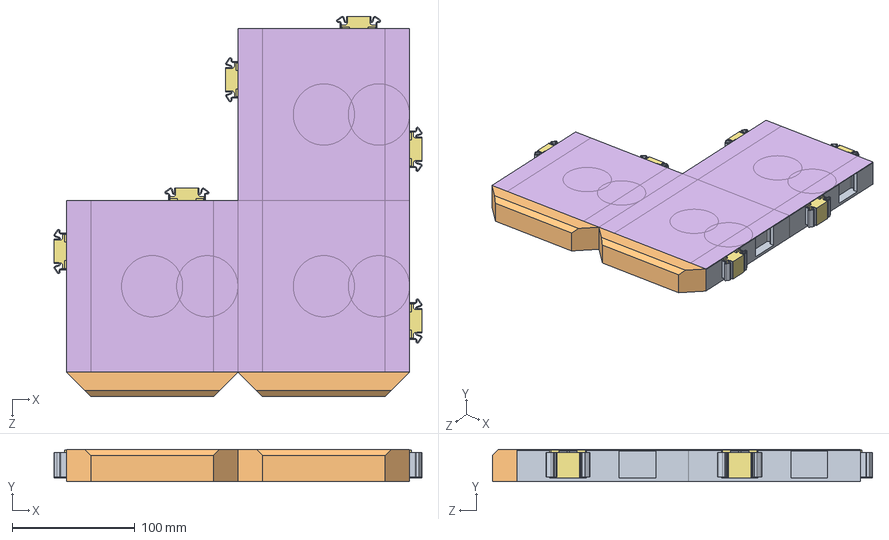
[picture p362: CAD file, 2023-12-22]
Current/Mechanical/v4_Eggdee/multipanels_assembly_v1.SLDASM
299.4 x 26.3 x 309.4 mm
bplate_v4.2 x 3
vent_grill_v4.1 x 3
tplate_v4.1 x 3
finger_joint_v4.1 x 12
adhesive_strip1 x 24
metal_detent_v4.1 x 24
end_cap_v4.1 x 2
