caltechcaos/Lunar-Dust-Challenge/Current/Mechanical/v4_Eggdee/Parts/Connectors/mill-max-824-22-005-00-001000_MALE.sldasm

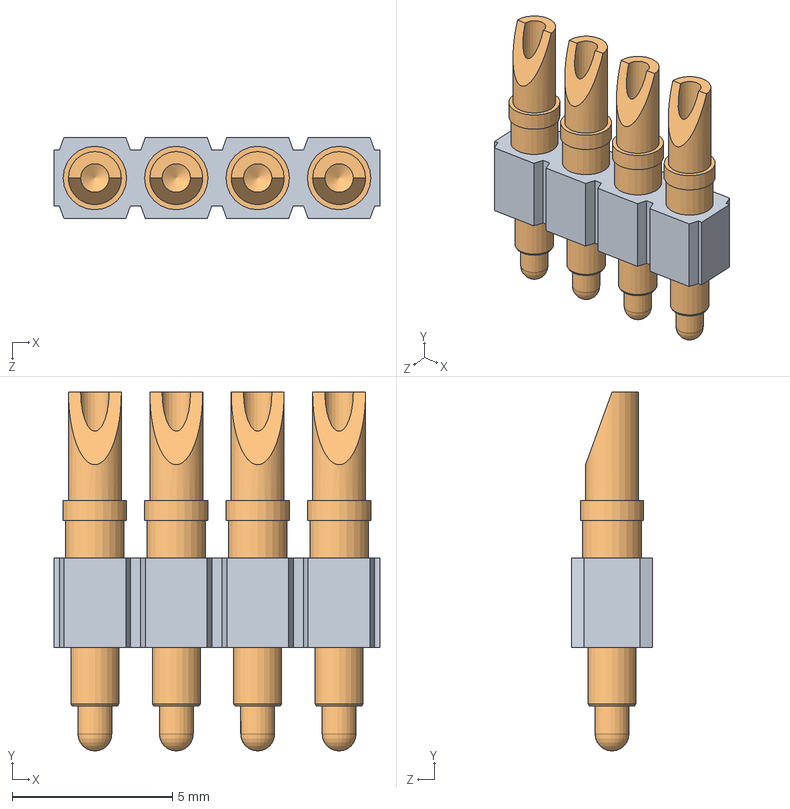
[picture p363: CAD file, 2023-12-22]
Current/Mechanical/v4_Eggdee/Parts/Connectors/mill-max-824-22-005-00-001000_MALE.sldasm
10.2 x 11.2 x 2.54 mm
mill-max-824-22-005-00-001000_P3XX-18-010-00-090000
mill-max-824-22-005-00-001000_0933 x 4
