caltechcaos/Lunar-Dust-Challenge/Current/Mechanical/v4_Eggdee/RENDERS/parul_renders/fourpanels.SLDASM

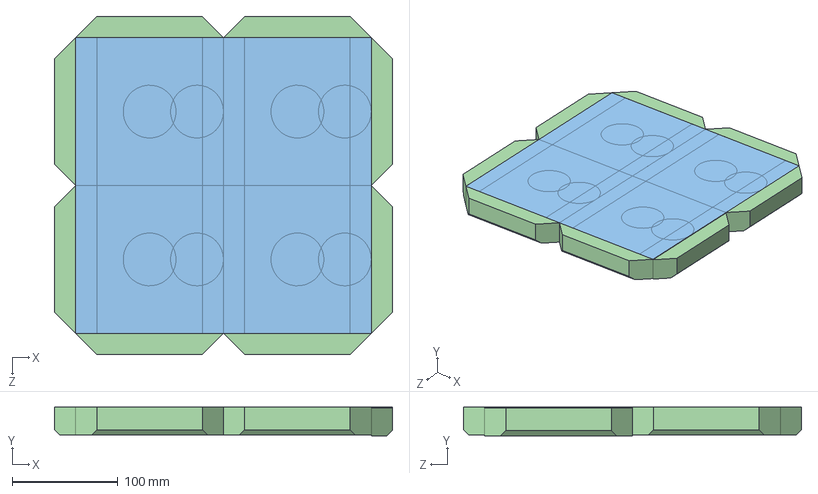
[picture p364: CAD file, 2023-12-22]
Current/Mechanical/v4_Eggdee/RENDERS/parul_renders/fourpanels.SLDASM
319.4 x 26.9 x 319.4 mm
adhesive_v4.1 x 4
bplate_v4.3 x 4
tplate_v4.1 x 4
end_cap_v4.1 x 8
