caltechcaos/Lunar-Dust-Challenge/Current/Mechanical/v4_Eggdee/Simplified_Parts/simplified_panel.SLDASM

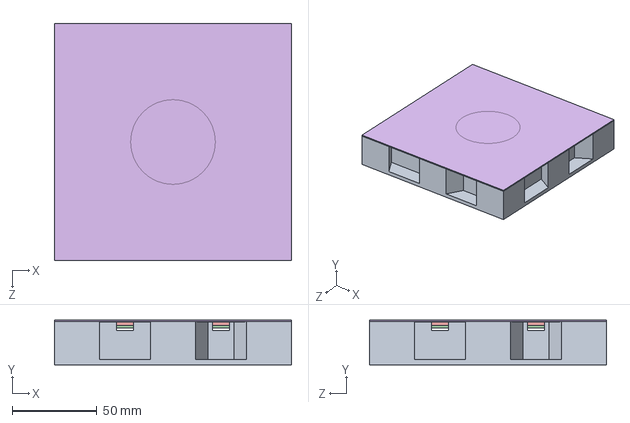
[picture p365: CAD file, 2023-12-22]
Current/Mechanical/v4_Eggdee/Simplified_Parts/simplified_panel.SLDASM
139.7 x 26.3 x 139.7 mm
