caltechcaos/Lunar-Dust-Challenge/EASE/Cosmetic_Components/EASE_Cosmetic_Assembly - Panel_Wiring_Assy-1 MID_Wire^Panel_Wiring_Assy-3.STL

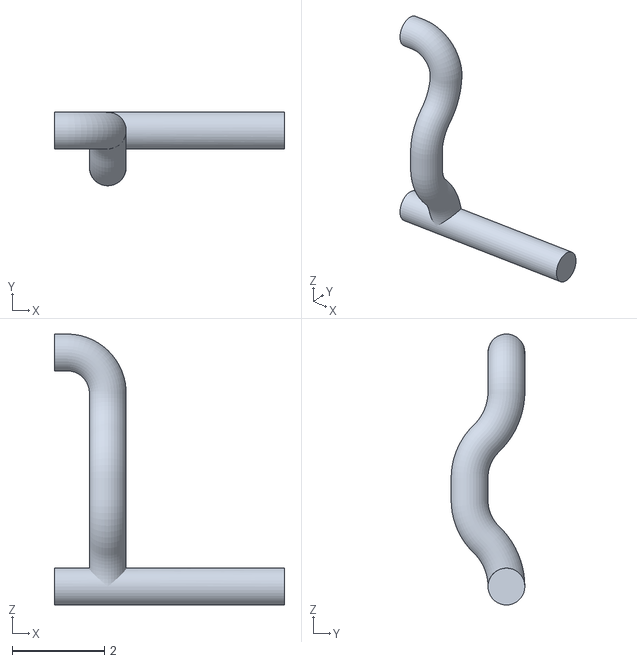
[picture p366: CAD file, 2023-12-22]
EASE/Cosmetic_Components/EASE_Cosmetic_Assembly - Panel_Wiring_Assy-1 MID_Wire^Panel_Wiring_Assy-3.STL
5.00 x 1.60 x 5.88
