caltechcaos/Lunar-Dust-Challenge/EASE/Doormat.SLDASM

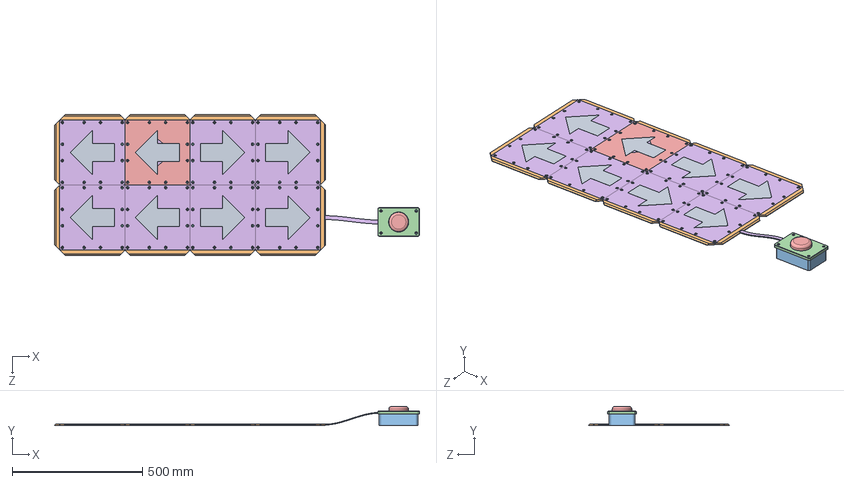
[picture p367: CAD file, 2023-12-22]
EASE/Doormat.SLDASM
1399.8 x 72.9 x 540.0 mm
EASE_Bottom_Plate x 8
mill-max-319-10-105-00-006000_P3XX-11-010-00-000000 x 32
mill-max-319-10-105-00-006000_1948 x 160
mill-max-824-22-005-00-001000_P3XX-18-010-00-090000 x 32
mill-max-824-22-005-00-001000_0933 x 160
HIGH_Wire^Panel_Wiring_Assy x 64
MID_Wire^Panel_Wiring_Assy x 64
LOW_Wire^Panel_Wiring_Assy x 64
Twisted_3_Wires^Panel_Wiring_Assy x 8
MID_Electrode^Panel_Wiring_Assy x 8
LOW_Electrode^Panel_Wiring_Assy x 8
HIGH_Electrode^Panel_Wiring_Assy x 8
EASE_Top_Plate x 8
8262A210_FLUSH-MOUNT BALL NOSE SPRING PLUNGER x 86
93395A296_TYPE 316 SS FLAT-HEAD SOCKET CAP SCREW x 100
Arrow x 8
EASE_Port_Cover x 12
Electronics_Box_Bottom
Electronics_Box_Top
Electronics_Box_Button
Part1^EASE_end_cap_to_electronics_box
