caltechcaos/Lunar-Dust-Challenge/PDR/Mat/panel_R_assy.SLDASM

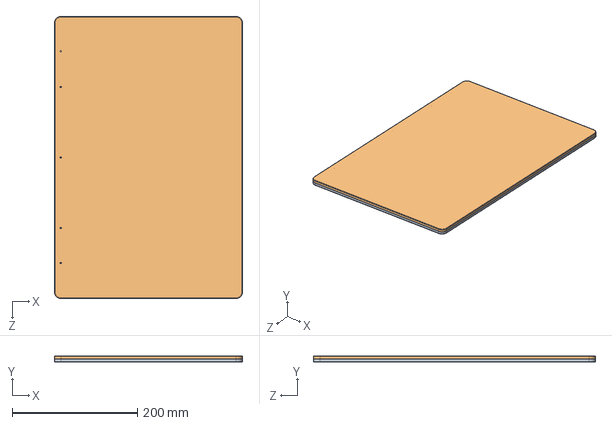
[picture p370: CAD file, 2023-12-22]
PDR/Mat/panel_R_assy.SLDASM
300.0 x 10.0 x 450.0 mm
panel_R_bottom
panel_R_top
