caltechcaos/Lunar-Dust-Challenge/PDR/Mat/V4/elec_box_assy.SLDASM

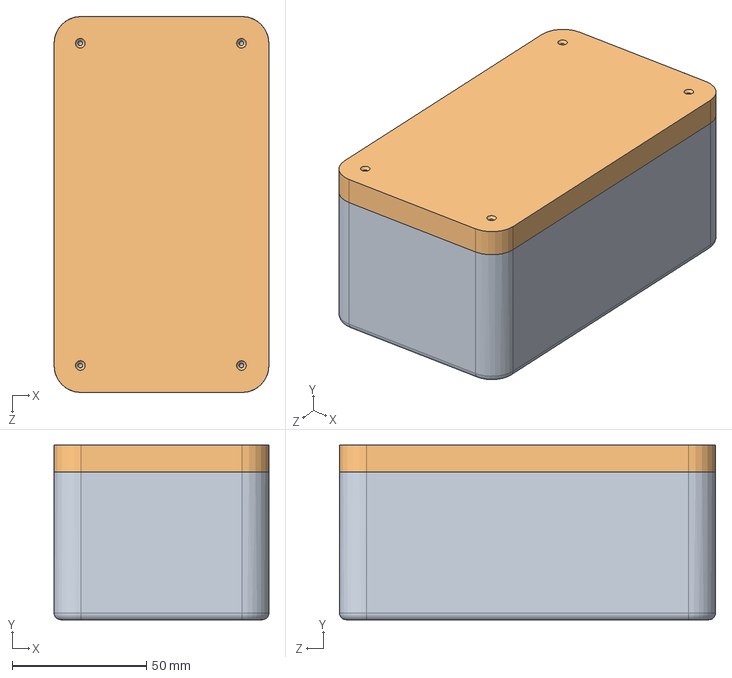
[picture p371: CAD file, 2023-12-22]
PDR/Mat/V4/elec_box_assy.SLDASM
80.0 x 65.0 x 140.0 mm
elec_box
elec_box_lid
