caltechcaos/Lunar-Dust-Challenge/Current/Mechanical/v3_tiz/FEA/5.5 INCHES/panel_assembly_test5.5.SLDASM

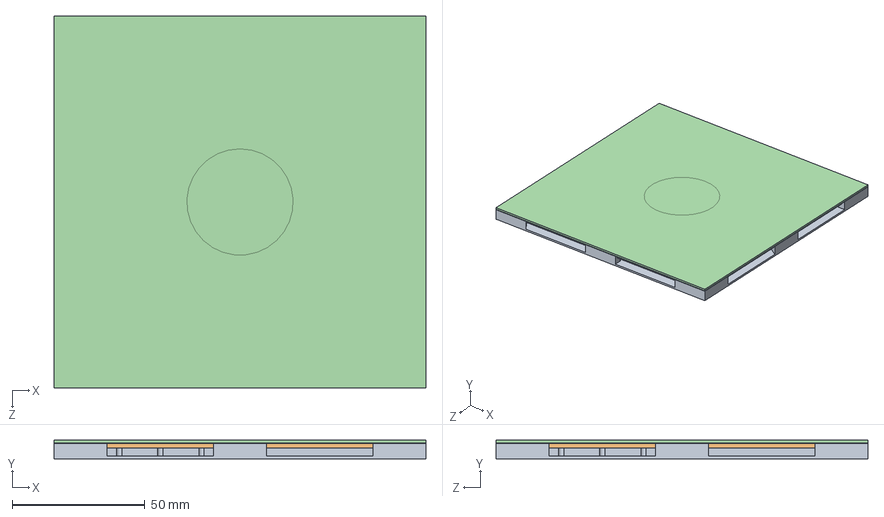
[picture p372: CAD file, 2023-12-22]
Current/Mechanical/v3_tiz/FEA/5.5 INCHES/panel_assembly_test5.5.SLDASM
140.0 x 7.00 x 140.0 mm
5.5bplate_test
5.5pcb_mockup_test
5.5adhesive_test
5.5tplate_test
