caltechcaos/Lunar-Dust-Challenge/Current/Mechanical/v3_tiz/FEA/segmented_panel_fea/segmented_panel_assembly_test.SLDASM

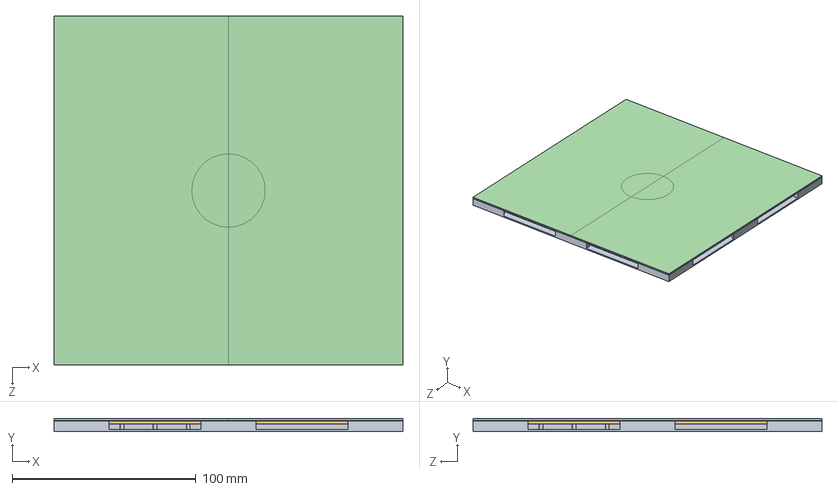
[picture p373: CAD file, 2023-12-22]
Current/Mechanical/v3_tiz/FEA/segmented_panel_fea/segmented_panel_assembly_test.SLDASM
190.0 x 7.00 x 190.0 mm
bplate_segmented_test
pcb_mockup_segmented_test
adhesive_segmented_test
tplate_segmented_test x 2
