caltechcaos/Lunar-Dust-Challenge/Current/Mechanical/v4_Eggdee/RENDERS/parul_renders/fourpanelswithendcaps_v2.SLDASM

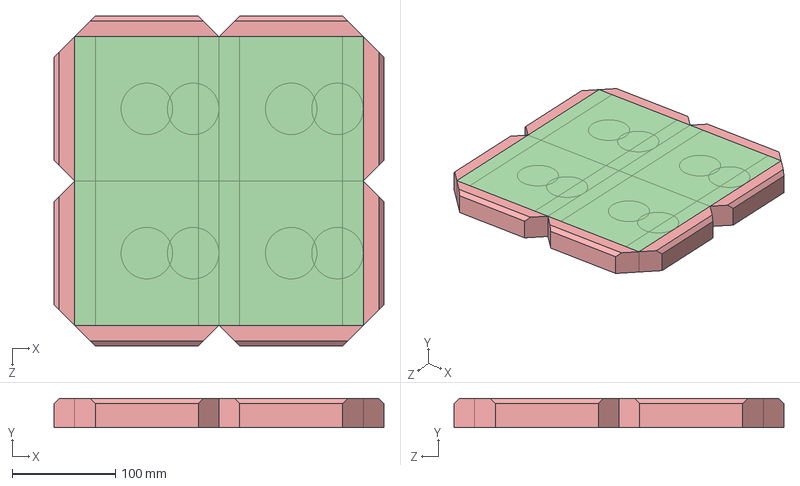
[picture p374: CAD file, 2023-12-22]
Current/Mechanical/v4_Eggdee/RENDERS/parul_renders/fourpanelswithendcaps_v2.SLDASM
319.4 x 28.3 x 319.4 mm
bplate_v4.4 x 4
adhesive_v4.1 x 8
pcb_mockup_v4.3 x 4
tplate_v4.1 x 4
endcap_v4.1 x 8
