caltechcaos/Lunar-Dust-Challenge/EASE/Example_Configurations/Cosmetic_Combinations/8x2_Cosmetic.SLDASM

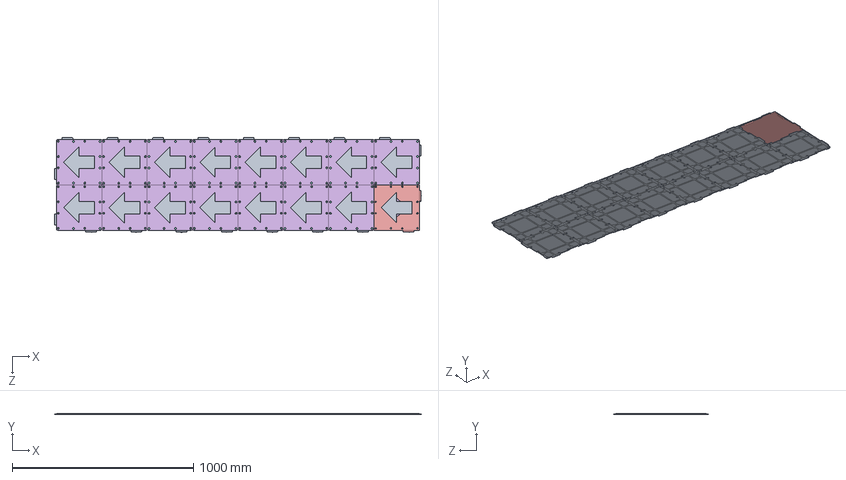
[picture p375: CAD file, 2023-12-22]
EASE/Example_Configurations/Cosmetic_Combinations/8x2_Cosmetic.SLDASM
2022.8 x 6.60 x 522.8 mm
EASE_Bottom_Plate x 16
mill-max-319-10-105-00-006000_P3XX-11-010-00-000000 x 64
mill-max-319-10-105-00-006000_1948 x 320
mill-max-824-22-005-00-001000_P3XX-18-010-00-090000 x 64
mill-max-824-22-005-00-001000_0933 x 320
HIGH_Wire^Panel_Wiring_Assy x 128
MID_Wire^Panel_Wiring_Assy x 128
LOW_Wire^Panel_Wiring_Assy x 128
Twisted_3_Wires^Panel_Wiring_Assy x 16
MID_Electrode^Panel_Wiring_Assy x 16
LOW_Electrode^Panel_Wiring_Assy x 16
HIGH_Electrode^Panel_Wiring_Assy x 16
EASE_Top_Plate x 16
8262A210_FLUSH-MOUNT BALL NOSE SPRING PLUNGER x 128
93395A296_TYPE 316 SS FLAT-HEAD SOCKET CAP SCREW x 192
Arrow x 16
