caltechcaos/Lunar-Dust-Challenge/Verification/Vibration Mount 3 Axis/VibrationMountAssembly3axis.SLDASM

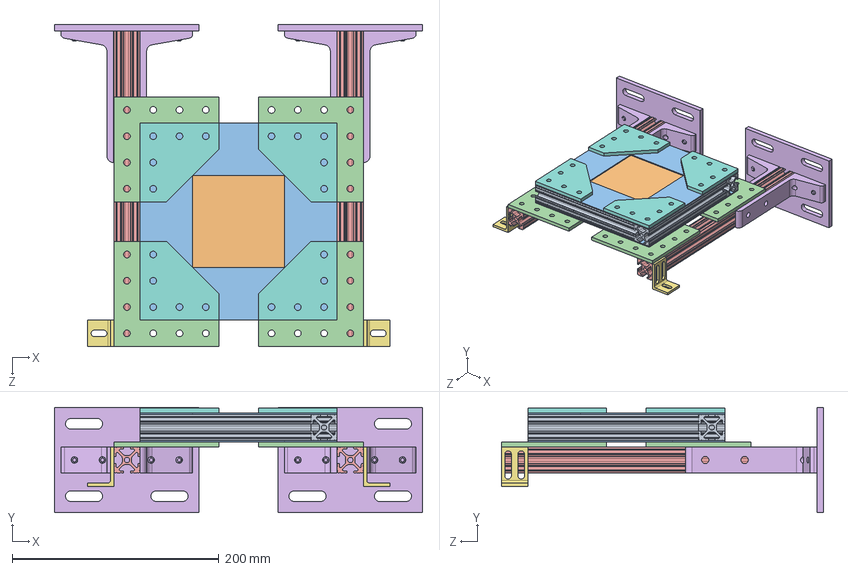
[picture p376: CAD file, 2023-12-22]
Verification/Vibration Mount 3 Axis/VibrationMountAssembly3axis.SLDASM
355.6 x 101.6 x 311.1 mm
47065T411_ALUMINUM T-SLOTTED FRAMING EXTRUSION (1) x 4
HOMES_Placeholder
Plates x 8
47065T274_ALUMINUM T-SLOTTED FRAMING EXTRUSION x 4
47065T411_ALUMINUM T-SLOTTED FRAMING EXTRUSION x 2
3136N138_T-Slotted Framing x 2
47065T468_T-SLOTTED FRAMING x 2
47065T267_ALUMINUM T-SLOTTED FRAMING EXTRUSION x 4
