caltechcaos/Lunar-Dust-Challenge/Current/Mechanical/v3_tiz/FEA/4.5 INCHES/panel_assembly_test4.5.SLDASM

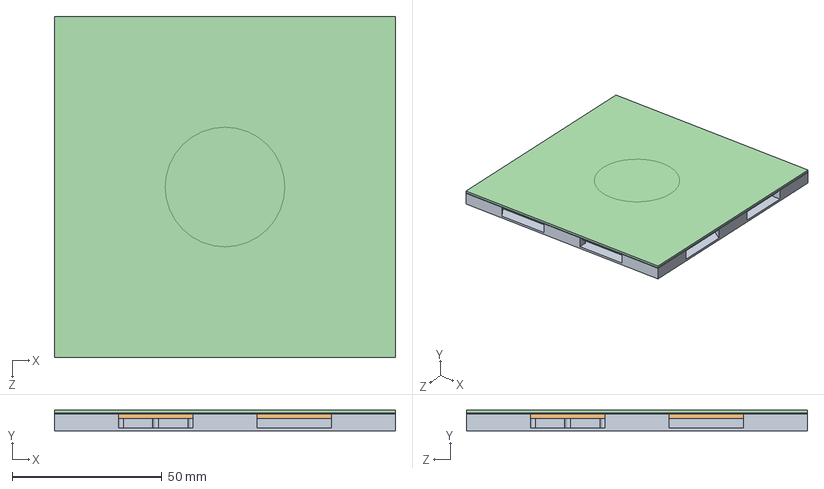
[picture p377: CAD file, 2023-12-22]
Current/Mechanical/v3_tiz/FEA/4.5 INCHES/panel_assembly_test4.5.SLDASM
114.0 x 7.00 x 114.0 mm
4.5bplate_test
4.5pcb_mockup_test
4.5adhesive_test
4.5tplate_test
