caltechcaos/Lunar-Dust-Challenge/Current/Mechanical/v4_Eggdee/3D_Prints/Rev 2 Integrated Assm^panel_assembly_v4.5.SLDPRT

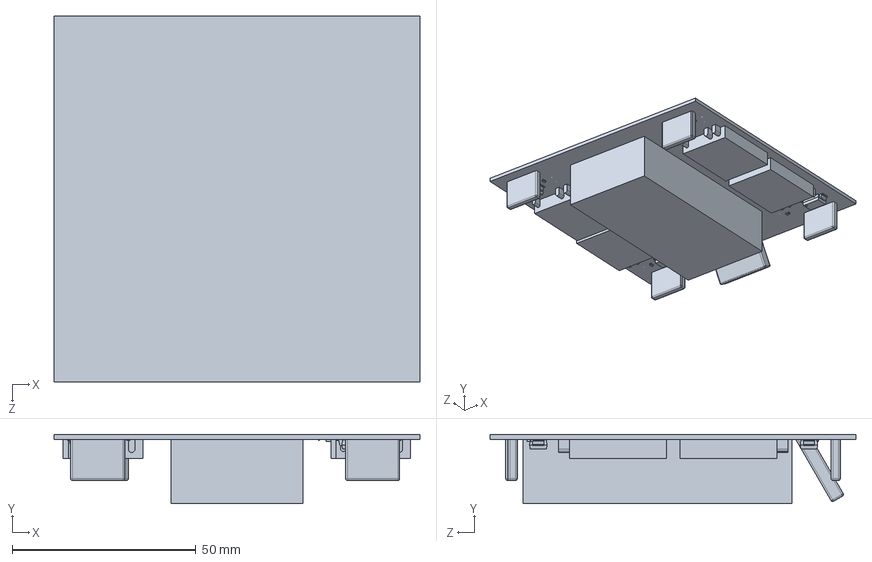
[picture p378: CAD file, 2023-12-22]
Current/Mechanical/v4_Eggdee/3D_Prints/Rev 2 Integrated Assm^panel_assembly_v4.5.SLDPRT
99.6 x 18.9 x 99.6 mm
