caltechcaos/Lunar-Dust-Challenge/Current/Mechanical/v4_Eggdee/panel_assembly_v4.5.SLDASM

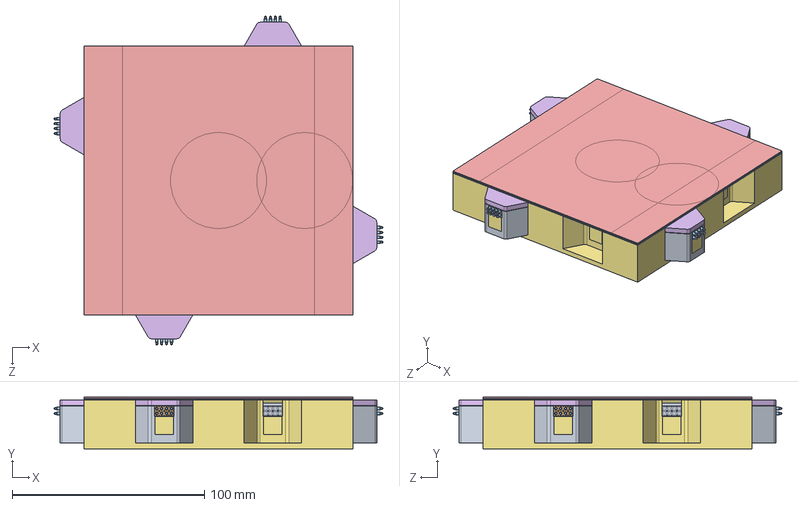
[picture p379: CAD file, 2023-12-22]
Current/Mechanical/v4_Eggdee/panel_assembly_v4.5.SLDASM
171.2 x 26.8 x 171.2 mm
compactPCB
HRL30_mockup
SV17KC273KAR
MOSFET_mockup x 4
SLIM-MOX10203 x 4
gatedriver_mockup x 4
bplate_v4.5
Wire Harness^panel_assembly_v4.5
finger_joint_v4.2 x 4
mill-max-824-22-005-00-001000_P3XX-18-010-00-090000 x 8
mill-max-824-22-005-00-001000_0933 x 32
adhesive_strip_connector x 8
adhesive_strip_finger_joint_cap x 4
finger_joint_cap x 4
magnet_connector_v2 x 8
adhesive_strip_magnet_v2 x 8
mill-max-430-10-208-00-240000 x 4
adhesive_v4.1
adhesive_v4.2
pcb_mockup_v4.3
tplate_v4.1
foil_v4.1
dielectric_v4.1 x 2
