caltechcaos/Lunar-Dust-Challenge/Current/Mechanical/v4_Eggdee/RENDERS/parul_renders/onepanel.SLDASM

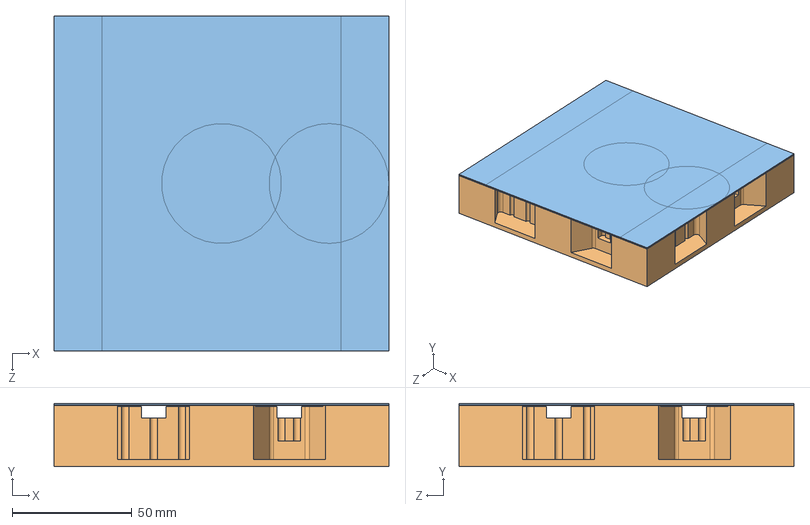
[picture p380: CAD file, 2023-12-22]
Current/Mechanical/v4_Eggdee/RENDERS/parul_renders/onepanel.SLDASM
139.7 x 26.3 x 139.7 mm
adhesive_v4.1
bplate_v4.3
tplate_v4.1
