caltechcaos/Lunar-Dust-Challenge/EASE/Cosmetic_Components/EASE_Cosmetic_Assembly - Panel_Wiring_Assy-1 LOW_Wire^Panel_Wiring_Assy-1.STL

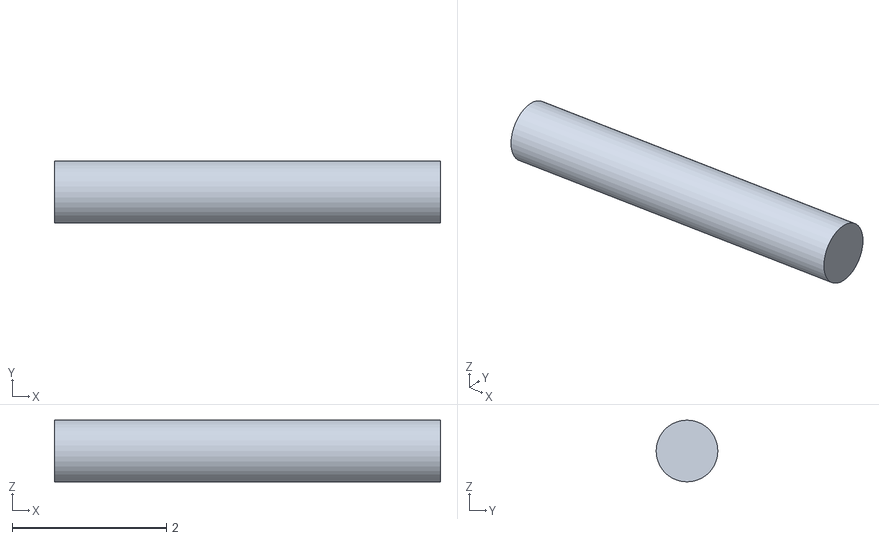
[picture p382: CAD file, 2023-12-22]
EASE/Cosmetic_Components/EASE_Cosmetic_Assembly - Panel_Wiring_Assy-1 LOW_Wire^Panel_Wiring_Assy-1.STL
5.00 x 0.8 x 0.8
