caltechcaos/Lunar-Dust-Challenge/EASE/Example_Configurations/Cosmetic_Combinations/4x2_Cosmetic.SLDASM

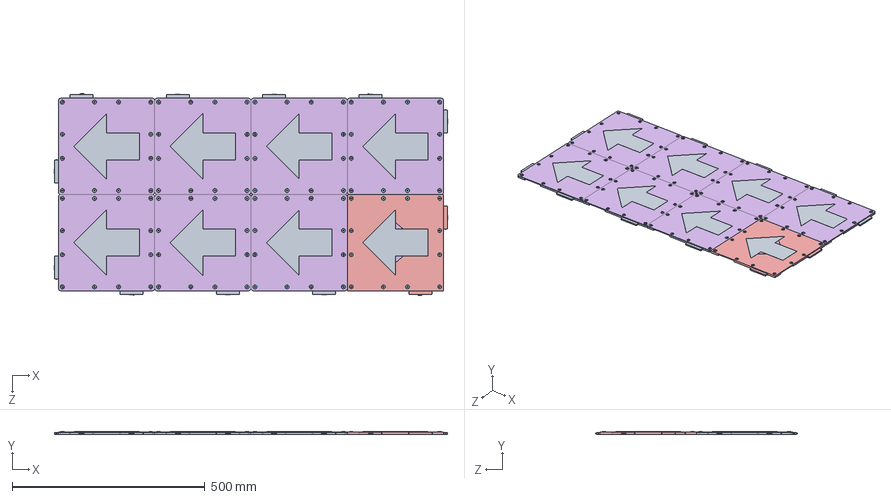
[picture p384: CAD file, 2023-12-22]
EASE/Example_Configurations/Cosmetic_Combinations/4x2_Cosmetic.SLDASM
1022.8 x 6.60 x 522.8 mm
EASE_Bottom_Plate x 8
mill-max-319-10-105-00-006000_P3XX-11-010-00-000000 x 32
mill-max-319-10-105-00-006000_1948 x 160
mill-max-824-22-005-00-001000_P3XX-18-010-00-090000 x 32
mill-max-824-22-005-00-001000_0933 x 160
HIGH_Wire^Panel_Wiring_Assy x 64
MID_Wire^Panel_Wiring_Assy x 64
LOW_Wire^Panel_Wiring_Assy x 64
Twisted_3_Wires^Panel_Wiring_Assy x 8
MID_Electrode^Panel_Wiring_Assy x 8
LOW_Electrode^Panel_Wiring_Assy x 8
HIGH_Electrode^Panel_Wiring_Assy x 8
EASE_Top_Plate x 8
8262A210_FLUSH-MOUNT BALL NOSE SPRING PLUNGER x 64
93395A296_TYPE 316 SS FLAT-HEAD SOCKET CAP SCREW x 96
Arrow x 8
