caltechcaos/Lunar-Dust-Challenge/PDR/Mat/plate_assembly_v3.SLDASM

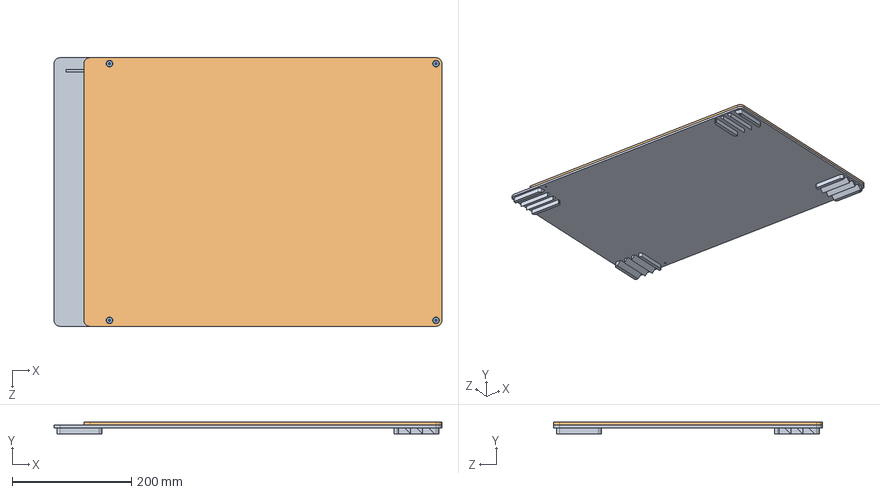
[picture p385: CAD file, 2023-12-22]
PDR/Mat/plate_assembly_v3.SLDASM
650.0 x 20.0 x 450.0 mm
plate_bottom_v3
plate_top_v3
93395A348_TYPE 316 SS FLAT-HEAD SOCKET CAP SCREW x 4
