caltechcaos/Lunar-Dust-Challenge/Verification/Vibration Mount/VibrationMountAssembly.SLDASM

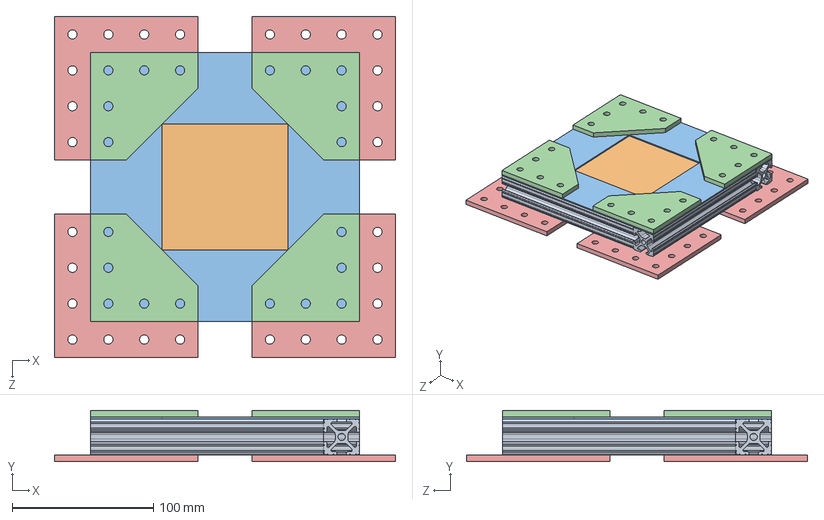
[picture p386: CAD file, 2023-12-22]
Verification/Vibration Mount/VibrationMountAssembly.SLDASM
241.3 x 36.2 x 241.3 mm
47065T411_ALUMINUM T-SLOTTED FRAMING EXTRUSION (1) x 4
HOMES_Placeholder
Plates x 4
47065T267_ALUMINUM T-SLOTTED FRAMING EXTRUSION x 4
47065T274_ALUMINUM T-SLOTTED FRAMING EXTRUSION x 4
