caltechcaos/Lunar-Dust-Challenge/Current/Mechanical/v4_Eggdee/Parts/Connectors/mill-max-319-10-105-00-006000_FEMALE.sldasm

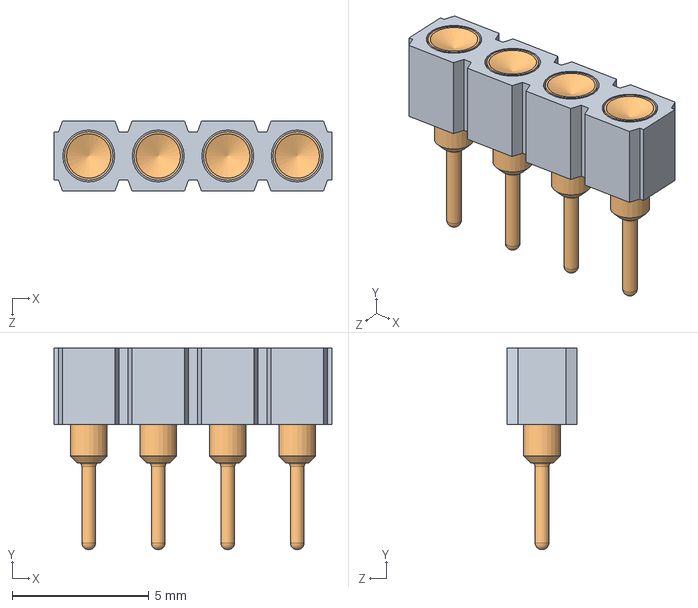
[picture p387: CAD file, 2023-12-22]
Current/Mechanical/v4_Eggdee/Parts/Connectors/mill-max-319-10-105-00-006000_FEMALE.sldasm
10.2 x 7.37 x 2.54 mm
mill-max-319-10-105-00-006000_P3XX-11-010-00-000000
mill-max-319-10-105-00-006000_1948 x 4
