caltechcaos/Lunar-Dust-Challenge/EASE/Example_Configurations/Combinations/1x2_Port_Covers.SLDASM

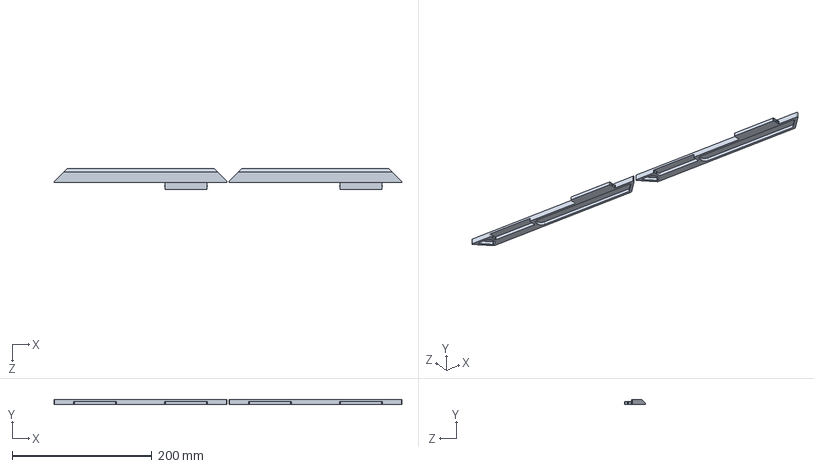
[picture p389: CAD file, 2023-12-22]
EASE/Example_Configurations/Combinations/1x2_Port_Covers.SLDASM
497.2 x 6.50 x 30.0 mm
EASE_Port_Cover x 2
8262A210_FLUSH-MOUNT BALL NOSE SPRING PLUNGER x 4
