caltechcaos/Lunar-Dust-Challenge/Current/Mechanical/v3_tiz/FEA/panel_assembly_test.SLDASM

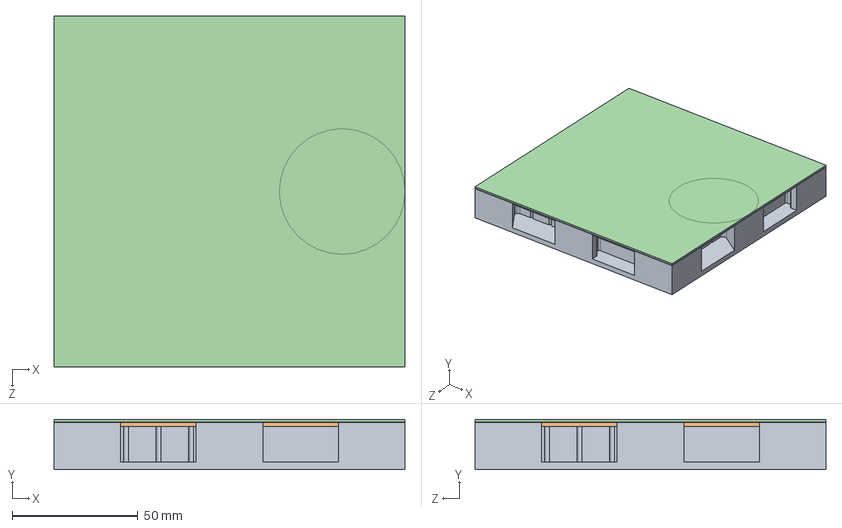
[picture p391: CAD file, 2023-12-22]
Current/Mechanical/v3_tiz/FEA/panel_assembly_test.SLDASM
139.7 x 20.0 x 139.7 mm
bplate_test
pcb_mockup_test
adhesive_test
tplate_test
