caltechcaos/Lunar-Dust-Challenge/Current/Mechanical/v4_Eggdee/Simplified_Parts/borderless_simplified_panel.SLDASM

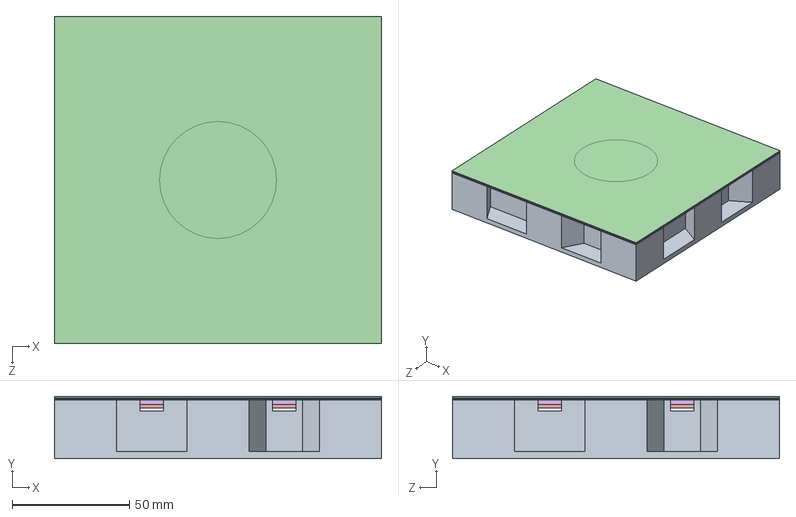
[picture p392: CAD file, 2023-12-22]
Current/Mechanical/v4_Eggdee/Simplified_Parts/borderless_simplified_panel.SLDASM
139.7 x 26.5 x 139.7 mm
bplate_simplified_borderless
pcb_simplified_nofillet
adhesive_v4.1 x 2
tplate_simplified
power_supply_pcb_mockup_v4.2
separation_layer_simplified
