caltechcaos/Lunar-Dust-Challenge/Current/Verification/Glove box/Glove box.SLDASM

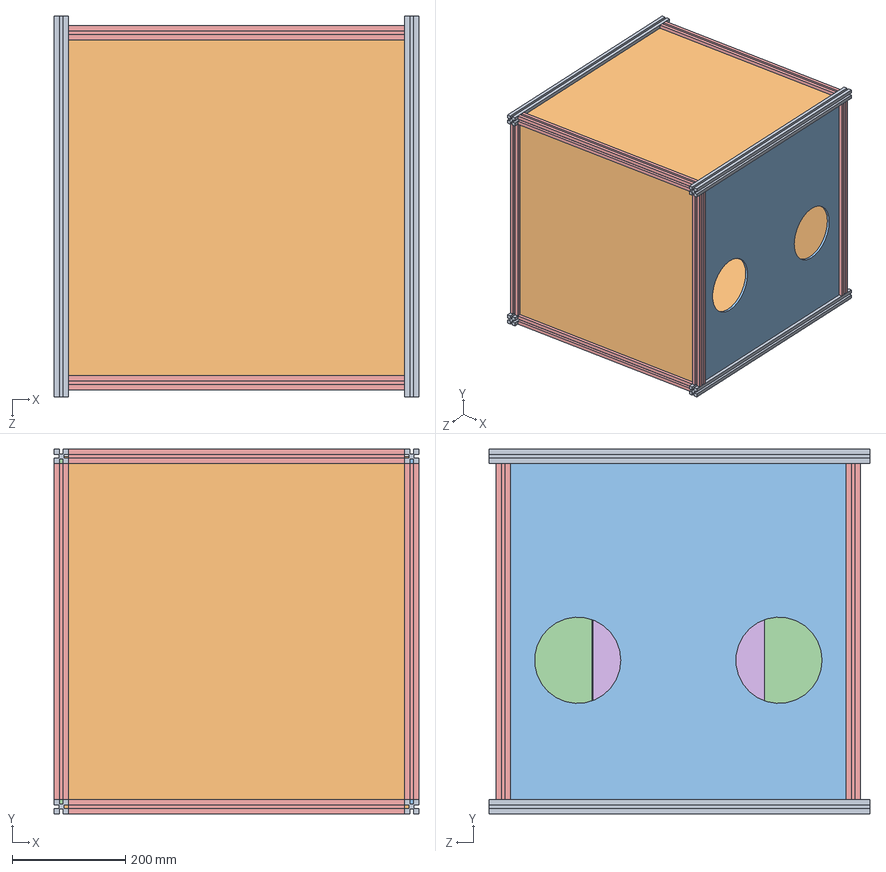
[picture p393: CAD file, 2023-12-22]
Current/Verification/Glove box/Glove box.SLDASM
644.1 x 644.1 x 673.1 mm
front rail x 4
2ft panel x 4
front panel
back panel
side rail x 8
door
1488A110_SURFACE-MOUNT HINGE x 2
