caltechcaos/Lunar-Dust-Challenge/EASE/Example_Configurations/Combinations/1x4_Port_Covers.SLDASM

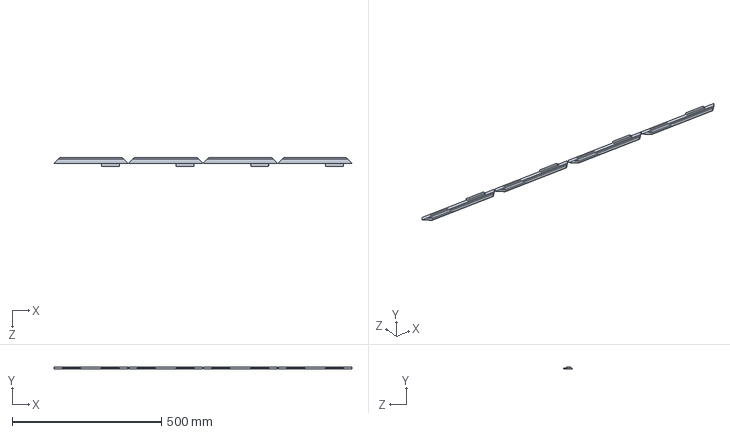
[picture p394: CAD file, 2023-12-22]
EASE/Example_Configurations/Combinations/1x4_Port_Covers.SLDASM
997.2 x 6.50 x 30.0 mm
EASE_Port_Cover x 4
8262A210_FLUSH-MOUNT BALL NOSE SPRING PLUNGER x 8
