caltechcaos/Lunar-Dust-Challenge/PDR/Mat/V4/panel_assy.SLDASM

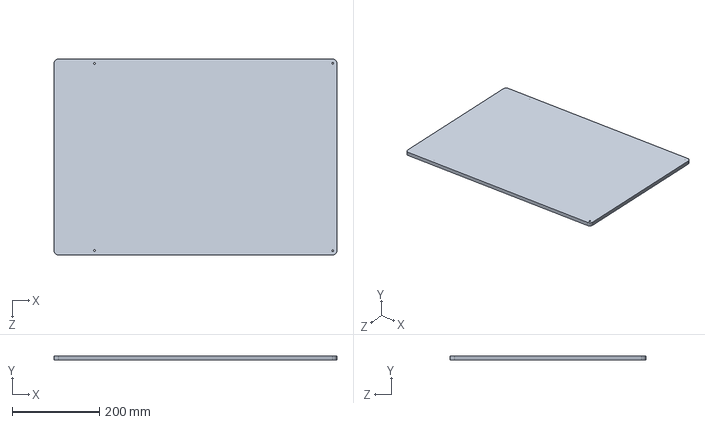
[picture p396: CAD file, 2023-12-22]
PDR/Mat/V4/panel_assy.SLDASM
650.0 x 10.0 x 450.0 mm
plate_bottom_v3 (1) x 2
