caltechcaos/Lunar-Dust-Challenge/EASE/Cosmetic_Components/EASE_Cosmetic_Assembly - Panel_Wiring_Assy-1 HIGH_Wire^Panel_Wiring_Assy-1.STL

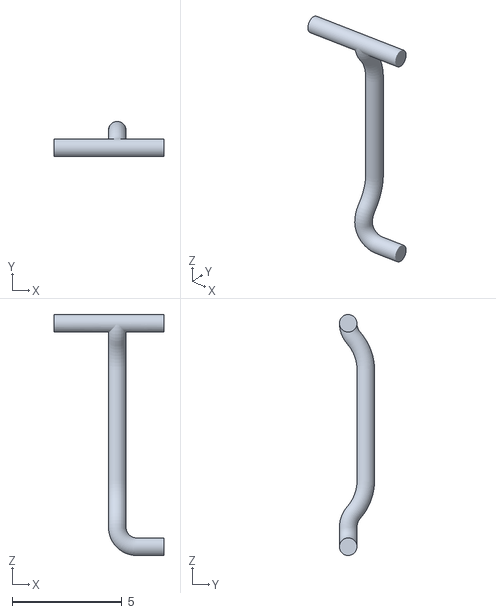
[picture p397: CAD file, 2023-12-22]
EASE/Cosmetic_Components/EASE_Cosmetic_Assembly - Panel_Wiring_Assy-1 HIGH_Wire^Panel_Wiring_Assy-1.STL
5.00 x 1.60 x 11.0
