caltechcaos/Lunar-Dust-Challenge/EASE/Mechanical_Components/EASE_Port_Cover_Assembly.SLDASM

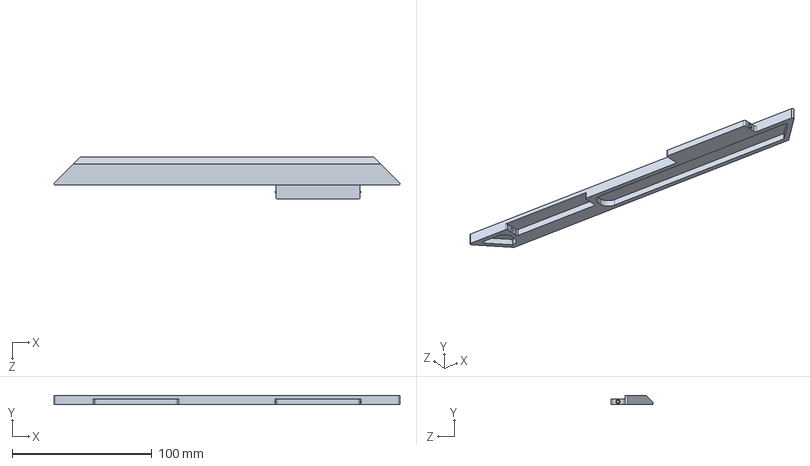
[picture p399: CAD file, 2023-12-22]
EASE/Mechanical_Components/EASE_Port_Cover_Assembly.SLDASM
247.2 x 6.50 x 30.0 mm
EASE_Port_Cover
8262A210_FLUSH-MOUNT BALL NOSE SPRING PLUNGER x 2
