caltechcaos/Lunar-Dust-Challenge/EASE/Table_Assembly.SLDASM

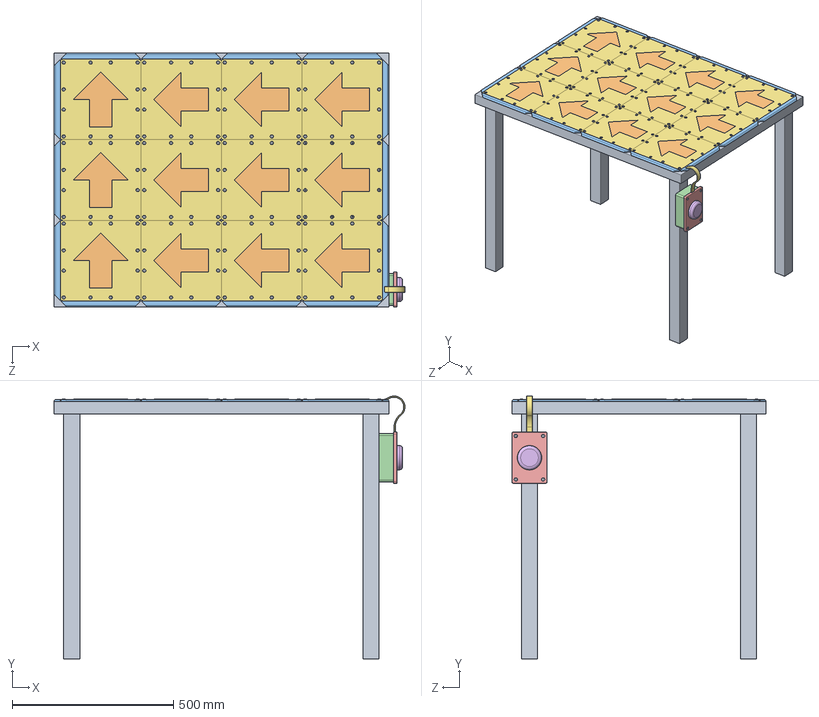
[picture p400: CAD file, 2023-12-22]
EASE/Table_Assembly.SLDASM
1090.0 x 816.6 x 790.0 mm
Table
EASE_Bottom_Plate x 12
mill-max-319-10-105-00-006000_P3XX-11-010-00-000000 x 48
mill-max-319-10-105-00-006000_1948 x 240
mill-max-824-22-005-00-001000_P3XX-18-010-00-090000 x 48
mill-max-824-22-005-00-001000_0933 x 240
HIGH_Wire^Panel_Wiring_Assy x 96
MID_Wire^Panel_Wiring_Assy x 96
LOW_Wire^Panel_Wiring_Assy x 96
Twisted_3_Wires^Panel_Wiring_Assy x 12
MID_Electrode^Panel_Wiring_Assy x 12
LOW_Electrode^Panel_Wiring_Assy x 12
HIGH_Electrode^Panel_Wiring_Assy x 12
EASE_Top_Plate x 12
8262A210_FLUSH-MOUNT BALL NOSE SPRING PLUNGER x 124
93395A296_TYPE 316 SS FLAT-HEAD SOCKET CAP SCREW x 148
Arrow x 12
EASE_Port_Cover x 14
Electronics_Box_Bottom
Electronics_Box_Top
Electronics_Box_Button
Table_Cable
