caltechcaos/Lunar-Dust-Challenge/PDR/Mat/full_system.SLDASM

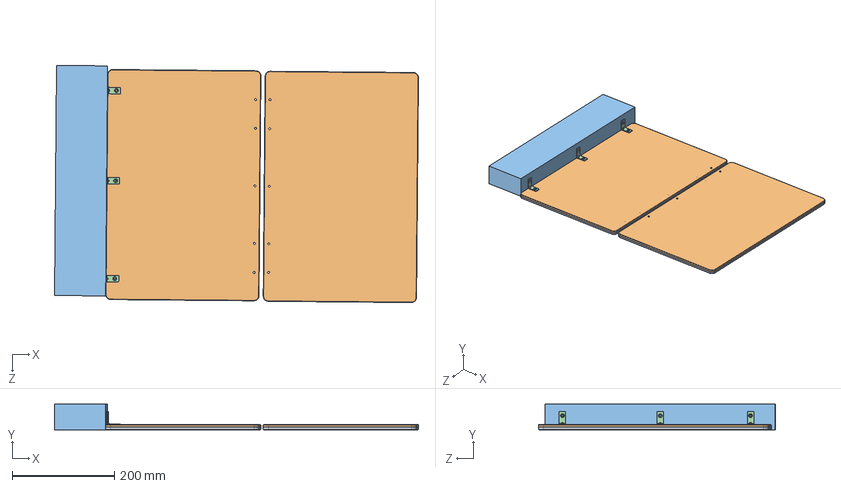
[picture p401: CAD file, 2023-12-22]
PDR/Mat/full_system.SLDASM
711.9 x 50.0 x 463.8 mm
panel_R_bottom x 2
panel_R_top x 2
elec_box_outline
1556A61_BRACKET x 3
