caltechcaos/Lunar-Dust-Challenge/EASE/Example_Configurations/Combinations/1x2.SLDASM

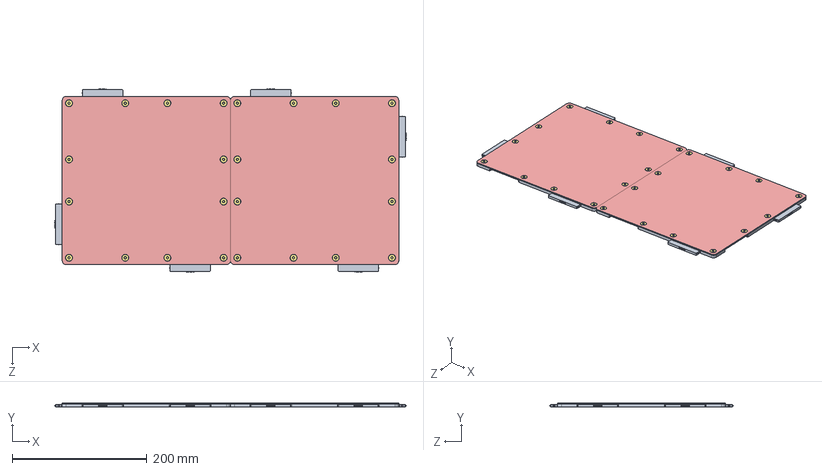
[picture p402: CAD file, 2023-12-22]
EASE/Example_Configurations/Combinations/1x2.SLDASM
522.8 x 6.60 x 272.8 mm
EASE_Bottom_Plate x 2
mill-max-319-10-105-00-006000_P3XX-11-010-00-000000 x 8
mill-max-319-10-105-00-006000_1948 x 40
mill-max-824-22-005-00-001000_P3XX-18-010-00-090000 x 8
mill-max-824-22-005-00-001000_0933 x 40
HIGH_Wire^Panel_Wiring_Assy x 16
MID_Wire^Panel_Wiring_Assy x 16
LOW_Wire^Panel_Wiring_Assy x 16
Twisted_3_Wires^Panel_Wiring_Assy x 2
MID_Electrode^Panel_Wiring_Assy x 2
LOW_Electrode^Panel_Wiring_Assy x 2
HIGH_Electrode^Panel_Wiring_Assy x 2
EASE_Top_Plate x 2
8262A210_FLUSH-MOUNT BALL NOSE SPRING PLUNGER x 16
93395A296_TYPE 316 SS FLAT-HEAD SOCKET CAP SCREW x 24
