caltechcaos/Lunar-Dust-Challenge/EASE/EASE_Assembly.SLDASM

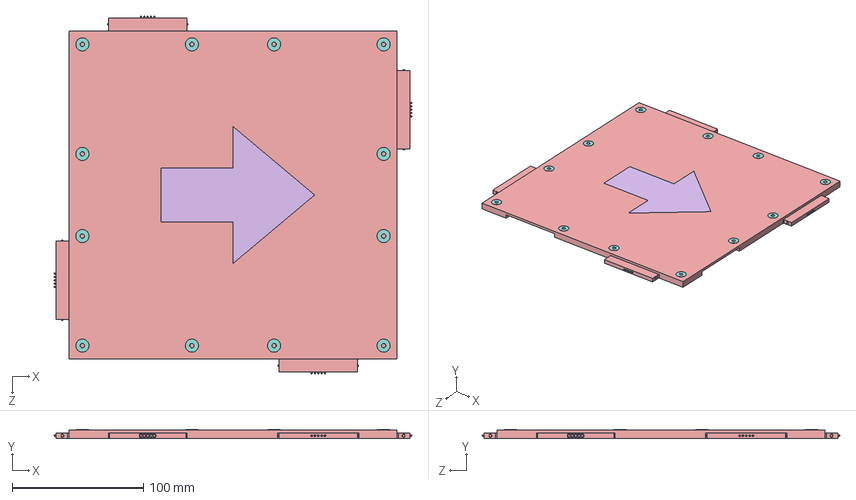
[picture p403: CAD file, 2023-12-22]
EASE/EASE_Assembly.SLDASM
272.8 x 6.60 x 272.8 mm
EASE_Bottom_Plate
mill-max-319-10-105-00-006000_P3XX-11-010-00-000000 x 4
mill-max-319-10-105-00-006000_1948 x 20
mill-max-824-22-005-00-001000_P3XX-18-010-00-090000 x 4
mill-max-824-22-005-00-001000_0933 x 20
HIGH_Wire^Panel_Wiring_Assy x 8
MID_Wire^Panel_Wiring_Assy x 8
LOW_Wire^Panel_Wiring_Assy x 8
Twisted_3_Wires^Panel_Wiring_Assy
MID_Electrode^Panel_Wiring_Assy
LOW_Electrode^Panel_Wiring_Assy
HIGH_Electrode^Panel_Wiring_Assy
EASE_Top_Plate
8262A210_FLUSH-MOUNT BALL NOSE SPRING PLUNGER x 8
93395A296_TYPE 316 SS FLAT-HEAD SOCKET CAP SCREW x 12
