caltechcaos/Lunar-Dust-Challenge/Current/Mechanical/v5_Sussy_Baka/Parts/bplate_asm_v5.1.SLDASM

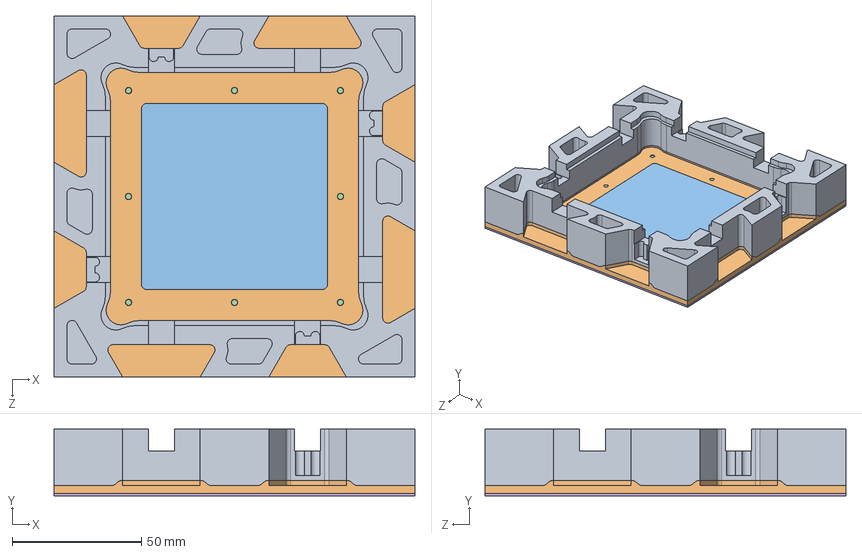
[picture p405: CAD file, 2023-12-22]
Current/Mechanical/v5_Sussy_Baka/Parts/bplate_asm_v5.1.SLDASM
139.7 x 25.9 x 139.7 mm
bplate_v5.1
metal_backplate_v5.1
metal_backplate_cover_v5.1
93395A196_316 Stainless Steel Hex Drive Flat Head Screw x 8
rubber_cover_v5.1
rubber_feet_v5.1
