caltechcaos/Lunar-Dust-Challenge/EASE/Example_Configurations/Combinations/1x4.SLDASM

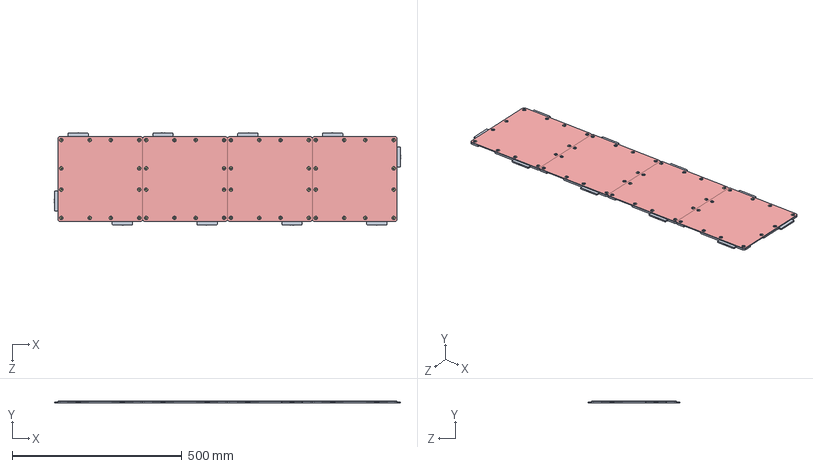
[picture p406: CAD file, 2023-12-22]
EASE/Example_Configurations/Combinations/1x4.SLDASM
1022.8 x 6.60 x 272.8 mm
EASE_Bottom_Plate x 4
mill-max-319-10-105-00-006000_P3XX-11-010-00-000000 x 16
mill-max-319-10-105-00-006000_1948 x 80
mill-max-824-22-005-00-001000_P3XX-18-010-00-090000 x 16
mill-max-824-22-005-00-001000_0933 x 80
HIGH_Wire^Panel_Wiring_Assy x 32
MID_Wire^Panel_Wiring_Assy x 32
LOW_Wire^Panel_Wiring_Assy x 32
Twisted_3_Wires^Panel_Wiring_Assy x 4
MID_Electrode^Panel_Wiring_Assy x 4
LOW_Electrode^Panel_Wiring_Assy x 4
HIGH_Electrode^Panel_Wiring_Assy x 4
EASE_Top_Plate x 4
8262A210_FLUSH-MOUNT BALL NOSE SPRING PLUNGER x 32
93395A296_TYPE 316 SS FLAT-HEAD SOCKET CAP SCREW x 48
