caltechcaos/Lunar-Dust-Challenge/Current/Mechanical/v4_Eggdee/Parts/mill-max-319-10-105-00-006000_FEMALE_4pin_version.sldasm

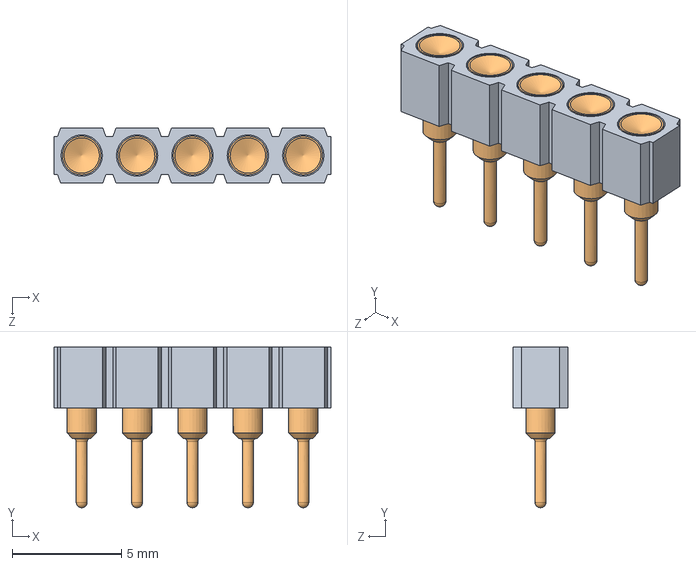
[picture p408: CAD file, 2023-12-22]
Current/Mechanical/v4_Eggdee/Parts/mill-max-319-10-105-00-006000_FEMALE_4pin_version.sldasm
12.7 x 7.37 x 2.54 mm
mill-max-319-10-105-00-006000_P3XX-11-010-00-000000
mill-max-319-10-105-00-006000_1948 x 5
