caltechcaos/Lunar-Dust-Challenge/EASE/Cosmetic_Components/EASE_Cosmetic_Assembly - 8262A210_FLUSH-MOUNT BALL NOSE SPRING PLUNGER-6.STL

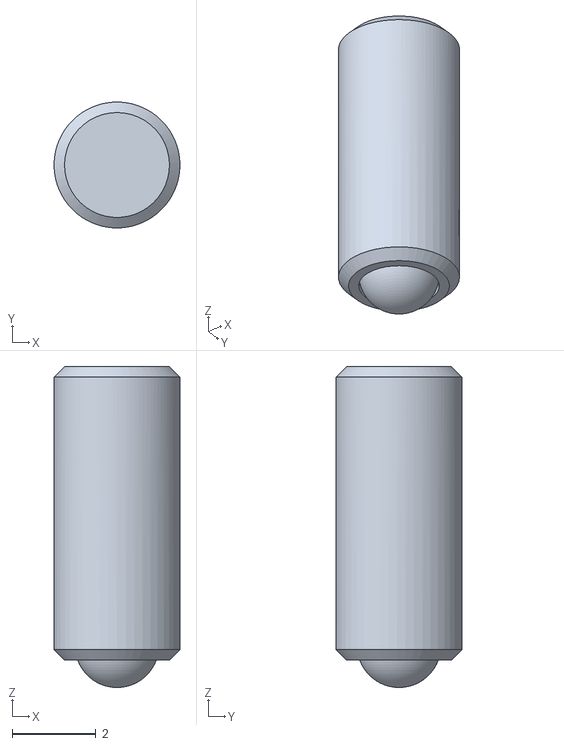
[picture p409: CAD file, 2023-12-22]
EASE/Cosmetic_Components/EASE_Cosmetic_Assembly - 8262A210_FLUSH-MOUNT BALL NOSE SPRING PLUNGER-6.STL
3.00 x 3.00 x 7.65
