caltechcaos/Lunar-Dust-Challenge/Compliant Mechanism Tester/Linear Actuator.SLDASM

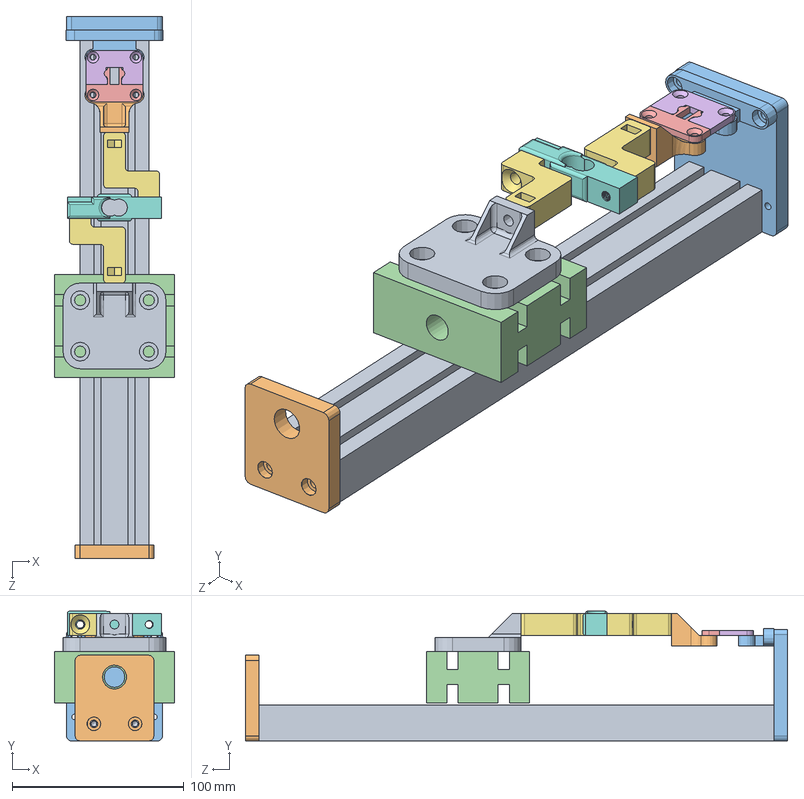
[picture p410: CAD file, 2023-12-22]
Compliant Mechanism Tester/Linear Actuator.SLDASM
70.0 x 75.8 x 316.0 mm
Actuator Rail
End Plate
Stepper Motor Mount
Carriage
Compliant Test Male
Compliant Test Female
STypeAdapter x 2
load cell
Rail-Load Cell Adaptor
Load Cell -Test Section Adapter
Rail -Test Section Adapter
