caltechcaos/Lunar-Dust-Challenge/EASE/Cosmetic_Components/EASE_Cosmetic_Assembly - Panel_Wiring_Assy-1 mill-max-824-22-005-00-001000_MALE-5 mill-max-824-22-005-00-001000_P3XX-18-010-00-090000-1.STL

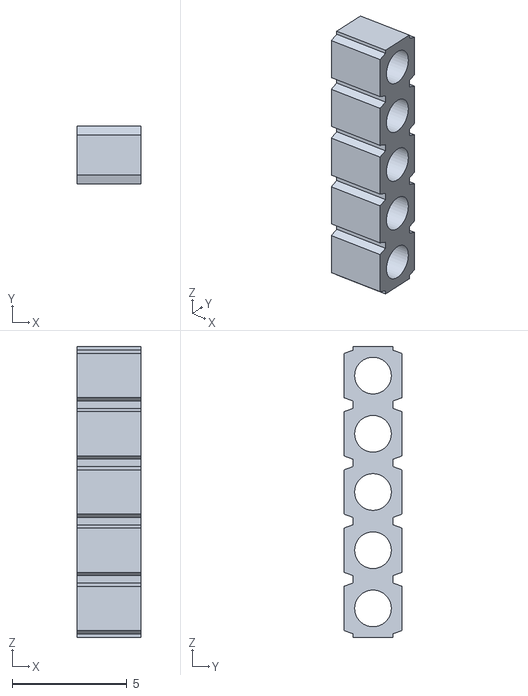
[picture p411: CAD file, 2023-12-22]
EASE/Cosmetic_Components/EASE_Cosmetic_Assembly - Panel_Wiring_Assy-1 mill-max-824-22-005-00-001000_MALE-5 mill-max-824-22-005-00-001000_P3XX-18-010-00-090000-1.STL
2.79 x 2.54 x 12.7
