caltechcaos/Lunar-Dust-Challenge/EASE/Use_Cases_Assembly.SLDASM

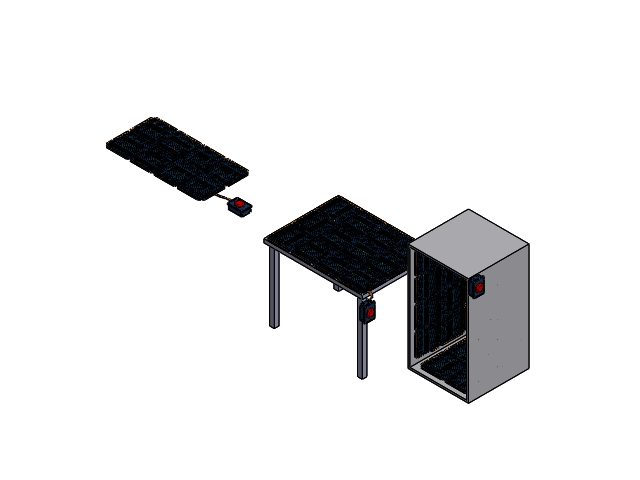
[picture p414: CAD file, 2023-12-22]
EASE/Use_Cases_Assembly.SLDASM
EASE_Bottom_Plate x 48
mill-max-319-10-105-00-006000_P3XX-11-010-00-000000 x 192
mill-max-319-10-105-00-006000_1948 x 960
mill-max-824-22-005-00-001000_P3XX-18-010-00-090000 x 192
mill-max-824-22-005-00-001000_0933 x 960
HIGH_Wire^Panel_Wiring_Assy x 384
MID_Wire^Panel_Wiring_Assy x 384
LOW_Wire^Panel_Wiring_Assy x 384
Twisted_3_Wires^Panel_Wiring_Assy x 48
MID_Electrode^Panel_Wiring_Assy x 48
LOW_Electrode^Panel_Wiring_Assy x 48
HIGH_Electrode^Panel_Wiring_Assy x 48
EASE_Top_Plate x 48
8262A210_FLUSH-MOUNT BALL NOSE SPRING PLUNGER x 508
93395A296_TYPE 316 SS FLAT-HEAD SOCKET CAP SCREW x 588
Arrow x 48
EASE_Port_Cover x 63
Electronics_Box_Bottom x 3
Electronics_Box_Top x 3
Electronics_Box_Button x 3
Part1^EASE_end_cap_to_electronics_box
Table
Table_Cable
Closet
EASE_Port_Cover_Electronics_Box x 7
