caltechcaos/Lunar-Dust-Challenge/(list of files, cad)

Other CAD files:
EASE/Components/Mirrormill-max-824-22-005-00-001000_MALE1.sldasm
EASE/Example_Configurations/Closet_Shell_Walls.SLDASM
EASE/Example_Configurations/Cosmetic_Combinations/Mirror1x4_Cosmetic.SLDASM
EASE/MirrorPanel_Wiring_Assy5.SLDASM
EASE/Components/Mirrormill-max-824-22-005-00-001000_MALE28.sldasm
EASE/Example_Configurations/Cosmetic_Combinations/Mirror1x2_Cosmetic.SLDASM
EASE/Example_Configurations/MirrorCloset_Shell_Left_Wall_v2.SLDASM
EASE/Components/Mirrormill-max-319-10-105-00-006000_FEMALE10.sldasm
EASE/Example_Configurations/Cosmetic_Combinations/Mirror1x4_Cosmetic1.SLDASM
EASE/Mechanical_Components/MirrorEASE_Port_Cover_Assembly5.SLDASM
EASE/Cosmetic_Components/EASE_Cosmetic_Assembly - Panel_Wiring_Assy-1 mill-max-319-10-105-00-006000_FEMALE-1 mill-max-319-10-105-00-006000_1948-2.STL
EASE/Example_Configurations/Closet_Assembly_v2.SLDASM
EASE/Example_Configurations/Combinations/Mirror1x2_Port_Covers3.SLDASM
EASE/Mechanical_Components/MirrorEASE_Port_Cover_Assembly9.SLDASM
EASE/MirrorPanel_Wiring_Assy6.SLDASM
EASE/Components/Mirrormill-max-824-22-005-00-001000_MALE22.sldasm
EASE/Example_Configurations/Combinations/Mirror1x2_Port_Covers.SLDASM
EASE/MirrorPanel_Wiring_Assy1.SLDASM
EASE/Cosmetic_Components/EASE_Cosmetic_Assembly - Panel_Wiring_Assy-1 mill-max-319-10-105-00-006000_FEMALE-1 mill-max-319-10-105-00-006000_1948-3.STL
EASE/Example_Configurations/Closet_Shell_Left_Wall_v2.SLDASM
EASE/Components/Mirrormill-max-319-10-105-00-006000_FEMALE27.sldasm
EASE/Cosmetic_Components/MirrorEASE_Cosmetic_Assembly6.SLDASM
EASE/Example_Configurations/Closet_Shell_Middle_Wall_v2.SLDASM
EASE/Mechanical_Components/MirrorEASE_Port_Cover_Assembly.SLDASM
EASE/MirrorPanel_Wiring_Assy4.SLDASM
EASE/Example_Configurations/Cosmetic_Combinations/2x8_Cosmetic.SLDASM
EASE/Components/Mirrormill-max-824-22-005-00-001000_MALE16.sldasm
EASE/Cosmetic_Components/EASE_Cosmetic_Assembly - Panel_Wiring_Assy-1 LOW_Wire^Panel_Wiring_Assy-7.STL
EASE/Example_Configurations/Cosmetic_Combinations/Mirror1x2_Cosmetic1.SLDASM
PDR/Mat/panel_L_assy.SLDASM
EASE/Components/Mirrormill-max-824-22-005-00-001000_MALE27.sldasm
EASE/Cosmetic_Components/EASE_Cosmetic_Assembly - Panel_Wiring_Assy-1 mill-max-824-22-005-00-001000_MALE-2 mill-max-824-22-005-00-001000_0933-5.STL
EASE/Example_Configurations/Combinations/Mirror1x2_Port_Covers2.SLDASM
EASE/Example_Configurations/Cosmetic_Combinations/2x4_Cosmetic.SLDASM
EASE/Components/Mirrormill-max-319-10-105-00-006000_FEMALE17.sldasm
EASE/Cosmetic_Components/EASE_Cosmetic_Assembly - Panel_Wiring_Assy-1 mill-max-319-10-105-00-006000_FEMALE-3 mill-max-319-10-105-00-006000_1948-4.STL
EASE/Example_Configurations/Combinations/Mirror1x2_Port_Covers1.SLDASM
EASE/MirrorPanel_Wiring_Assy3.SLDASM
EASE/Components/Mirrormill-max-824-22-005-00-001000_MALE24.sldasm
EASE/Cosmetic_Components/EASE_Cosmetic_Assembly - Panel_Wiring_Assy-1 mill-max-824-22-005-00-001000_MALE-1 mill-max-824-22-005-00-001000_0933-3.STL
EASE/Example_Configurations/Combinations/Mirror1x4_Port_Covers.SLDASM
EASE/Example_Configurations/Cosmetic_Combinations/Mirror1x2_Cosmetic3.SLDASM
EASE/Mechanical_Components/MirrorEASE_Port_Cover_Assembly1.SLDASM
EASE/MirrorPanel_Wiring_Assy7.SLDASM
Current/Mechanical/v4_Eggdee/Simplified_Parts/borderless_simplified_panel_compression.SLDASM
EASE/Components/Mirrormill-max-824-22-005-00-001000_MALE9.sldasm
EASE/Electronics_Box_Assembly.SLDASM
EASE/Example_Configurations/Cosmetic_Combinations/Mirror4x2_Cosmetic.SLDASM
EASE/Components/Mirrormill-max-824-22-005-00-001000_MALE11.sldasm
EASE/Example_Configurations/Cosmetic_Combinations/Mirror1x2_Cosmetic2.SLDASM
EASE/MirrorPanel_Wiring_Assy.SLDASM
Current/Mechanical/v4_Eggdee/Simplified_Parts/borderless_simplified_panel_cantilever.SLDASM
EASE/Components/Mirrormill-max-824-22-005-00-001000_MALE12.sldasm
EASE/Cosmetic_Components/EASE_Cosmetic_Assembly - Panel_Wiring_Assy-1 mill-max-319-10-105-00-006000_FEMALE-3 mill-max-319-10-105-00-006000_1948-3.STL
EASE/Mechanical_Components/MirrorEASE_Port_Cover_Assembly7.SLDASM
EASE/MirrorPanel_Wiring_Assy2.SLDASM
EASE/Components/Mirrormill-max-319-10-105-00-006000_FEMALE26.sldasm
EASE/Cosmetic_Components/EASE_Cosmetic_Assembly - Panel_Wiring_Assy-1 HIGH_Wire^Panel_Wiring_Assy-5.STL
EASE/Components/Mirrormill-max-319-10-105-00-006000_FEMALE22.sldasm
EASE/Cosmetic_Components/MirrorEASE_Cosmetic_Assembly7.SLDASM
EASE/Mechanical_Components/MirrorEASE_Port_Cover_Assembly6.SLDASM
EASE/Components/Mirrormill-max-824-22-005-00-001000_MALE15.sldasm
EASE/Mechanical_Components/MirrorEASE_Port_Cover_Assembly2.SLDASM
EASE/Mechanical_Components/MirrorEASE_Port_Cover_Assembly3.SLDASM
EASE/Components/Mirrormill-max-319-10-105-00-006000_FEMALE16.sldasm
EASE/Mechanical_Components/MirrorEASE_Port_Cover_Assembly8.SLDASM
EASE/Components/Mirrormill-max-824-22-005-00-001000_MALE7.sldasm
EASE/Cosmetic_Components/EASE_Cosmetic_Assembly - Panel_Wiring_Assy-1 mill-max-824-22-005-00-001000_MALE-1 mill-max-824-22-005-00-001000_0933-2.STL
EASE/Mechanical_Components/MirrorEASE_Port_Cover_Assembly4.SLDASM
EASE/Cosmetic_Components/EASE_Cosmetic_Assembly - Panel_Wiring_Assy-1 MID_Wire^Panel_Wiring_Assy-2.STL
EASE/Components/Mirrormill-max-319-10-105-00-006000_FEMALE13.sldasm
EASE/Components/Mirrormill-max-824-22-005-00-001000_MALE14.sldasm
EASE/Components/Mirrormill-max-824-22-005-00-001000_MALE31.sldasm
EASE/Cosmetic_Components/EASE_Cosmetic_Assembly - Panel_Wiring_Assy-1 mill-max-319-10-105-00-006000_FEMALE-2 mill-max-319-10-105-00-006000_1948-2.STL
Archived/EASE/Components/Mirrormill-max-319-10-105-00-006000_1948.sldprt
Archived/EASE/Components/Mirrormill-max-319-10-105-00-006000_FEMALE.sldasm
Archived/EASE/Components/Mirrormill-max-319-10-105-00-006000_FEMALE1.sldasm
Archived/EASE/Components/Mirrormill-max-319-10-105-00-006000_FEMALE10.sldasm
Archived/EASE/Components/Mirrormill-max-319-10-105-00-006000_FEMALE11.sldasm
Archived/EASE/Components/Mirrormill-max-319-10-105-00-006000_FEMALE12.sldasm
Archived/EASE/Components/Mirrormill-max-319-10-105-00-006000_FEMALE13.sldasm
Archived/EASE/Components/Mirrormill-max-319-10-105-00-006000_FEMALE14.sldasm
Archived/EASE/Components/Mirrormill-max-319-10-105-00-006000_FEMALE15.sldasm
Archived/EASE/Components/Mirrormill-max-319-10-105-00-006000_FEMALE16.sldasm
Archived/EASE/Components/Mirrormill-max-319-10-105-00-006000_FEMALE17.sldasm
Archived/EASE/Components/Mirrormill-max-319-10-105-00-006000_FEMALE18.sldasm
Archived/EASE/Components/Mirrormill-max-319-10-105-00-006000_FEMALE19.sldasm
Archived/EASE/Components/Mirrormill-max-319-10-105-00-006000_FEMALE2.sldasm
Archived/EASE/Components/Mirrormill-max-319-10-105-00-006000_FEMALE20.sldasm
Archived/EASE/Components/Mirrormill-max-319-10-105-00-006000_FEMALE21.sldasm
Archived/EASE/Components/Mirrormill-max-319-10-105-00-006000_FEMALE22.sldasm
Archived/EASE/Components/Mirrormill-max-319-10-105-00-006000_FEMALE23.sldasm
Archived/EASE/Components/Mirrormill-max-319-10-105-00-006000_FEMALE24.sldasm
Archived/EASE/Components/Mirrormill-max-319-10-105-00-006000_FEMALE25.sldasm
Archived/EASE/Components/Mirrormill-max-319-10-105-00-006000_FEMALE26.sldasm
Archived/EASE/Components/Mirrormill-max-319-10-105-00-006000_FEMALE27.sldasm
Archived/EASE/Components/Mirrormill-max-319-10-105-00-006000_FEMALE28.sldasm
Archived/EASE/Components/Mirrormill-max-319-10-105-00-006000_FEMALE29.sldasm
Archived/EASE/Components/Mirrormill-max-319-10-105-00-006000_FEMALE3.sldasm
Archived/EASE/Components/Mirrormill-max-319-10-105-00-006000_FEMALE30.sldasm
Archived/EASE/Components/Mirrormill-max-319-10-105-00-006000_FEMALE31.sldasm
Archived/EASE/Components/Mirrormill-max-319-10-105-00-006000_FEMALE4.sldasm
Archived/EASE/Components/Mirrormill-max-319-10-105-00-006000_FEMALE5.sldasm
Archived/EASE/Components/Mirrormill-max-319-10-105-00-006000_FEMALE6.sldasm
Archived/EASE/Components/Mirrormill-max-319-10-105-00-006000_FEMALE7.sldasm
Archived/EASE/Components/Mirrormill-max-319-10-105-00-006000_FEMALE8.sldasm
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
