caltechcaos/Lunar-Dust-Challenge/Current/Mechanical/v3_tiz/FEA/FEA_Assembly-Static 2-3.docx

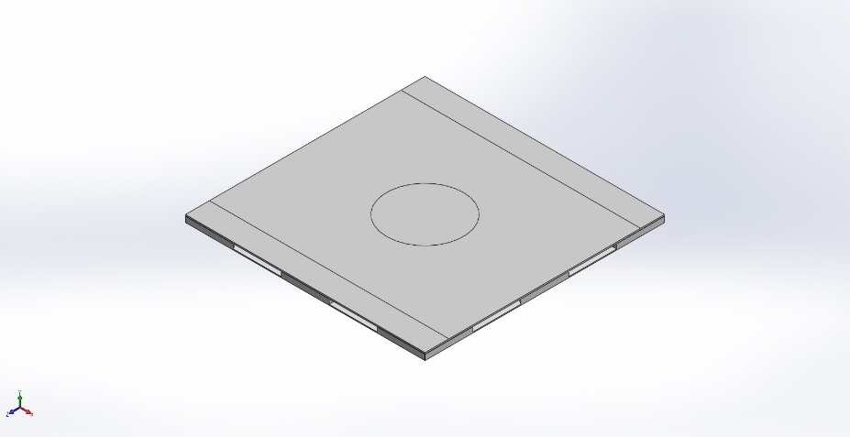
[picture p415: figure]

Simulation of FEA_Assembly

Date: Friday, March 26, 2021
Designer: Solidworks

Study name: Static 2

Analysis type: Static
Description No Data

# Assumptions

# Model Information

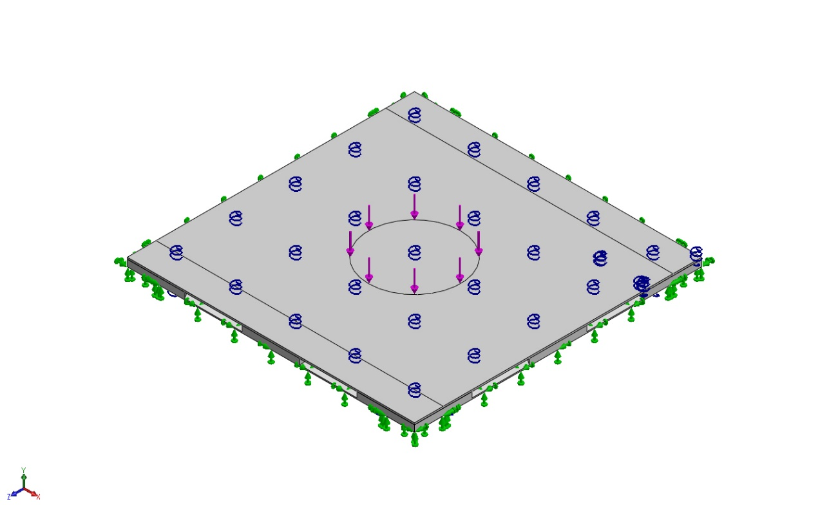
[picture p416: figure]

Model name: FEA_Assembly

Current Configuration: Default

Solid Bodies
Document Name and Reference | Treated As | Volumetric Properties | Document Path/Date Modified

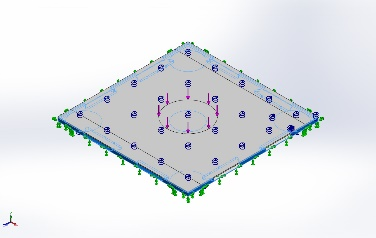
[picture p417: figure]

Split Line1 | Solid Body | Mass:0.590725 kg Volume:0.000234415 m^3 Density:2,520 kg/m^3 Weight:5.7891 N | C:\Users\luisa\Documents\GrabCAD\Lunar Dust Challenge\Current\Mechanical\v3_tiz\FEA\FEAbplate_v3.2.SLDPRT Mar 26 00:18:15 2021

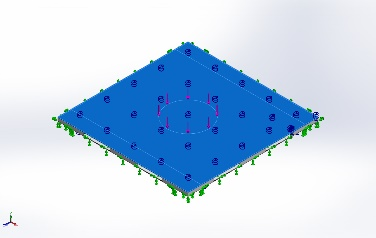
[picture p418: figure]

Split Line2 | Solid Body | Mass:0.194624 kg Volume:9.375e-05 m^3 Density:2,075.99 kg/m^3 Weight:1.90732 N | C:\Users\luisa\Documents\GrabCAD\Lunar Dust Challenge\Current\Mechanical\v3_tiz\FEA\FEAtplate_v3.2.SLDPRT Mar 26 10:52:25 2021

# Study Properties

Study name | Static 2
Analysis type | Static
Mesh type | Solid Mesh
Thermal Effect: | On
Thermal option | Include temperature loads
Zero strain temperature | 298 Kelvin
Include fluid pressure effects from SOLIDWORKS Flow Simulation | Off
Solver type | FFEPlus
Inplane Effect: | Off
Soft Spring: | Off
Inertial Relief: | Off
Incompatible bonding options | Automatic
Large displacement | Off
Compute free body forces | On
Friction | Off
Use Adaptive Method: | Off
Result folder | SOLIDWORKS document (C:\Users\luisa\Documents\GrabCAD\Lunar Dust Challenge\Current\Mechanical\v3_tiz\FEA)

# Units

Unit system: | SI (MKS)
Length/Displacement | mm
Temperature | Kelvin
Angular velocity | Rad/sec
Pressure/Stress | N/m^2

# Material Properties

| | Model Reference | Properties | Components

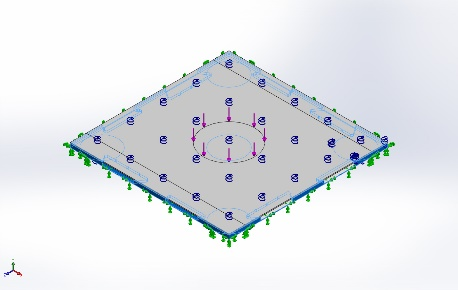
[picture p419: figure]

| | | Name: Macor Model type: Linear Elastic Isotropic Default failure criterion: Mohr-Coulomb Stress Yield strength: 9.4e+07 N/m^2 Tensile strength: 3.5e+07 N/m^2 Compressive strength: 3.45e+08 N/m^2 Elastic modulus: 6.68791e+10 N/m^2 Poisson's ratio: 0.29 Mass density: 2,520 kg/m^3 Shear modulus: 2.55106e+10 N/m^2 | SolidBody 1(Split Line1)(FEAbplate_v3.2-1)

Curve Data:N/A

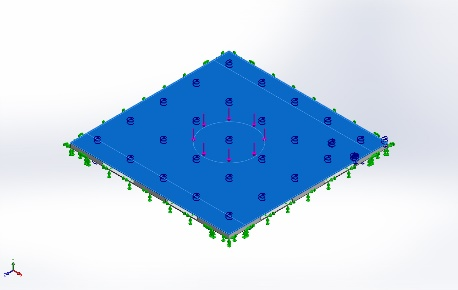
[picture p420: figure]

| | | Name: 99.5% Aluminum Oxide Model type: Linear Elastic Isotropic Default failure criterion: Mohr-Coulomb Stress Yield strength: 2.17185e+07 N/m^2 Tensile strength: 2.17185e+07 N/m^2 Compressive strength: 2.99922e+07 N/m^2 Elastic modulus: 3e+11 N/m^2 Poisson's ratio: 0.22 Mass density: 2,075.99 kg/m^3 Thermal expansion coefficient: 8e-06 /Kelvin | SolidBody 1(Split Line2)(FEAtplate_v3.2-1)

Curve Data:N/A

# Loads and Fixtures

Fixture name | Fixture Image | Fixture Details

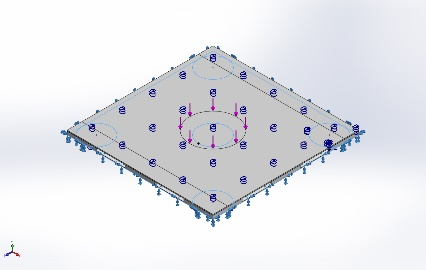
[picture p421: figure]

Fixed-1 | | Entities: 10 face(s) Type: Fixed Geometry

Resultant Forces

Components | X | Y | Z | Resultant
Reaction force(N) | -5.83766e-06 | 479.999 | -2.29839e-06 | 479.999
Reaction Moment(N.m) | 0 | 0 | 0 | 0

Load name | Load Image | Load Details

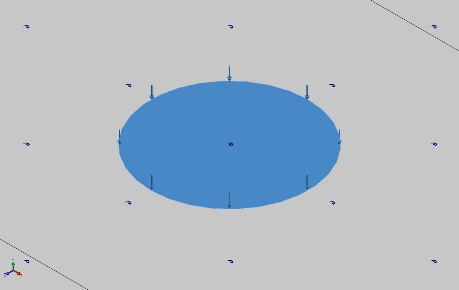
[picture p422: figure]

Force-1 | | Entities: 1 face(s) Type: Apply normal force Value: 480 N

# Connector Definitions

Connector Name | Connector Details | Connector Image

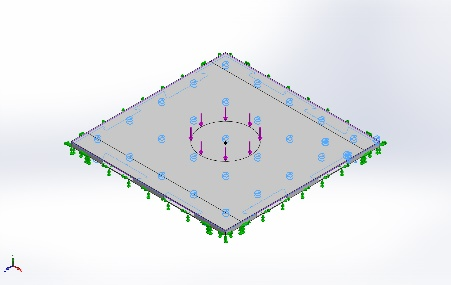
[picture p423: figure]

Spring Connector-1 | Entities: 2 face(s) Type: Spring(Flat parallel faces)(Compression & Extension) Normal stiffness value: 5e+09 (N/m)/m^2 Tangential Stiffness: 0 (N/m)/m^2 | Spring Connector-1

# Contact Information

Contact | Contact Image | Contact Properties

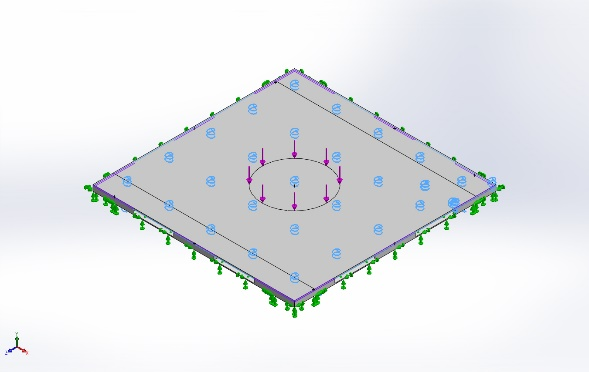
[picture p424: figure]

Contact Set-1 | | Type: Bonded contact pair Entities: 9 face(s)

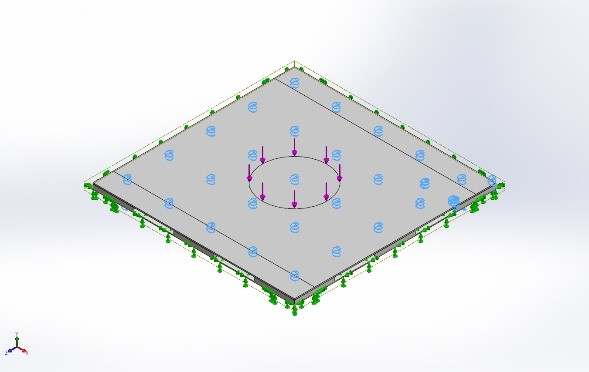
[picture p425: figure]

Global Contact | | Type: Bonded Components: 1 component(s) Options: Compatible mesh

# Mesh information

Mesh type | Solid Mesh
Mesher Used: | Standard mesh
Automatic Transition: | Off
Include Mesh Auto Loops: | Off
Jacobian points | 4 Points
Element Size | 0.25 in
Tolerance | 0.0125 in
Mesh Quality Plot | High
Remesh failed parts with incompatible mesh | Off

## Mesh information - Details

Total Nodes | 44019
Total Elements | 22047
Maximum Aspect Ratio | 33.098
% of elements with Aspect Ratio < 3 | 43.2
% of elements with Aspect Ratio > 10 | 0.776
% of distorted elements(Jacobian) | 0
Time to complete mesh(hh;mm;ss): | 00:00:06
Computer name:

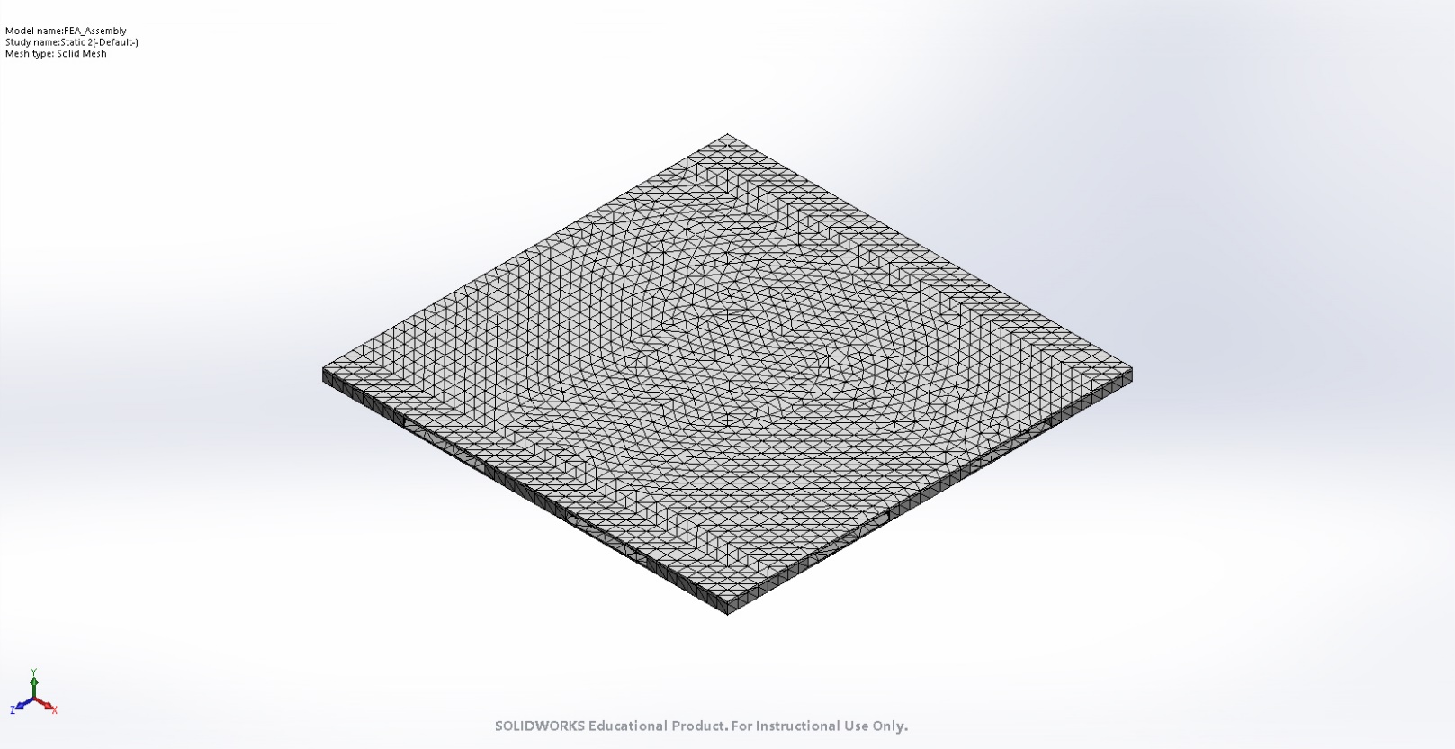
[picture p426: figure]

# Sensor Details

No Data

# Resultant Forces

## Reaction forces

Selection set | Units | Sum X | Sum Y | Sum Z | Resultant
Entire Model | N | -5.83766e-06 | 479.999 | -2.29839e-06 | 479.999

## Reaction Moments

Selection set | Units | Sum X | Sum Y | Sum Z | Resultant
Entire Model | N.m | 0 | 0 | 0 | 0

# Beams

No Data

# Study Results

Name | Type | Min | Max
Stress1 | VON: von Mises Stress | 1.373e-02 N/m^2 Node: 11084 | 5.533e+06 N/m^2 Node: 36019

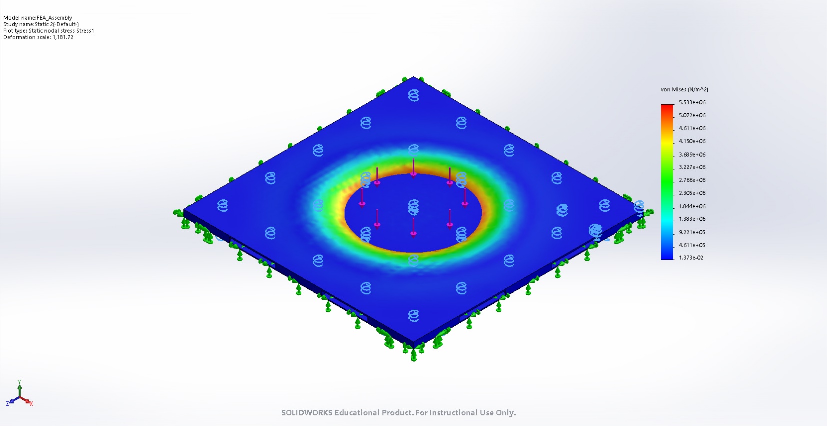
[picture p427: figure]

FEA_Assembly-Static 2-Stress-Stress1

Name | Type | Min | Max
Displacement1 | URES: Resultant Displacement | 0.000e+00 mm Node: 73 | 2.116e-02 mm Node: 29254

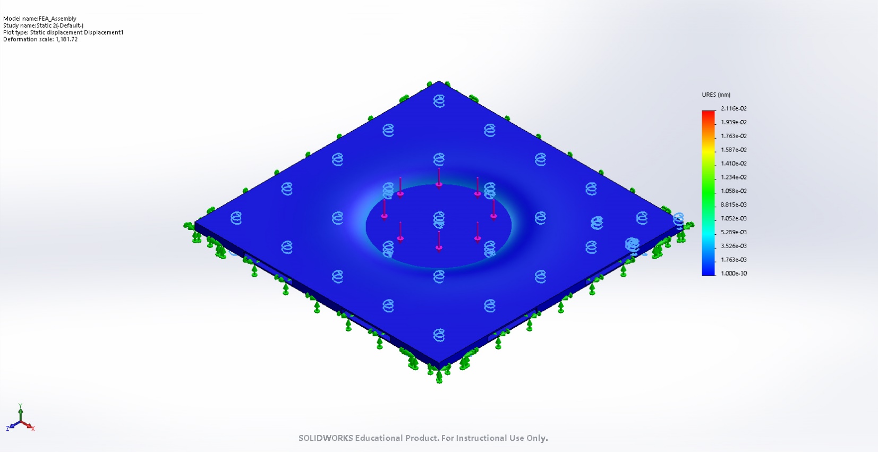
[picture p428: figure]

FEA_Assembly-Static 2-Displacement-Displacement1

Name | Type | Min | Max
Strain1 | ESTRN: Equivalent Strain | 7.838e-14 Element: 12128 | 1.132e-05 Element: 12854

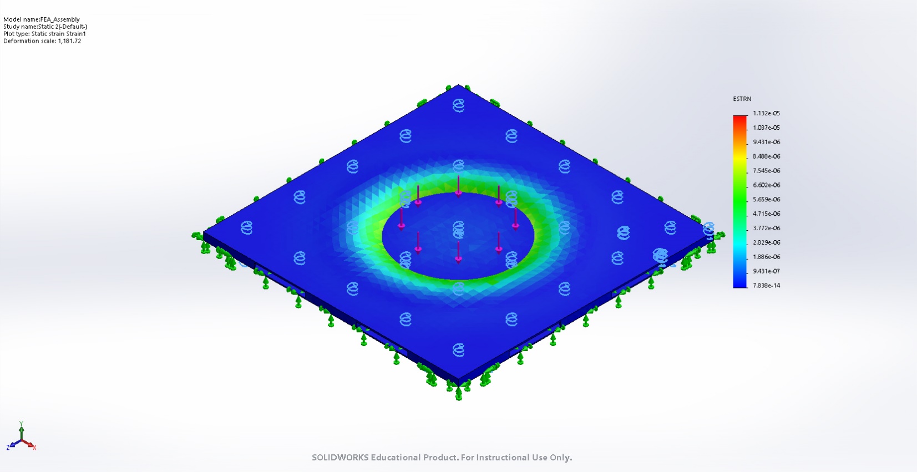
[picture p429: figure]

FEA_Assembly-Static 2-Strain-Strain1

Name | Type
Displacement1{1} | Deformed shape

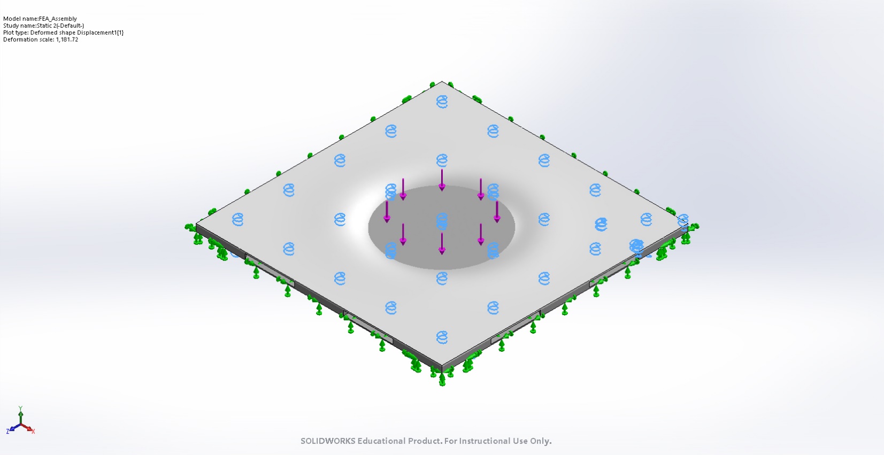
[picture p430: figure]

FEA_Assembly-Static 2-Displacement-Displacement1{1}

Name | Type | Min | Max
Factor of Safety1 | Mohr-Coulomb Stress | 3.863e+00 Node: 30328 | 1.584e+10 Node: 23852

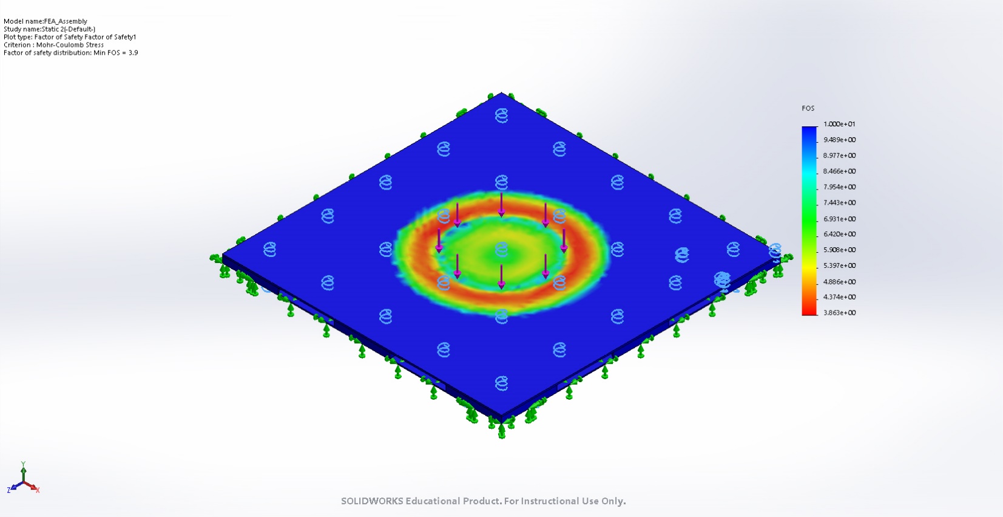
[picture p431: figure]

FEA_Assembly-Static 2-Factor of Safety-Factor of Safety1

# Conclusion

Analyzed with SOLIDWORKS Simulation Simulation of FEA_Assembly 7

Analyzed with SOLIDWORKS Simulation Simulation of FEA_Assembly 1
