caltechcaos/Lunar-Dust-Challenge/Current/Mechanical/v3_tiz/FEA/panel_assembly_test-3point_bend-1.docx

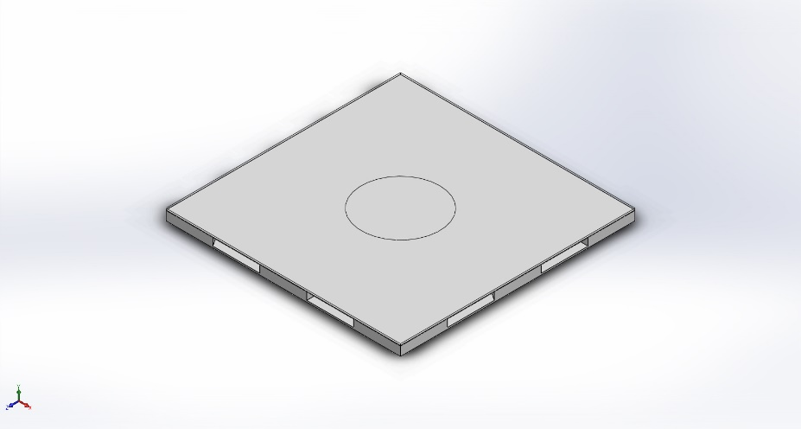
[picture p449: figure]

Simulation of panel_assembly_test

Date: Friday, April 16, 2021
Designer: Solidworks

Study name: 3point_bend

Analysis type: Static
Description No Data

# Assumptions

# Model Information

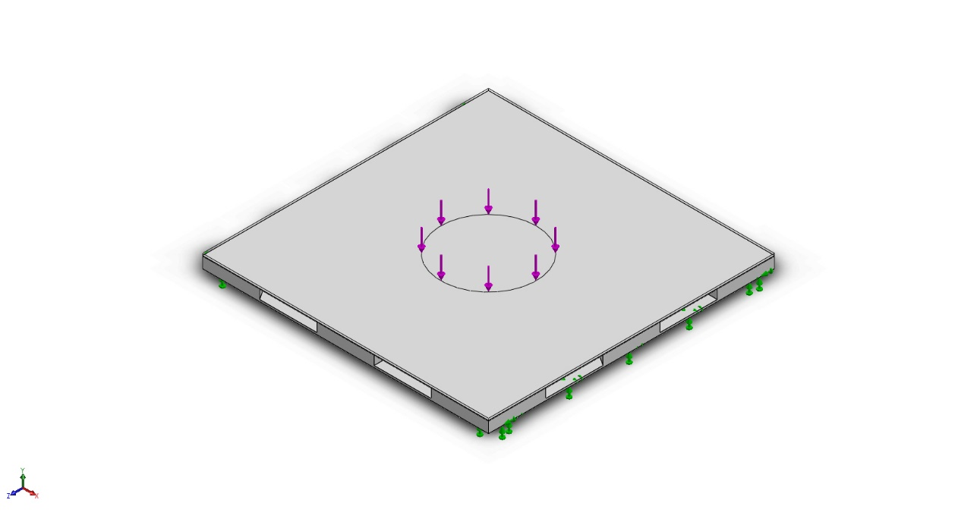
[picture p450: figure]

Model name: panel_assembly_test

Current Configuration: Default

Solid Bodies
Document Name and Reference | Treated As | Volumetric Properties | Document Path/Date Modified

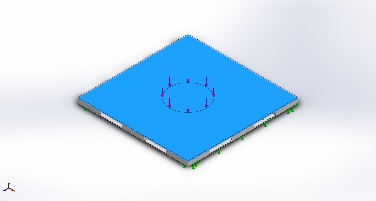
[picture p451: figure]

Boss-Extrude1 | Solid Body | Mass:0.0151875 kg Volume:5.625e-06 m^3 Density:2,700 kg/m^3 Weight:0.148838 N | C:\Users\Natha\Desktop\Caltech 2020-2024\NASA_Big_Idea_Challenge\GrabCAD\Current\Mechanical\v3_tiz\FEA\adhesive_test.SLDPRT Apr 15 23:54:03 2021

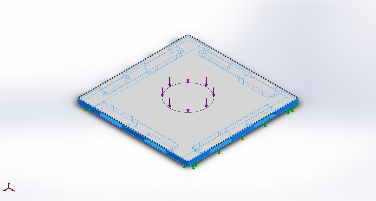
[picture p452: figure]

Split Line1 | Solid Body | Mass:0.260511 kg Volume:0.000103377 m^3 Density:2,520 kg/m^3 Weight:2.55301 N | C:\Users\Natha\Desktop\Caltech 2020-2024\NASA_Big_Idea_Challenge\GrabCAD\Current\Mechanical\v3_tiz\FEA\bplate_test.SLDPRT Apr 16 09:41:48 2021

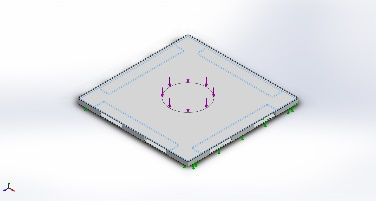
[picture p453: figure]

Fillet2 | Solid Body | Mass:0.0194472 kg Volume:1.36952e-05 m^3 Density:1,420 kg/m^3 Weight:0.190582 N | C:\Users\Natha\Desktop\Caltech 2020-2024\NASA_Big_Idea_Challenge\GrabCAD\Current\Mechanical\v3_tiz\FEA\pcb_mockup_test.SLDPRT Apr 15 23:54:03 2021

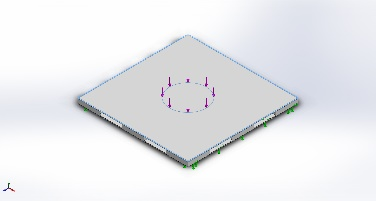
[picture p454: figure]

Split Line1 | Solid Body | Mass:0.136575 kg Volume:2.25e-05 m^3 Density:6,070 kg/m^3 Weight:1.33843 N | C:\Users\Natha\Desktop\Caltech 2020-2024\NASA_Big_Idea_Challenge\GrabCAD\Current\Mechanical\v3_tiz\FEA\tplate_test.SLDPRT Apr 15 23:54:03 2021

# Study Properties

Study name | 3point_bend
Analysis type | Static
Mesh type | Solid Mesh
Thermal Effect: | On
Thermal option | Include temperature loads
Zero strain temperature | 298 Kelvin
Include fluid pressure effects from SOLIDWORKS Flow Simulation | Off
Solver type | FFEPlus
Inplane Effect: | Off
Soft Spring: | Off
Inertial Relief: | Off
Incompatible bonding options | Automatic
Large displacement | Off
Compute free body forces | On
Friction | Off
Use Adaptive Method: | Off
Result folder | SOLIDWORKS document (C:\Users\Natha\Desktop\Caltech 2020-2024\NASA_Big_Idea_Challenge\GrabCAD\Current\Mechanical\v3_tiz\FEA)

# Units

Unit system: | SI (MKS)
Length/Displacement | mm
Temperature | Kelvin
Angular velocity | Rad/sec
Pressure/Stress | N/m^2

# Material Properties

Model Reference | Properties | Components

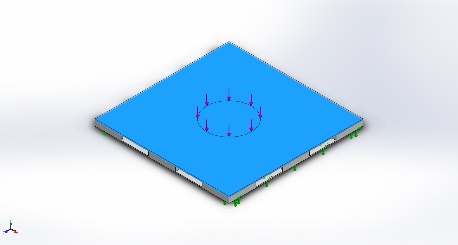
[picture p455: figure]

| Name: STYCAST 2850FT/Catalyst 23LV Model type: Linear Elastic Isotropic Default failure criterion: Unknown Tensile strength: 1.0549e+08 N/m^2 Compressive strength: 1.19969e+08 N/m^2 Elastic modulus: 9e+10 N/m^2 Poisson's ratio: 0.3 Mass density: 2,700 kg/m^3 | SolidBody 1(Boss-Extrude1)(adhesive_test-1)

Curve Data:N/A

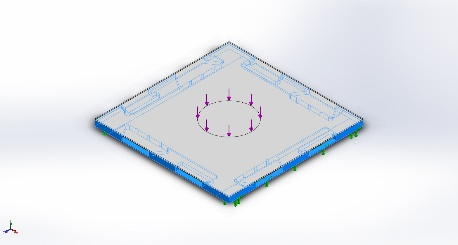
[picture p456: figure]

| Name: Macor Model type: Linear Elastic Isotropic Default failure criterion: Unknown Yield strength: 9.4e+07 N/m^2 Tensile strength: 3.5e+07 N/m^2 Compressive strength: 3.45e+08 N/m^2 Elastic modulus: 6.68791e+10 N/m^2 Poisson's ratio: 0.29 Mass density: 2,520 kg/m^3 Shear modulus: 2.55106e+10 N/m^2 | SolidBody 1(Split Line1)(bplate_test-1)

Curve Data:N/A

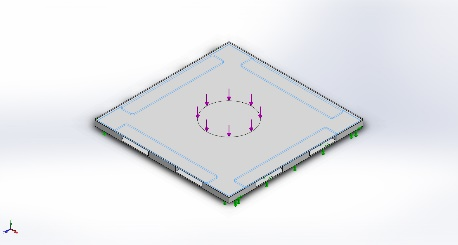
[picture p457: figure]

| Name: Kapton Model type: Linear Elastic Isotropic Default failure criterion: Unknown Yield strength: 6.9e+07 N/m^2 Tensile strength: 2.31e+08 N/m^2 Compressive strength: 2.31e+08 N/m^2 Elastic modulus: 2.76e+09 N/m^2 Poisson's ratio: 0.34 Mass density: 1,420 kg/m^3 Thermal expansion coefficient: 20 /Kelvin | SolidBody 1(Fillet2)(pcb_mockup_test-1)

Curve Data:N/A

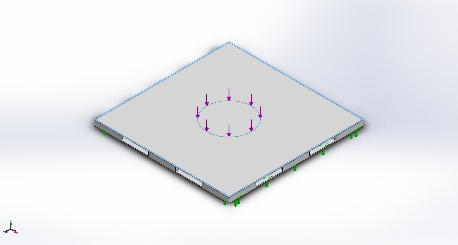
[picture p458: figure]

| Name: Zirconia Model type: Linear Elastic Isotropic Default failure criterion: Unknown Yield strength: 1.15e+08 N/m^2 Tensile strength: 1.4e+09 N/m^2 Compressive strength: 2.1e+09 N/m^2 Elastic modulus: 2e+11 N/m^2 Poisson's ratio: 0.3 Mass density: 6,070 kg/m^3 Thermal expansion coefficient: 1e-06 /Kelvin | SolidBody 1(Split Line1)(tplate_test-1)

Curve Data:N/A

# Loads and Fixtures

Fixture name | Fixture Image | Fixture Details

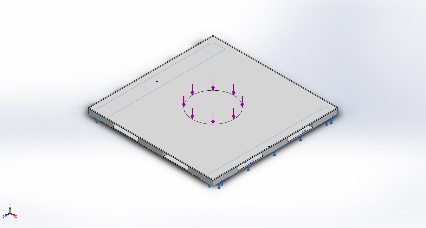
[picture p459: figure]

Fixed-2 | | Entities: 2 face(s) Type: Fixed Geometry

Resultant Forces

Components | X | Y | Z | Resultant
Reaction force(N) | 0.000224004 | 486 | 9.26759e-06 | 486
Reaction Moment(N.m) | 0 | 0 | 0 | 0

Load name | Load Image | Load Details

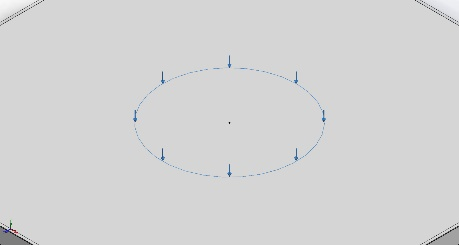
[picture p460: figure]

Force-1 | | Entities: 1 face(s) Type: Apply normal force Value: 486 N

# Connector Definitions

No Data

# Contact Information

Contact | Contact Image | Contact Properties

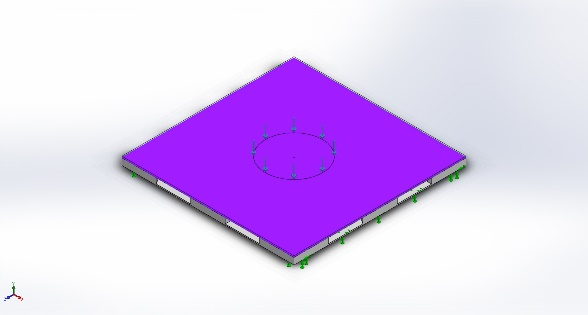
[picture p461: figure]

Contact Set-1 | | Type: Bonded contact pair Entities: 2 face(s)

Contact/Friction force

Components | X | Y | Z | Resultant
Contact Force(N) | 0 | 5.7434E-06 | 0 | 5.7434E-06

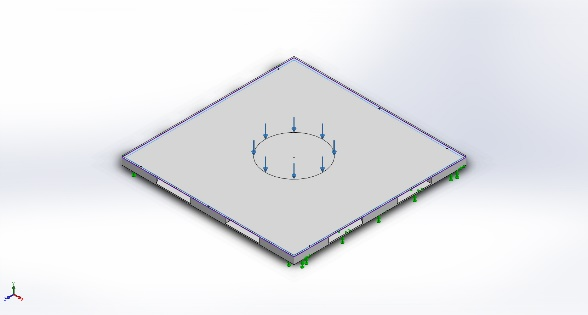
[picture p462: figure]

Contact Set-2 | | Type: Bonded contact pair Entities: 10 face(s)

Contact/Friction force

Components | X | Y | Z | Resultant
Contact Force(N) | -1.9282E-06 | 5.8239E-05 | -0.00015204 | 0.00016283

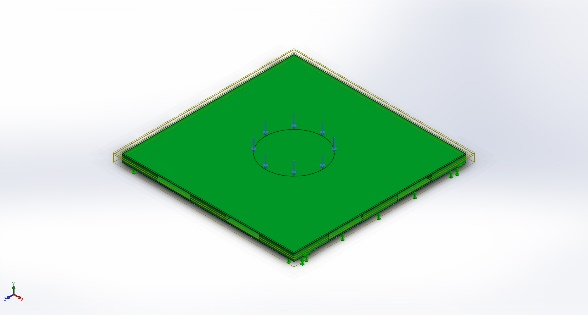
[picture p463: figure]

Component Contact-1 | | Type: No penetration (Surface to surface) Components: 4 component(s)

# Mesh information

Mesh type | Solid Mesh
Mesher Used: | Curvature-based mesh
Jacobian points | 4 Points
Maximum element size | 0.245854 in
Minimum element size | 0.0122927 in
Mesh Quality Plot | High
Remesh failed parts with incompatible mesh | Off

## Mesh information - Details

Total Nodes | 83089
Total Elements | 43100
Maximum Aspect Ratio | 44.271
% of elements with Aspect Ratio < 3 | 46.7
% of elements with Aspect Ratio > 10 | 24.7
% of distorted elements(Jacobian) | 0
Time to complete mesh(hh;mm;ss): | 00:00:04
Computer name: | THICCO

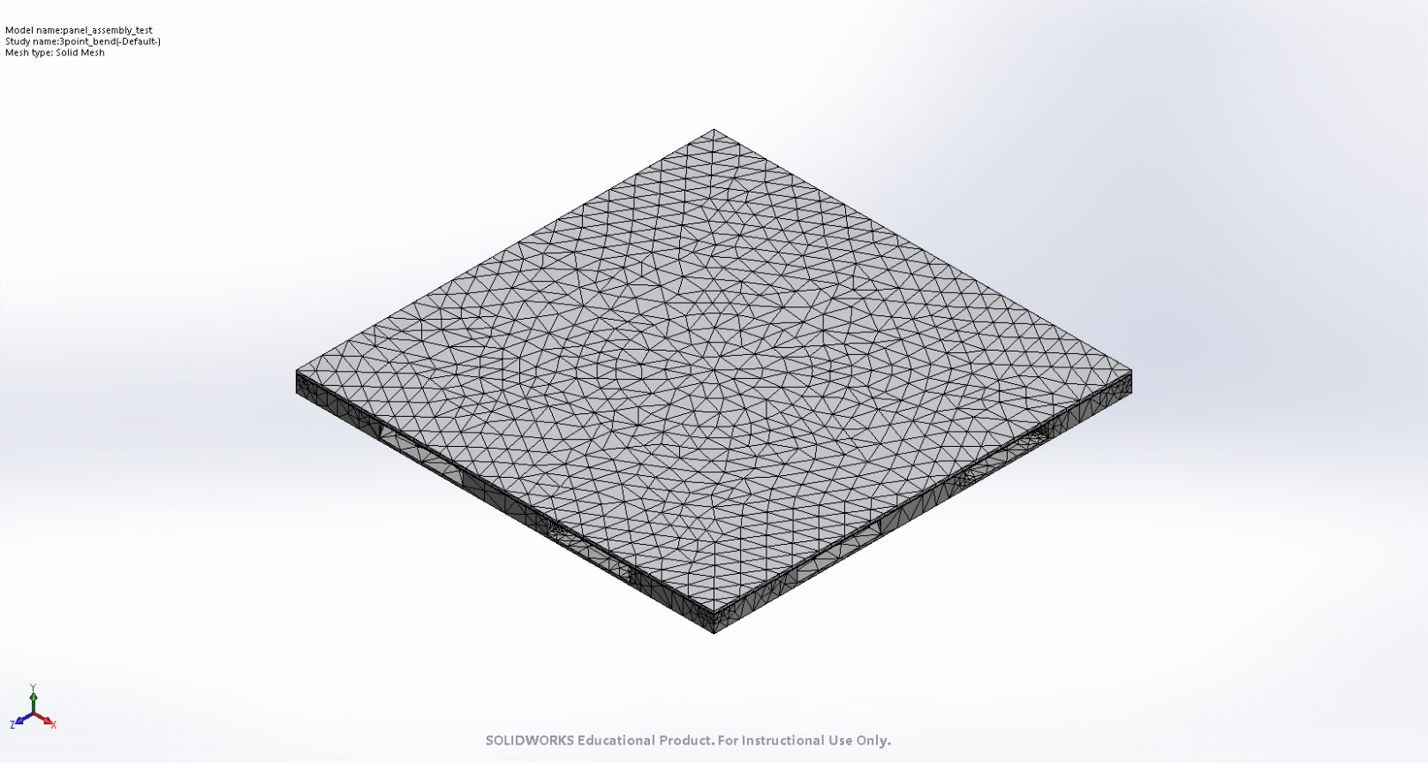
[picture p464: figure]

## Mesh Control Information:

Mesh Control Name | Mesh Control Image | Mesh Control Details

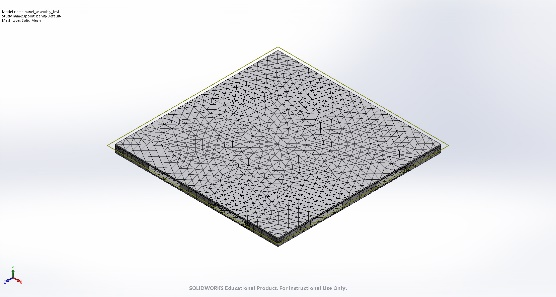
[picture p465: figure]

Control-3 | | Entities: 1 component(s) Units: in Size: 0.241615 Ratio: 0.241615

# Sensor Details

Sensor name | Location | Sensor Details

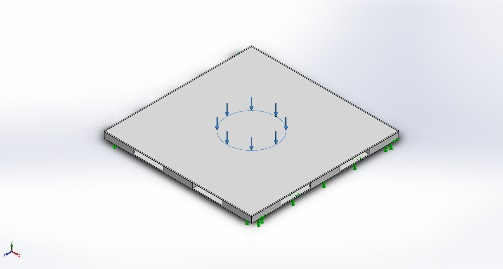
[picture p466: figure]

Stress1 | | Value : 8.630e+06 N/m^2 Entities :1 face(s) Result :Stress Component :VON: von Mises Stress Criterion :Max over Selected Entities Step Criterion : Across all Steps Step No.:1 Alert Value: NA

# Resultant Forces

## Reaction forces

Selection set | Units | Sum X | Sum Y | Sum Z | Resultant
Entire Model | N | 0.000224004 | 486 | 9.26759e-06 | 486

## Reaction Moments

Selection set | Units | Sum X | Sum Y | Sum Z | Resultant
Entire Model | N.m | 0 | 0 | 0 | 0

# Beams

No Data

# Study Results

Name | Type | Min | Max
Displacement1 | URES: Resultant Displacement | 0.000e+00 mm Node: 12542 | 5.515e-02 mm Node: 79822


panel_assembly_test-3point_bend-Displacement-Displacement1

Name | Type | Min | Max
Strain1 | ESTRN: Equivalent Strain | 8.926e-10 Element: 21091 | 3.280e-04 Element: 26082

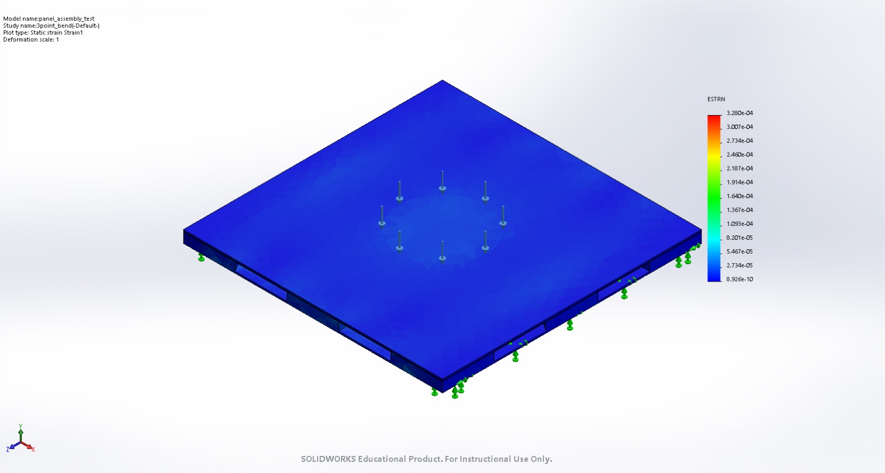
[picture p467: figure]

panel_assembly_test-3point_bend-Strain-Strain1

Name | Type | Min | Max
Factor of Safety1 | Mohr-Coulomb Stress | 2.786e+00 Node: 35401 | 1.435e+06 Node: 25767

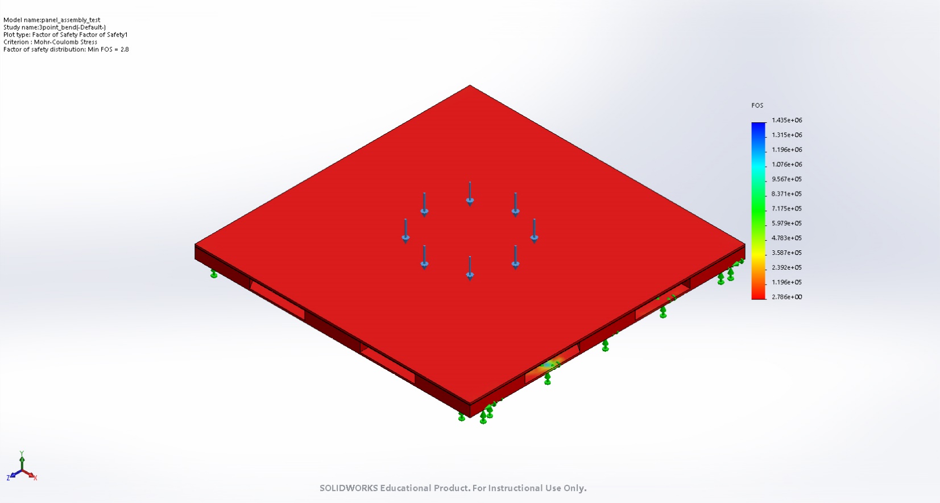
[picture p468: figure]

panel_assembly_test-3point_bend-Factor of Safety-Factor of Safety1

# Conclusion

Analyzed with SOLIDWORKS Simulation Simulation of panel_assembly_test 7

Analyzed with SOLIDWORKS Simulation Simulation of panel_assembly_test 1
