caltechcaos/Lunar-Dust-Challenge/Current/Mechanical/v3_tiz/FEA/panel_assembly_test-cantilever-1.docx

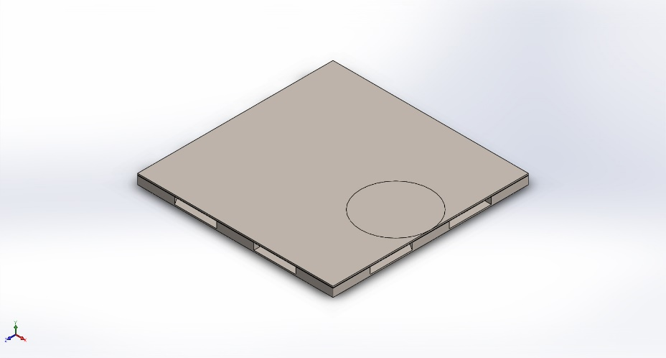
[picture p469: figure]

Simulation of panel_assembly_test

Date: Friday, April 23, 2021
Designer: Solidworks

Study name: cantilever

Analysis type: Static
Description No Data

# Assumptions

# Model Information

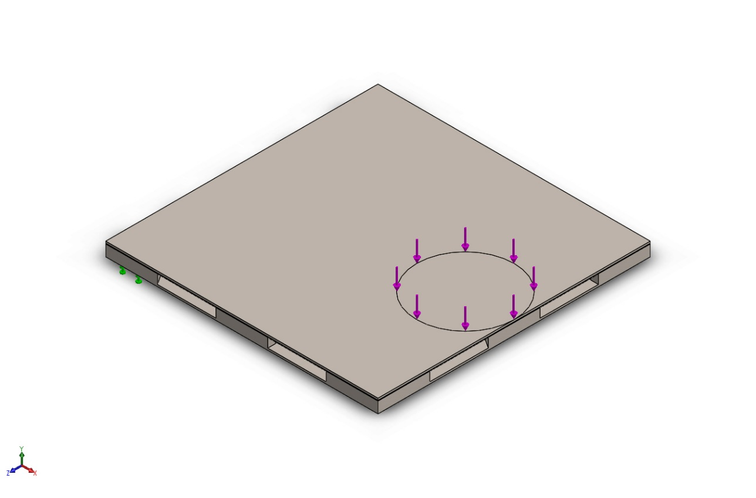
[picture p470: figure]

Model name: panel_assembly_test

Current Configuration: Default

Solid Bodies
Document Name and Reference | Treated As | Volumetric Properties | Document Path/Date Modified

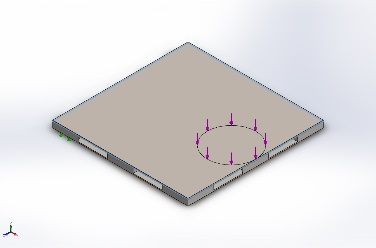
[picture p471: figure]

Boss-Extrude1 | Solid Body | Mass:0.0131734 kg Volume:4.87902e-06 m^3 Density:2,700 kg/m^3 Weight:0.129099 N | C:\Users\Natha\Desktop\Caltech 2020-2024\NASA_Big_Idea_Challenge\GrabCAD\Current\Mechanical\v3_tiz\FEA\adhesive_test.SLDPRT Apr 23 10:33:36 2021

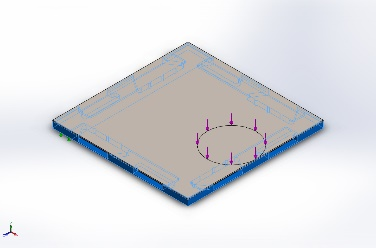
[picture p472: figure]

Split Line1 | Solid Body | Mass:0.22009 kg Volume:8.73375e-05 m^3 Density:2,520 kg/m^3 Weight:2.15689 N | C:\Users\Natha\Desktop\Caltech 2020-2024\NASA_Big_Idea_Challenge\GrabCAD\Current\Mechanical\v3_tiz\FEA\bplate_test.SLDPRT Apr 23 00:49:29 2021

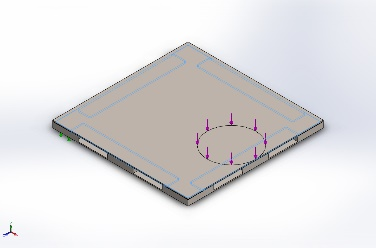
[picture p473: figure]

Fillet2 | Solid Body | Mass:0.0178601 kg Volume:1.25775e-05 m^3 Density:1,420 kg/m^3 Weight:0.175029 N | C:\Users\Natha\Desktop\Caltech 2020-2024\NASA_Big_Idea_Challenge\GrabCAD\Current\Mechanical\v3_tiz\FEA\pcb_mockup_test.SLDPRT Apr 23 10:33:37 2021

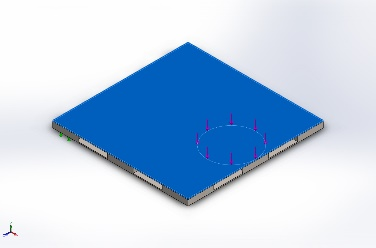
[picture p474: figure]

Split Line1 | Solid Body | Mass:0.0731853 kg Volume:1.95161e-05 m^3 Density:3,750 kg/m^3 Weight:0.717216 N | C:\Users\Natha\Desktop\Caltech 2020-2024\NASA_Big_Idea_Challenge\GrabCAD\Current\Mechanical\v3_tiz\FEA\tplate_test.SLDPRT Apr 23 00:49:17 2021

# Study Properties

Study name | cantilever
Analysis type | Static
Mesh type | Solid Mesh
Thermal Effect: | On
Thermal option | Include temperature loads
Zero strain temperature | 298 Kelvin
Include fluid pressure effects from SOLIDWORKS Flow Simulation | Off
Solver type | FFEPlus
Inplane Effect: | Off
Soft Spring: | Off
Inertial Relief: | Off
Incompatible bonding options | Automatic
Large displacement | Off
Compute free body forces | On
Friction | Off
Use Adaptive Method: | Off
Result folder | SOLIDWORKS document (C:\Users\Natha\Desktop\Caltech 2020-2024\NASA_Big_Idea_Challenge\GrabCAD\Current\Mechanical\v3_tiz\FEA)

# Units

Unit system: | SI (MKS)
Length/Displacement | mm
Temperature | Kelvin
Angular velocity | Rad/sec
Pressure/Stress | N/m^2

# Material Properties

Model Reference | Properties | Components

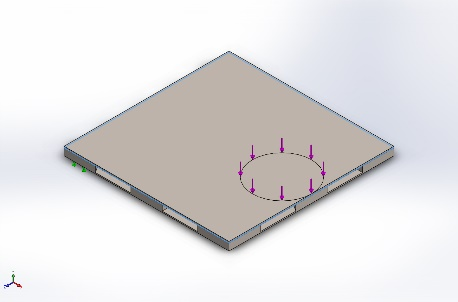
[picture p475: figure]

| Name: STYCAST 2850FT/Catalyst 23LV Model type: Linear Elastic Isotropic Default failure criterion: Unknown Tensile strength: 1.0549e+08 N/m^2 Compressive strength: 1.19969e+08 N/m^2 Elastic modulus: 9e+10 N/m^2 Poisson's ratio: 0.3 Mass density: 2,700 kg/m^3 | SolidBody 1(Boss-Extrude1)(adhesive_test-1)

Curve Data:N/A

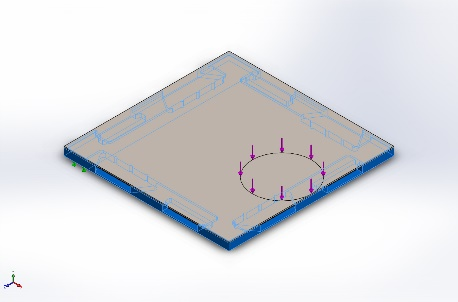
[picture p476: figure]

| Name: Macor Model type: Linear Elastic Isotropic Default failure criterion: Unknown Yield strength: 3.3e+07 N/m^2 Tensile strength: 3.3e+07 N/m^2 Compressive strength: 3.45e+08 N/m^2 Elastic modulus: 6.69e+10 N/m^2 Poisson's ratio: 0.29 Mass density: 2,520 kg/m^3 Shear modulus: 2.55e+10 N/m^2 Thermal expansion coefficient: 8.1e-06 /Kelvin | SolidBody 1(Split Line1)(bplate_test-1)

Curve Data:N/A

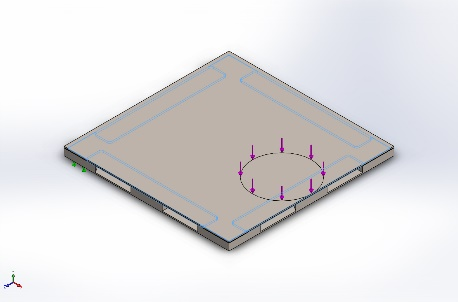
[picture p477: figure]

| Name: Kapton Model type: Linear Elastic Isotropic Default failure criterion: Unknown Yield strength: 6.9e+07 N/m^2 Tensile strength: 2.31e+08 N/m^2 Compressive strength: 2.31e+08 N/m^2 Elastic modulus: 2.76e+09 N/m^2 Poisson's ratio: 0.34 Mass density: 1,420 kg/m^3 Thermal expansion coefficient: 20 /Kelvin | SolidBody 1(Fillet2)(pcb_mockup_test-1)

Curve Data:N/A

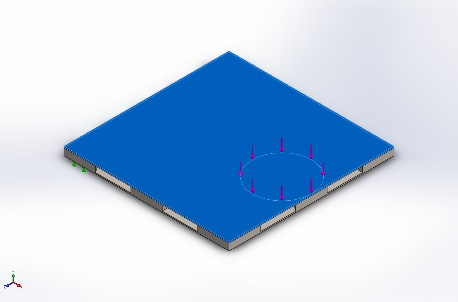
[picture p478: figure]

| Name: 99.5% Aluminum Oxide Model type: Linear Elastic Isotropic Default failure criterion: Unknown Yield strength: 1.55e+08 N/m^2 Tensile strength: 1.55e+08 N/m^2 Compressive strength: 2.5e+09 N/m^2 Elastic modulus: 3e+11 N/m^2 Poisson's ratio: 0.22 Mass density: 3,750 kg/m^3 Shear modulus: 1.52001e+11 N/m^2 Thermal expansion coefficient: 8.4e-06 /Kelvin | SolidBody 1(Split Line1)(tplate_test-1)

Curve Data:N/A

# Loads and Fixtures

Fixture name | Fixture Image | Fixture Details

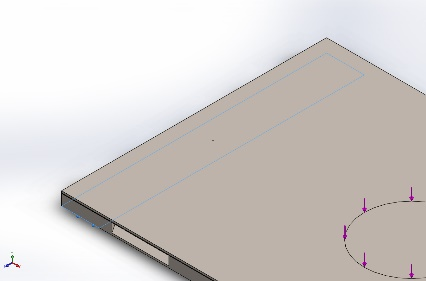
[picture p479: figure]

Fixed-1 | | Entities: 1 face(s) Type: Fixed Geometry

Resultant Forces

Components | X | Y | Z | Resultant
Reaction force(N) | 0.000427246 | 486 | 0 | 486
Reaction Moment(N.m) | 0 | 0 | 0 | 0

Load name | Load Image | Load Details

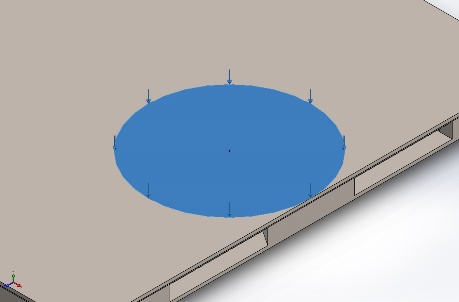
[picture p480: figure]

Force-1 | | Entities: 1 face(s) Type: Apply normal force Value: 486 N

# Connector Definitions

No Data

# Contact Information

Contact | Contact Image | Contact Properties

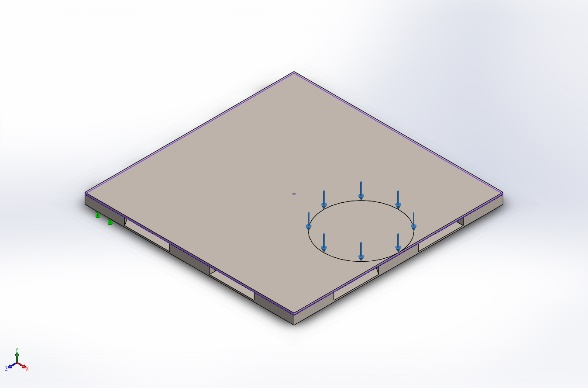
[picture p481: figure]

Contact Set-1 | | Type: Bonded contact pair Entities: 2 face(s)

Contact/Friction force

Components | X | Y | Z | Resultant
Contact Force(N) | -0.019327 | 135.03 | 0.38848 | 135.03

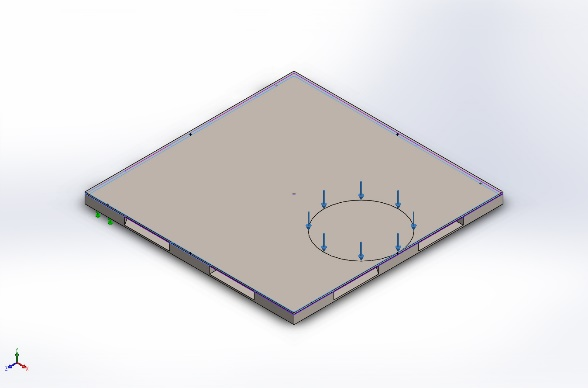
[picture p482: figure]

Contact Set-2 | | Type: Bonded contact pair Entities: 10 face(s)

Contact/Friction force

Components | X | Y | Z | Resultant
Contact Force(N) | -0.01178 | 343.97 | 0.64407 | 343.97

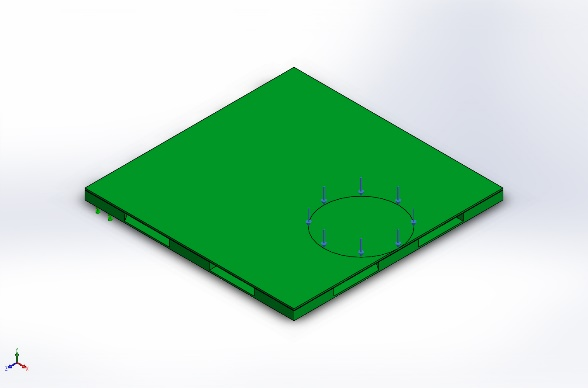
[picture p483: figure]

Component Contact-1 | | Type: No penetration (Surface to surface) Components: 4 component(s)

# Mesh information

Mesh type | Solid Mesh
Mesher Used: | Standard mesh
Automatic Transition: | Off
Include Mesh Auto Loops: | Off
Jacobian points | 4 Points
Element Size | 0.5 in
Tolerance | 0.025 in
Mesh Quality Plot | High
Remesh failed parts with incompatible mesh | Off

## Mesh information - Details

Total Nodes | 14713
Total Elements | 7659
Maximum Aspect Ratio | 619.45
% of elements with Aspect Ratio < 3 | 18.9
% of elements with Aspect Ratio > 10 | 46.2
% of distorted elements(Jacobian) | 0
Time to complete mesh(hh;mm;ss): | 00:00:03
Computer name: | THICCO

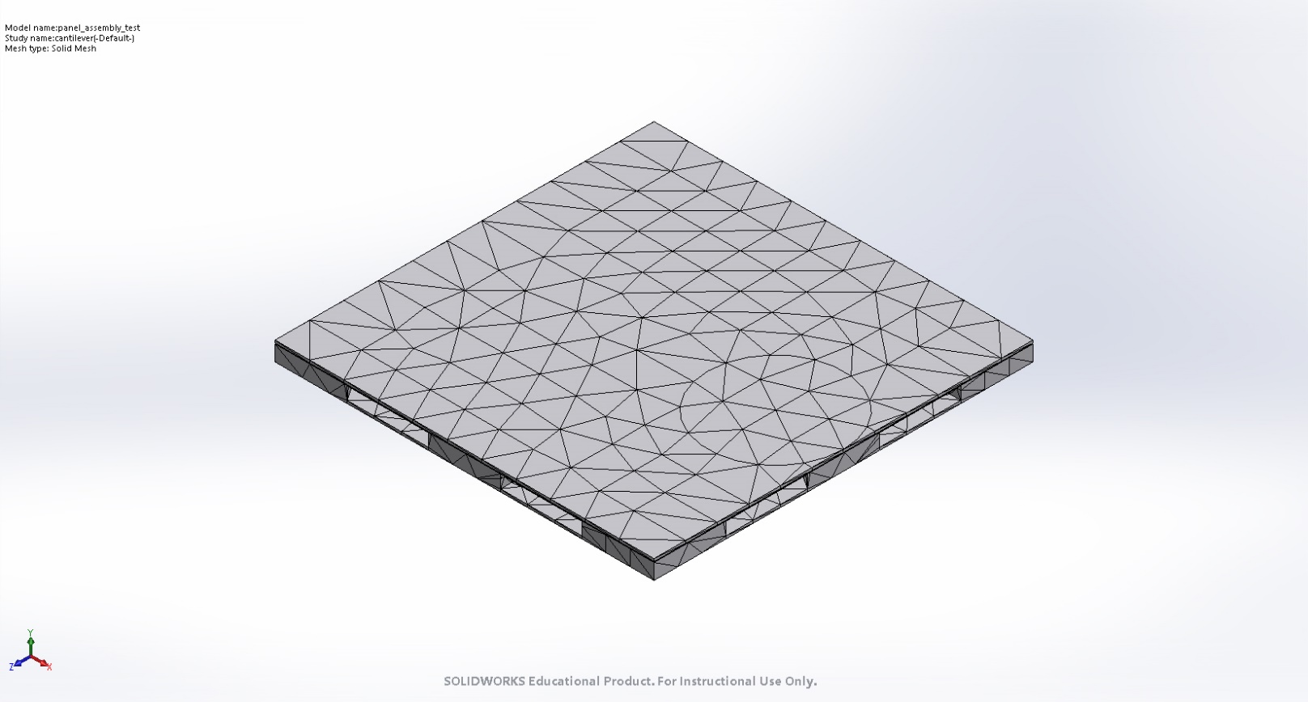
[picture p484: figure]

# Sensor Details

Sensor name | Location | Sensor Details

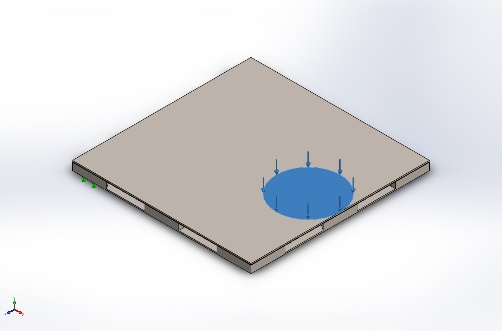
[picture p485: figure]

Stress1 | | Value : 4.265e+07 N/m^2 Entities :1 face(s) Result :Stress Component :VON: von Mises Stress Criterion :Max over Selected Entities Step Criterion : Across all Steps Step No.:1 Alert Value: NA

# Resultant Forces

## Reaction forces

Selection set | Units | Sum X | Sum Y | Sum Z | Resultant
Entire Model | N | 0.000427246 | 486 | 0 | 486

## Reaction Moments

Selection set | Units | Sum X | Sum Y | Sum Z | Resultant
Entire Model | N.m | 0 | 0 | 0 | 0

# Beams

No Data

# Study Results

Name | Type | Min | Max
Displacement1 | URES: Resultant Displacement | 0.000e+00 mm Node: 1876 | 1.065e+00 mm Node: 13124

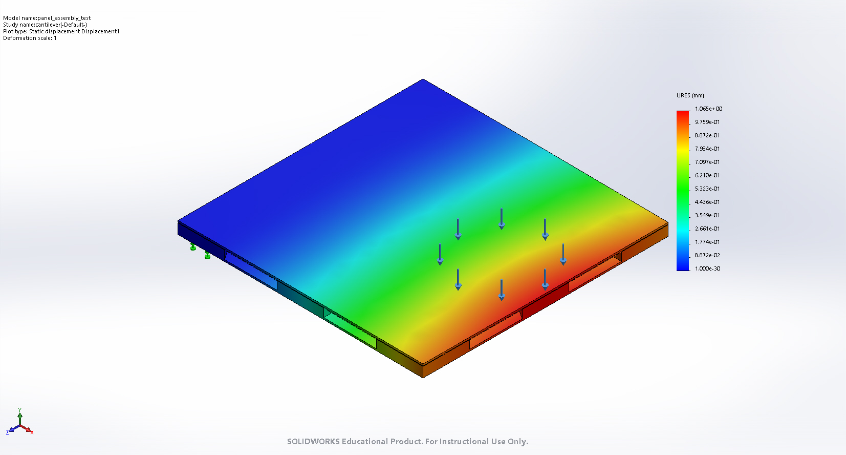
[picture p486: figure]

panel_assembly_test-cantilever-Displacement-Displacement1

Name | Type | Min | Max
Strain1 | ESTRN: Equivalent Strain | 7.421e-08 Element: 2508 | 1.776e-03 Element: 5438

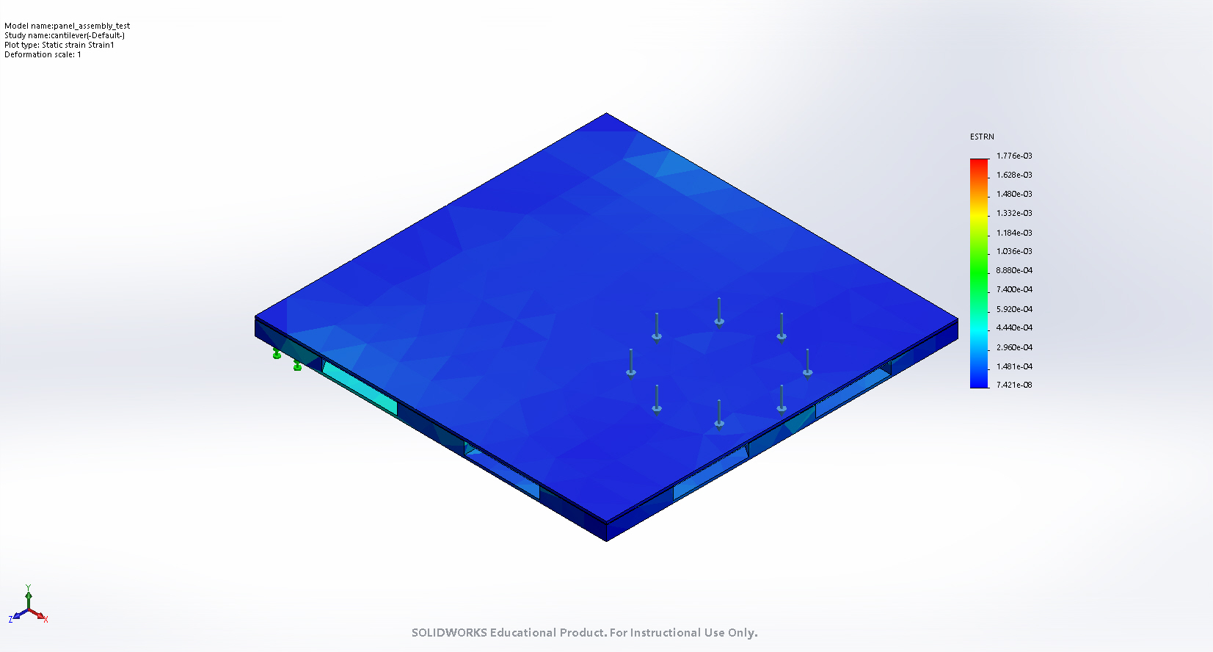
[picture p487: figure]

panel_assembly_test-cantilever-Strain-Strain1

Name | Type | Min | Max
Factor of Safety1 | Mohr-Coulomb Stress | 2.526e-01 Node: 7189 | 5.868e+03 Node: 6957

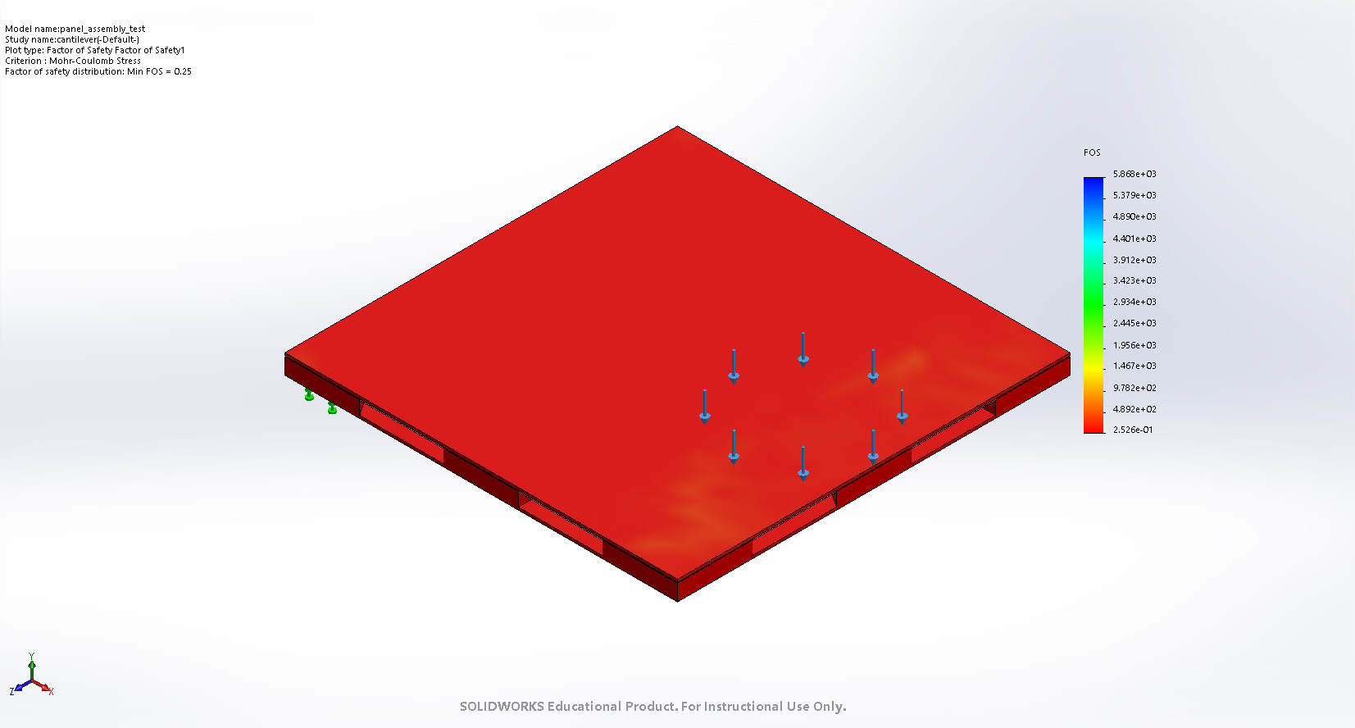
[picture p488: figure]

panel_assembly_test-cantilever-Factor of Safety-Factor of Safety1

# Conclusion

Analyzed with SOLIDWORKS Simulation Simulation of panel_assembly_test 7

Analyzed with SOLIDWORKS Simulation Simulation of panel_assembly_test 1
