caltechcaos/Lunar-Dust-Challenge/Current/Mechanical/v3_tiz/FEA/panel_assembly_test4.5-ZIRCONIA.docx

Simulation of panel_assembly_test4.5

Date: Sunday, April 18, 2021
Designer: Solidworks

Study name: Static 1

Analysis type: Static
Description No Data

# Assumptions

# Model Information


Model name: panel_assembly_test4.5

Current Configuration: Default

Solid Bodies
Document Name and Reference | Treated As | Volumetric Properties | Document Path/Date Modified


Boss-Extrude1 | Solid Body | Mass:0.0087723 kg Volume:3.249e-06 m^3 Density:2,700 kg/m^3 Weight:0.0859685 N | C:\Users\luisa\Documents\GrabCAD\Lunar Dust Challenge\Current\Mechanical\v3_tiz\FEA\4.5 INCHES\4.5adhesive_test.SLDPRT Apr 18 00:06:39 2021


Split Line1 | Solid Body | Mass:0.137333 kg Volume:5.44971e-05 m^3 Density:2,520 kg/m^3 Weight:1.34586 N | C:\Users\luisa\Documents\GrabCAD\Lunar Dust Challenge\Current\Mechanical\v3_tiz\FEA\4.5 INCHES\4.5bplate_test.SLDPRT Apr 18 00:11:48 2021


Fillet2 | Solid Body | Mass:0.0136297 kg Volume:9.59839e-06 m^3 Density:1,420 kg/m^3 Weight:0.133571 N | C:\Users\luisa\Documents\GrabCAD\Lunar Dust Challenge\Current\Mechanical\v3_tiz\FEA\4.5 INCHES\4.5pcb_mockup_test.SLDPRT Apr 18 00:06:40 2021


Split Line1 | Solid Body | Mass:0.0788857 kg Volume:1.2996e-05 m^3 Density:6,070 kg/m^3 Weight:0.77308 N | C:\Users\luisa\Documents\GrabCAD\Lunar Dust Challenge\Current\Mechanical\v3_tiz\FEA\4.5 INCHES\4.5tplate_test.SLDPRT Apr 18 00:13:08 2021

# Study Properties

Study name | Static 1
Analysis type | Static
Mesh type | Solid Mesh
Thermal Effect: | On
Thermal option | Include temperature loads
Zero strain temperature | 298 Kelvin
Include fluid pressure effects from SOLIDWORKS Flow Simulation | Off
Solver type | FFEPlus
Inplane Effect: | Off
Soft Spring: | Off
Inertial Relief: | Off
Incompatible bonding options | Automatic
Large displacement | Off
Compute free body forces | On
Friction | Off
Use Adaptive Method: | Off
Result folder | SOLIDWORKS document (C:\Users\luisa\Documents\GrabCAD\Lunar Dust Challenge\Current\Mechanical\v3_tiz\FEA)

# Units

Unit system: | SI (MKS)
Length/Displacement | mm
Temperature | Kelvin
Angular velocity | Rad/sec
Pressure/Stress | N/m^2

# Material Properties

| | | | Model Reference | Properties | Components


| | | | | Name: STYCAST 2850FT/Catalyst 23LV Model type: Linear Elastic Isotropic Default failure criterion: Mohr-Coulomb Stress Tensile strength: 1.0549e+08 N/m^2 Compressive strength: 1.19969e+08 N/m^2 Elastic modulus: 9e+10 N/m^2 Poisson's ratio: 0.3 Mass density: 2,700 kg/m^3 | SolidBody 1(Boss-Extrude1)(4.5adhesive_test-1)

Curve Data:N/A


| | | | | Name: Macor (1) Model type: Linear Elastic Isotropic Default failure criterion: Unknown Yield strength: 3.29e+07 N/m^2 Tensile strength: 9.4e+07 N/m^2 Compressive strength: 3.45e+08 N/m^2 Elastic modulus: 6.69e+10 N/m^2 Poisson's ratio: 0.29 Mass density: 2,520 kg/m^3 Shear modulus: 2.55e+10 N/m^2 Thermal expansion coefficient: 8e-06 /Kelvin | SolidBody 1(Split Line1)(4.5bplate_test-1)

Curve Data:N/A


| | | | | Name: Kapton Model type: Linear Elastic Isotropic Default failure criterion: Mohr-Coulomb Stress Yield strength: 6.9e+07 N/m^2 Tensile strength: 2.31e+08 N/m^2 Compressive strength: 2.31e+08 N/m^2 Elastic modulus: 2.76e+09 N/m^2 Poisson's ratio: 0.34 Mass density: 1,420 kg/m^3 Thermal expansion coefficient: 20 /Kelvin | SolidBody 1(Fillet2)(4.5pcb_mockup_test-1)

Curve Data:N/A


| | | | | Name: Zirconia Model type: Linear Elastic Isotropic Default failure criterion: Unknown Yield strength: 1.15e+08 N/m^2 Tensile strength: 1.4e+09 N/m^2 Compressive strength: 2.1e+09 N/m^2 Elastic modulus: 2e+11 N/m^2 Poisson's ratio: 0.3 Mass density: 6,070 kg/m^3 Thermal expansion coefficient: 1e-06 /Kelvin | SolidBody 1(Split Line1)(4.5tplate_test-1)

Curve Data:N/A

# Loads and Fixtures

Fixture name | Fixture Image | Fixture Details


Fixed-1 | | Entities: 2 face(s) Type: Fixed Geometry

Resultant Forces

Components | X | Y | Z | Resultant
Reaction force(N) | 4.88758e-06 | 486 | -0.000180483 | 486
Reaction Moment(N.m) | 0 | 0 | 0 | 0

Load name | Load Image | Load Details


Force-1 | | Entities: 1 face(s) Type: Apply normal force Value: 486 N

# Connector Definitions

No Data

# Contact Information

Contact | Contact Image | Contact Properties


Contact Set-1 | | Type: Bonded contact pair Entities: 2 face(s)

Contact/Friction force

Components | X | Y | Z | Resultant
Contact Force(N) | 0 | -0.81709 | 0 | 0.81709


Contact Set-2 | | Type: Bonded contact pair Entities: 10 face(s)

Contact/Friction force

Components | X | Y | Z | Resultant
Contact Force(N) | 6.446E-06 | 0.82422 | -2.2514E-08 | 0.82422


Global Contact | | Type: Bonded Components: 1 component(s) Options: Compatible mesh


Component Contact-2 | | Type: No penetration (Surface to surface) Components: 4 Solid Body (s)

# Mesh information

Mesh type | Solid Mesh
Mesher Used: | Standard mesh
Automatic Transition: | Off
Include Mesh Auto Loops: | Off
Jacobian points | 4 Points
Element Size | 0.2 in
Tolerance | 0.01 in
Mesh Quality Plot | High
Remesh failed parts with incompatible mesh | Off

## Mesh information - Details

Total Nodes | 41049
Total Elements | 21582
Maximum Aspect Ratio | 99.606
% of elements with Aspect Ratio < 3 | 27.1
% of elements with Aspect Ratio > 10 | 33.7
% of distorted elements(Jacobian) | 0
Time to complete mesh(hh;mm;ss): | 00:00:08
Computer name:


# Sensor Details

Sensor name | Location | Sensor Details


Stress1 | | Value : 9.570e+06 N/m^2 Entities :1 face(s) Result :Stress Component :VON: von Mises Stress Criterion :Max over Selected Entities Step Criterion : Across all Steps Step No.:1 Alert Value: NA

# Resultant Forces

## Reaction forces

Selection set | Units | Sum X | Sum Y | Sum Z | Resultant
Entire Model | N | 4.88758e-06 | 486 | -0.000180483 | 486

## Reaction Moments

Selection set | Units | Sum X | Sum Y | Sum Z | Resultant
Entire Model | N.m | 0 | 0 | 0 | 0

# Beams

No Data

# Study Results

Name | Type | Min | Max
Displacement1 | URES: Resultant Displacement | 0.000e+00 mm Node: 7040 | 2.032e-02 mm Node: 36081

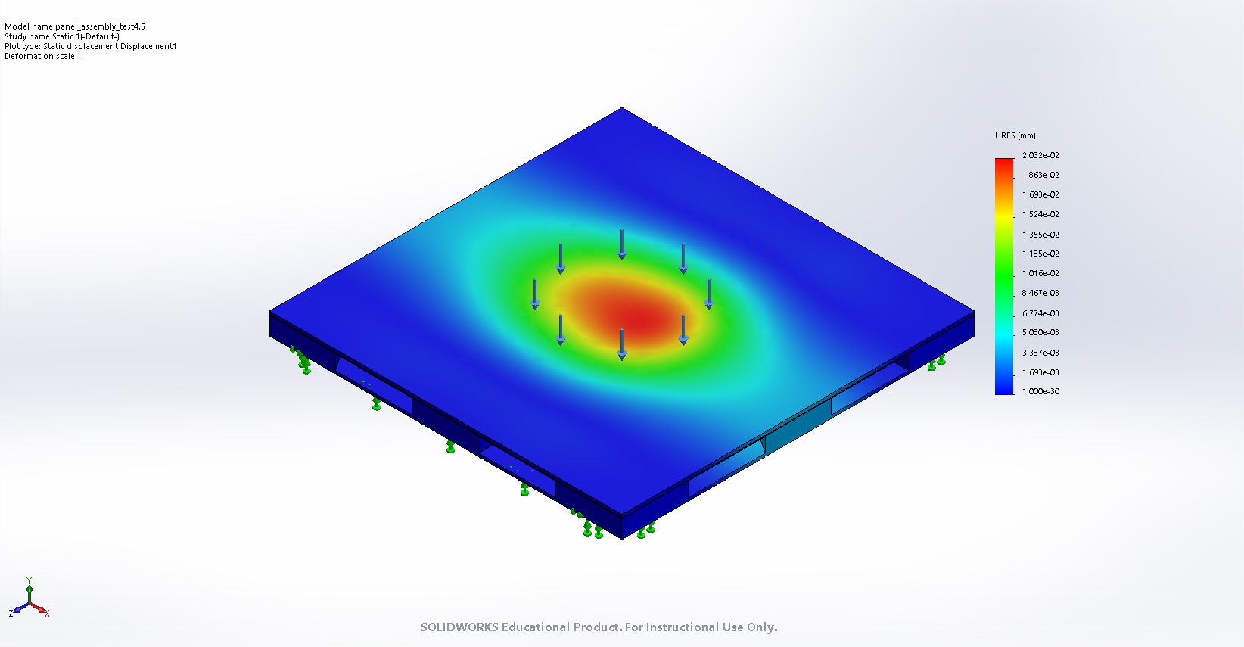
[picture p511: figure]

panel_assembly_test4.5-Static 1-Displacement-Displacement1

Name | Type | Min | Max
Strain1 | ESTRN: Equivalent Strain | 1.284e-09 Element: 4512 | 1.649e-04 Element: 13934

panel_assembly_test4.5-Static 1-Strain-Strain1

Name | Type | Min | Max
Factor of Safety1 | Mohr-Coulomb Stress | 3.430e+00 Node: 12323 | 1.500e+06 Node: 14818

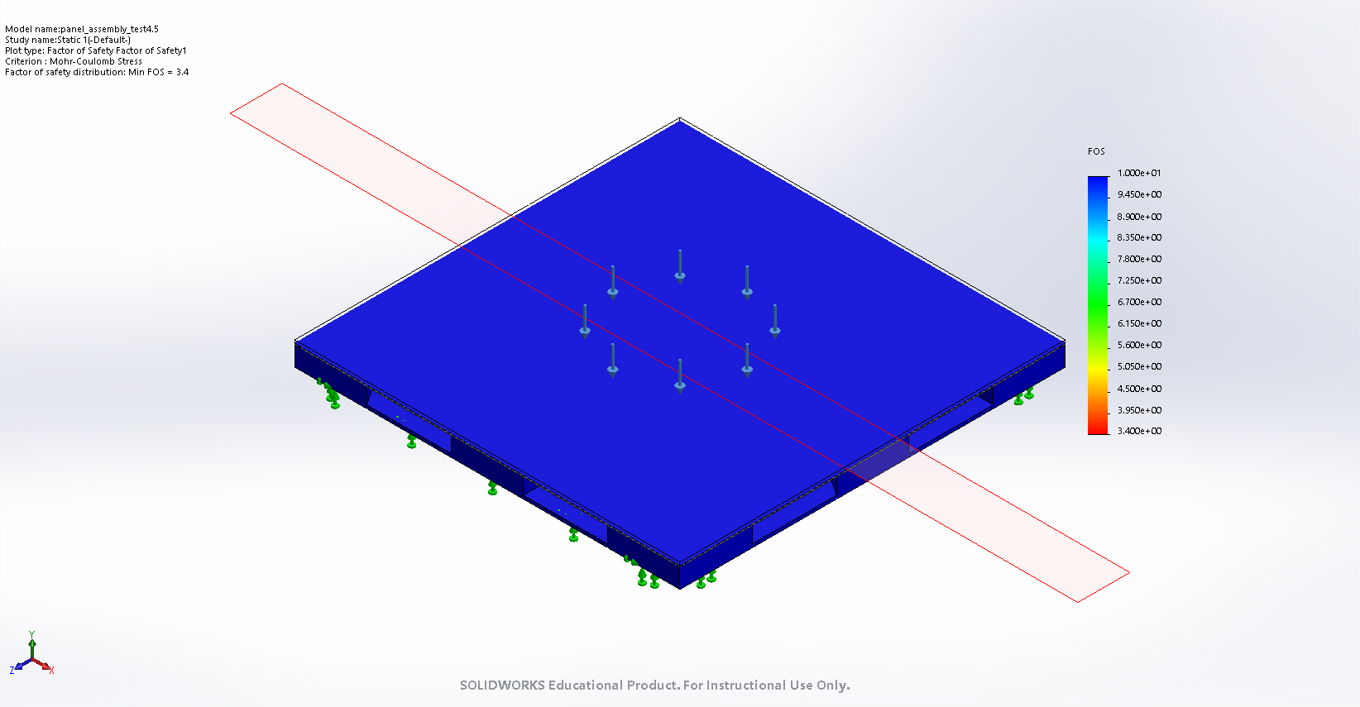
[picture p512: figure]

panel_assembly_test4.5-Static 1-Factor of Safety-Factor of Safety1

# Conclusion

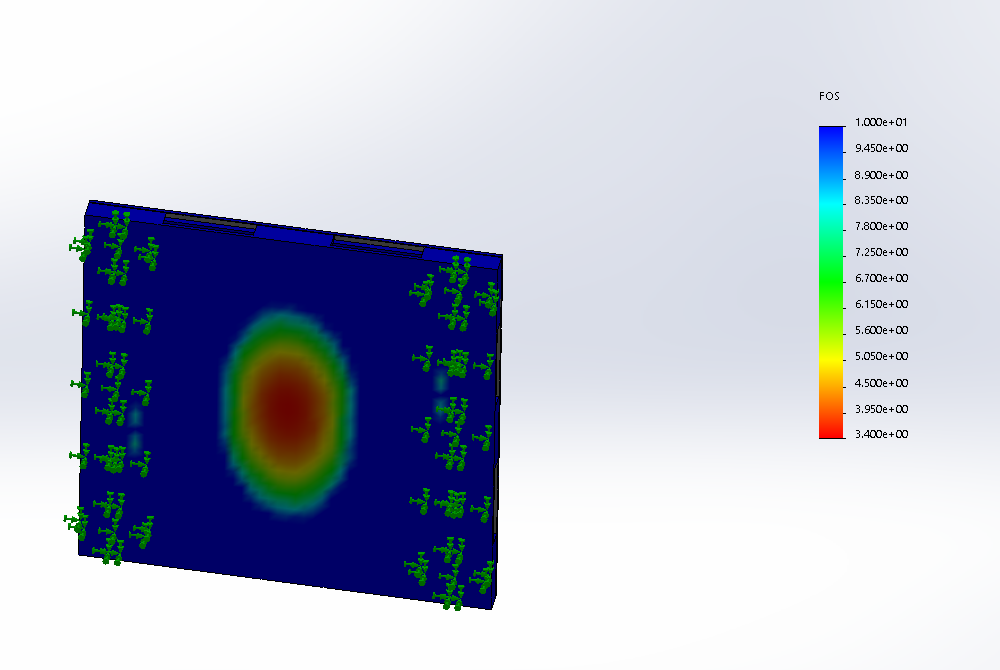
[picture p513: figure]

Analyzed with SOLIDWORKS Simulation Simulation of panel_assembly_test4.5 7

Analyzed with SOLIDWORKS Simulation Simulation of panel_assembly_test4.5 1
