caltechcaos/Lunar-Dust-Challenge/Current/Mechanical/v3_tiz/FEA/panel_assembly_test5.5-ALUMINA.docx

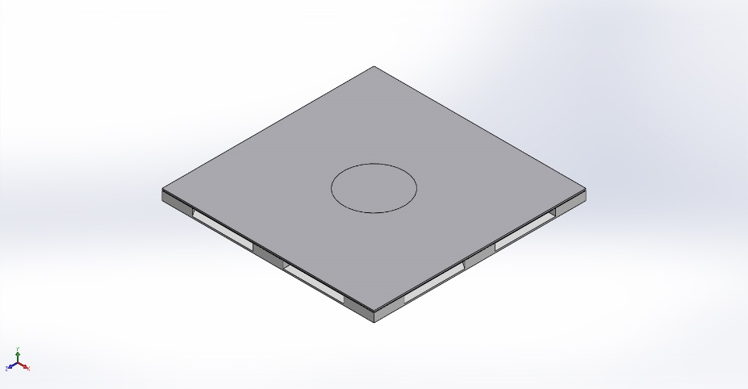
[picture p514: figure]

Simulation of panel_assembly_test5.5

Date: Sunday, April 18, 2021
Designer: Solidworks

Study name: Static 1

Analysis type: Static
Description No Data

# Assumptions

# Model Information

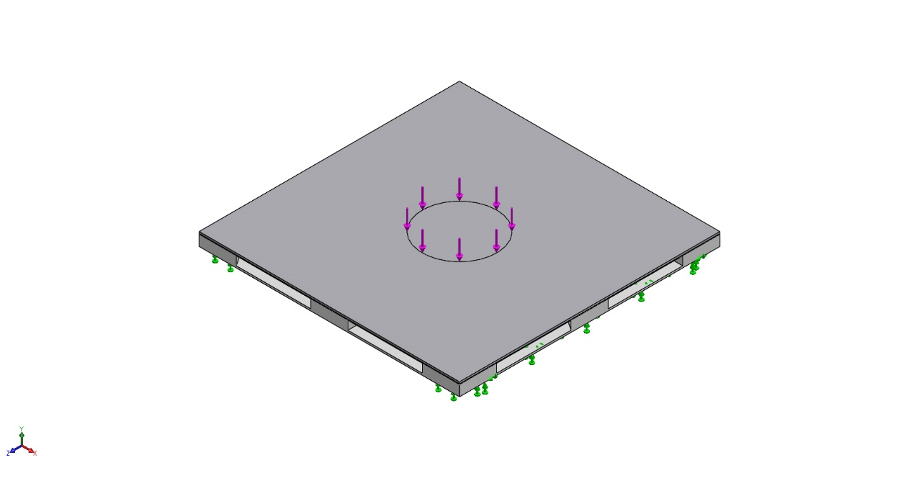
[picture p515: figure]

Model name: panel_assembly_test5.5

Current Configuration: Default

Solid Bodies
Document Name and Reference | Treated As | Volumetric Properties | Document Path/Date Modified

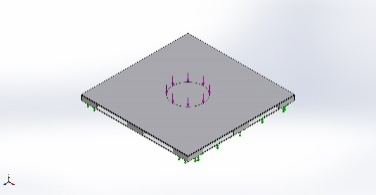
[picture p516: figure]

Boss-Extrude1 | Solid Body | Mass:0.01323 kg Volume:4.9e-06 m^3 Density:2,700 kg/m^3 Weight:0.129654 N | C:\Users\luisa\Documents\GrabCAD\Lunar Dust Challenge\Current\Mechanical\v3_tiz\FEA\5.5 INCHES\5.5adhesive_test.SLDPRT Apr 18 00:55:44 2021

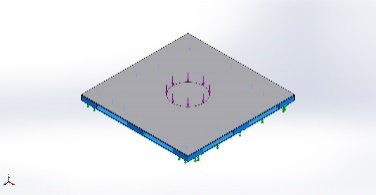
[picture p517: figure]

Split Line1 | Solid Body | Mass:0.210446 kg Volume:8.35103e-05 m^3 Density:2,520 kg/m^3 Weight:2.06237 N | C:\Users\luisa\Documents\GrabCAD\Lunar Dust Challenge\Current\Mechanical\v3_tiz\FEA\5.5 INCHES\5.5bplate_test.SLDPRT Apr 18 00:58:47 2021

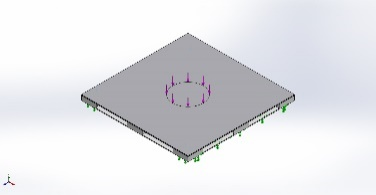
[picture p518: figure]

Fillet2 | Solid Body | Mass:0.0192342 kg Volume:1.35452e-05 m^3 Density:1,420 kg/m^3 Weight:0.188495 N | C:\Users\luisa\Documents\GrabCAD\Lunar Dust Challenge\Current\Mechanical\v3_tiz\FEA\5.5 INCHES\5.5pcb_mockup_test.SLDPRT Apr 18 00:55:44 2021

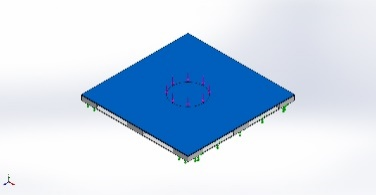
[picture p519: figure]

Split Line1 | Solid Body | Mass:0.0406895 kg Volume:1.96e-05 m^3 Density:2,075.99 kg/m^3 Weight:0.398757 N | C:\Users\luisa\Documents\GrabCAD\Lunar Dust Challenge\Current\Mechanical\v3_tiz\FEA\5.5 INCHES\5.5tplate_test.SLDPRT Apr 18 01:00:03 2021

# Study Properties

Study name | Static 1
Analysis type | Static
Mesh type | Solid Mesh
Thermal Effect: | On
Thermal option | Include temperature loads
Zero strain temperature | 298 Kelvin
Include fluid pressure effects from SOLIDWORKS Flow Simulation | Off
Solver type | FFEPlus
Inplane Effect: | Off
Soft Spring: | Off
Inertial Relief: | Off
Incompatible bonding options | Automatic
Large displacement | Off
Compute free body forces | On
Friction | Off
Use Adaptive Method: | Off
Result folder | SOLIDWORKS document (C:\Users\luisa\Documents\GrabCAD\Lunar Dust Challenge\Current\Mechanical\v3_tiz\FEA)

# Units

Unit system: | SI (MKS)
Length/Displacement | mm
Temperature | Kelvin
Angular velocity | Rad/sec
Pressure/Stress | N/m^2

# Material Properties

| | | | Model Reference | Properties | Components

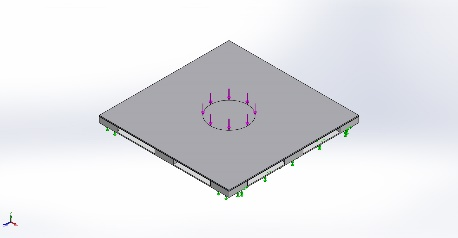
[picture p520: figure]

| | | | | Name: STYCAST 2850FT/Catalyst 23LV Model type: Linear Elastic Isotropic Default failure criterion: Mohr-Coulomb Stress Tensile strength: 1.0549e+08 N/m^2 Compressive strength: 1.19969e+08 N/m^2 Elastic modulus: 9e+10 N/m^2 Poisson's ratio: 0.3 Mass density: 2,700 kg/m^3 | SolidBody 1(Boss-Extrude1)(5.5adhesive_test-1)

Curve Data:N/A

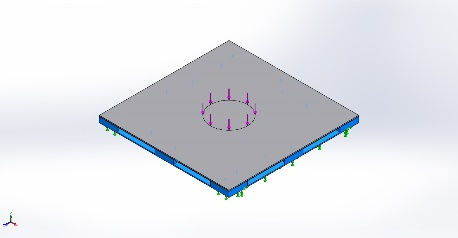
[picture p521: figure]

| | | | | Name: Macor (1) Model type: Linear Elastic Isotropic Default failure criterion: Unknown Yield strength: 3.29e+07 N/m^2 Tensile strength: 9.4e+07 N/m^2 Compressive strength: 3.45e+08 N/m^2 Elastic modulus: 6.69e+10 N/m^2 Poisson's ratio: 0.29 Mass density: 2,520 kg/m^3 Shear modulus: 2.55e+10 N/m^2 Thermal expansion coefficient: 8e-06 /Kelvin | SolidBody 1(Split Line1)(5.5bplate_test-1)

Curve Data:N/A

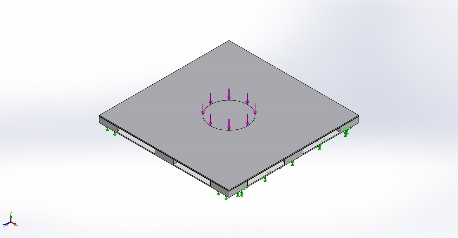
[picture p522: figure]

| | | | | Name: Kapton Model type: Linear Elastic Isotropic Default failure criterion: Mohr-Coulomb Stress Yield strength: 6.9e+07 N/m^2 Tensile strength: 2.31e+08 N/m^2 Compressive strength: 2.31e+08 N/m^2 Elastic modulus: 2.76e+09 N/m^2 Poisson's ratio: 0.34 Mass density: 1,420 kg/m^3 Thermal expansion coefficient: 20 /Kelvin | SolidBody 1(Fillet2)(5.5pcb_mockup_test-1)

Curve Data:N/A

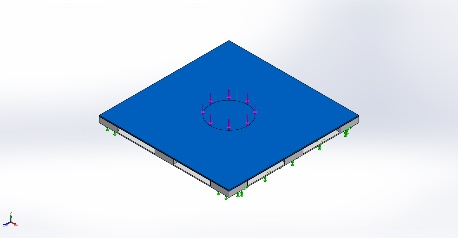
[picture p523: figure]

| | | | | Name: 99.5% Aluminum Oxide Model type: Linear Elastic Isotropic Default failure criterion: Mohr-Coulomb Stress Yield strength: 2.17185e+07 N/m^2 Tensile strength: 2.17185e+07 N/m^2 Compressive strength: 2.99922e+07 N/m^2 Elastic modulus: 3e+11 N/m^2 Poisson's ratio: 0.22 Mass density: 2,075.99 kg/m^3 Thermal expansion coefficient: 8e-06 /Kelvin | SolidBody 1(Split Line1)(5.5tplate_test-1)

Curve Data:N/A

# Loads and Fixtures

Fixture name | Fixture Image | Fixture Details

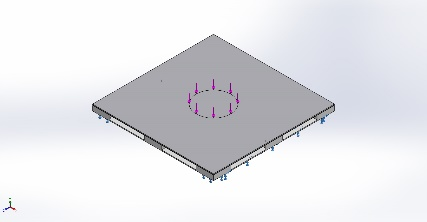
[picture p524: figure]

Fixed-1 | | Entities: 2 face(s) Type: Fixed Geometry

Resultant Forces

Components | X | Y | Z | Resultant
Reaction force(N) | 3.33786e-05 | 486 | -1.5974e-05 | 486
Reaction Moment(N.m) | 0 | 0 | 0 | 0

Load name | Load Image | Load Details

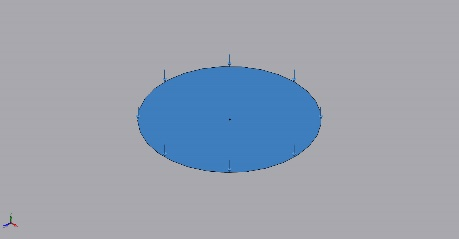
[picture p525: figure]

Force-1 | | Entities: 1 face(s) Type: Apply normal force Value: 486 N

# Connector Definitions

No Data

# Contact Information

Contact | Contact Image | Contact Properties

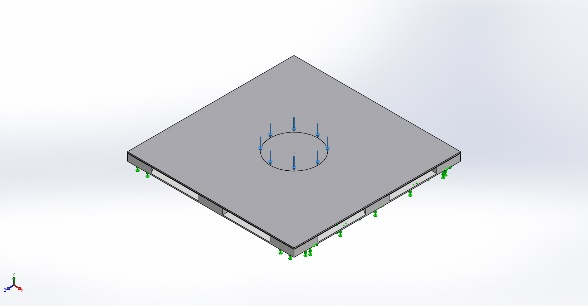
[picture p526: figure]

Contact Set-1 | | Type: Bonded contact pair Entities: 2 face(s)

Contact/Friction force

Components | X | Y | Z | Resultant
Contact Force(N) | -8.3955E-05 | -112.1 | 3.4603E-06 | 112.1

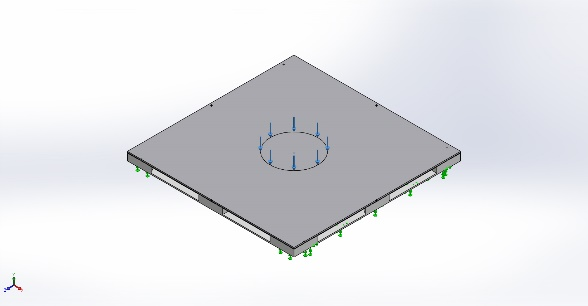
[picture p527: figure]

Contact Set-2 | | Type: Bonded contact pair Entities: 10 face(s)

Contact/Friction force

Components | X | Y | Z | Resultant
Contact Force(N) | 0.0024385 | 114.9 | 0.0012748 | 114.9

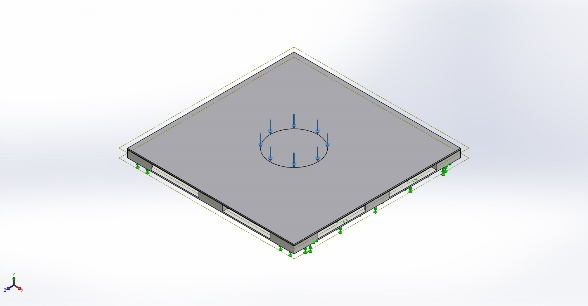
[picture p528: figure]

Global Contact | | Type: Bonded Components: 1 component(s) Options: Compatible mesh

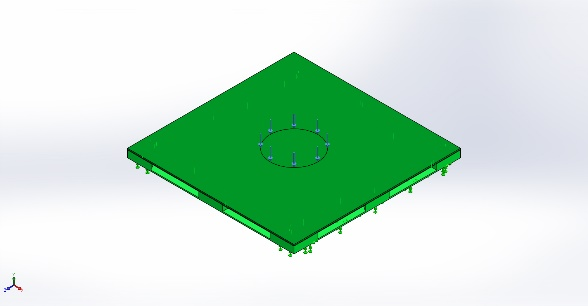
[picture p529: figure]

Component Contact-2 | | Type: No penetration (Surface to surface) Components: 4 Solid Body (s)

# Mesh information

Mesh type | Solid Mesh
Mesher Used: | Standard mesh
Automatic Transition: | Off
Include Mesh Auto Loops: | Off
Jacobian points | 4 Points
Element Size | 0.37302 in
Tolerance | 0.018651 in
Mesh Quality Plot | High
Remesh failed parts with incompatible mesh | Off

## Mesh information - Details

Total Nodes | 23527
Total Elements | 12087
Maximum Aspect Ratio | 1,380.5
% of elements with Aspect Ratio < 3 | 20.2
% of elements with Aspect Ratio > 10 | 44.4
% of distorted elements(Jacobian) | 0
Time to complete mesh(hh;mm;ss): | 00:00:04
Computer name:

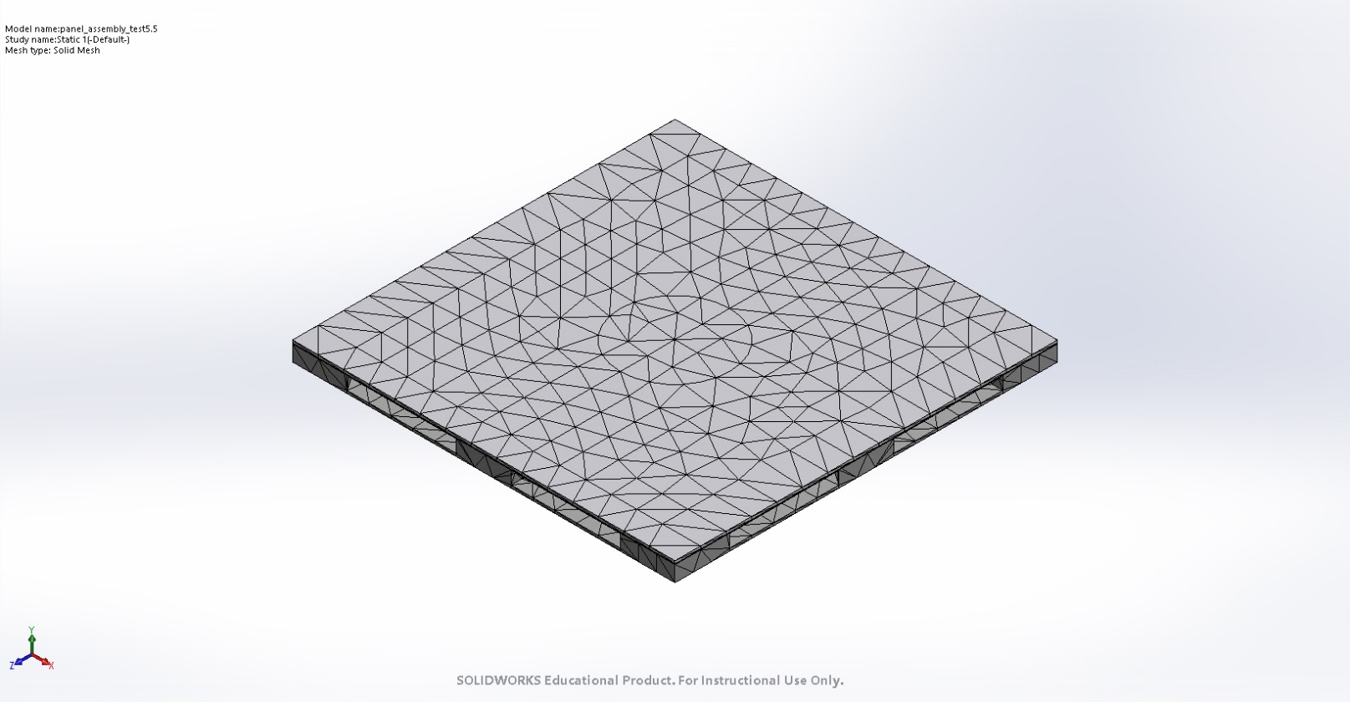
[picture p530: figure]

# Sensor Details

Sensor name | Location | Sensor Details

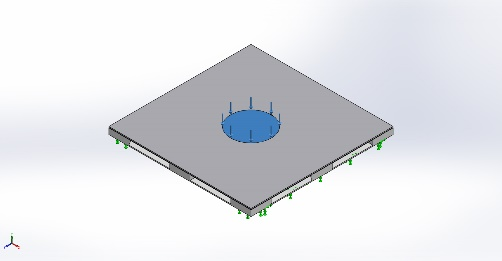
[picture p531: figure]

Stress1 | | Value : 1.553e+07 N/m^2 Entities :1 face(s) Result :Stress Component :VON: von Mises Stress Criterion :Max over Selected Entities Step Criterion : Across all Steps Step No.:1 Alert Value: NA

# Resultant Forces

## Reaction forces

Selection set | Units | Sum X | Sum Y | Sum Z | Resultant
Entire Model | N | 3.33786e-05 | 486 | -1.5974e-05 | 486

## Reaction Moments

Selection set | Units | Sum X | Sum Y | Sum Z | Resultant
Entire Model | N.m | 0 | 0 | 0 | 0

# Beams

No Data

# Study Results

Name | Type | Min | Max
Displacement1 | URES: Resultant Displacement | 0.000e+00 mm Node: 3945 | 3.783e-02 mm Node: 21701

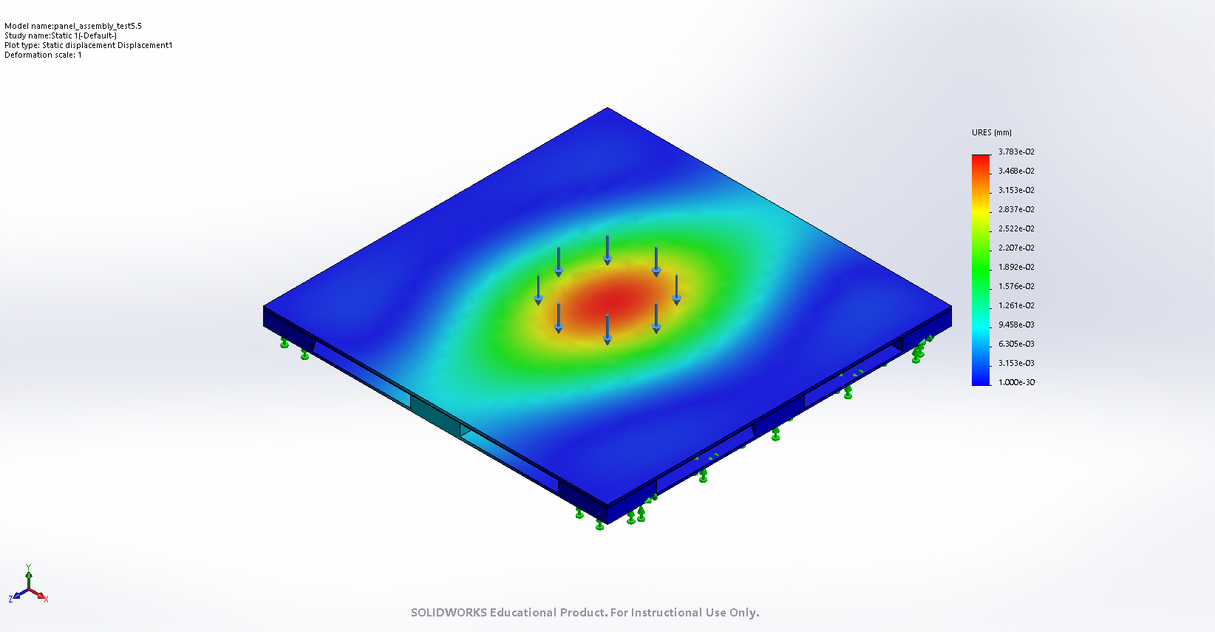
[picture p532: figure]

panel_assembly_test5.5-Static 1-Displacement-Displacement1

Name | Type | Min | Max
Strain1 | ESTRN: Equivalent Strain | 2.240e-08 Element: 5631 | 1.607e-04 Element: 7203

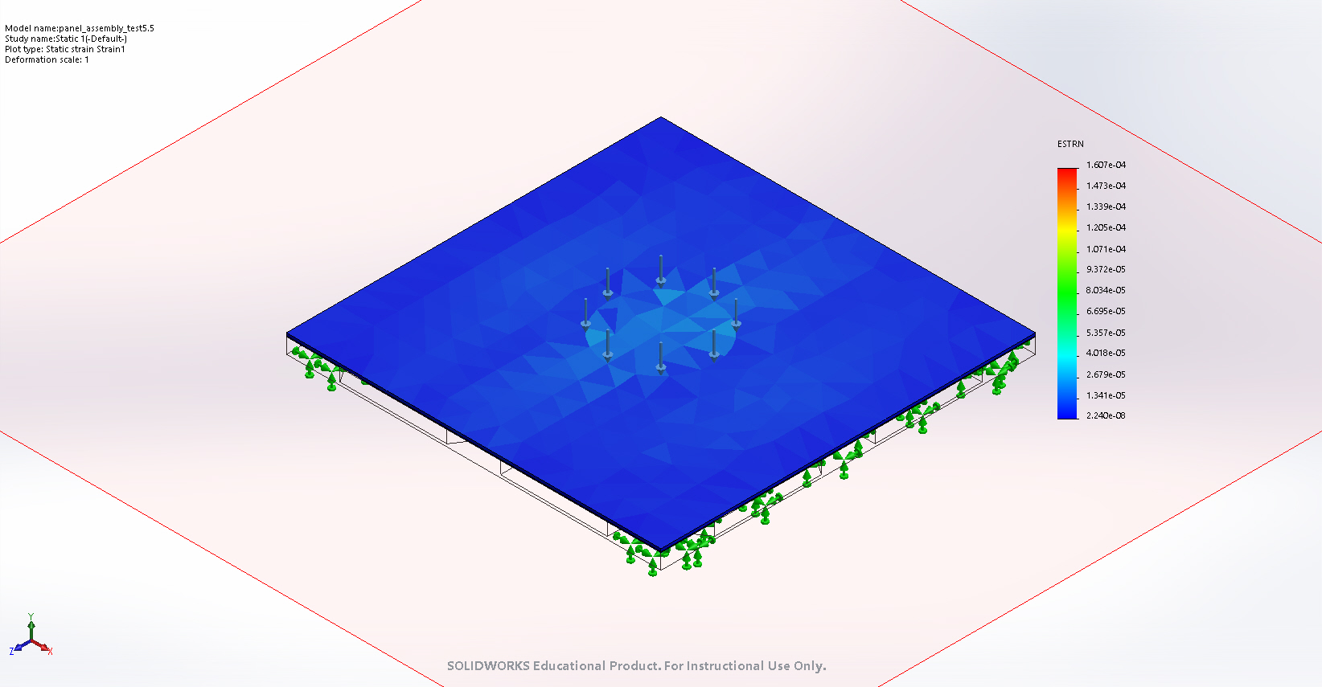
[picture p533: figure]

panel_assembly_test5.5-Static 1-Strain-Strain1

Name | Type | Min | Max
Factor of Safety1 | Mohr-Coulomb Stress | 1.519e+00 Node: 23044 | 6.684e+04 Node: 9384

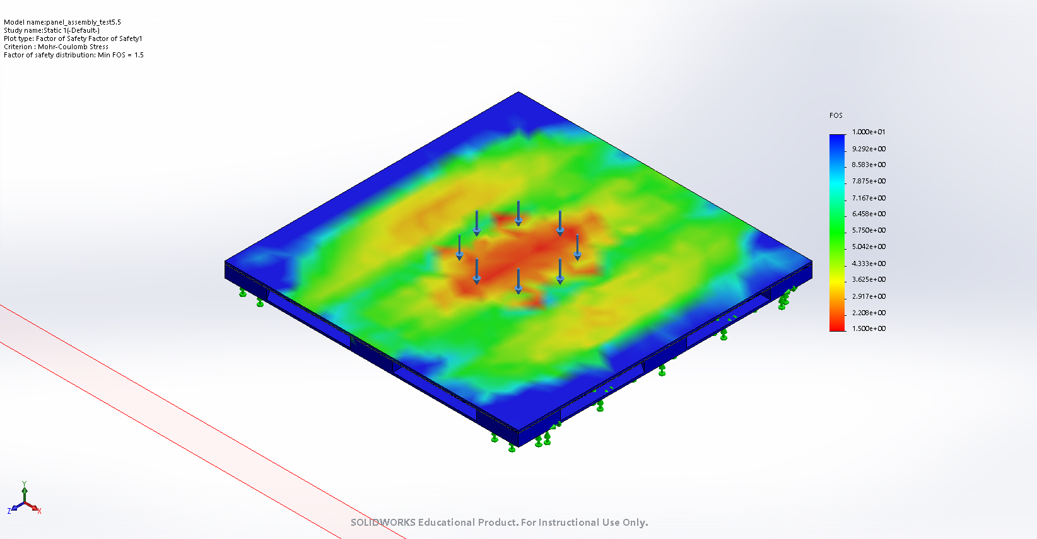
[picture p534: figure]

panel_assembly_test5.5-Static 1-Factor of Safety-Factor of Safety1

# Conclusion

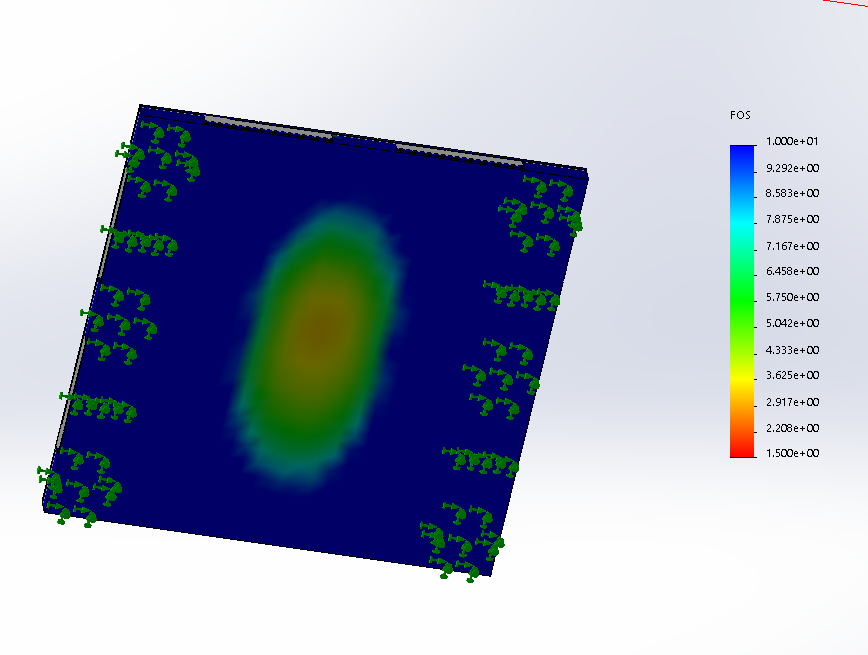
[picture p535: figure]

Analyzed with SOLIDWORKS Simulation Simulation of panel_assembly_test5.5 7

Analyzed with SOLIDWORKS Simulation Simulation of panel_assembly_test5.5 1
