caltechcaos/Lunar-Dust-Challenge/EASE/Example_Configurations/Combinations/How_to_Use_Document.txt

All these panel combinations are unidirectional, so if you need to change direction you have to use multiple combinations.

1x1 panels and port covers are found in the EASE folder.
