caltechcaos/Lunar-Dust-Challenge/EASE/Worksheet in Panel_Wiring_Assy.xlsx

Design Table for: Panel_Wiring_Assy
 | Panel_Width@Top Panel Profile | Tab_Length@Top Panel Profile | Tab_Width@Top Panel Profile | Tab_Edge_Offset@Top Panel Profile
Default | 250 | 10 | 55 | 30
