caltechcaos/Lunar-Dust-Challenge/Current/Mechanical/v3_tiz/FEA/LUIS_TEST_FEA.docx

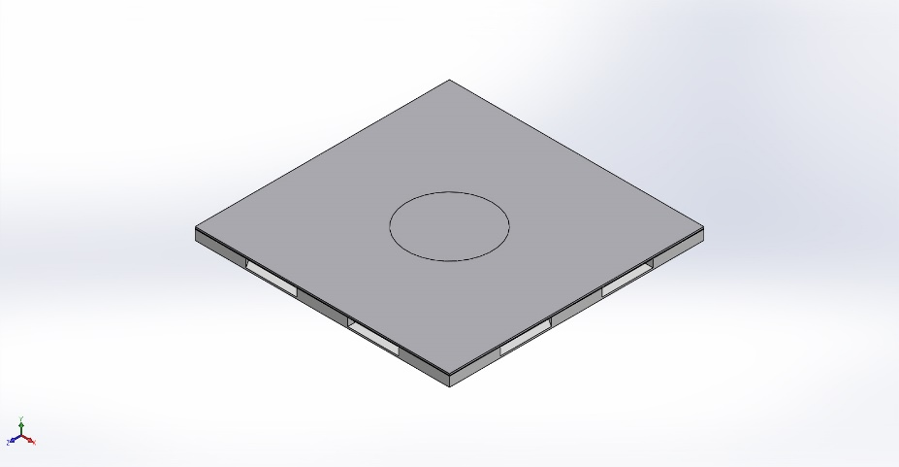
[picture p568: figure]

Simulation of panel_assembly_test

Date: Thursday, April 15, 2021
Designer: Solidworks

Study name: Static 1

Analysis type: Static
Description No Data

# Assumptions

# Model Information

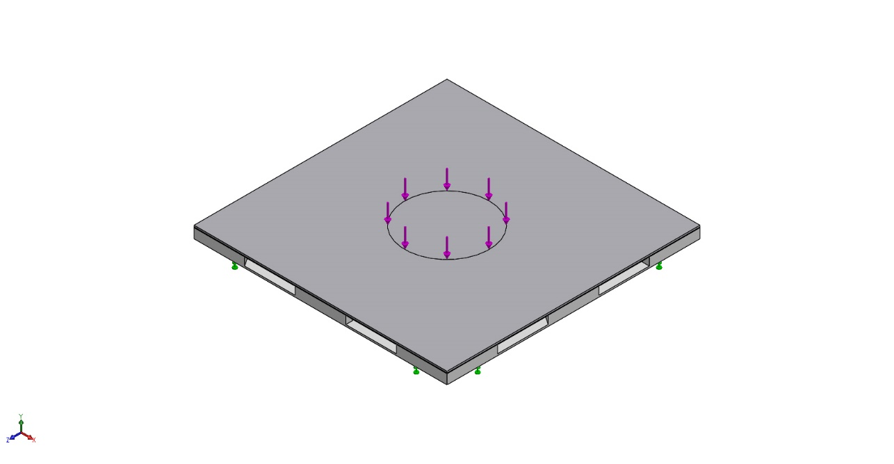
[picture p569: figure]

Model name: panel_assembly_test

Current Configuration: Default

Solid Bodies
Document Name and Reference | Treated As | Volumetric Properties | Document Path/Date Modified

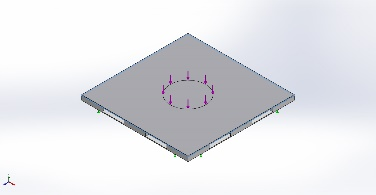
[picture p570: figure]

Boss-Extrude1 | Solid Body | Mass:0.0151875 kg Volume:5.625e-06 m^3 Density:2,700 kg/m^3 Weight:0.148838 N | C:\Users\luisa\Documents\GrabCAD\Lunar Dust Challenge\Current\Mechanical\v3_tiz\FEA\adhesive_test.SLDPRT Apr 15 20:58:13 2021

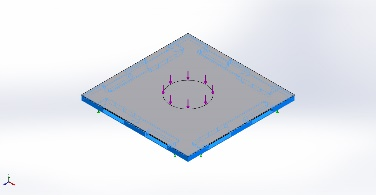
[picture p571: figure]

CirPattern1 | Solid Body | Mass:0.260511 kg Volume:0.000103377 m^3 Density:2,520 kg/m^3 Weight:2.55301 N | C:\Users\luisa\Documents\GrabCAD\Lunar Dust Challenge\Current\Mechanical\v3_tiz\FEA\bplate_test.SLDPRT Apr 15 20:58:13 2021

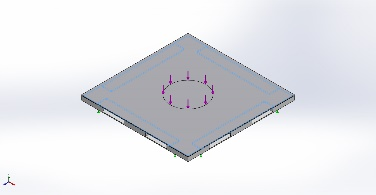
[picture p572: figure]

Fillet2 | Solid Body | Mass:0.0194472 kg Volume:1.36952e-05 m^3 Density:1,420 kg/m^3 Weight:0.190582 N | C:\Users\luisa\Documents\GrabCAD\Lunar Dust Challenge\Current\Mechanical\v3_tiz\FEA\pcb_mockup_test.SLDPRT Apr 15 20:58:13 2021

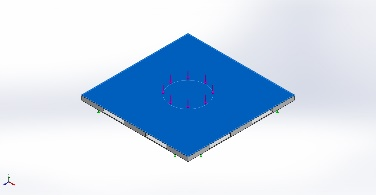
[picture p573: figure]

Split Line1 | Solid Body | Mass:0.136575 kg Volume:2.25e-05 m^3 Density:6,070 kg/m^3 Weight:1.33843 N | C:\Users\luisa\Documents\GrabCAD\Lunar Dust Challenge\Current\Mechanical\v3_tiz\FEA\tplate_test.SLDPRT Apr 15 20:58:13 2021

# Study Properties

Study name | Static 1
Analysis type | Static
Mesh type | Solid Mesh
Thermal Effect: | On
Thermal option | Include temperature loads
Zero strain temperature | 298 Kelvin
Include fluid pressure effects from SOLIDWORKS Flow Simulation | Off
Solver type | FFEPlus
Inplane Effect: | Off
Soft Spring: | Off
Inertial Relief: | Off
Incompatible bonding options | Automatic
Large displacement | Off
Compute free body forces | On
Friction | Off
Use Adaptive Method: | Off
Result folder | SOLIDWORKS document (C:\Users\luisa\Documents\GrabCAD\Lunar Dust Challenge\Current\Mechanical\v3_tiz\FEA)

# Units

Unit system: | SI (MKS)
Length/Displacement | mm
Temperature | Kelvin
Angular velocity | Rad/sec
Pressure/Stress | N/m^2

# Material Properties

| | | | Model Reference | Properties | Components

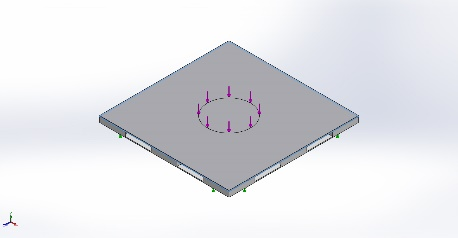
[picture p574: figure]

| | | | | Name: STYCAST 2850FT/Catalyst 23LV Model type: Linear Elastic Isotropic Default failure criterion: Mohr-Coulomb Stress Tensile strength: 1.0549e+08 N/m^2 Compressive strength: 1.19969e+08 N/m^2 Elastic modulus: 9e+10 N/m^2 Poisson's ratio: 0.3 Mass density: 2,700 kg/m^3 | SolidBody 1(Boss-Extrude1)(adhesive_test-1)

Curve Data:N/A

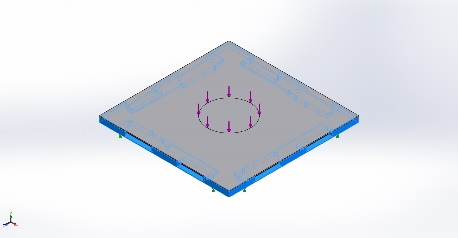
[picture p575: figure]

| | | | | Name: Macor (1) Model type: Linear Elastic Isotropic Default failure criterion: Unknown Yield strength: 3.29e+07 N/m^2 Tensile strength: 9.4e+07 N/m^2 Compressive strength: 3.45e+08 N/m^2 Elastic modulus: 6.69e+10 N/m^2 Poisson's ratio: 0.29 Mass density: 2,520 kg/m^3 Shear modulus: 2.55e+10 N/m^2 Thermal expansion coefficient: 8e-06 /Kelvin | SolidBody 1(CirPattern1)(bplate_test-1)

Curve Data:N/A

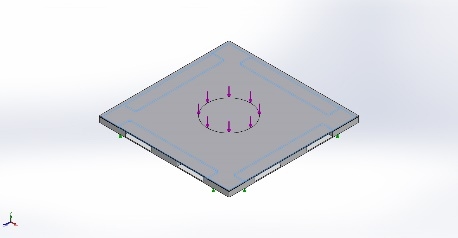
[picture p576: figure]

| | | | | Name: Kapton Model type: Linear Elastic Isotropic Default failure criterion: Mohr-Coulomb Stress Yield strength: 6.9e+07 N/m^2 Tensile strength: 2.31e+08 N/m^2 Compressive strength: 2.31e+08 N/m^2 Elastic modulus: 2.76e+09 N/m^2 Poisson's ratio: 0.34 Mass density: 1,420 kg/m^3 Thermal expansion coefficient: 20 /Kelvin | SolidBody 1(Fillet2)(pcb_mockup_test-1)

Curve Data:N/A

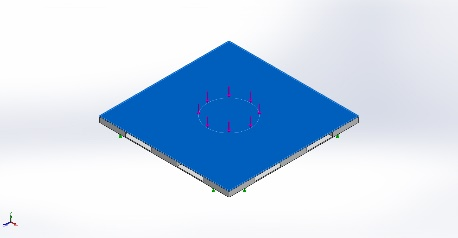
[picture p577: figure]

| | | | | Name: Zirconia Model type: Linear Elastic Isotropic Default failure criterion: Unknown Yield strength: 1.15e+08 N/m^2 Tensile strength: 1.4e+09 N/m^2 Compressive strength: 2.1e+09 N/m^2 Elastic modulus: 2e+11 N/m^2 Poisson's ratio: 0.3 Mass density: 6,070 kg/m^3 Thermal expansion coefficient: 1e-06 /Kelvin | SolidBody 1(Split Line1)(tplate_test-1)

Curve Data:N/A

# Loads and Fixtures

Fixture name | Fixture Image | Fixture Details

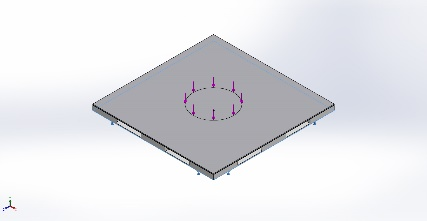
[picture p578: figure]

Fixed-1 | | Entities: 1 face(s) Type: Fixed Geometry

Resultant Forces

Components | X | Y | Z | Resultant
Reaction force(N) | -8.92021e-06 | 486 | -3.27826e-07 | 486
Reaction Moment(N.m) | 0 | 0 | 0 | 0

Load name | Load Image | Load Details

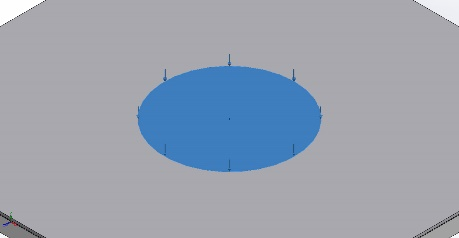
[picture p579: figure]

Force-1 | | Entities: 1 face(s) Type: Apply normal force Value: 486 N

# Connector Definitions

No Data

# Contact Information

Contact | Contact Image | Contact Properties

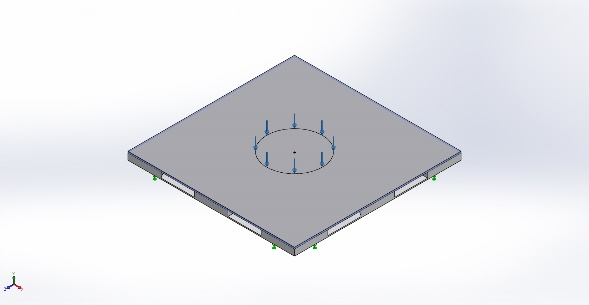
[picture p580: figure]

Contact Set-1 | | Type: Bonded contact pair Entities: 2 face(s)

Contact/Friction force

Components | X | Y | Z | Resultant
Contact Force(N) | -9.1615E-18 | -111.8 | 1.6805E-18 | 111.8

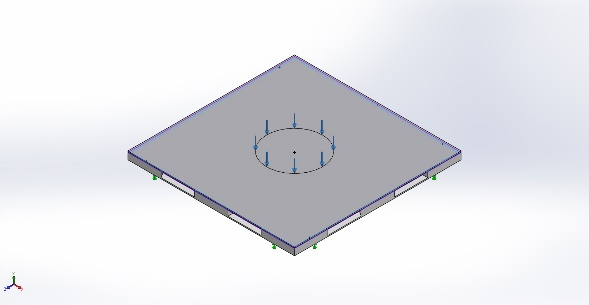
[picture p581: figure]

Contact Set-2 | | Type: Bonded contact pair Entities: 10 face(s)

Contact/Friction force

Components | X | Y | Z | Resultant
Contact Force(N) | -6.8894E-05 | 110.17 | 0.001173 | 110.17

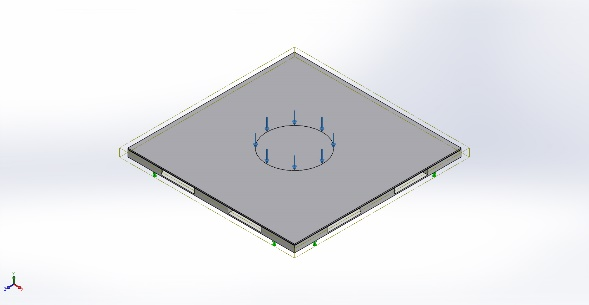
[picture p582: figure]

Global Contact | | Type: Bonded Components: 1 component(s) Options: Compatible mesh

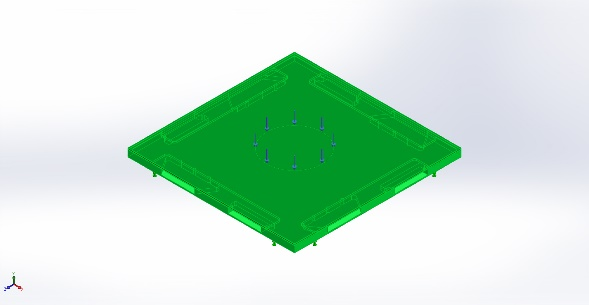
[picture p583: figure]

Component Contact-2 | | Type: No penetration (Surface to surface) Components: 4 Solid Body (s)

# Mesh information

Mesh type | Solid Mesh
Mesher Used: | Standard mesh
Automatic Transition: | Off
Include Mesh Auto Loops: | Off
Jacobian points | 4 Points
Element Size | 0.37302 in
Tolerance | 0.018651 in
Mesh Quality Plot | High
Remesh failed parts with incompatible mesh | Off

## Mesh information - Details

Total Nodes | 26673
Total Elements | 13655
Maximum Aspect Ratio | 541.55
% of elements with Aspect Ratio < 3 | 18.3
% of elements with Aspect Ratio > 10 | 50.6
% of distorted elements(Jacobian) | 0
Time to complete mesh(hh;mm;ss): | 00:00:06
Computer name:

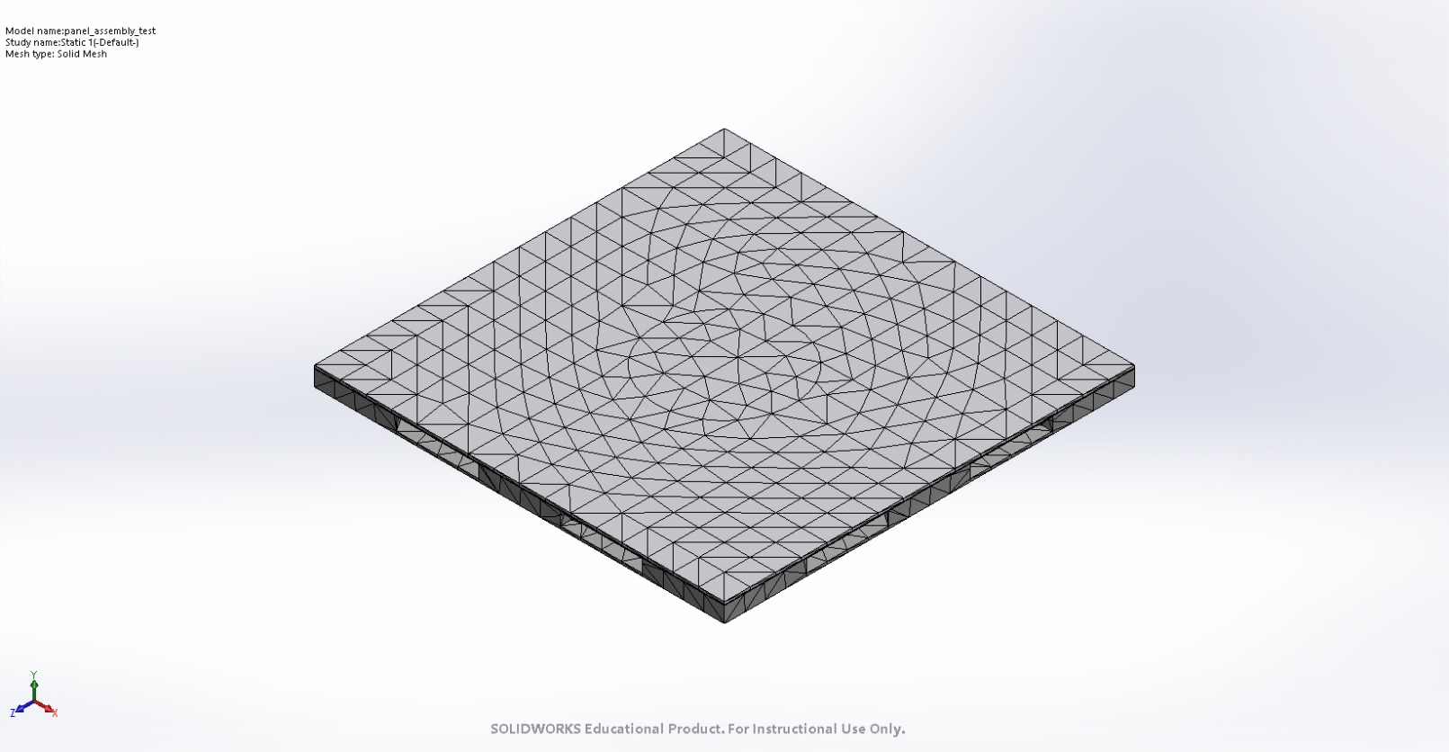
[picture p584: figure]

# Sensor Details

Sensor name | Location | Sensor Details

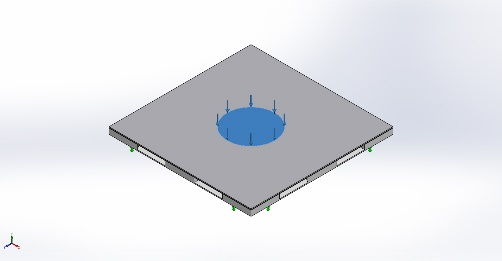
[picture p585: figure]

Stress1 | | Value : 5.025e+05 N/m^2 Entities :1 face(s) Result :Stress Component :VON: von Mises Stress Criterion :Max over Selected Entities Step Criterion : Across all Steps Step No.:1 Alert Value: NA

# Resultant Forces

## Reaction forces

Selection set | Units | Sum X | Sum Y | Sum Z | Resultant
Entire Model | N | -8.92021e-06 | 486 | -3.27826e-07 | 486

## Reaction Moments

Selection set | Units | Sum X | Sum Y | Sum Z | Resultant
Entire Model | N.m | 0 | 0 | 0 | 0

# Beams

No Data

# Study Results

Name | Type | Min | Max
Displacement1 | URES: Resultant Displacement | 0.000e+00 mm Node: 5248 | 4.280e-04 mm Node: 24660

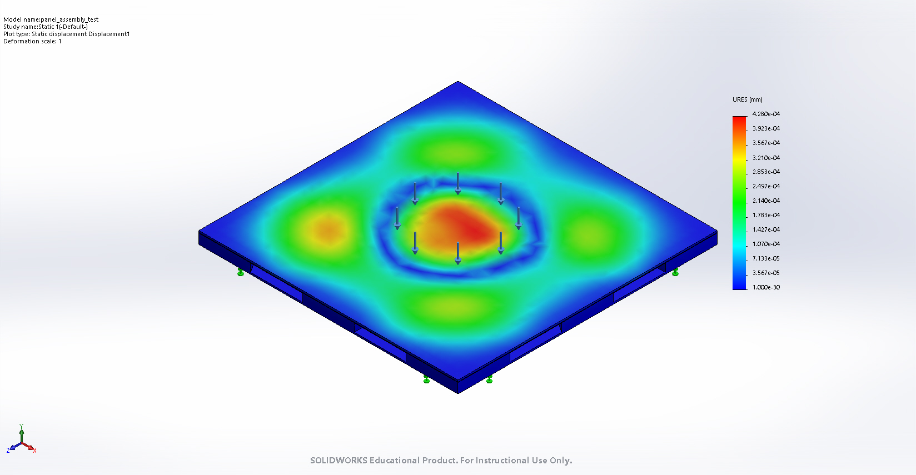
[picture p586: figure]

panel_assembly_test-Static 1-Displacement-Displacement1

Name | Type | Min | Max
Strain1 | ESTRN: Equivalent Strain | 2.527e-11 Element: 4280 | 7.595e-05 Element: 10914

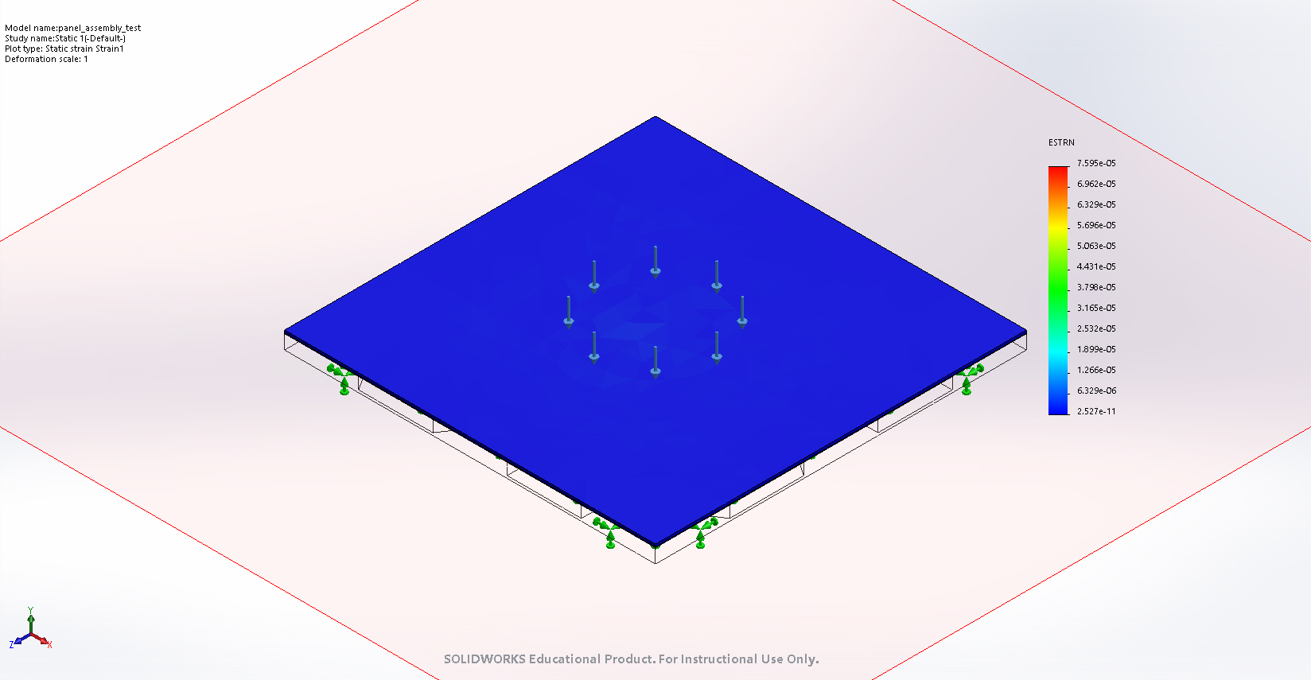
[picture p587: figure]

panel_assembly_test-Static 1-Strain-Strain1

Name | Type | Min | Max
Factor of Safety1 | Mohr-Coulomb Stress | 5.528e+01 Node: 13219 | 5.323e+07 Node: 12083

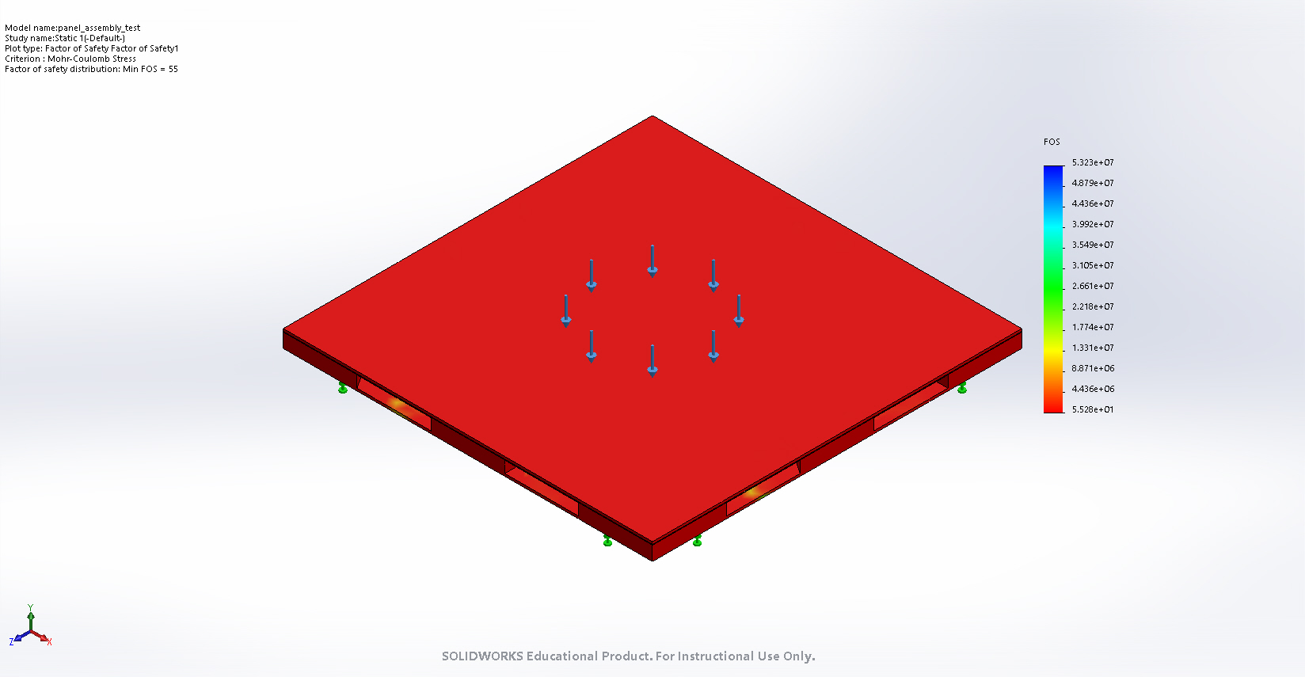
[picture p588: figure]

panel_assembly_test-Static 1-Factor of Safety-Factor of Safety1

# Conclusion

Analyzed with SOLIDWORKS Simulation Simulation of panel_assembly_test 7

Analyzed with SOLIDWORKS Simulation Simulation of panel_assembly_test 1
