caltechcaos/Lunar-Dust-Challenge/EASE/PerformanceLog.txt

Number of Contacts: 1
Number of contact data: 23546
