caltechcaos/Lunar-Dust-Challenge/Current/Mechanical/v3_tiz/FEA/PerformanceLog.txt

Number of Contacts: 2
Number of contact data: 993
