caltechcaos/Lunar-Dust-Challenge/Current/Mechanical/v4_Eggdee/5.15_3pt_Bend/PerformanceLog.txt

Number of Contacts: 21
Number of contact data: 10448
