caltechcaos/Lunar-Dust-Challenge/Current/Mechanical/v3_tiz/FEA/segmented_panel_fea/PerformanceLog.txt

Number of Contacts: 2
Number of contact data: 12152
