caltechcaos/Lunar-Dust-Challenge/Current/Mechanical/v4_Eggdee/Parts/5.18_Finger_Joint_Bend/PerformanceLog.txt

Number of Contacts: 6
Number of contact data: 352
