caltechcaos/Lunar-Dust-Challenge/Current/Mechanical/v4_Eggdee/Simplified_Parts/5.16_3pt_Bend_Simplified/PerformanceLog.txt

Number of Contacts: 2
Number of contact data: 6252
