caltechcaos/Lunar-Dust-Challenge/Current/Mechanical/v4_Eggdee/Simplified_Parts/5.16_3pt_Bend_Simplified_Borderless/PerformanceLog.txt

Number of Contacts: 4
Number of contact data: 12186
