caltechcaos/Lunar-Dust-Challenge/PDR/PDR Presentation/FINAL_VerificationSlides.pptx

VERIFICATION
TEST PROGRAM

Vibration Test for Deployment †

EMI Test for EDS System^*†

Electronic Life Test for 45 years^*

AIAA Caltech Student Branch – 11/18/20
Preliminary Design Review – EASE

Key:
^ Under vacuum conditions
* Under thermal conditions
! Destructive test
† Full prototype needed

Goal: Validate to TRL4
- Implement safety factor of 1.2 – 1.5

Abrasion Test*!

Miscellaneous

Maximum Load Test*!

Simulated Abrasion Test*

600 N Pulsating Fatigue Test*!

Operational Test^*†

Mechanical Load Tests

Dust Exposure Test

Sharp Impact Test Simulating Micrometeorites*!

## Slide 2

VERIFICATION
TEST PROGRAM

Equipment and Testing Conditions


Three-Body Abrasive Wear Test Rig

AIAA Caltech Student Branch – 11/18/20
Preliminary Design Review – EASE

- We will use NTS for thermal vacuum chamber testing
- Lunar Simulant JSC-1A will be used for EDS-related testing
- Lunar Simulants OB-1 and Chenobi are the most recommended simulants for abrasion and dust exposure testing
- We will test from -260˚C to 140˚C to simulate lunar thermal conditions

(Roy, 2008)
