caltechcaos/Lunar-Dust-Challenge/Current/Validation/COMSOL/Images/Field strength 1.pdf

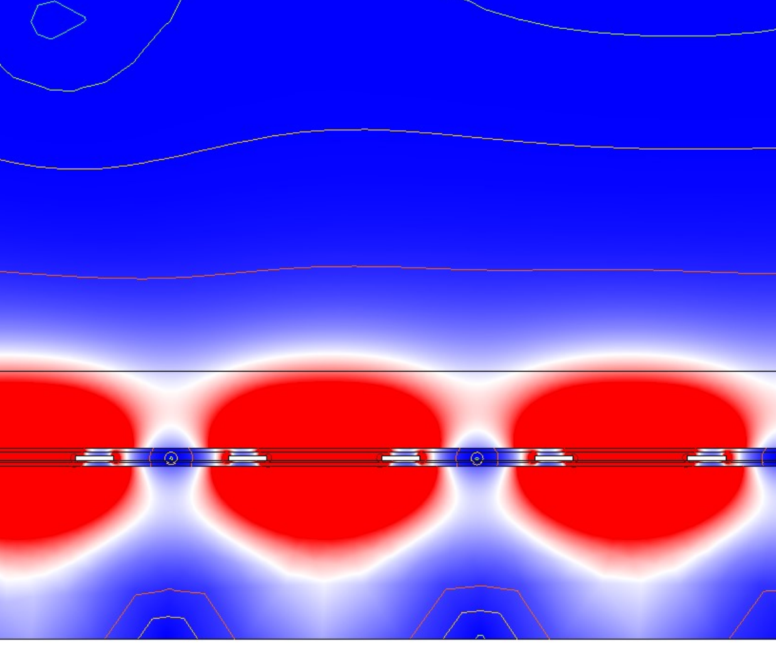
[picture p612: page 1]
