caltechcaos/Lunar-Dust-Challenge/Current/Mechanical/Finger Thickness Analysis/Version 2/testResults.csv

Design Study 1
Scenarios/Iterations: | 144
Parameter Constraint or Goal | Format | Unit | Initial Value | Optimal Value | Scenario 1 | Scenario 2 | Scenario 3 | Scenario 4 | Scenario 5 | Scenario 6 | Scenario 7 | Scenario 8 | Scenario 9 | Scenario 10 | Scenario 11 | Scenario 12 | Scenario 13 | Scenario 14 | Scenario 15 | Scenario 16 | Scenario 17 | Scenario 18 | Scenario 19 | Scenario 20 | Scenario 21 | Scenario 22 | Scenario 23 | Scenario 24 | Scenario 25 | Scenario 26 | Scenario 27 | Scenario 28 | Scenario 29 | Scenario 30 | Scenario 31 | Scenario 32 | Scenario 33 | Scenario 34 | Scenario 35 | Scenario 36 | Scenario 37 | Scenario 38 | Scenario 39 | Scenario 40 | Scenario 41 | Scenario 42 | Scenario 43 | Scenario 44 | Scenario 45 | Scenario 46 | Scenario 47 | Scenario 48 | Scenario 49 | Scenario 50 | Scenario 51 | Scenario 52 | Scenario 53 | Scenario 54 | Scenario 55
 |  |  |  |  | Estimated | Estimated | Estimated | Estimated | Estimated | Calculated | Calculated | Estimated | Estimated | Estimated | Estimated | Estimated | Estimated | Estimated | Estimated | Estimated | Calculated | Calculated | Calculated | Estimated | Estimated | Estimated | Estimated | Estimated | Estimated | Estimated | Estimated | Calculated | Calculated | Calculated | Calculated | Estimated | Estimated | Estimated | Estimated | Estimated | Estimated | Estimated | Calculated | Calculated | Calculated | Calculated | Calculated | Estimated | Estimated | Estimated | Estimated | Estimated | Estimated | Calculated | Calculated | Calculated | Calculated | Calculated | Estimated
Finger Offset |  | mm | 1 | 2 | 0.5 | 1 | 1.5 | 2 | 2.5 | 3 | 3.5 | 4 | 4.5 | 5 | 5.5 | 6 | 0.5 | 1 | 1.5 | 2 | 2.5 | 3 | 3.5 | 4 | 4.5 | 5 | 5.5 | 6 | 0.5 | 1 | 1.5 | 2 | 2.5 | 3 | 3.5 | 4 | 4.5 | 5 | 5.5 | 6 | 0.5 | 1 | 1.5 | 2 | 2.5 | 3 | 3.5 | 4 | 4.5 | 5 | 5.5 | 6 | 0.5 | 1 | 1.5 | 2 | 2.5 | 3 | 3.5
Finger Thickness |  | mm | 3 | 5 | 1 | 1 | 1 | 1 | 1 | 1 | 1 | 1 | 1 | 1 | 1 | 1 | 1.5 | 1.5 | 1.5 | 1.5 | 1.5 | 1.5 | 1.5 | 1.5 | 1.5 | 1.5 | 1.5 | 1.5 | 2 | 2 | 2 | 2 | 2 | 2 | 2 | 2 | 2 | 2 | 2 | 2 | 2.5 | 2.5 | 2.5 | 2.5 | 2.5 | 2.5 | 2.5 | 2.5 | 2.5 | 2.5 | 2.5 | 2.5 | 3 | 3 | 3 | 3 | 3 | 3 | 3
Stress1 | Minimize | N/m^2 | 553217.1 | 235539.5 | Rebuild Error | Rebuild Error | Rebuild Error | Rebuild Error | Rebuild Error | 2924952 | 3068839 | Rebuild Error | Rebuild Error | Rebuild Error | Rebuild Error | Rebuild Error | Rebuild Error | Rebuild Error | Rebuild Error | Rebuild Error | 1725475 | 1685880 | 1697103 | Rebuild Error | Rebuild Error | Rebuild Error | Rebuild Error | Error | Rebuild Error | Rebuild Error | Rebuild Error | 1080423 | 1084139 | 1033540 | 1034631 | Rebuild Error | Rebuild Error | Rebuild Error | Error | Error | Rebuild Error | Rebuild Error | 769221.3 | 769914.6 | 711289 | 705869.4 | 688215.8 | Rebuild Error | Rebuild Error | Error | Error | Error | Rebuild Error | 553166.6 | 558294.3 | 523406 | 507370.8 | 500417.6 | Simulation Static 1 fails.
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
