caltechcaos/Lunar-Dust-Challenge/Archived/EASE/PerformanceLog.txt

Number of Contacts: 1
Number of contact data: 4946
