caltechcaos/Lunar-Dust-Challenge/Current/Mechanical/Finger Thickness Analysis/Version 1/designstudy_results.csv

Design Study 1
Scenarios/Iterations: | 35
Parameter Constraint or Goal | Format | Unit | Initial Value | Optimal Value | Scenario 1 | Scenario 2 | Scenario 3 | Scenario 4 | Scenario 5 | Scenario 6 | Scenario 7 | Scenario 8 | Scenario 9 | Scenario 10 | Scenario 11 | Scenario 12 | Scenario 13 | Scenario 14 | Scenario 15 | Scenario 16 | Scenario 17 | Scenario 18 | Scenario 19 | Scenario 20 | Scenario 21 | Scenario 22 | Scenario 23 | Scenario 24 | Scenario 25 | Scenario 26 | Scenario 27 | Scenario 28 | Scenario 29 | Scenario 30 | Scenario 31 | Scenario 32 | Scenario 33 | Scenario 34 | Scenario 35
 |  |  |  |  | Calculated | Calculated | Calculated | Calculated | Estimated | Calculated | Calculated | Estimated | Calculated | Calculated | Estimated | Estimated | Calculated | Calculated | Calculated | Calculated | Estimated | Estimated | Calculated | Calculated | Calculated | Estimated | Estimated | Calculated | Estimated | Estimated | Estimated | Estimated | Calculated | Estimated | Calculated | Calculated | Calculated | Estimated | Estimated
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
