caltechcaos/Lunar-Dust-Challenge/Compliant Mechanism Tester/Code and Data/CompliantMechanismForceResponse.png

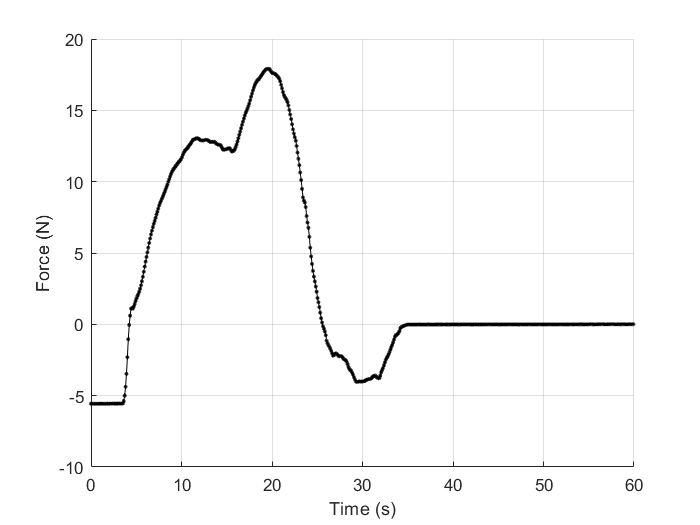
Compliant Mechanism Tester/Code and Data/CompliantMechanismForceResponse.png
