caltechcaos/Lunar-Dust-Challenge/Compliant Mechanism Tester/Code and Data/Figures/magnetForce.png

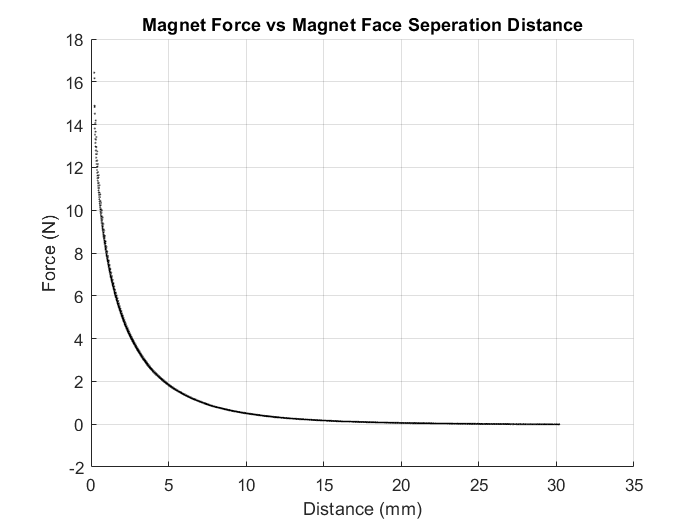
Compliant Mechanism Tester/Code and Data/Figures/magnetForce.png
