caltechcaos/Lunar-Dust-Challenge/Compliant Mechanism Tester/Code and Data/Figures/pogoConnector.png

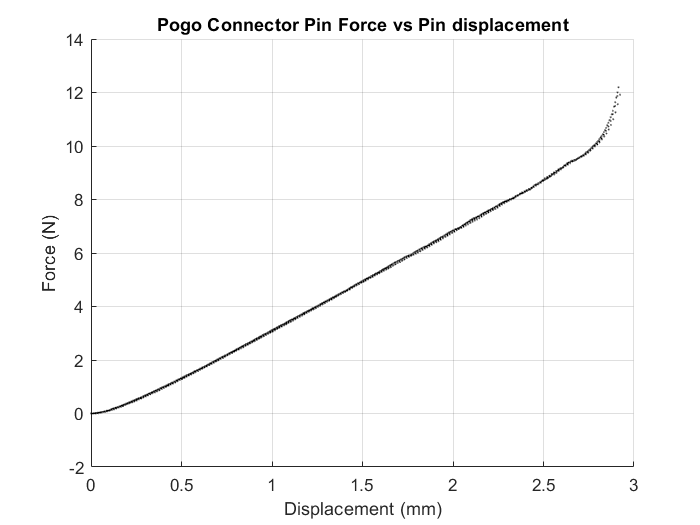
Compliant Mechanism Tester/Code and Data/Figures/pogoConnector.png
