caltechcaos/Lunar-Dust-Challenge/Current/Validation/COMSOL/HOMES EDS Electric Field Magnitude - Augmentation File 1.png

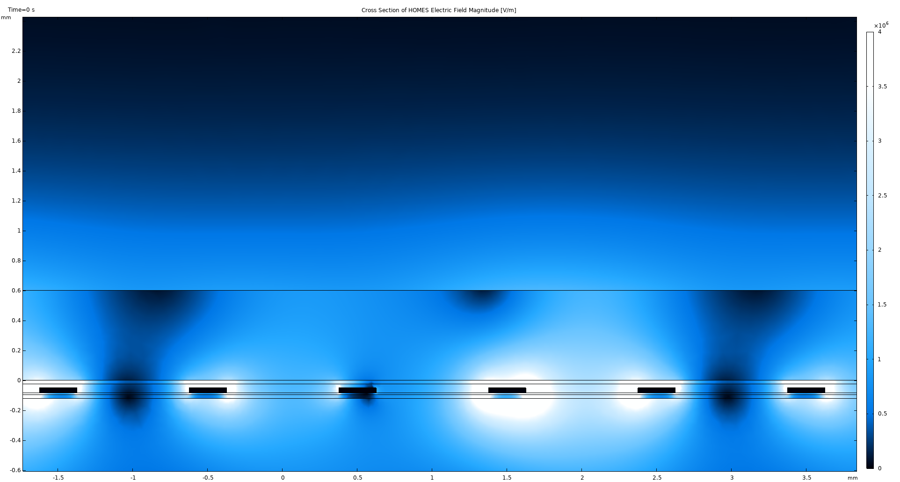
Current/Validation/COMSOL/HOMES EDS Electric Field Magnitude - Augmentation File 1.png
