caltechcaos/Lunar-Dust-Challenge/Current/Validation/COMSOL/Images/Screenshot 2021-04-16 110732.jpg

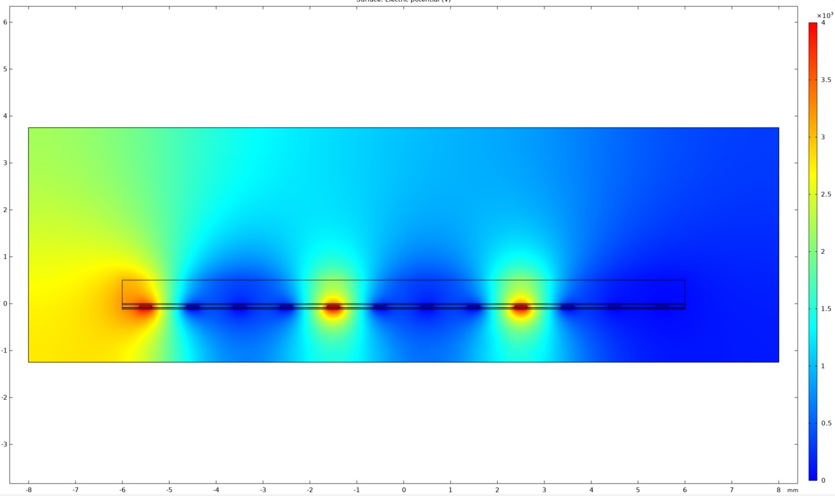
Current/Validation/COMSOL/Images/Screenshot 2021-04-16 110732.jpg
