caltechcaos/Lunar-Dust-Challenge/Current/Validation/COMSOL/Images/Screenshot 2021-04-16 111257.jpg

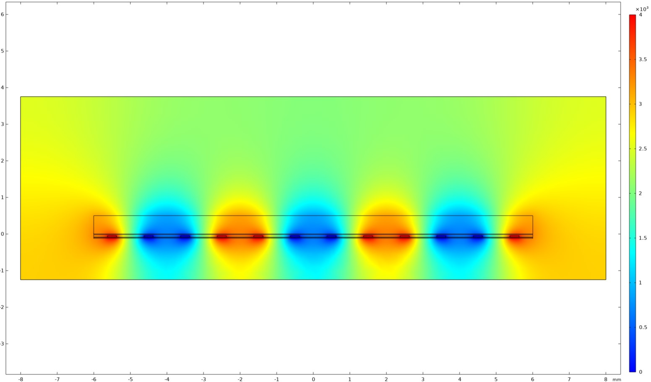
Current/Validation/COMSOL/Images/Screenshot 2021-04-16 111257.jpg
