caltechcaos/Lunar-Dust-Challenge/Current/Validation/COMSOL/Videos/48 Electrode Test 1.gif

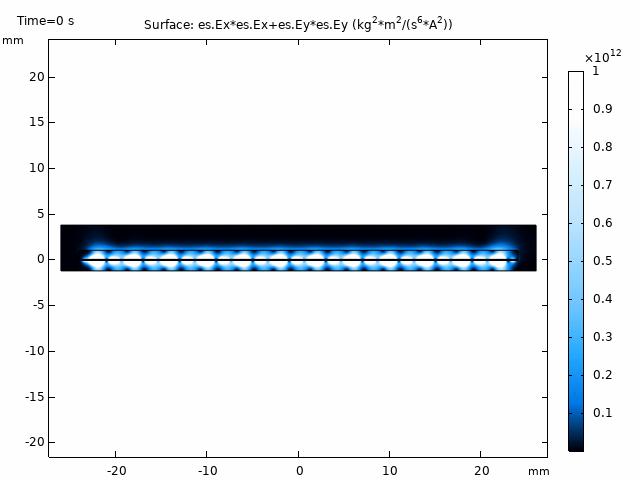
Current/Validation/COMSOL/Videos/48 Electrode Test 1.gif
