caltechcaos/Lunar-Dust-Challenge/Current/Mechanical/v3_tiz/Drawings/HOMES_bplate_drawing.pdf

D D

4

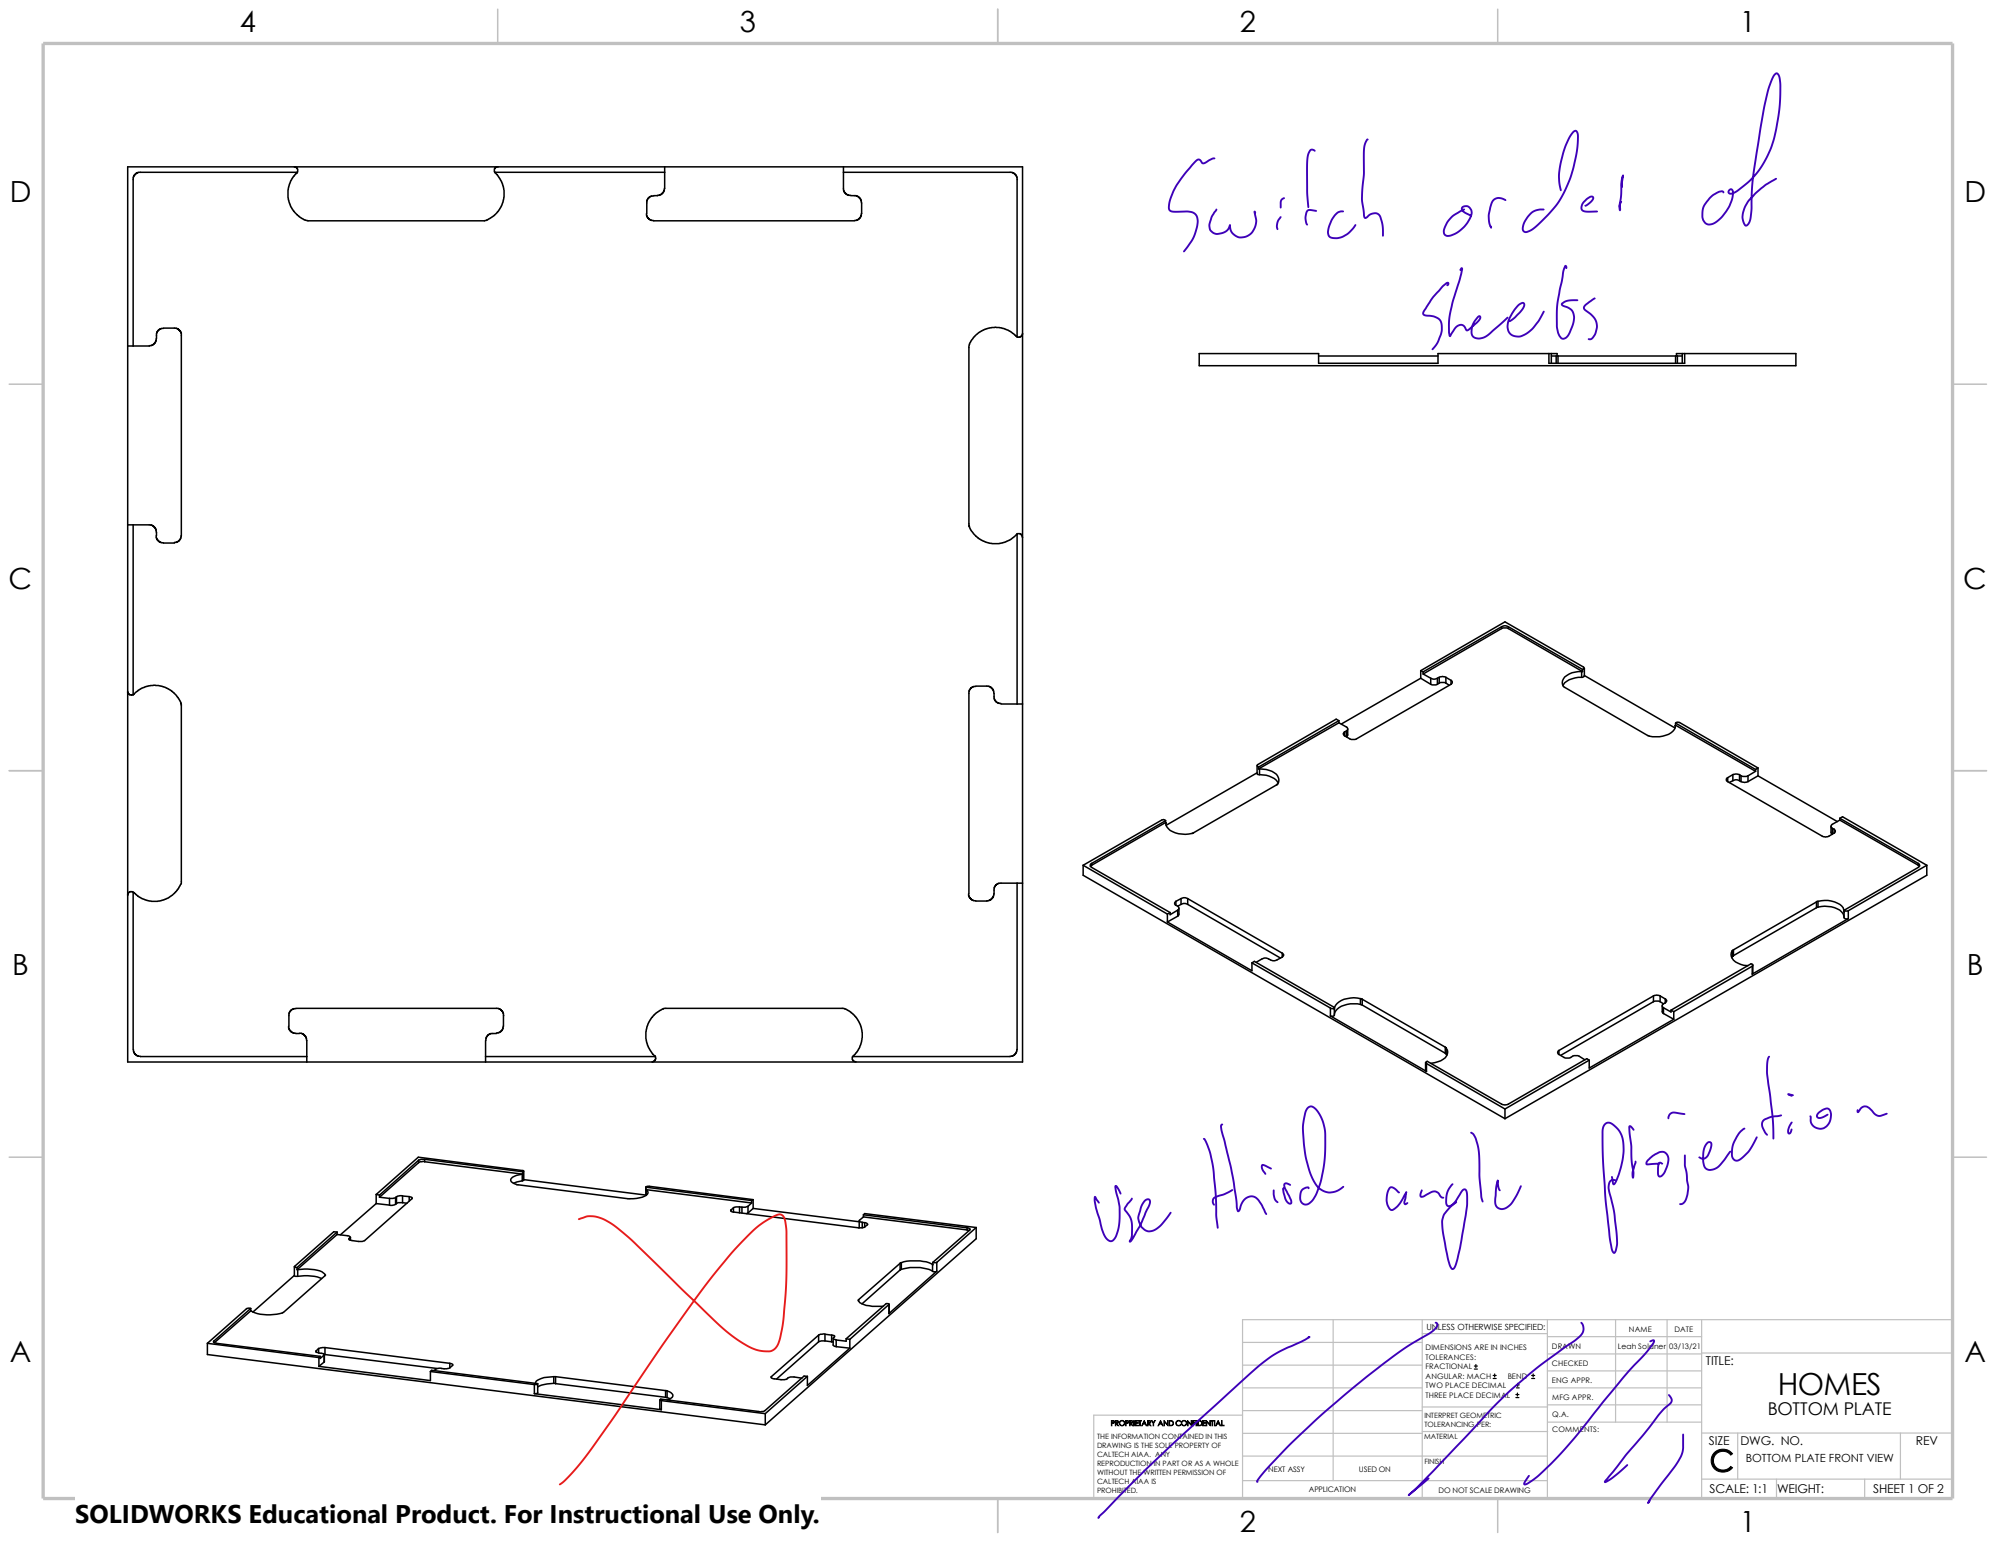
[picture p625: page 1]
COMMENTS:

DIMENSIONS ARE IN INCHES TOLERANCES: FRACTIONAL ANGULAR: MACH BEND TWO PLACE DECIMAL THREE PLACE DECIMAL | DRAWN | Leah Soldner | 03/13/21

UNLESS OTHERWISE SPECIFIED: | | NAME | DATE

CHECKED | | | TITLE: HOMES BOTTOM PLATE

ENG APPR.

MFG APPR.

PROPRIETARY AND CONFIDENTIAL
THE INFORMATION CONTAINED IN THIS
DRAWING IS THE SOLE PROPERTY OF
CALTECH AIAA. ANY
REPRODUCTION IN PART OR AS A WHOLE
WITHOUT THE WRITTEN PERMISSION OF
CALTECH AIAA IS
PROHIBITED.

INTERPRET GEOMETRIC TOLERANCING PER: | Q.A.
MATERIAL | | SIZE C | DWG. NO. BOTTOM PLATE FRONT VIEW | REV

NEXT ASSY | USED ON | FINISH

APPLICATION | DO NOT SCALE DRAWING | | SCALE: 1:1 | WEIGHT: | SHEET 1 OF 2

SOLIDWORKS Educational Product. For Instructional Use Only.

D D

4

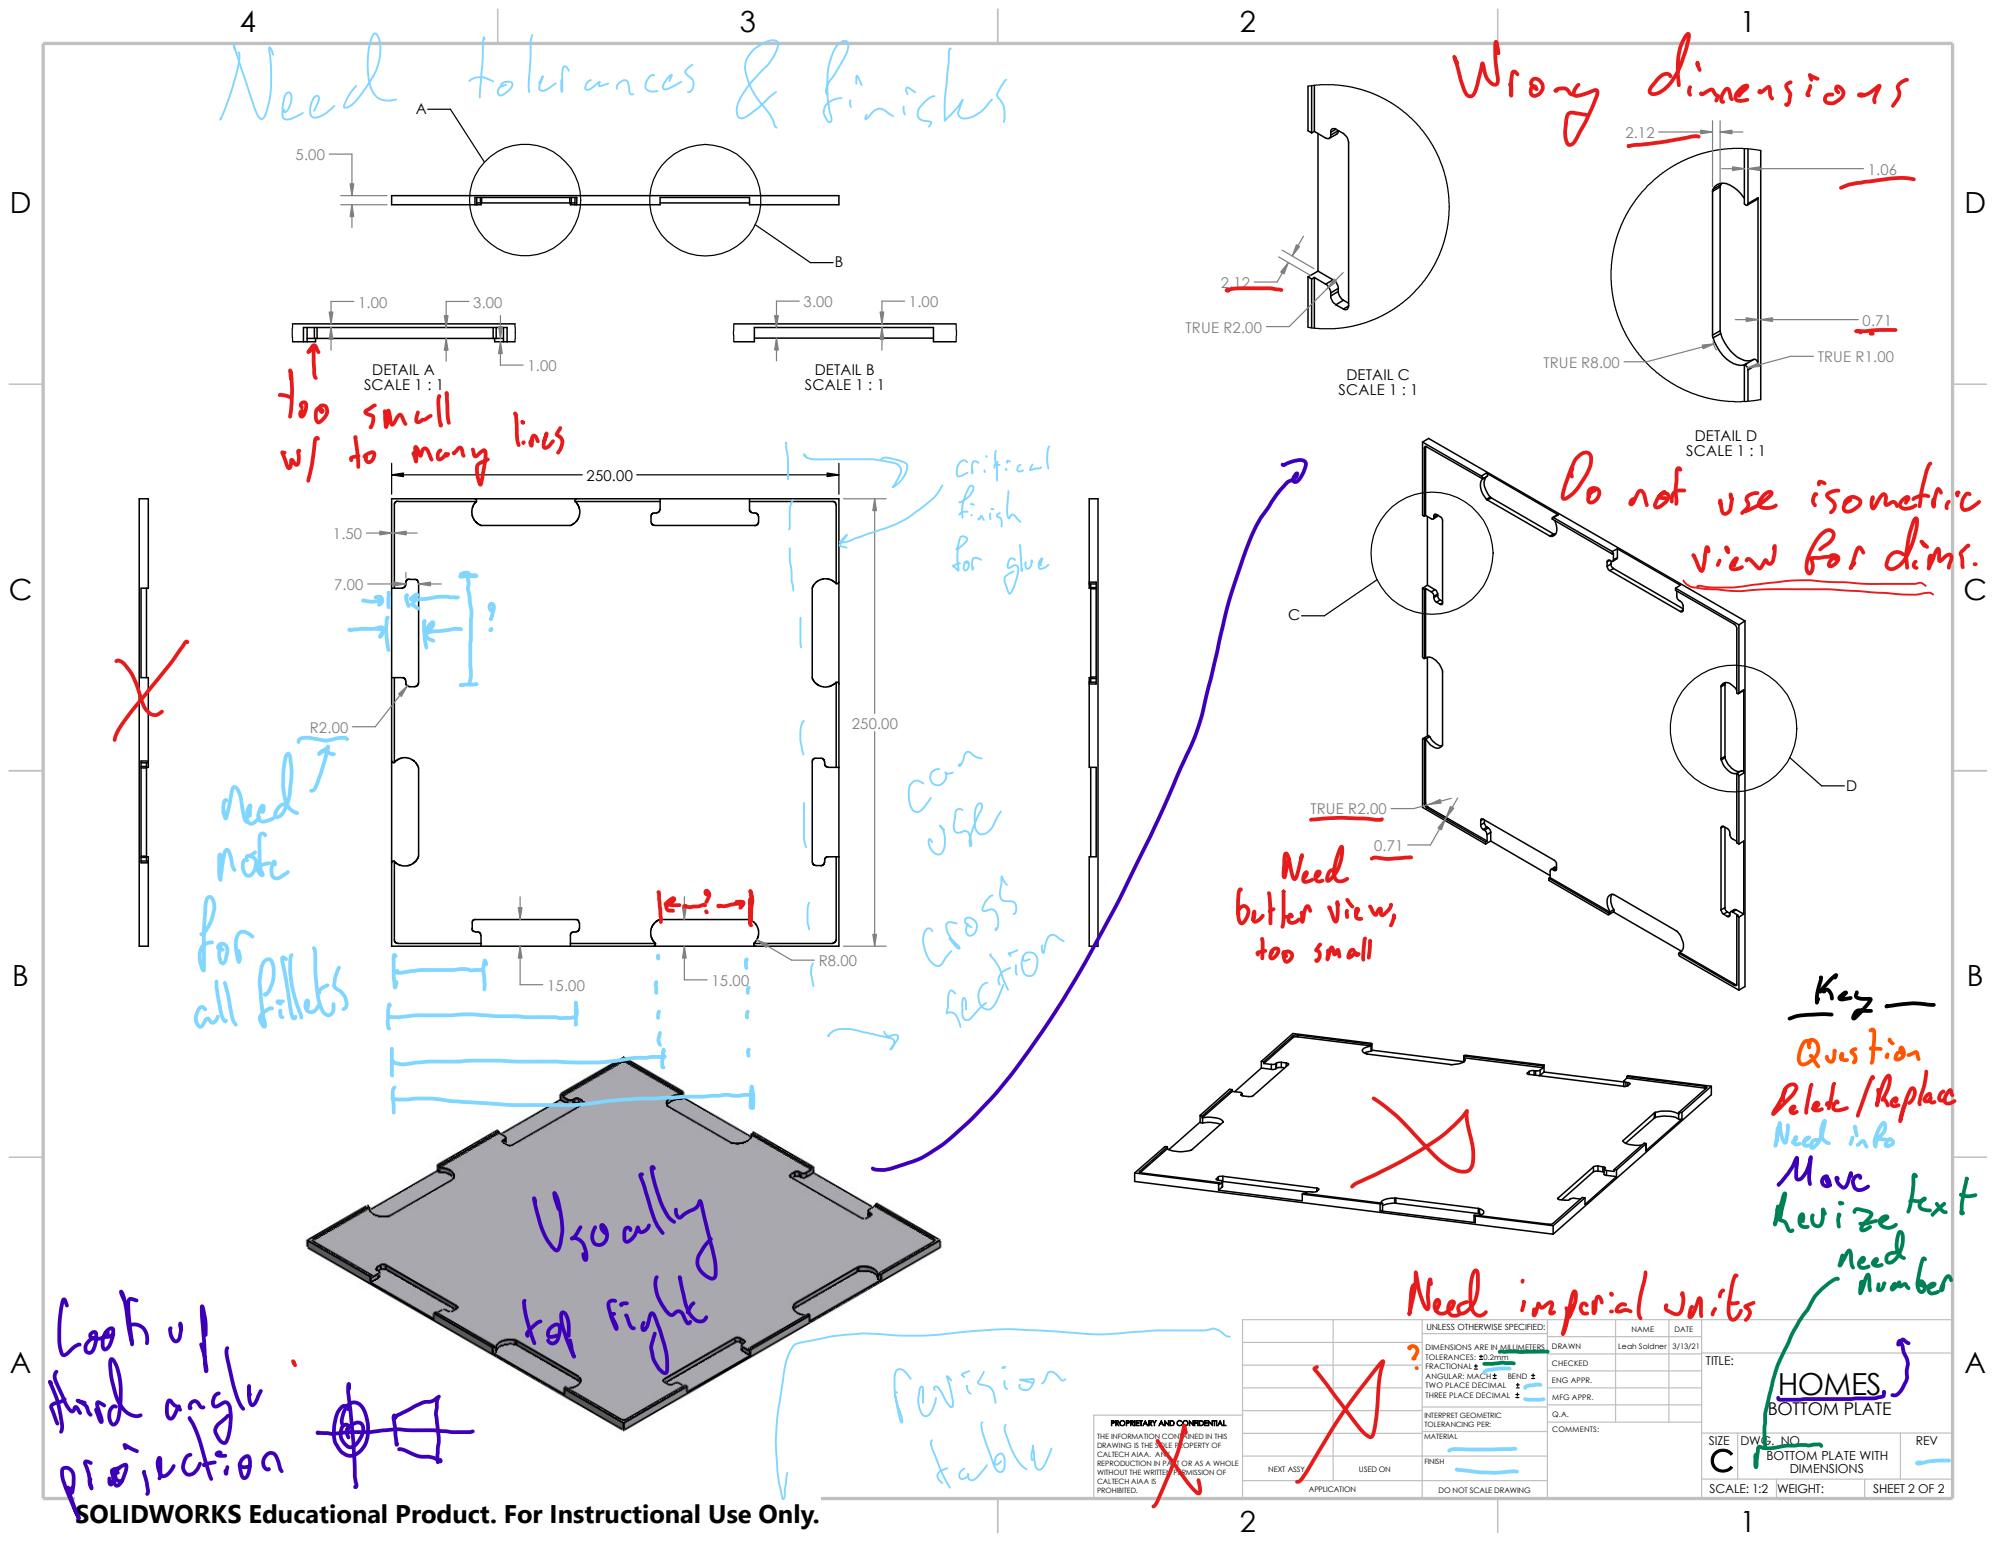
[picture p626: page 2]
COMMENTS:; DETAIL A SCALE 1 : 1; 1.00 DETAIL B SCALE 1 : 1; DETAIL C SCALE 1 : 1; TRUE R2.00; DETAIL D SCALE 1 : 1; TRUE R8.00; TRUE R1.00

DIMENSIONS ARE IN MILLIMETERS TOLERANCES: 0.2mm FRACTIONAL ANGULAR: MACH BEND TWO PLACE DECIMAL THREE PLACE DECIMAL | DRAWN | Leah Soldner | 3/13/21

UNLESS OTHERWISE SPECIFIED: | | NAME | DATE

CHECKED | | | TITLE: HOMES BOTTOM PLATE

ENG APPR.

MFG APPR.

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

INTERPRET GEOMETRIC TOLERANCING PER: | Q.A.
MATERIAL | | SIZE C | DWG. NO. BOTTOM PLATE WITH DIMENSIONS | REV

NEXT ASSY | USED ON | FINISH

APPLICATION | DO NOT SCALE DRAWING | | SCALE: 1:2 | WEIGHT: | SHEET 2 OF 2

SOLIDWORKS Educational Product. For Instructional Use Only.
