caltechcaos/Lunar-Dust-Challenge/Current/Mechanical/v3_tiz/Drawings/HOMES_finger_joint_v3.2.pdf

D D

4

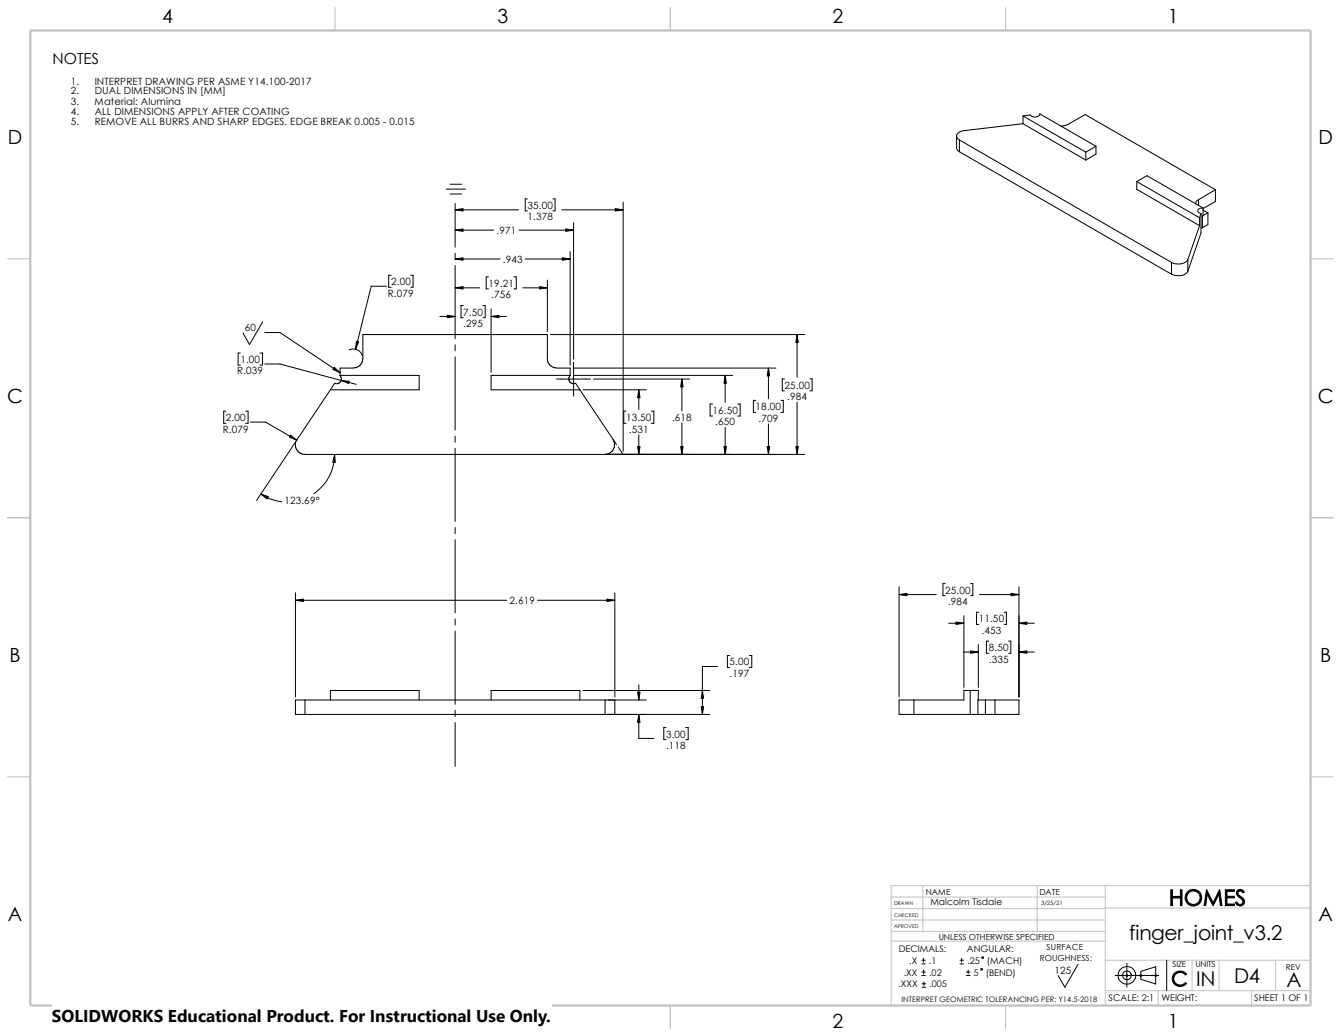
[picture p627: page 1]
UNLESS OTHERWISE SPECIFIED; .XXX; NOTES; SURFACE; ROUGHNESS:; DECIMALS:; INTERPRET GEOMETRIC TOLERANCING PER: Y14.5-2018; INTERPRET DRAWING PER ASME Y14.100-2017; ANGULAR: .25 (MACH)

DUAL DIMENSIONS IN [MM]
3. Material: Alumina
ALL DIMENSIONS APPLY AFTER COATING
REMOVE ALL BURRS AND SHARP EDGES. EDGE BREAK 0.005 - 0.015

NAME | DATE | HOMES
DRAWN | Malcolm Tisdale | 3/25/21
CHECKED | | | finger_joint_v3.2
APROVED

SIZE | UNITS IN | D4 ⁽BEND) | REV C A

SCALE: 2:1 | WEIGHT: | SHEET 1 OF 1

SOLIDWORKS Educational Product. For Instructional Use Only.
