caltechcaos/Lunar-Dust-Challenge/Current/Mechanical/v4_Eggdee/Drawings/bottom_plate_v4-4_drawing_v1.PDF

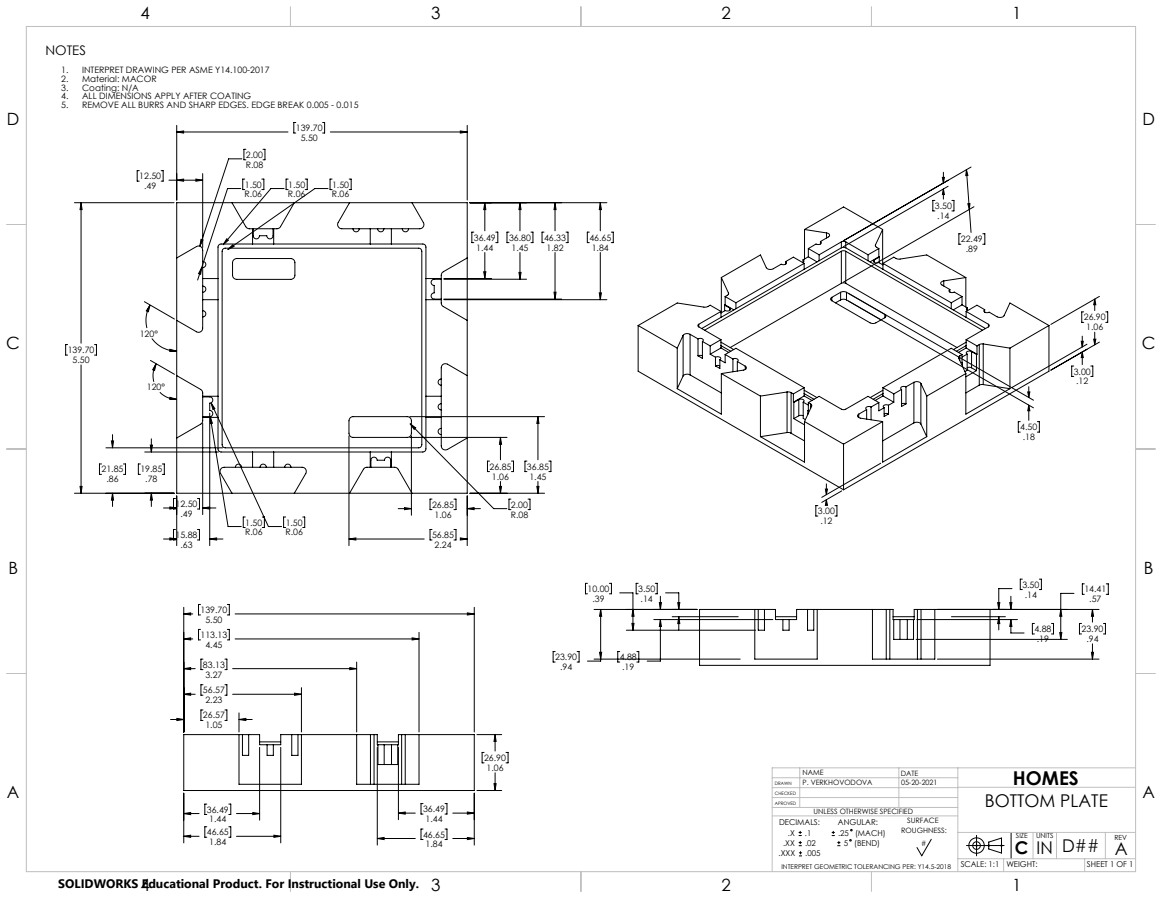
[picture p628: page 1]
.25 (MACH) 5 (BEND)

NOTES
1. INTERPRET DRAWING PER ASME Y14.100-2017
2. Material: MACOR
3. Coating: N/A
4. ALL DIMENSIONS APPLY AFTER COATING
5. REMOVE ALL BURRS AND SHARP EDGES. EDGE BREAK 0.005 - 0.015

NAME | DATE | HOMES
CHECKED | | | BOTTOM PLATE
APROVED
DECIMALS: ANGULAR: SURFACE ROUGHNESS:

DRAWN | P. VERKHOVODOVA | 05-20-2021

UNLESS OTHERWISE SPECIFIED

SIZE C | UNITS IN | D## | REV A

INTERPRET GEOMETRIC TOLERANCING PER: Y14.5-2018 | SCALE: 1:1 | WEIGHT: | SHEET 1 OF 1

SOLIDWORKS Educational Product. For Instructional Use Only.
