caltechcaos/Lunar-Dust-Challenge/Current/Mechanical/v4_Eggdee/Drawings/bottom_plate_v4-4_drawing_v2.PDF

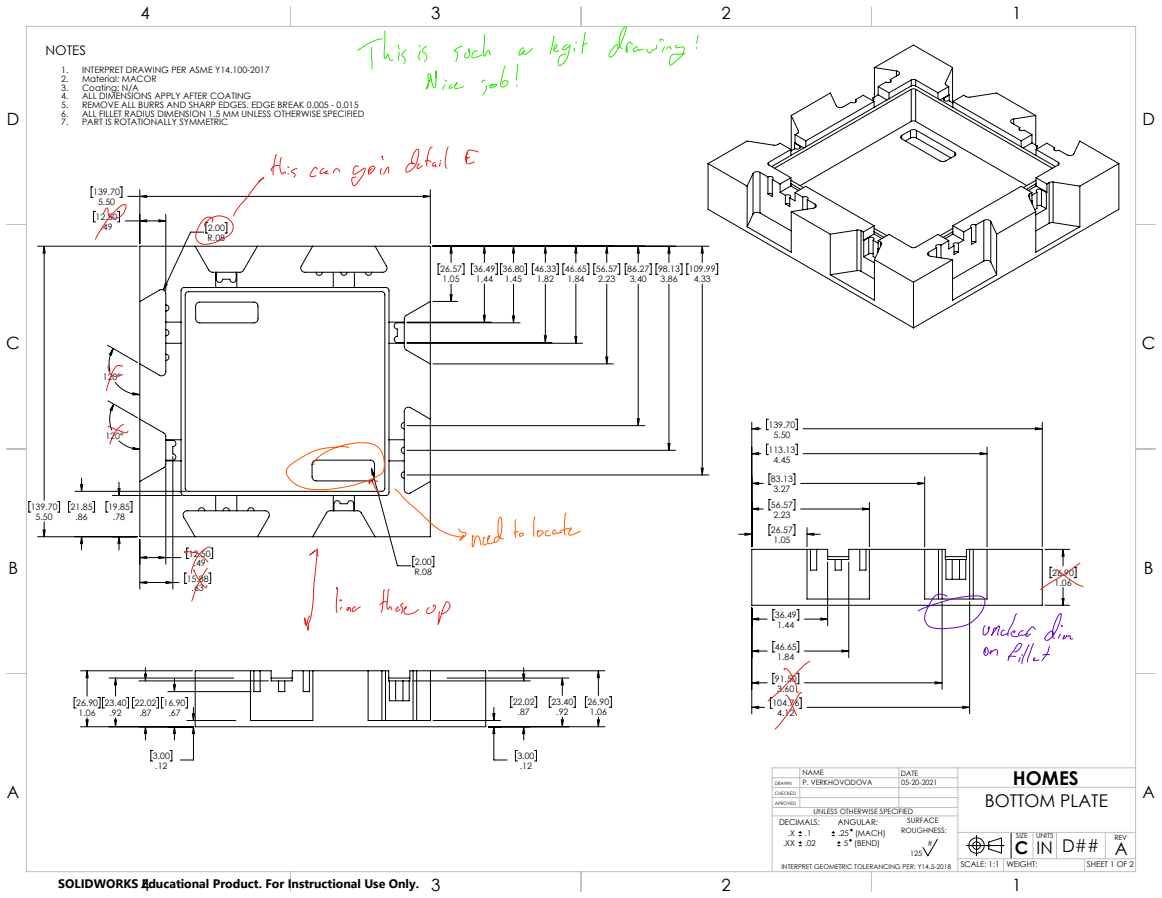
[picture p629: page 1]
.25 (MACH) 5 (BEND)

NOTES
1. INTERPRET DRAWING PER ASME Y14.100-2017
2. Material: MACOR
3. Coating: N/A
4. ALL DIMENSIONS APPLY AFTER COATING
5. REMOVE ALL BURRS AND SHARP EDGES. EDGE BREAK 0.005 - 0.015

6. ALL FILLET RADIUS DIMENSION 1.5 MM UNLESS OTHERWISE SPECIFIED
7. PART IS ROTATIONALLY SYMMETRIC

NAME | DATE | HOMES
CHECKED | | | BOTTOM PLATE
APROVED
DECIMALS: ANGULAR: SURFACE ROUGHNESS: 125

DRAWN | P. VERKHOVODOVA | 05-20-2021

UNLESS OTHERWISE SPECIFIED

SIZE C | UNITS IN | D## | REV A

INTERPRET GEOMETRIC TOLERANCING PER: Y14.5-2018 | SCALE: 1:1 | WEIGHT: | SHEET 1 OF 2

SOLIDWORKS Educational Product. For Instructional Use Only.

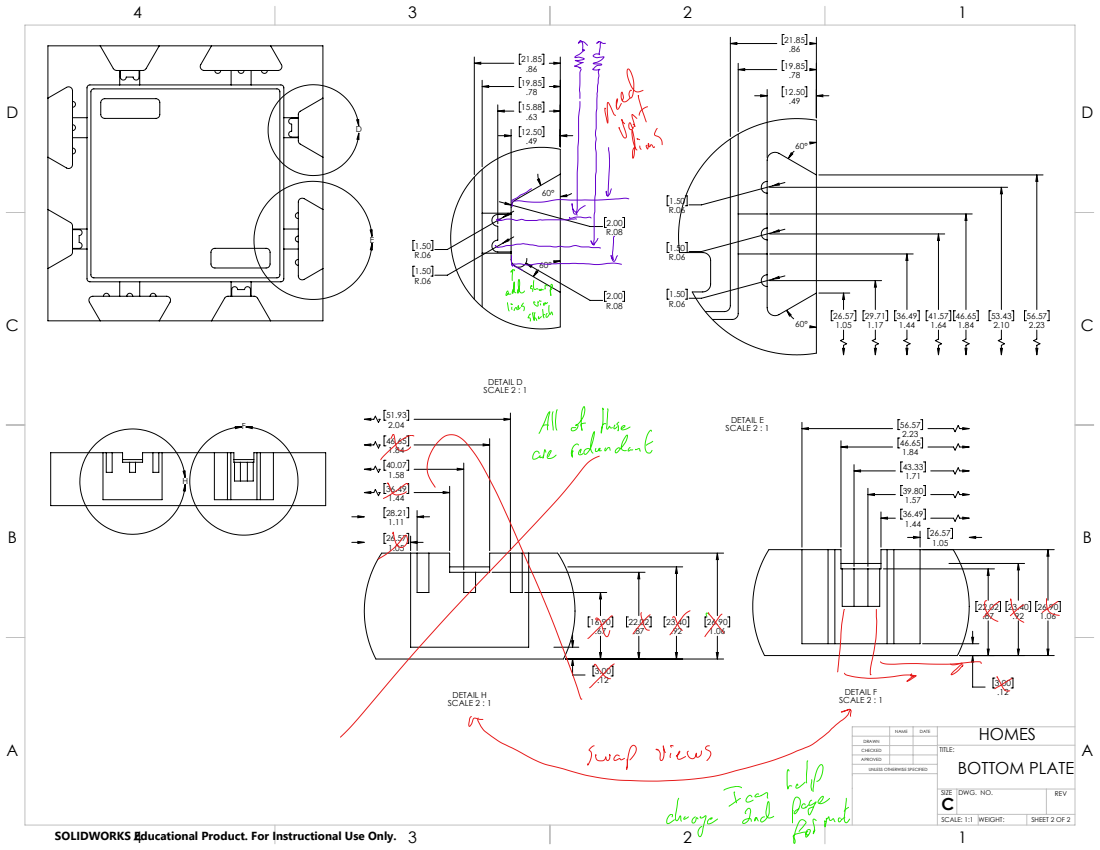
[picture p630: page 2]
DETAIL D SCALE 2 : 1; DETAIL E; SCALE 2 : 1; DETAIL F SCALE 2 : 1; DETAIL H SCALE 2 : 1

NAME | DATE | HOMES

DRAWN
CHECKED | | | TITLE: BOTTOM PLATE

APROVED

UNLESS OTHERWISE SPECIFIED

SIZE C | DWG. NO. | REV

SCALE: 1:1 | WEIGHT: | SHEET 2 OF 2

SOLIDWORKS Educational Product. For Instructional Use Only.
