caltechcaos/Lunar-Dust-Challenge/Current/Mechanical/v4_Eggdee/Drawings/finger_joint_cap_v4.1_drawing_v1_mt_edited.pdf

D D

4

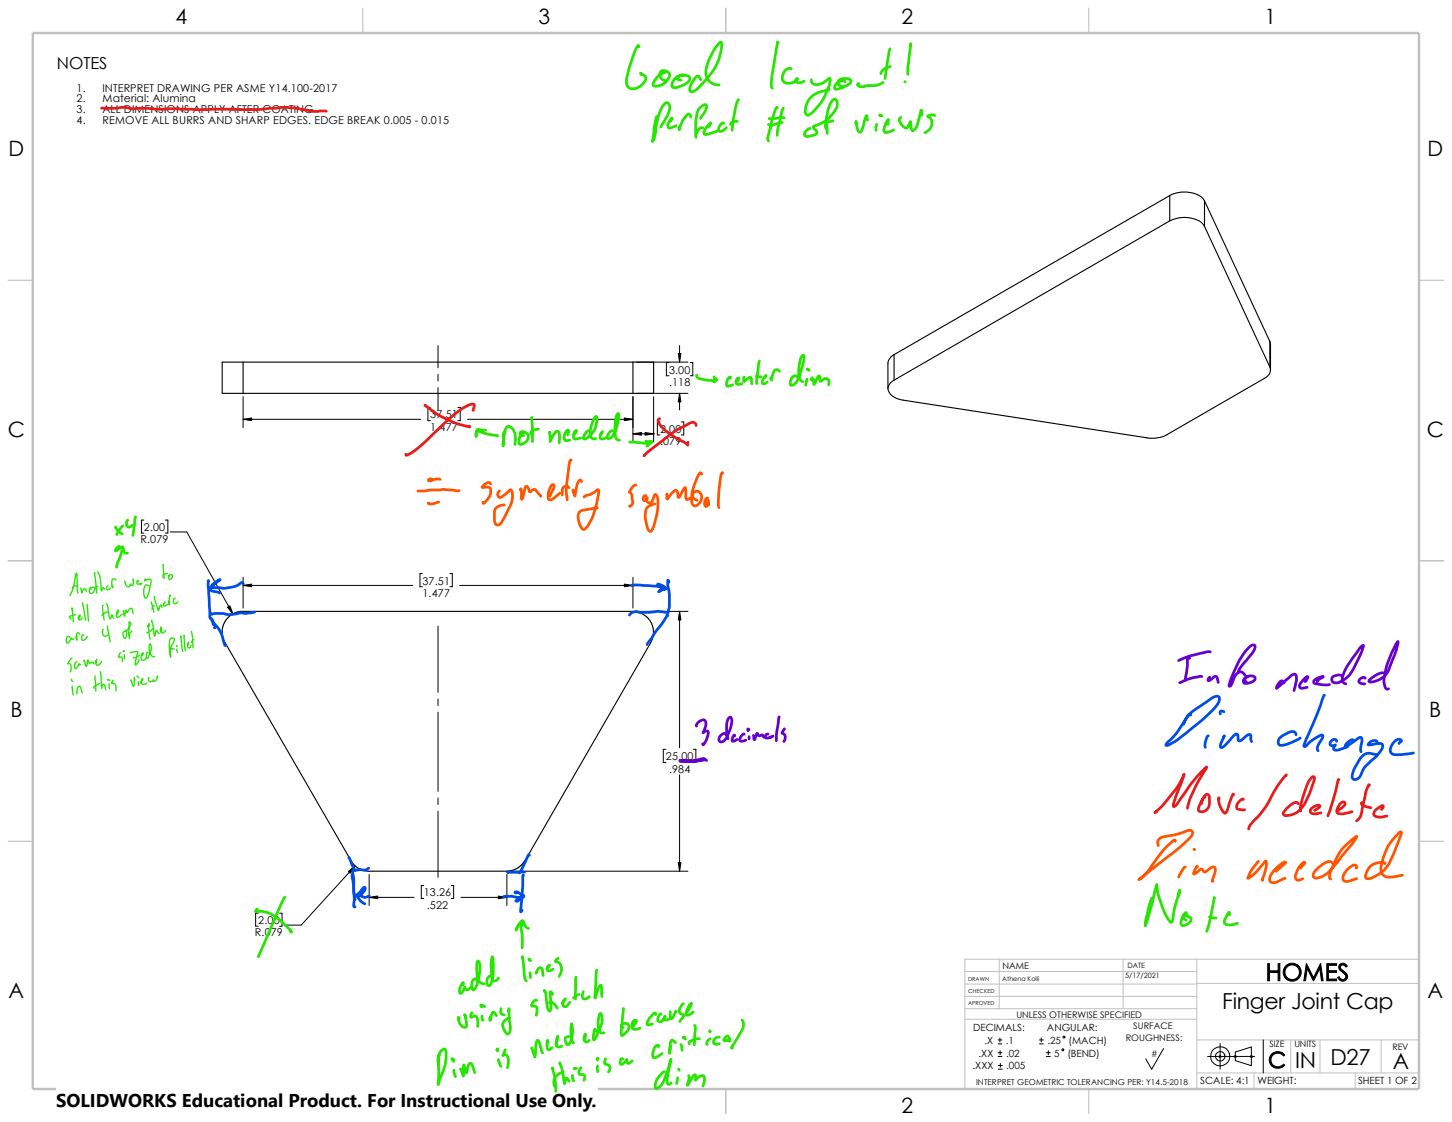
[picture p631: page 1]
INTERPRET GEOMETRIC TOLERANCING PER: Y14.5-2018; SURFACE; (BEND); ROUGHNESS: .1; .XXX; Material: Alumina; NOTES; DECIMALS:; ANGULAR:; .25 (MACH)

INTERPRET DRAWING PER ASME Y14.100-2017
3. ALL DIMENSIONS APPLY AFTER COATING
REMOVE ALL BURRS AND SHARP EDGES. EDGE BREAK 0.005 - 0.015

NAME | DATE | HOMES
CHECKED | | | Finger Joint Cap
APROVED

DRAWN | Athena Kolli | 5/17/2021

UNLESS OTHERWISE SPECIFIED

SIZE | UNITS IN | D27 | REV C A

SCALE: 4:1 | WEIGHT: | SHEET 1 OF 2

SOLIDWORKS Educational Product. For Instructional Use Only.

D D

4

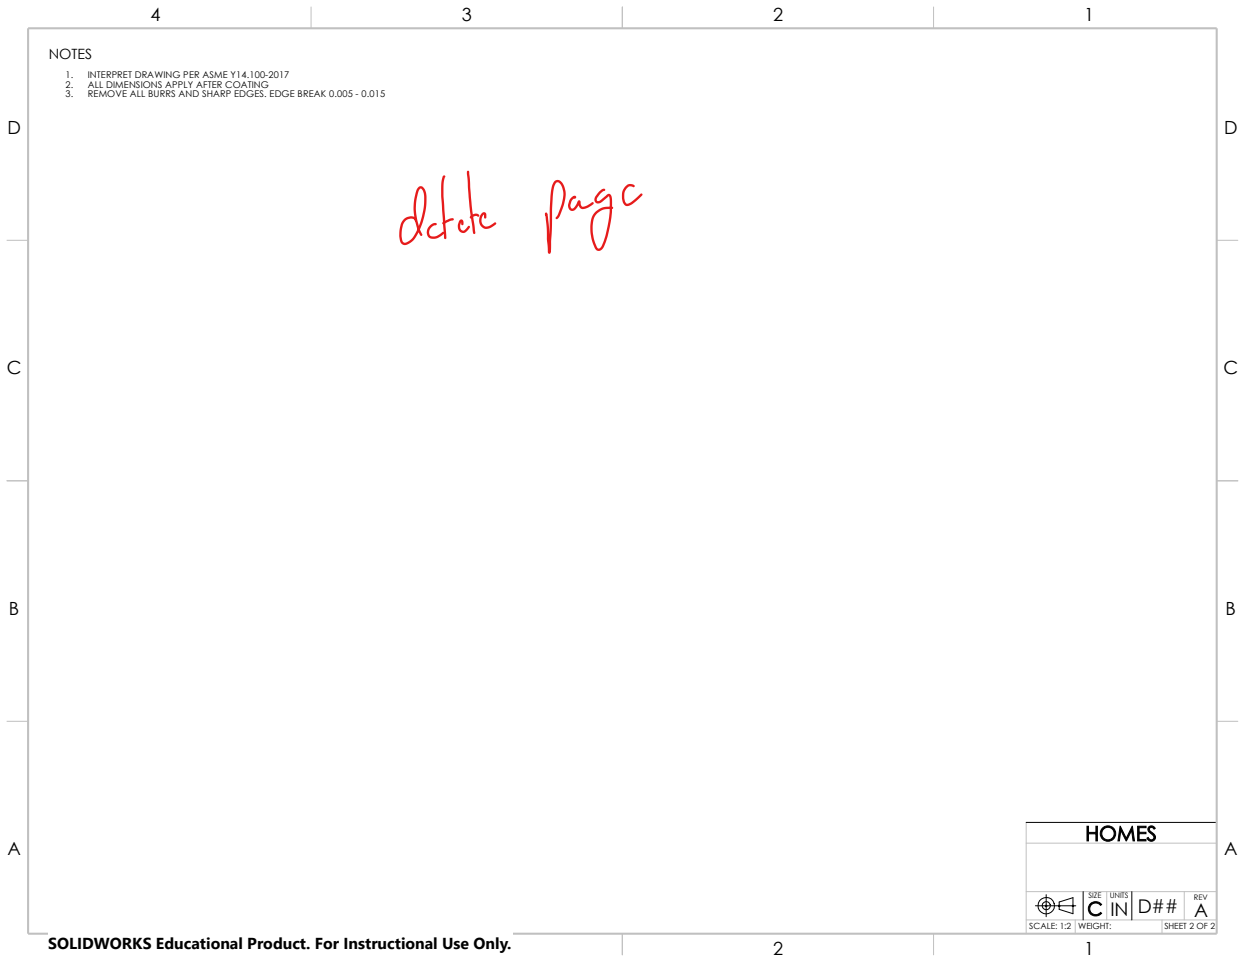
[picture p632: page 2]
HOMES; NOTES

1. INTERPRET DRAWING PER ASME Y14.100-2017
2. ALL DIMENSIONS APPLY AFTER COATING
3. REMOVE ALL BURRS AND SHARP EDGES. EDGE BREAK 0.005 - 0.015

SIZE | UNITS IN | D## | REV C A

SCALE: 1:2 | WEIGHT: | SHEET 2 OF 2

SOLIDWORKS Educational Product. For Instructional Use Only.
