caltechcaos/Lunar-Dust-Challenge/Current/Mechanical/v4_Eggdee/Drawings/finger_joint_v4.2_drawingv1.PDF

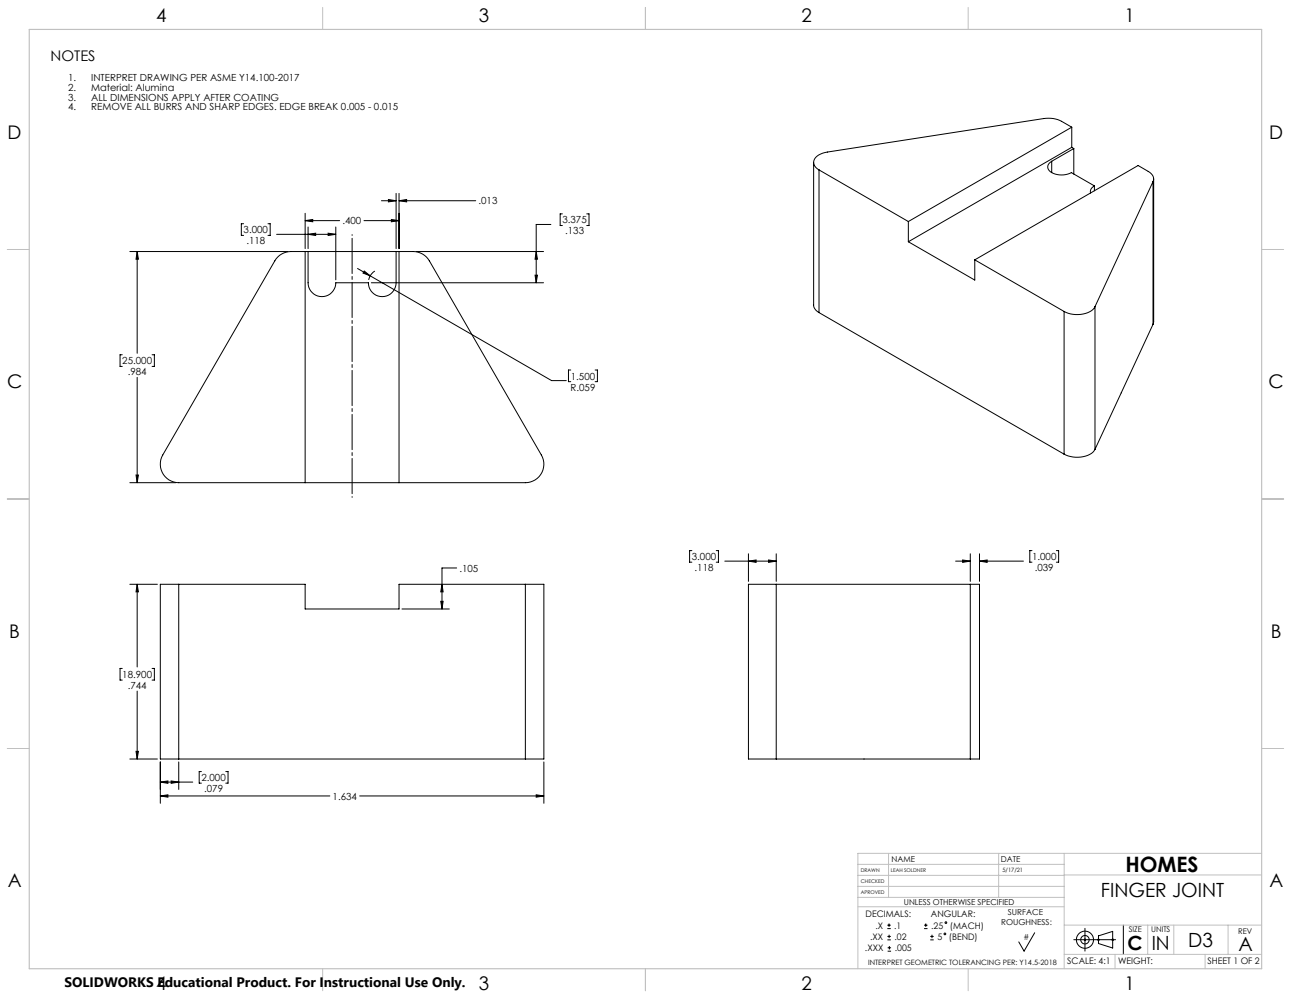
[picture p635: page 1]
.25 (MACH) 5 (BEND)

NOTES
1. INTERPRET DRAWING PER ASME Y14.100-2017
2. Material: Alumina
3. ALL DIMENSIONS APPLY AFTER COATING
4. REMOVE ALL BURRS AND SHARP EDGES. EDGE BREAK 0.005 - 0.015

NAME | DATE | HOMES
CHECKED | | | FINGER JOINT
APROVED
DECIMALS: ANGULAR: SURFACE ROUGHNESS:

DRAWN | LEAH SOLDNER | 5/17/21

UNLESS OTHERWISE SPECIFIED

SIZE C | UNITS IN | D3 | REV A

INTERPRET GEOMETRIC TOLERANCING PER: Y14.5-2018 | SCALE: 4:1 | WEIGHT: | SHEET 1 OF 2

SOLIDWORKS Educational Product. For Instructional Use Only.

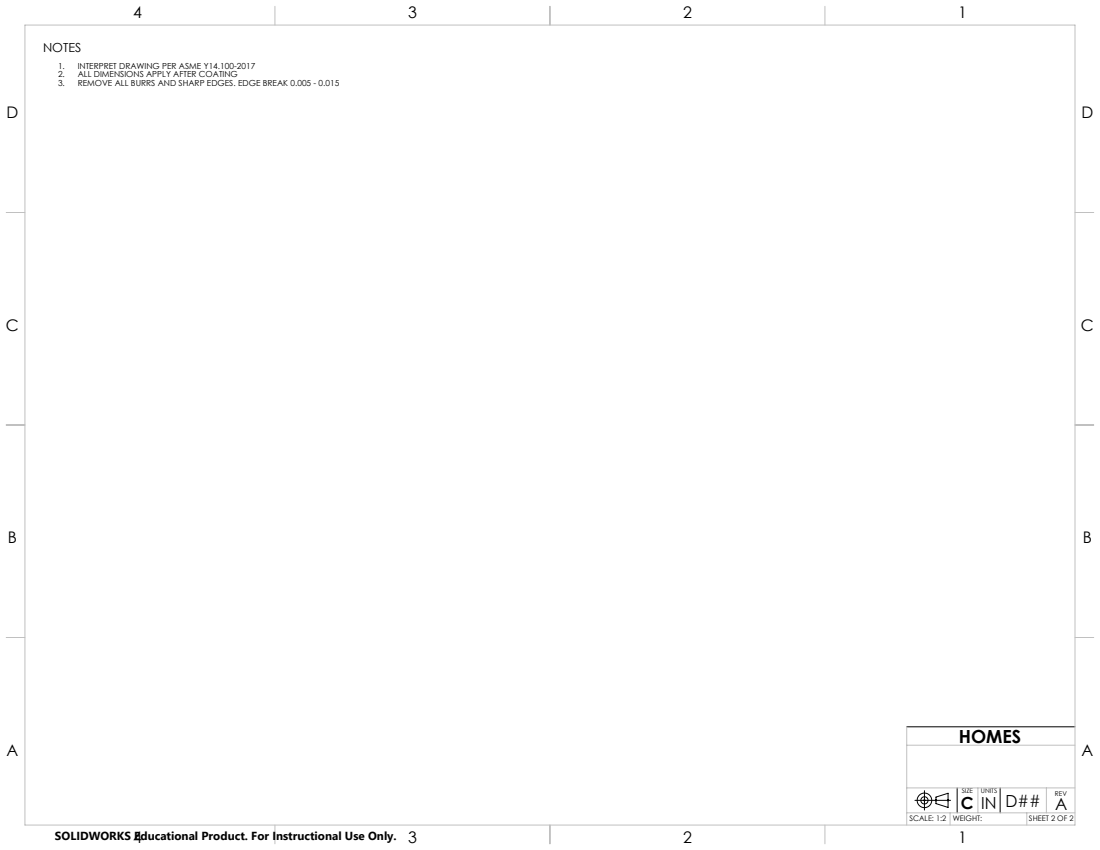
[picture p636: page 2]

NOTES
1. INTERPRET DRAWING PER ASME Y14.100-2017
2. ALL DIMENSIONS APPLY AFTER COATING
3. REMOVE ALL BURRS AND SHARP EDGES. EDGE BREAK 0.005 - 0.015

SIZE C | UNITS D## IN | REV A

SCALE: 1:2 | WEIGHT: | SHEET 2 OF 2

SOLIDWORKS Educational Product. For Instructional Use Only.
