caltechcaos/Lunar-Dust-Challenge/Current/Mechanical/v5_Sussy_Baka/Drawings/bplate_quarter_wall_vFINAL.PDF

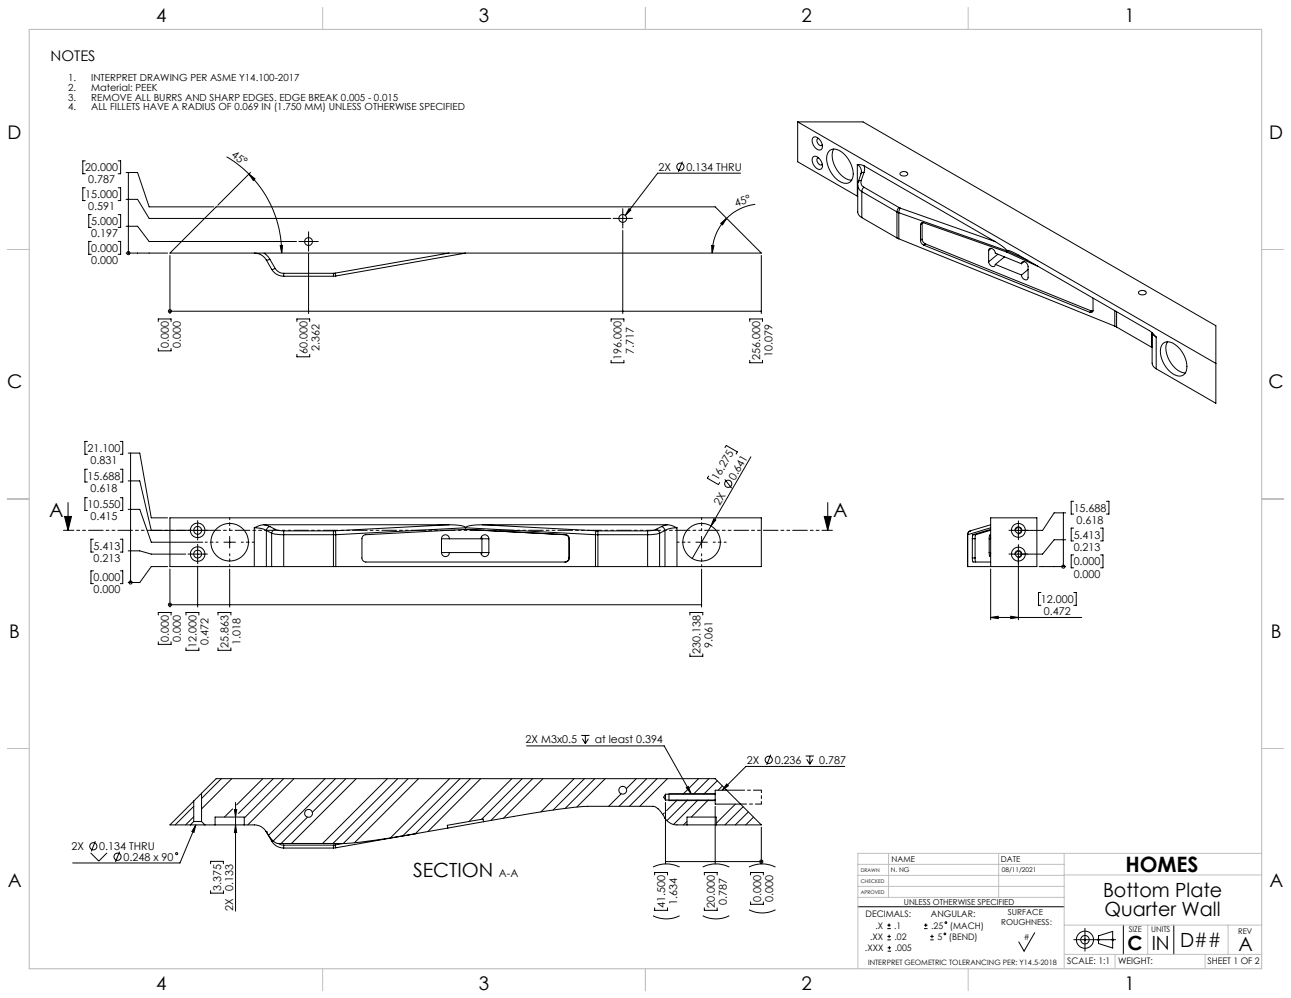
[picture p638: page 1]
2X 0.134 THRU; SECTION A-A; 2X 0.134 THRU 0.248 x 90; 2X M3x0.5 at least 0.394

NOTES
1. INTERPRET DRAWING PER ASME Y14.100-2017
2. Material: PEEK
3. REMOVE ALL BURRS AND SHARP EDGES. EDGE BREAK 0.005 - 0.015
4. ALL FILLETS HAVE A RADIUS OF 0.069 IN (1.750 MM) UNLESS OTHERWISE SPECIFIED

NAME | DATE | HOMES
CHECKED | | | Bottom Plate Quarter Wall
APROVED

DRAWN | N. NG | 08/11/2021

UNLESS OTHERWISE SPECIFIED
ANGULAR:
.25 (MACH)
5 (BEND)

DECIMALS:
INTERPRET GEOMETRIC TOLERANCING PER: Y14.5-2018

SIZE C | UNITS D## IN | REV A

SCALE: 1:1 | WEIGHT: | SHEET 1 OF 2

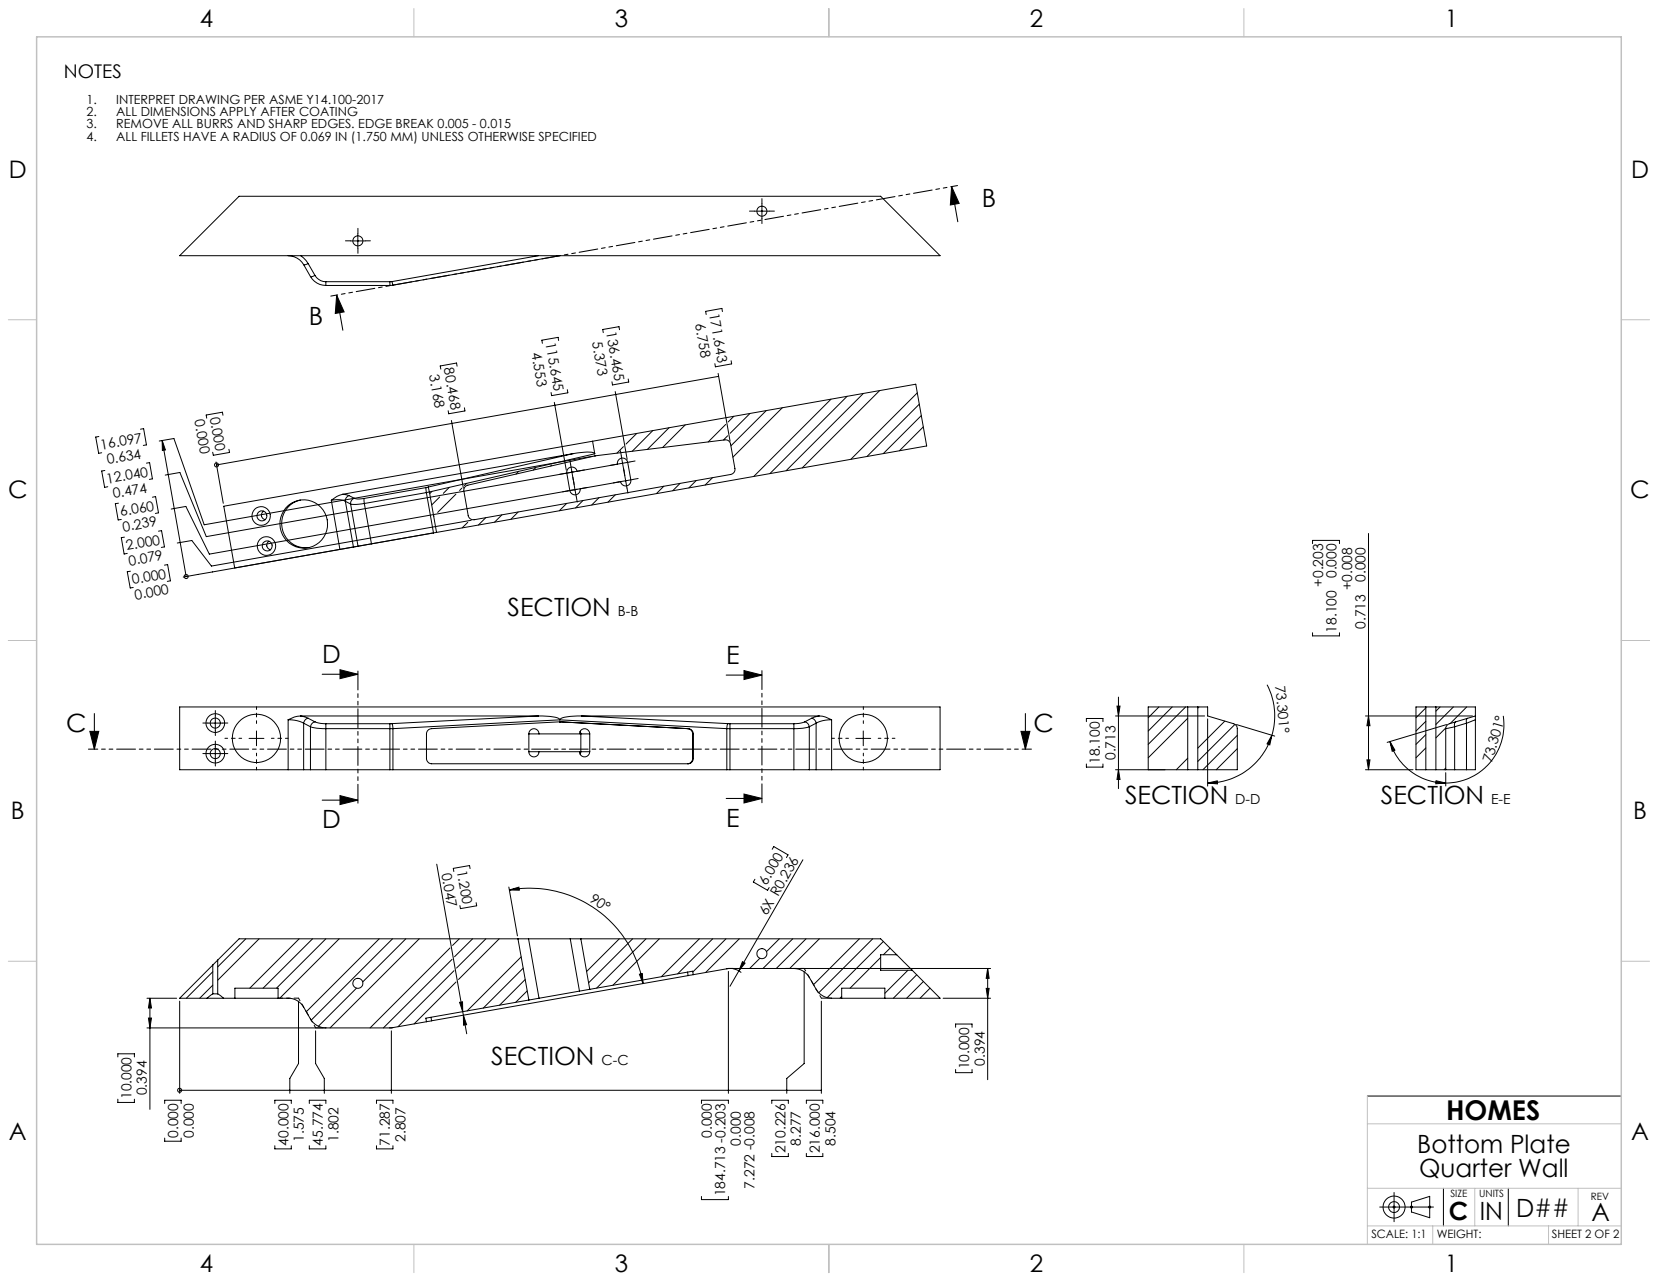
[picture p639: page 2]
SECTION B-B; SECTION C-C; SECTION D-D; SECTION E-E; Bottom Plate Quarter Wall

NOTES
1. INTERPRET DRAWING PER ASME Y14.100-2017
2. ALL DIMENSIONS APPLY AFTER COATING
3. REMOVE ALL BURRS AND SHARP EDGES. EDGE BREAK 0.005 - 0.015
4. ALL FILLETS HAVE A RADIUS OF 0.069 IN (1.750 MM) UNLESS OTHERWISE SPECIFIED

SIZE C | UNITS D## IN | REV A

SCALE: 1:1 | WEIGHT: | SHEET 2 OF 2
