caltechcaos/Lunar-Dust-Challenge/Current/Mechanical/v4_Eggdee/Drawings/FINALIZED DRAWINGS/bottom_plate_v4-4_drawing_vFINAL.pdf

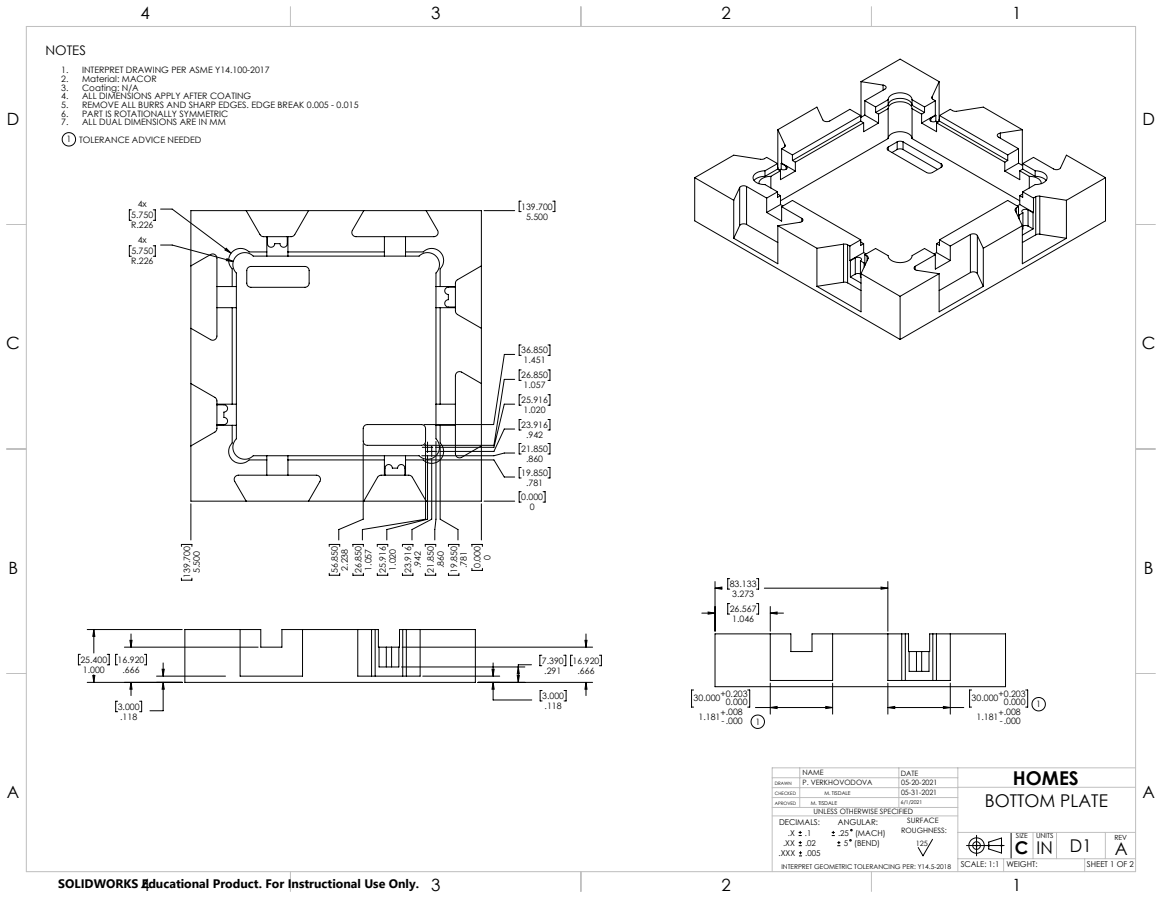
[picture p640: page 1]
.25 (MACH) 5 (BEND)

NOTES
1. INTERPRET DRAWING PER ASME Y14.100-2017
2. Material: MACOR
3. Coating: N/A
4. ALL DIMENSIONS APPLY AFTER COATING
5. REMOVE ALL BURRS AND SHARP EDGES. EDGE BREAK 0.005 - 0.015

6. PART IS ROTATIONALLY SYMMETRIC
7. ALL DUAL DIMENSIONS ARE IN MM
1 TOLERANCE ADVICE NEEDED

NAME | DATE | HOMES
CHECKED | M. TISDALE | 05-31-2021 | BOTTOM PLATE
APROVED | M. TISDALE | 6/1/2021
DECIMALS: ANGULAR: SURFACE ROUGHNESS:

DRAWN | P. VERKHOVODOVA | 05-20-2021

UNLESS OTHERWISE SPECIFIED

SIZE C | UNITS IN | D1 | REV A

INTERPRET GEOMETRIC TOLERANCING PER: Y14.5-2018 | SCALE: 1:1 | WEIGHT: | SHEET 1 OF 2

SOLIDWORKS Educational Product. For Instructional Use Only.

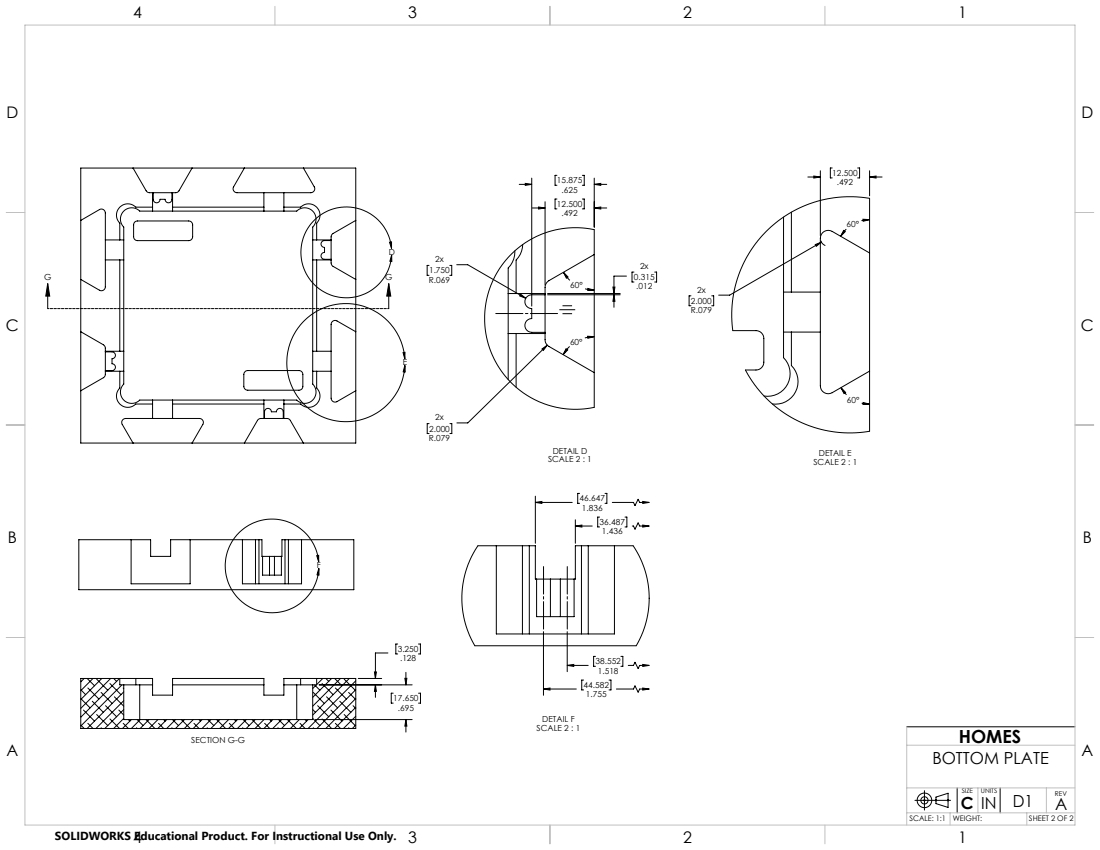
[picture p641: page 2]
DETAIL D SCALE 2 : 1; DETAIL E SCALE 2 : 1; DETAIL F SCALE 2 : 1; SECTION G-G; BOTTOM PLATE

SIZE C | UNITS D1 IN | REV A

SCALE: 1:1 | WEIGHT: | SHEET 2 OF 2

SOLIDWORKS Educational Product. For Instructional Use Only.
