caltechcaos/Lunar-Dust-Challenge/Current/Mechanical/v4_Eggdee/Drawings/FINALIZED DRAWINGS/finger_joint_cap_v4.1_drawing_vFINAL.pdf

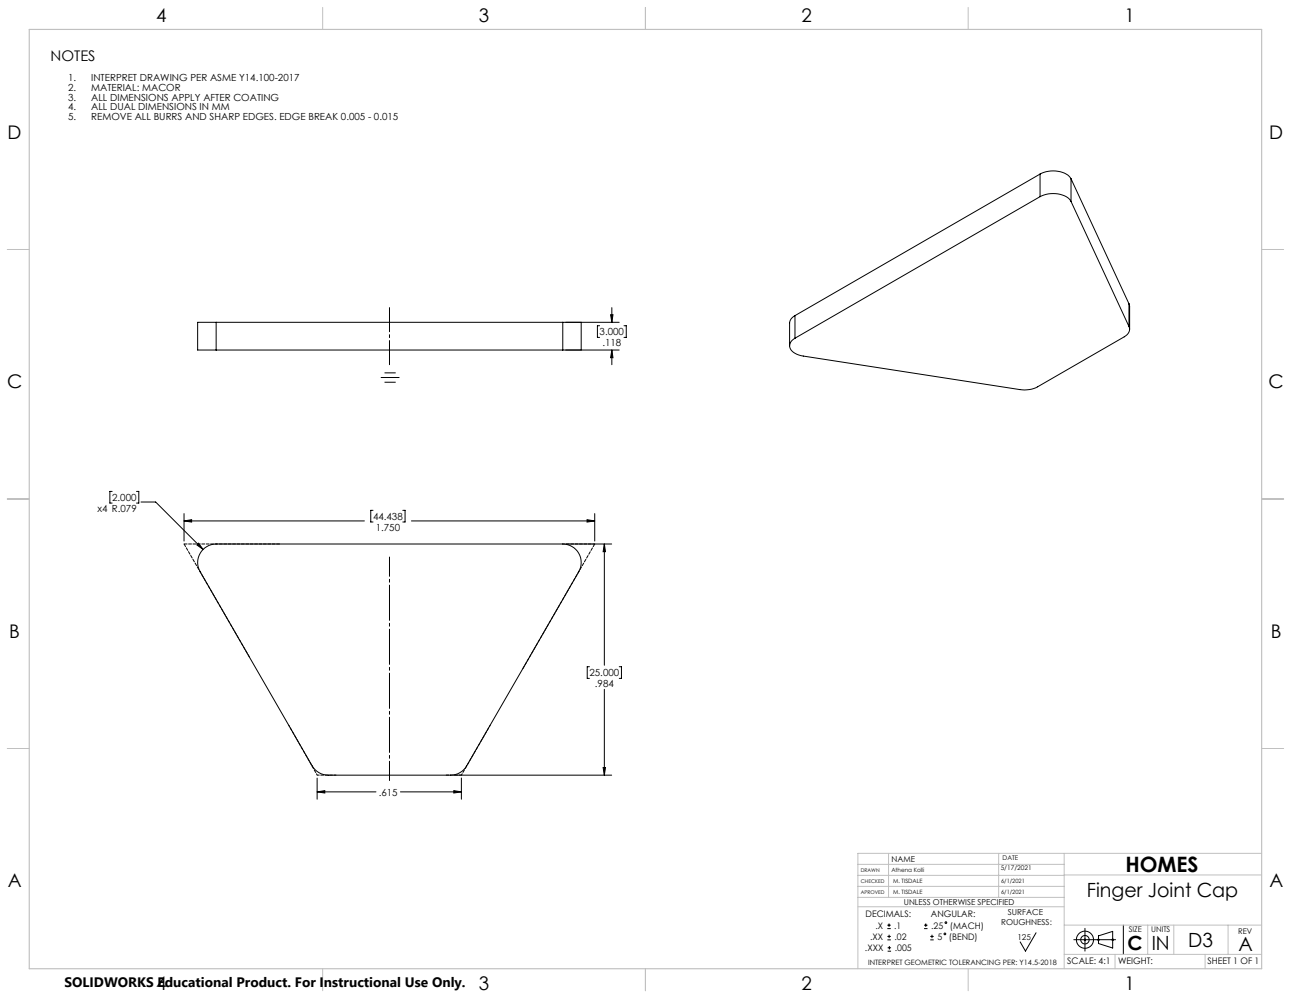
[picture p642: page 1]
.25 (MACH) 5 (BEND)

NOTES
1. INTERPRET DRAWING PER ASME Y14.100-2017
2. MATERIAL: MACOR
3. ALL DIMENSIONS APPLY AFTER COATING
4. ALL DUAL DIMENSIONS IN MM
5. REMOVE ALL BURRS AND SHARP EDGES. EDGE BREAK 0.005 - 0.015

NAME | DATE | HOMES
CHECKED | M. TISDALE | 6/1/2021 | Finger Joint Cap
APROVED | M. TISDALE | 6/1/2021
DECIMALS: ANGULAR: SURFACE ROUGHNESS:

DRAWN | Athena Kolli | 5/17/2021

UNLESS OTHERWISE SPECIFIED

SIZE C | UNITS IN | D3 | REV A

INTERPRET GEOMETRIC TOLERANCING PER: Y14.5-2018 | SCALE: 4:1 | WEIGHT: | SHEET 1 OF 1

SOLIDWORKS Educational Product. For Instructional Use Only.
