caltechcaos/Lunar-Dust-Challenge/Current/Mechanical/v4_Eggdee/Drawings/FINALIZED DRAWINGS/finger_joint_v4.2_drawing_vFINAL.pdf

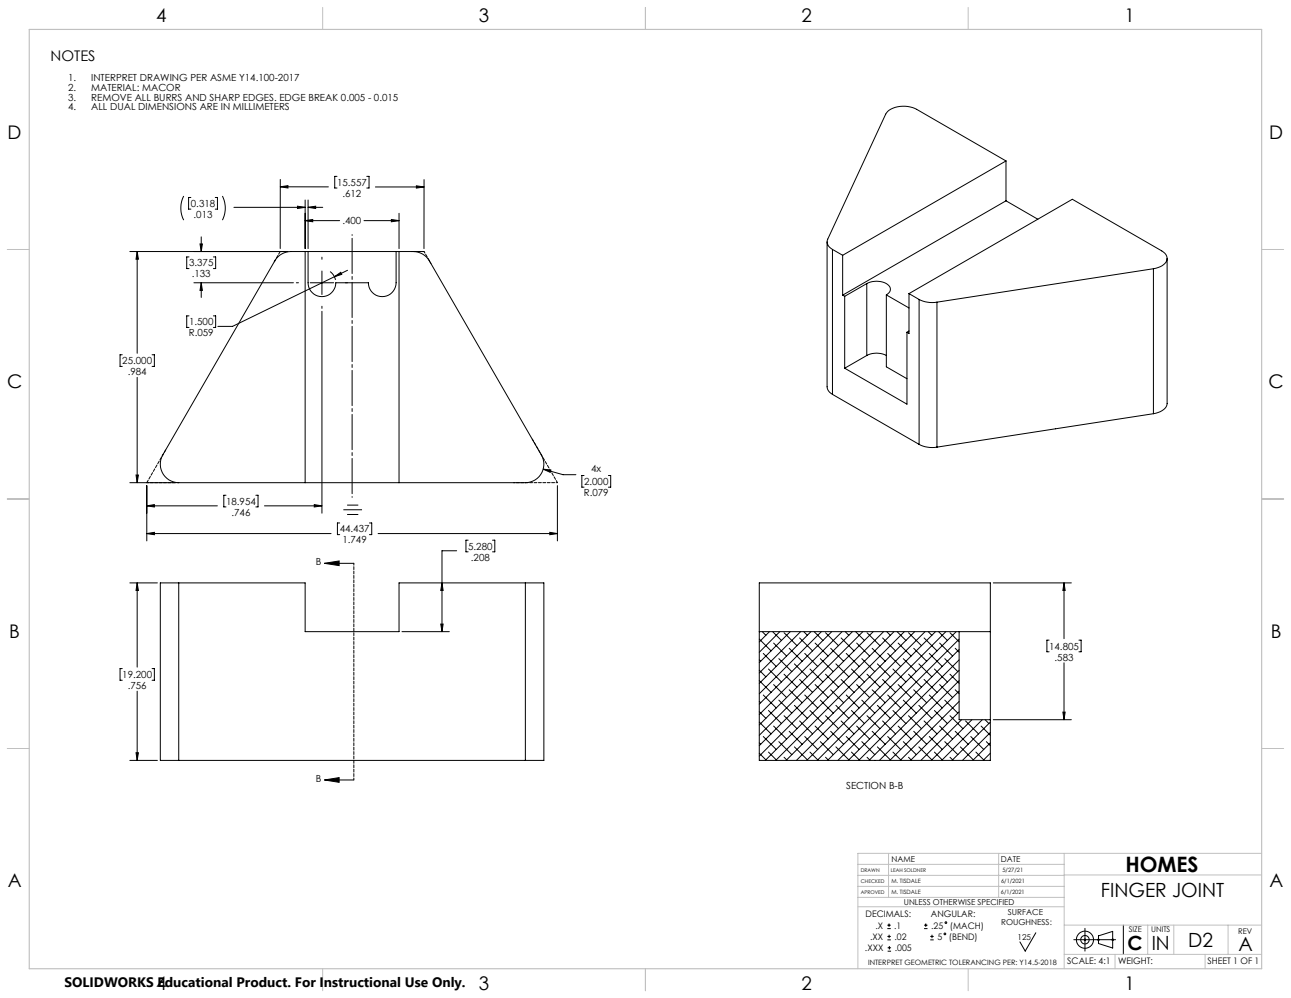
[picture p643: page 1]
SECTION B-B; .25 (MACH) 5 (BEND)

NOTES
1. INTERPRET DRAWING PER ASME Y14.100-2017
2. MATERIAL: MACOR
3. REMOVE ALL BURRS AND SHARP EDGES. EDGE BREAK 0.005 - 0.015
4. ALL DUAL DIMENSIONS ARE IN MILLIMETERS

NAME | DATE | HOMES
CHECKED | M. TISDALE | 6/1/2021 | FINGER JOINT
APROVED | M. TISDALE | 6/1/2021
DECIMALS: ANGULAR: SURFACE ROUGHNESS:

DRAWN | LEAH SOLDNER | 5/27/21

UNLESS OTHERWISE SPECIFIED

SIZE C | UNITS IN | D2 | REV A

INTERPRET GEOMETRIC TOLERANCING PER: Y14.5-2018 | SCALE: 4:1 | WEIGHT: | SHEET 1 OF 1

SOLIDWORKS Educational Product. For Instructional Use Only.
