caltechcaos/Lunar-Dust-Challenge/Current/Mechanical/v3_tiz/Drawings/HOMES_bplate_drawing_MT_MARKUP_V2.pdf

D D

4

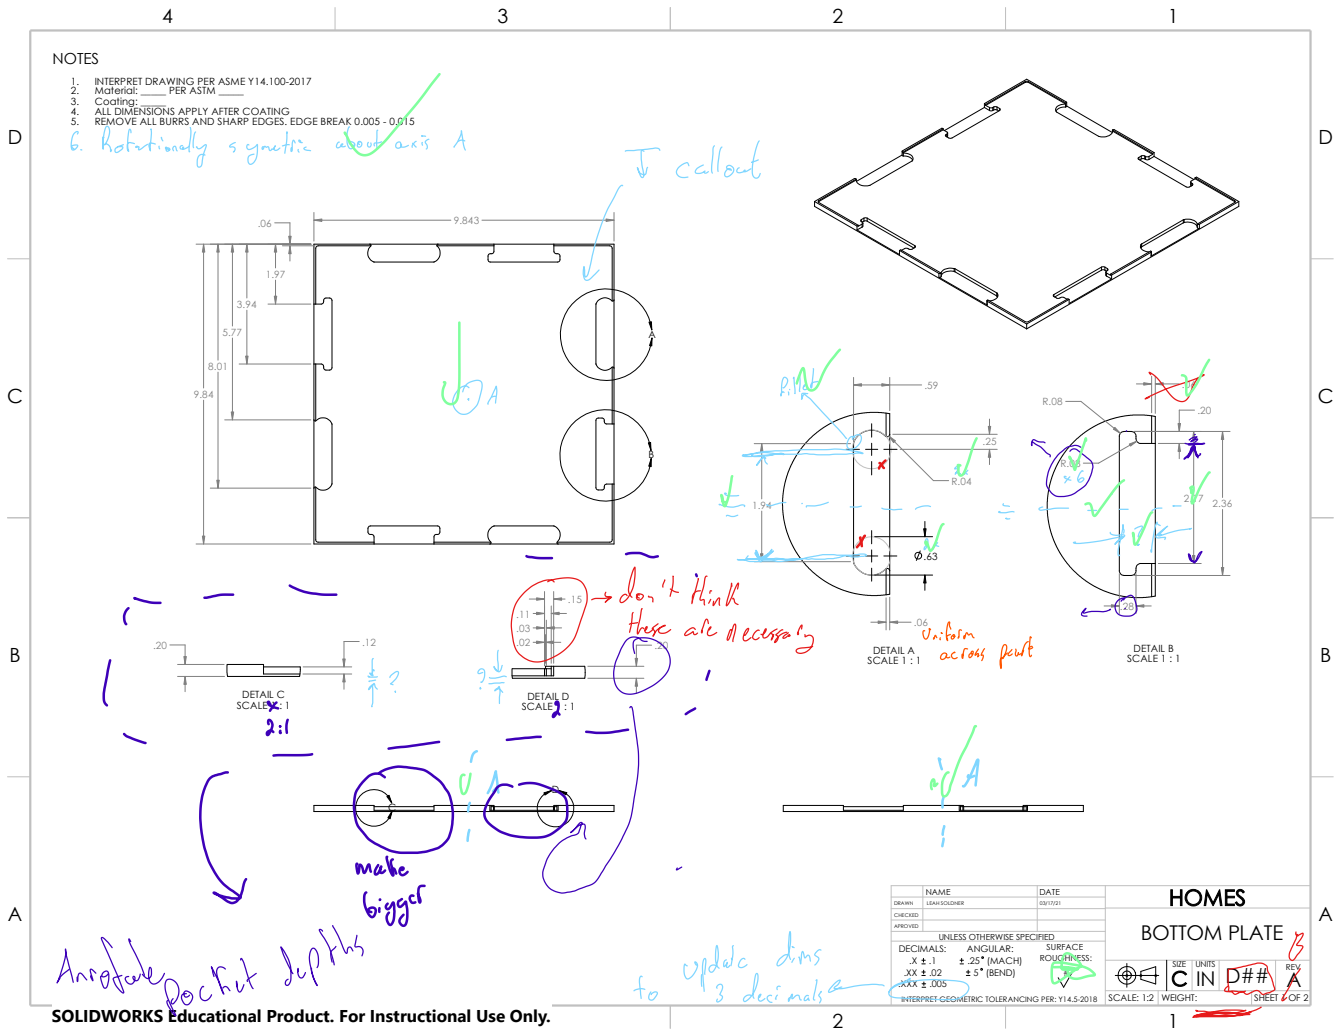
[picture p644: page 1]
UNITS IN; SHEET 1 OF 2; UNLESS OTHERWISE SPECIFIED; SCALE: 1:2; WEIGHT:; REV C; SIZE .1; ROUGHNESS:; .XXX; (BEND); SURFACE; INTERPRET GEOMETRIC TOLERANCING PER: Y14.5-2018; NOTES; DECIMALS:; ANGULAR: .25 (MACH); DETAIL A SCALE 1 : 1; DETAIL D SCALE 1 : 1; DETAIL B; SCALE 1 : 1; DETAIL C SCALE 1 : 1

ALL DIMENSIONS APPLY AFTER COATING
REMOVE ALL BURRS AND SHARP EDGES. EDGE BREAK 0.005 - 0.015

INTERPRET DRAWING PER ASME Y14.100-2017
Material: _____ PER ASTM _____
Coating: _____

NAME | DATE | HOMES
CHECKED | | | BOTTOM PLATE
APROVED

DRAWN | LEAH SOLDNER | 03/17/21

SOLIDWORKS Educational Product. For Instructional Use Only.

D D

4

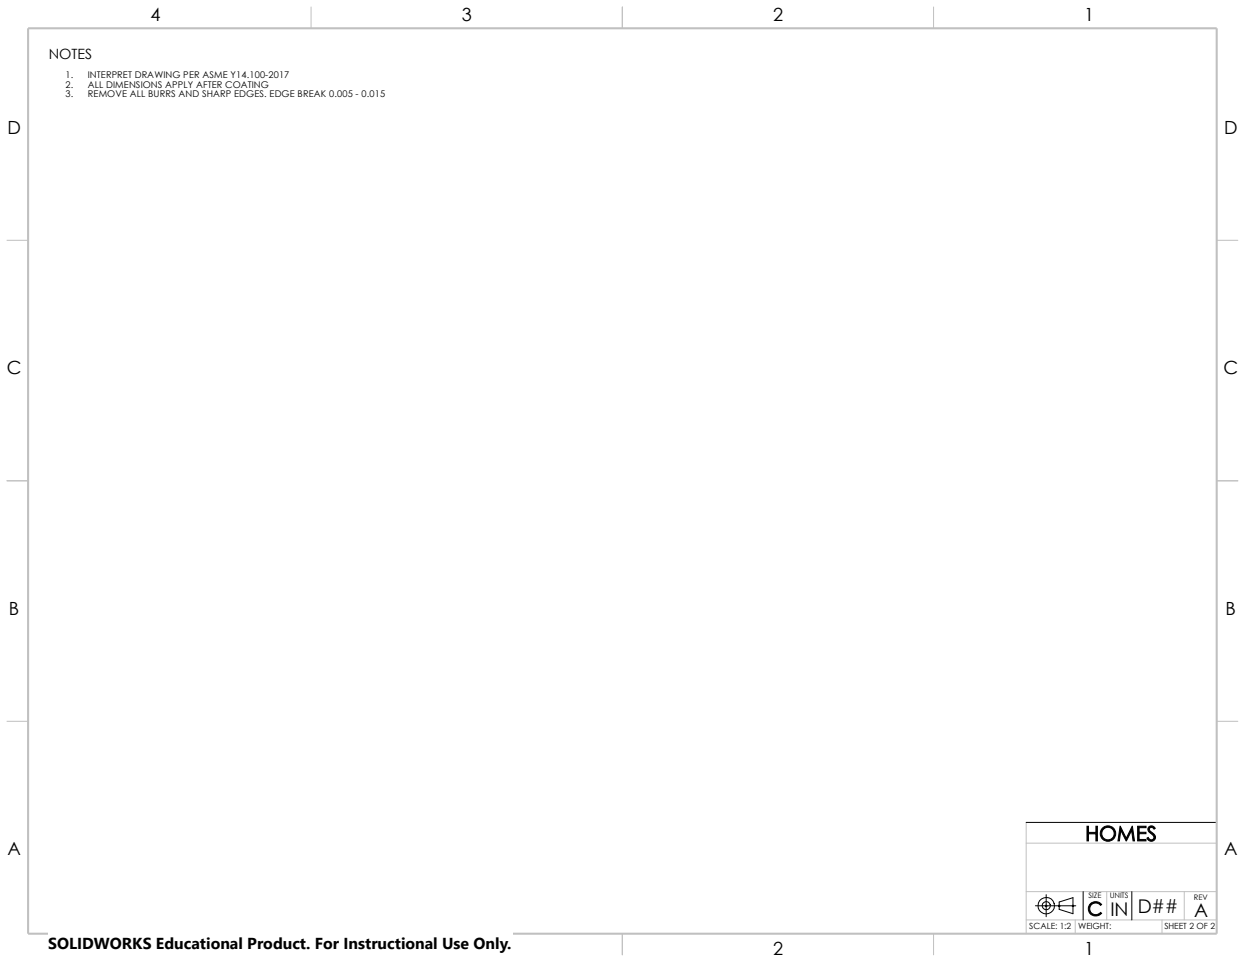
[picture p645: page 2]
HOMES; NOTES

1. INTERPRET DRAWING PER ASME Y14.100-2017
2. ALL DIMENSIONS APPLY AFTER COATING
3. REMOVE ALL BURRS AND SHARP EDGES. EDGE BREAK 0.005 - 0.015

SIZE | UNITS IN | D## | REV C A

SCALE: 1:2 | WEIGHT: | SHEET 2 OF 2

SOLIDWORKS Educational Product. For Instructional Use Only.
