caltechcaos/Lunar-Dust-Challenge/Current/Mechanical/v3_tiz/Drawings/HOMES_endcap_v3.3_drawing.pdf

D D

4 3

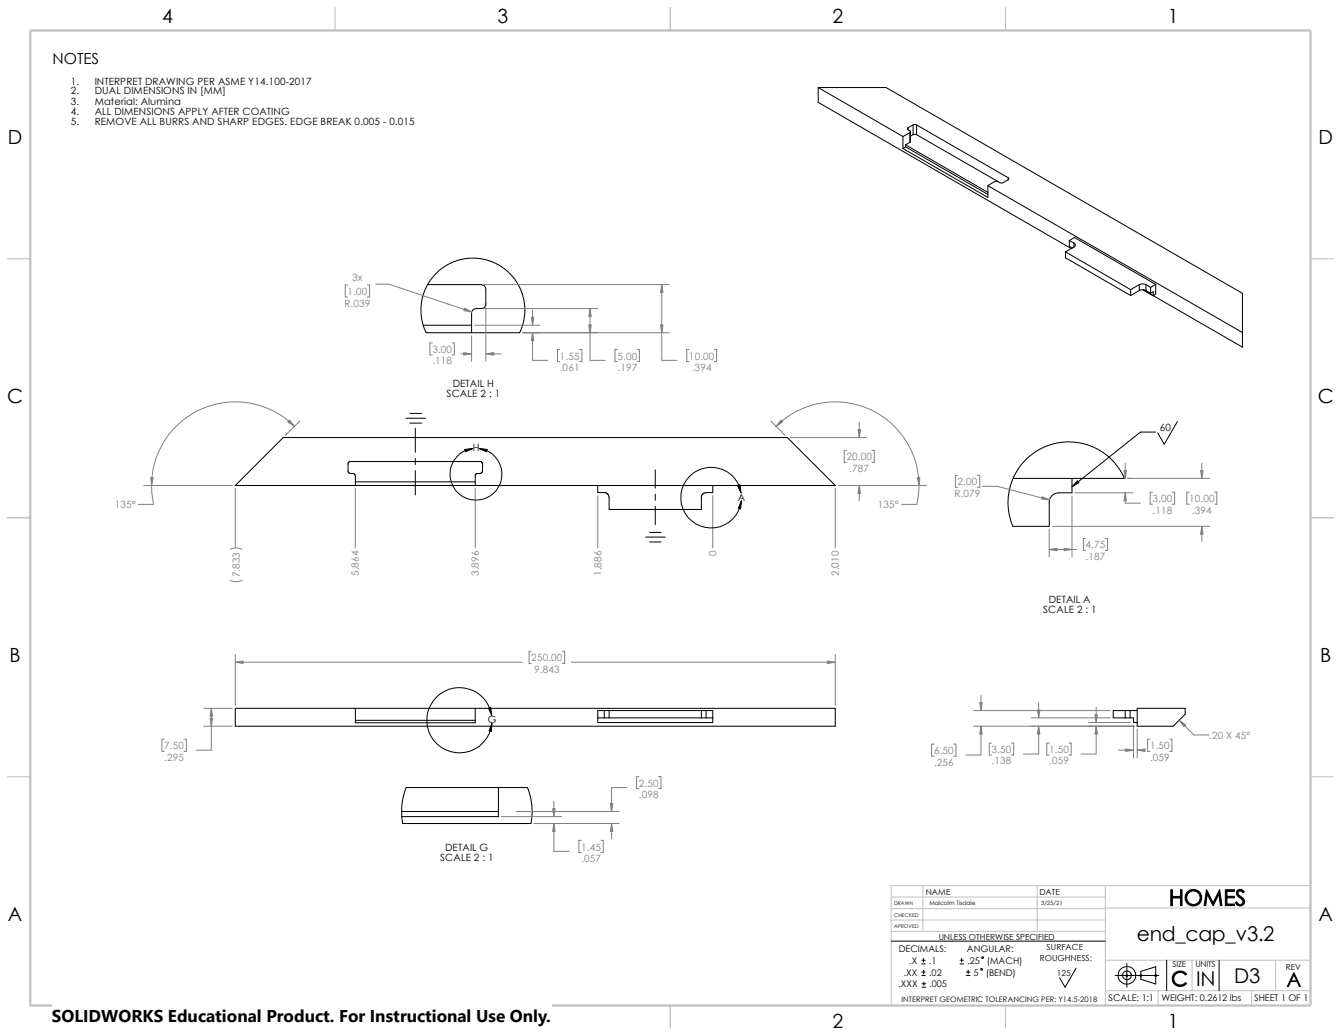
[picture p646: page 1]
ROUGHNESS: .1 5 125; UNLESS OTHERWISE SPECIFIED; NOTES; (BEND); SURFACE; .XXX; INTERPRET GEOMETRIC TOLERANCING PER: Y14.5-2018; DECIMALS:; ANGULAR: .25 (MACH); DETAIL A SCALE 2 : 1; DETAIL G SCALE 2 : 1; DETAIL H SCALE 2 : 1

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

INTERPRET DRAWING PER ASME Y14.100-2017
DUAL DIMENSIONS IN [MM]
Material: Alumina

NAME | DATE | HOMES
CHECKED | | | end_cap_v3.2
APROVED

DRAWN | Malcolm Tisdale | 3/25/21

SIZE | UNITS IN | D3 | REV C A

SCALE: 1:1 | WEIGHT: 0.2612 lbs | SHEET 1 OF 1

SOLIDWORKS Educational Product. For Instructional Use Only.
