caltechcaos/Lunar-Dust-Challenge/Current/Mechanical/v3_tiz/Drawings/HOMES_metal_detent_v3.4.pdf

D D

4

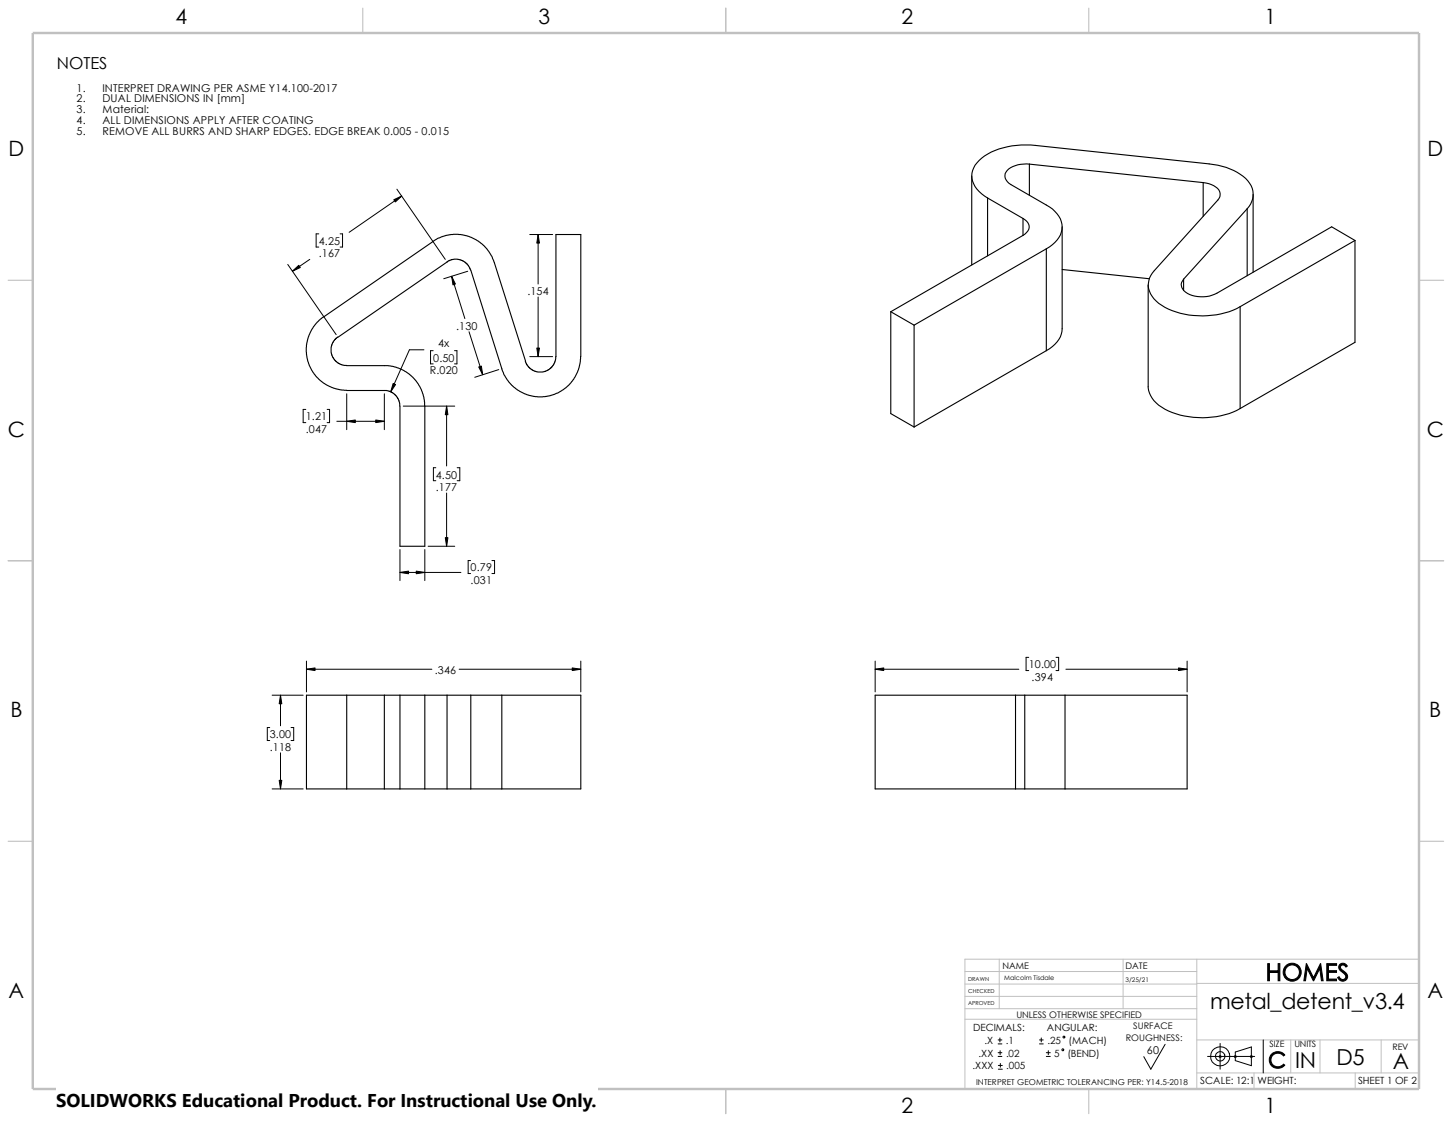
[picture p647: page 1]
UNLESS OTHERWISE SPECIFIED; SHEET 1 OF 2; SCALE: 12:1 WEIGHT:; REV C; SIZE; ROUGHNESS:; .XXX; NOTES; SURFACE; DECIMALS:; UNITS; INTERPRET GEOMETRIC TOLERANCING PER: Y14.5-2018; (BEND); INTERPRET DRAWING PER ASME Y14.100-2017; ANGULAR: .25 (MACH)

DUAL DIMENSIONS IN [mm]
Material:
ALL DIMENSIONS APPLY AFTER COATING
REMOVE ALL BURRS AND SHARP EDGES. EDGE BREAK 0.005 - 0.015

NAME | DATE | HOMES
CHECKED | | | metal_detent_v3.4
APROVED

DRAWN | Malcolm Tisdale | 3/25/21

SOLIDWORKS Educational Product. For Instructional Use Only.

D D

4

HOMES; NOTES

1. INTERPRET DRAWING PER ASME Y14.100-2017
2. ALL DIMENSIONS APPLY AFTER COATING
3. REMOVE ALL BURRS AND SHARP EDGES. EDGE BREAK 0.005 - 0.015

SIZE | UNITS IN | D## | REV C A

SCALE: 1:2 | WEIGHT: | SHEET 2 OF 2

SOLIDWORKS Educational Product. For Instructional Use Only.
