caltechcaos/Lunar-Dust-Challenge/Current/Mechanical/v3_tiz/Drawings/tplate_v3.3.PDF

D D

4 1 3

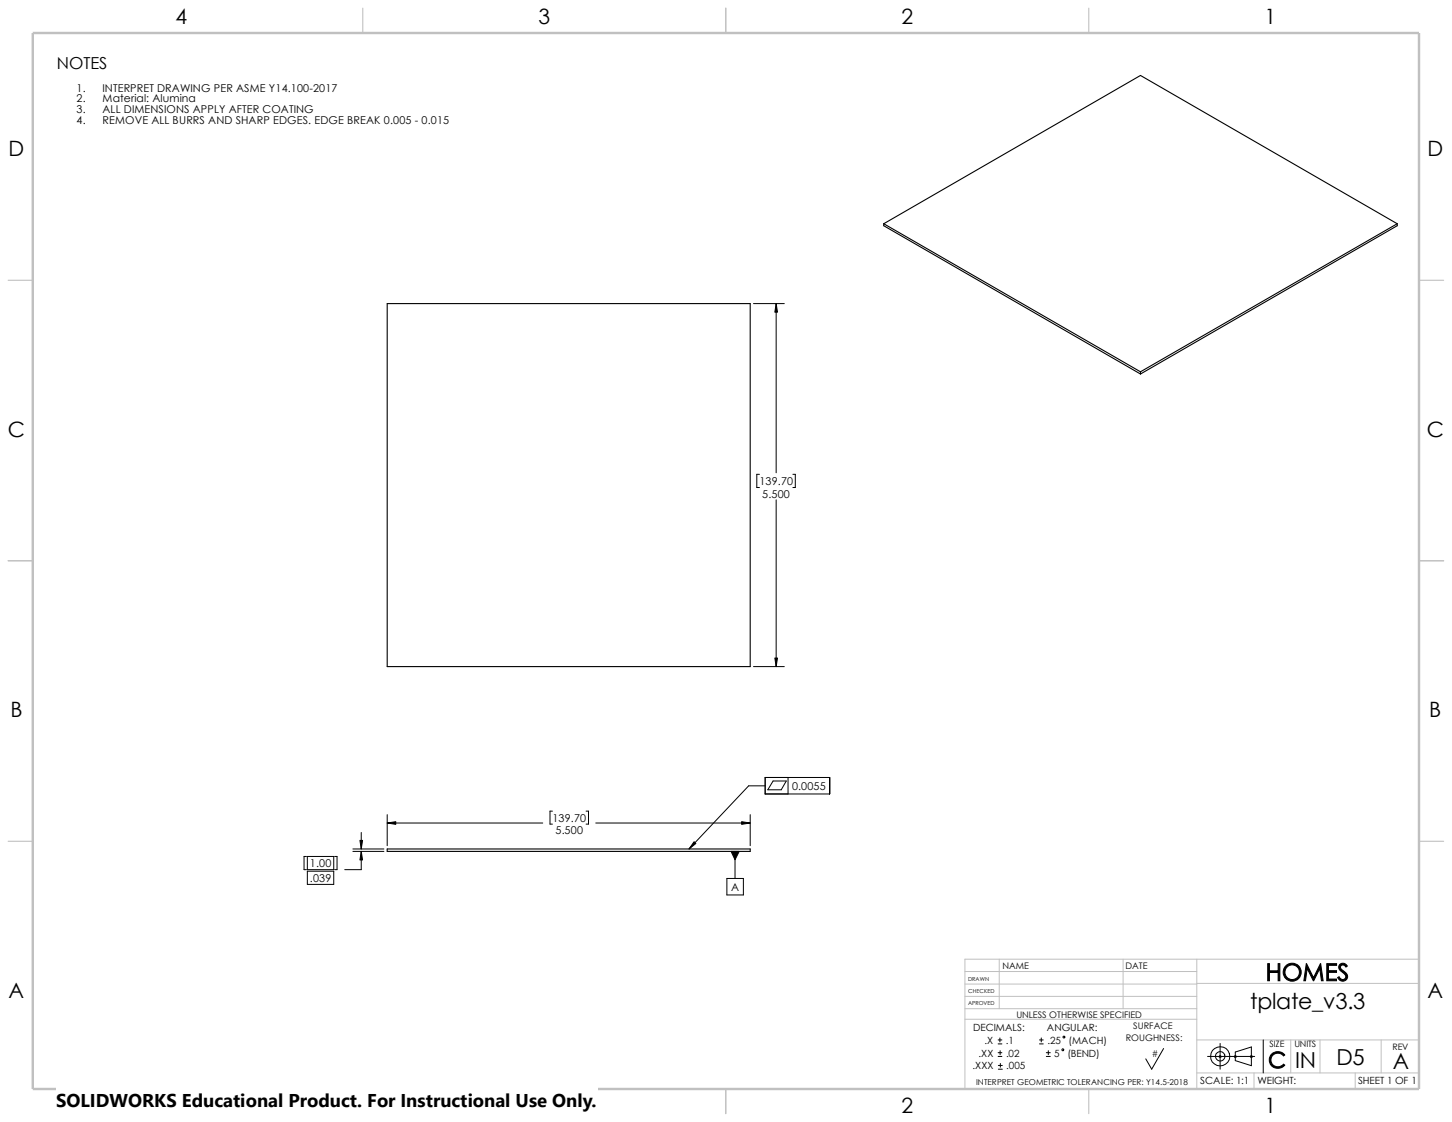
[picture p648: page 1]
NOTES; SURFACE; ROUGHNESS:; DECIMALS:; ANGULAR:; .25 (MACH)

REMOVE ALL BURRS AND SHARP EDGES. EDGE BREAK 0.005 - 0.015

INTERPRET DRAWING PER ASME Y14.100-2017
Material: Alumina
ALL DIMENSIONS APPLY AFTER COATING

NAME | DATE | HOMES
CHECKED | | | tplate_v3.3
APROVED

DRAWN

UNLESS OTHERWISE SPECIFIED

.XXX
INTERPRET GEOMETRIC TOLERANCING PER: Y14.5-2018

SIZE C | UNITS IN | D5 ⁽BEND) | REV A

SCALE: 1:1 | WEIGHT: | SHEET 1 OF 1

SOLIDWORKS Educational Product. For Instructional Use Only.
