caltechcaos/Lunar-Dust-Challenge/Current/Electrical (PCB)/RigidPCB_Electrodes/4LayerRigid_v6.pdf

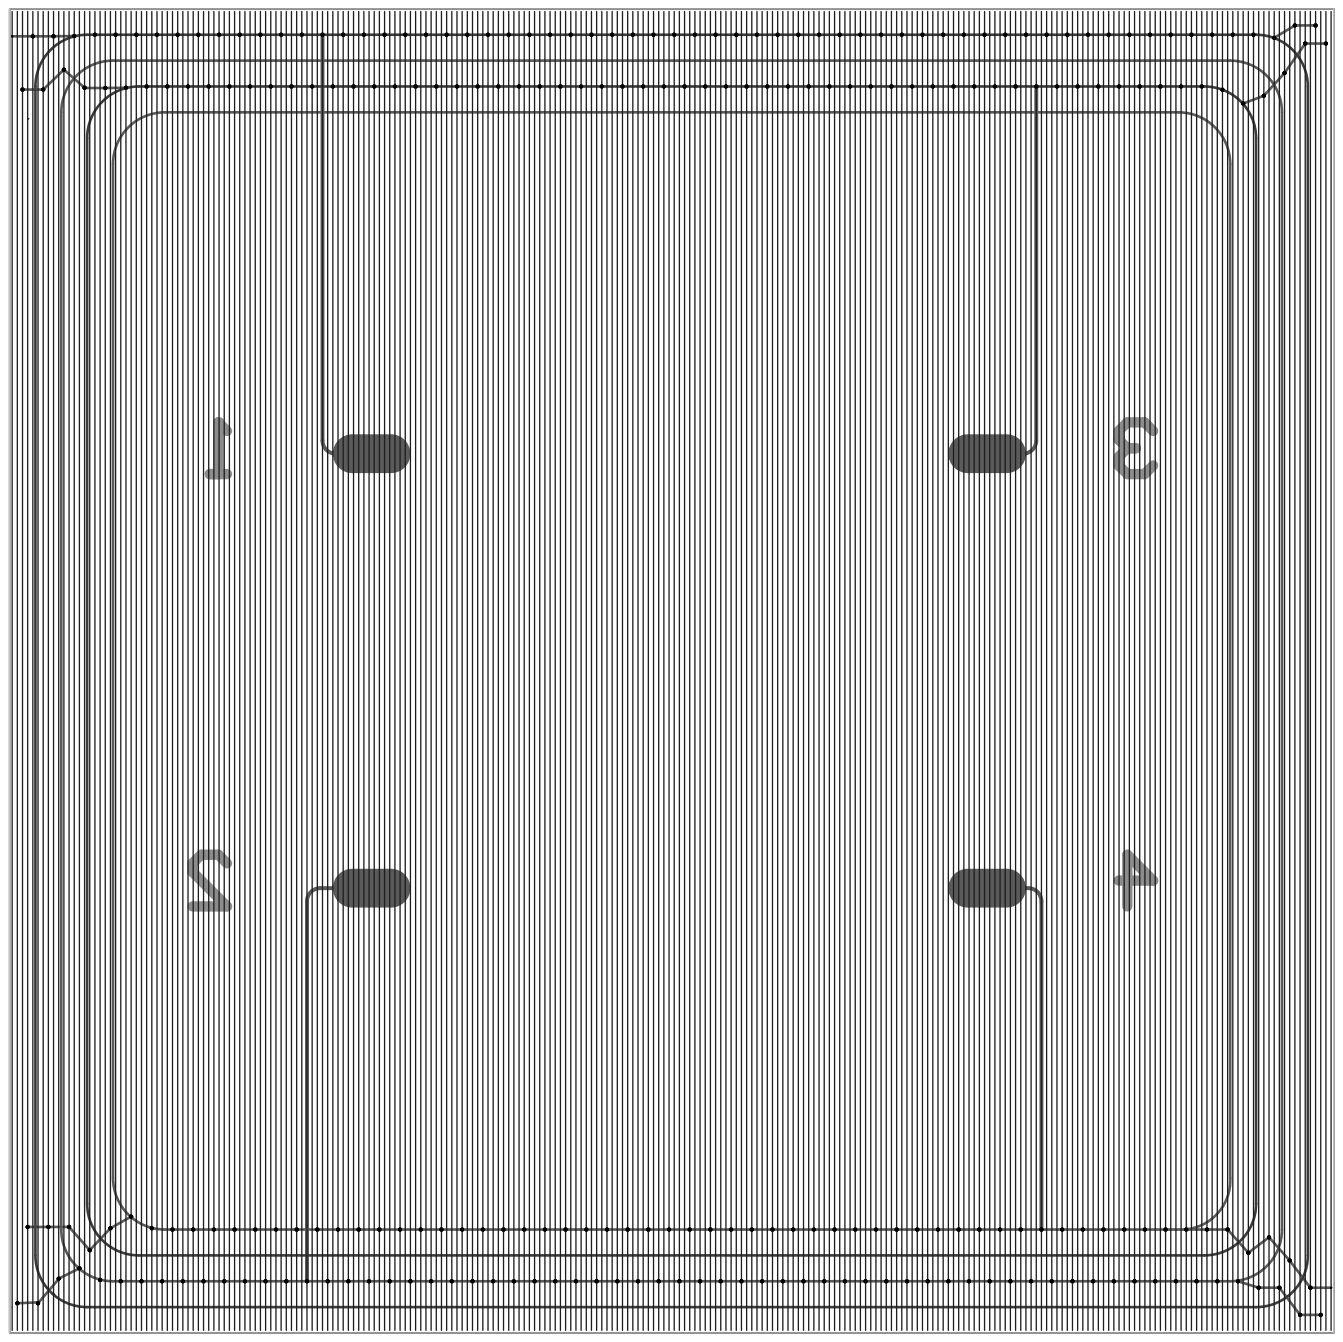
[picture p649: page 1]
