caltechcaos/Lunar-Dust-Challenge/Current/Mechanical/v3_tiz/Drawings/HOMES_endcap_v3.2_drawing.pdf

D D

4

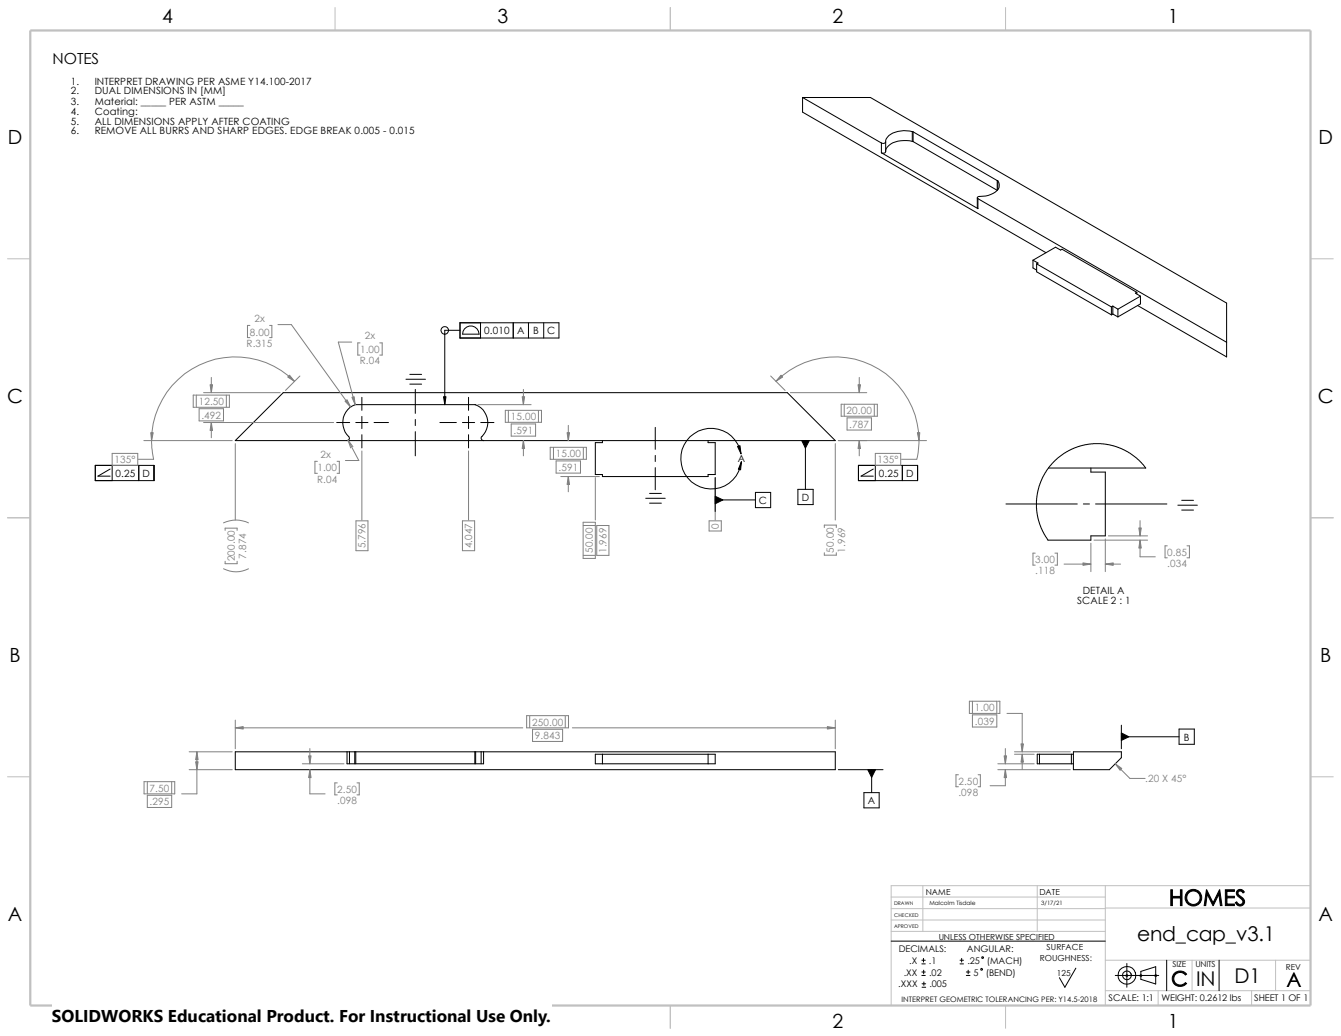
[picture p652: page 1]
SURFACE; DECIMALS:; (BEND); INTERPRET GEOMETRIC TOLERANCING PER: Y14.5-2018; NOTES; ROUGHNESS:; .XXX; Material: _____ PER ASTM _____; DUAL DIMENSIONS IN [MM]; ANGULAR: .25 (MACH); DETAIL A SCALE 2 : 1

1. INTERPRET DRAWING PER ASME Y14.100-2017
Coating:
ALL DIMENSIONS APPLY AFTER COATING
REMOVE ALL BURRS AND SHARP EDGES. EDGE BREAK 0.005 - 0.015

NAME | DATE | HOMES

DRAWN | Malcolm Tisdale | 3/17/21
CHECKED | | | end_cap_v3.1
APROVED | UNLESS OTHERWISE SPECIFIED

SIZE | UNITS IN | D1 | REV C A

SCALE: 1:1 | WEIGHT: 0.2612 lbs | SHEET 1 OF 1

SOLIDWORKS Educational Product. For Instructional Use Only.
