caltechcaos/Lunar-Dust-Challenge/(list of files, drawings)

Other design files:
Current/Electrical (PCB)/4LayerFlexPCB_Electrodes/4LayerRigidFlexWithConnectors.PcbDoc
Current/Electrical (PCB)/4LayerRigidPCB_Electrodes/2LayerRigid_v1.PcbDoc
Current/Electrical (PCB)/4LayerRigidPCB_Electrodes/4LayerRigidFlex_v3.PcbDoc
Current/Electrical (PCB)/4LayerRigidPCB_Electrodes/RigidPCB_Electrodes.PrjPcb
Current/Electrical (PCB)/ElectronicsBox_v2/benchtoppcblib.PcbLib
Current/Electrical (PCB)/ElectronicsBox_v2/benchtopschlib.SchLib
Current/Electrical (PCB)/ElectronicsBox_v2/ebox.PcbLib
Current/Electrical (PCB)/ElectronicsBox_v2/ebox.SchLib
Current/Electrical (PCB)/ElectronicsBox_v2/ebox_board.PcbDoc
Current/Electrical (PCB)/ElectronicsBox_v2/ElectronicsBox_v2.PrjPcb
Current/Electrical (PCB)/ElectronicsBox_v2/power_ebox.SchDoc
Current/Electrical (PCB)/ElectronicsBox_v2/top_ebox.SchDoc
Current/Electrical (PCB)/ElectronicsBox_v3/ebox_board_v3.PcbDoc
Current/Electrical (PCB)/ElectronicsBox_v3/ebox_v3.PcbLib
Current/Electrical (PCB)/ElectronicsBox_v3/ebox_v3.SchLib
Current/Electrical (PCB)/ElectronicsBox_v3/ElectronicsBox_v3.PrjPcb
Current/Electrical (PCB)/ElectronicsBox_v3/power_ebox_v3.SchDoc
Current/Electrical (PCB)/ElectronicsBox_v3/top_ebox_v3.SchDoc
Current/Electrical (PCB)/ElectronicsBoxPCB/components/1x10_header_pin/AltiumDesigner/2021-07-06_21-38-52/2021-07-06_21-38-52.PcbLib
Current/Electrical (PCB)/ElectronicsBoxPCB/components/1x10_header_pin/AltiumDesigner/2021-07-06_21-38-52/2021-07-06_21-38-52.SchLib
Current/Electrical (PCB)/ElectronicsBoxPCB/components/180_ohm/AltiumDesigner/2021-07-08_03-00-06/2021-07-08_03-00-06.PcbLib
Current/Electrical (PCB)/ElectronicsBoxPCB/components/180_ohm/AltiumDesigner/2021-07-08_03-00-06/2021-07-08_03-00-06.SchLib
Current/Electrical (PCB)/ElectronicsBoxPCB/components/linear_regulator/AltiumDesigner/2021-07-07_21-31-43/2021-07-07_21-31-43.PcbLib
Current/Electrical (PCB)/ElectronicsBoxPCB/components/linear_regulator/AltiumDesigner/2021-07-07_21-31-43/2021-07-07_21-31-43.SchLib
Current/Electrical (PCB)/ElectronicsBoxPCB/EboxPCB.PcbDoc
Current/Electrical (PCB)/ElectronicsBoxPCB/EBoxpcblib.PcbLib
Current/Electrical (PCB)/ElectronicsBoxPCB/EboxPCBv2.PcbDoc
Current/Electrical (PCB)/ElectronicsBoxPCB/EBoxschematic.SchDoc
Current/Electrical (PCB)/ElectronicsBoxPCB/EBoxschematiclib.SchLib
Current/Electrical (PCB)/ElectronicsBoxPCB/eboxv1.PcbDoc
Current/Electrical (PCB)/ElectronicsBoxPCB/eboxv1.SchDoc
Current/Electrical (PCB)/ElectronicsBoxPCB/ElectronicsBoxPCB.PrjPcb
Current/Electrical (PCB)/ElectronicsBoxPCB/schematic.SchDoc
Current/Electrical (PCB)/ElectronicsBoxPCB/schottky_diode/AltiumDesigner/AltiumDesigner/2021-07-08_17-12-07/2021-07-08_17-12-07.PcbLib
Current/Electrical (PCB)/ElectronicsBoxPCB/schottky_diode/AltiumDesigner/AltiumDesigner/2021-07-08_17-12-07/2021-07-08_17-12-07.SchLib
Current/Electrical (PCB)/FlexPCB_Electrodes/2LayerFlex_v1.PcbDoc
Current/Electrical (PCB)/FlexPCB_Electrodes/4LayerFlex_v1.PcbDoc
Current/Electrical (PCB)/FlexPCB_Electrodes/4LayerFlex_v2.PcbDoc
Current/Electrical (PCB)/FlexPCB_Electrodes/4LayerFlex_v3.PcbDoc
Current/Electrical (PCB)/FlexPCB_Electrodes/4LayerFlex_v4.PcbDoc
Current/Electrical (PCB)/FlexPCB_Electrodes/4LayerFlex_v5.PcbDoc
Current/Electrical (PCB)/FlexPCB_Electrodes/4LayerFlex_v6.PcbDoc
Current/Electrical (PCB)/FlexPCB_Electrodes/FlexPCB_Electrodes.PrjPcb
Current/Electrical (PCB)/PowerSupply_v2-5/benchtoppcblib.PcbLib
Current/Electrical (PCB)/PowerSupply_v2-5/benchtopschlib.SchLib
Current/Electrical (PCB)/PowerSupply_v2-5/board.PcbDoc
Current/Electrical (PCB)/PowerSupply_v2-5/compact_v2-5.PcbLib
Current/Electrical (PCB)/PowerSupply_v2-5/compact_v2-5.SchLib
Current/Electrical (PCB)/PowerSupply_v2-5/connector.SchDoc
Current/Electrical (PCB)/PowerSupply_v2-5/power.SchDoc
Current/Electrical (PCB)/PowerSupply_v2-5/PowerSupply_v2-5.PrjPcb
Current/Electrical (PCB)/PowerSupply_v2-5/SnapDocs/RCS12064R99FKEA.PcbLib
Current/Electrical (PCB)/PowerSupply_v2-5/SnapDocs/RCS12064R99FKEA.SchLib
Current/Electrical (PCB)/PowerSupply_v2-5/top.SchDoc
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
