caltechcaos/Lunar-Dust-Challenge/Current/Electrical/4LayerTestPCB/4LayerTestPCB.sch

## KiCad design Current/Electrical/4LayerTestPCB/4LayerTestPCB.sch (2023-12-22)

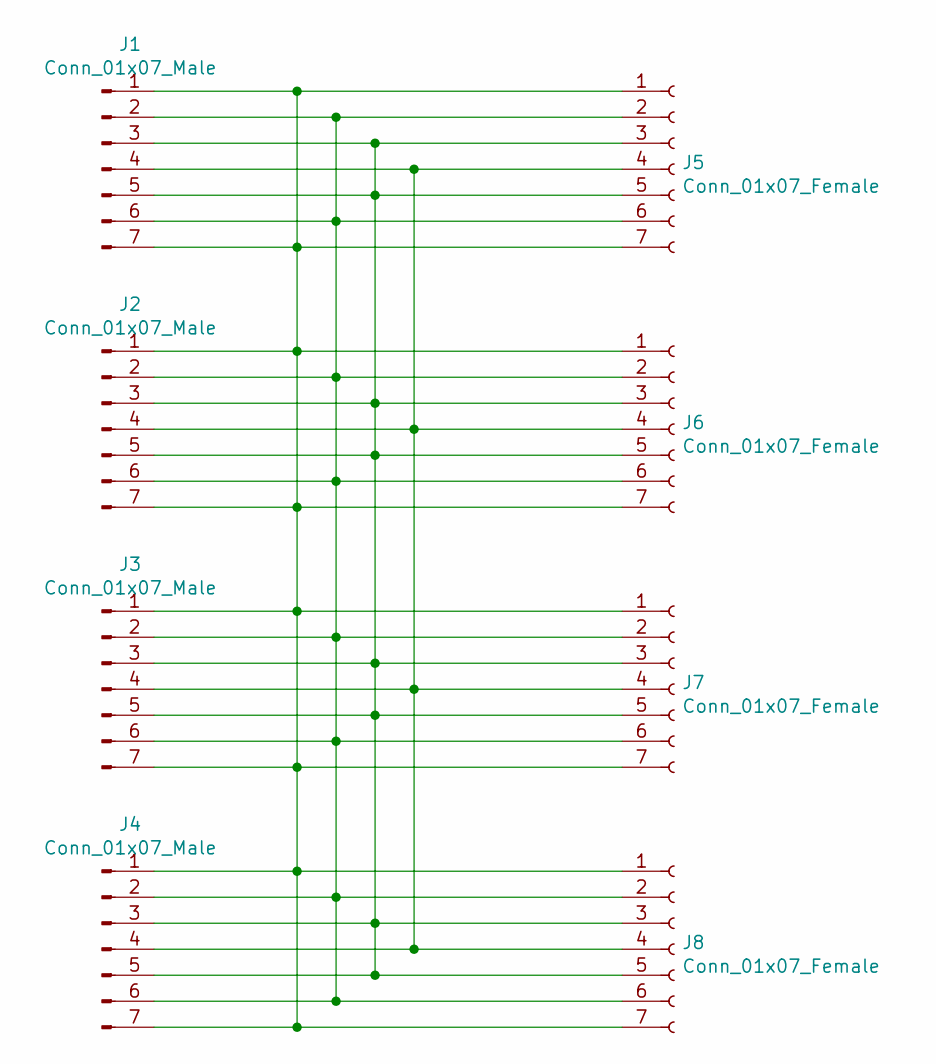
[picture p653: schematic 4LayerTestPCB.sch]

Parts:
J1, J2, J3, J4: Conn_01x07_Male
J5, J6, J7, J8: Conn_01x07_Female

Connections:
unnamed: J1.1, J1.7, J2.1, J2.7, J3.1, J3.7, J4.1, J4.7, J5.1, J5.7, J6.1, J6.7, J7.1, J7.7, J8.1, J8.7
unnamed: J1.2, J1.6, J2.2, J2.6, J3.2, J3.6, J4.2, J4.6, J5.2, J5.6, J6.2, J6.6, J7.2, J7.6, J8.2, J8.6
unnamed: J1.3, J1.5, J2.3, J2.5, J3.3, J3.5, J4.3, J4.5, J5.3, J5.5, J6.3, J6.5, J7.3, J7.5, J8.3, J8.5
unnamed: J1.4, J2.4, J3.4, J4.4, J5.4, J6.4, J7.4, J8.4
